cultibox/cultibox/README.md

**Cultibox**
============

La Cultibox est un boitier de contrôle du climat permettant de piloter des prises 
avec des programmes définits ou de réagir en fonction des informations remontées
par les capteurs connectés.
Toutes les informations nécéssaires disponibles sur le site officiel:

 [http://www.cultibox.fr](http://www.cultibox.fr)

Pour plus d'informations sur le logiciel open source permettant de piloter le boitier, 
rendez-vous:

 * sur la [documentation utilisateur](https://github.com/cultibox/cultibox/wiki) 
 * sur la [liste des tickets (Amélioration, bug ...)](https://github.com/cultibox/cultibox/issues)
 * sur le [dépôt du code source](https://github.com/cultibox/cultibox/)

Quoi de neuf?
 * Liste des [évolutions pour le logiciel](https://github.com/cultibox/cultibox/blob/master/01_software/CHANGELOG)
 * Lise des [évolutions pour le firmware](https://github.com/cultibox/cultibox/blob/master/01_software/01_install/01_src/03_sd/version.txt)

Et concrètement?
 * Pour récupérer le dépôt principal avec git:

`git clone --recursive https://github.com/cultibox/cultibox.git`
 * Pour récupérer le wiki avec git: 

`git clone --recursive https://github.com/cultibox/cultibox.wiki.git`
