cultibox/cultibox/02_documentation/05_verif/CBX_1_13_0012_PTS_electronic_regulation_temperature_humidity_A.pdf

Cultibox | CRE | CBX 1_13_0012 | A | 1 / 19
Type | Réf. document | Indice | Page

DOCUMENT GREEN BOX : Copyright © 20012-2013 GREEN BOX. Tous droits réservés. Ce document et l’information qu’il contient sont la propriété exclusive de GREEN BOX. Ils ne peuvent être reproduits ou divulgués sous quelque forme que ce soit sans l’accord préalable écrit de GREEN BOX.
GREEN BOX PROPRIETARY INFORMATION: Copyright © 2012-2013 by GREEN BOX. All rights reserved. This document and the information contained therein are GREEN BOX’s exclusive property. Any copy and/or disclosure thereof in any form whatsoever are subject to GREEN BOX’s prior written consent.

# PTS_ELECTRONIC_REGULATION_TEMPERATURE PTS_ELECTRONIC_REGULATION_HUMIDITY

### Conclusion:

### Cliquer ici

Mot clé | Conclusion | Remarques
PTS_electronic_regulation_temperature | PASS | NA
PTS_electronic_regulation_humidity | PASS | NA
VERSION | DATE | AUTEUR | DESCRIPTION DES MODIFICATIONS
- | 18/04/13 | P Puvilland | Création
A | 02/09/13 | P Puvilland | Ajout essai complémentaire: Fonction moyenne/min/max sur plusieurs capteurs

Cultibox | CRE | CBX 1_13_0012 | A | 2 / 19
Type | Réf. document | Indice | Page

DOCUMENT GREEN BOX : Copyright © 20012-2013 GREEN BOX. Tous droits réservés. Ce document et l’information qu’il contient sont la propriété exclusive de GREEN BOX. Ils ne peuvent être reproduits ou divulgués sous quelque forme que ce

# 1 SOMMAIRE

1 | SOMMAIRE | 2
2 | INTRODUCTION | 3
2.1 | OBJECTIF | 3
2.2 | SPECIFICATION DU MOT CLE | 3
2.3 | ISSUES ASSOCIEES | 3
2.4 | VERSION DE LA PTS | 4
2.5 | CULTIBOX | 4
2.6 | VERSION DES LOGICIELS | 5
2.7 | INFORMATION CONCERNANT L’ESSAI | 6
3 | DESCRIPTION DE L’ESSAI | 7
3.1 | INTRODUCTION | 7
3.2 | DESCRIPTION GENERALE DE L’ESSAI | 7
4 | ESSAI | 8
4.1 | MESURE INITIALE | 8
4.2 | MISE EN PLACE | 8
4.3 | MECANISMES DE REGULATION TESTES | 9
5 | ESSAIS COMPLÉMENTAIRES | 16
5.1 | MECANISMES DE REGULATION TESTES | 16
5.2 | RÉSULTATS DES ESSAIS COMPLÉMENTAIRES: | 16
6 | CONCLUSION | 17
7 | ANNEXES | 19

Cultibox | CRE | CBX 1_13_0012 | A | 3 / 19
Type | Réf. document | Indice | Page

DOCUMENT GREEN BOX : Copyright © 20012-2013 GREEN BOX. Tous droits réservés. Ce document et l’information qu’il contient sont la propriété exclusive de GREEN BOX. Ils ne peuvent être reproduits ou divulgués sous quelque forme que ce

# 2 INTRODUCTION

# 2.1 Objectif

## L’objectif de ce rapport est de statuer sur les mots clés :

## - PTS_electronic_regulation_temperature Ce mot clé indique la capacité de régulation de la Cultibox, en fonction des relevés

d'un capteur de température.

## - PTS_electronic_regulation_humidity Ce mot clé indique la capacité de régulation de la Cultibox, en fonction des relevés

d'un capteur d'humidité.

# 2.2 Spécification du mot clé

La spécification de la fonction de régulation est plutôt qualitative que quantitative.

## Pour s'assurer que ces deux mots clés sont conformes, nous vérifierons qu'ils respectent le fonctionnement décrit dans le document suivant: http://code.google.com/p/cultibox/wiki/gui_soft_prog_regul

# 2.3 Issues associées

## L’issue associée à ces mots clés sont :

Nom de l’issue | numéro | Type
PTS_electronic_regulation_temperature | 380 | PTS
PTS_electronic_regulation_humidity | 381 | PTS
[CULTI] [PROGRAMME] Bug régulation | 392 | Bug
[REGUL] Regul secondaire --> Impact sur la régul primaire | 479 (https://code.google.com/p/cultibox/issues/detail?id=479) | Bug

Cultibox | CRE | CBX 1_13_0012 | A | 4 / 19
Type | Réf. document | Indice | Page

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

[regulation] regulation moyenne/max/min: capteur non branché | 677 (https://code.google.com/p/cultibox/issues/detail?id=479) | Bug
[REGULATON] vérif fonctionnement: régulation secondaire et la moyenne/min/max | 683 (https://code.google.com/p/cultibox/issues/detail?id=479) | amélio

## L’ensemble des issues peut être lu à l’adresse suivante : http://code.google.com/p/cultibox/issues

# 2.4 Version de la PTS

Pour la validation des mots clés PTS_electronic_regulation_temperature,

## PTS_electronic_regulation_humidity

PTS Révision | Date | Version document
Révision 809 | 18/04/2013 | -
Révision 1419 | 03/09/2013 | A

# 2.5 Cultibox

Le tableau ci-dessous donne le numéro de la Cultibox utilisé pour ce test.

Matériel | Numéro d’identification | Version document
Cultibox | ID : 00001 | -
Cultibox | ID : Beta00000 | A

Cultibox | CRE | CBX 1_13_0012 | A | 5 / 19
Type | Réf. document | Indice | Page

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

# 2.6 Version des logiciels

### Version -

Type | Version logiciel | Version document
firmware | 1.25 | -
Logiciel | 1.1.10 | -
firmware | 1.31 et 2.0 | A
Logiciel | 1.1.30 | A

Cultibox | CRE | CBX 1_13_0012 | A | 6 / 19
Type | Réf. document | Indice | Page

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

# 2.7 Information concernant l’essai

Le tableau ci-dessous récapitule différentes informations concernant l’essai.

Information | Valeur
Client | Société Green Box SAS 8 Rue Thiers 38000 GRENOBLE
Laboratoire d’essai | Société Green Box SAS 8 Rue Thiers 38000 GRENOBLE
Identification du rapport d’essai | CBX 1_13_0012
Dates des essais | 07/04/2013(version -) 01/09/2013(version A)
Type d’essai | Vérification de la capacité de pilotage par régulation des prises par la Cultibox
Objet de l’essai | Essai de validation de spécification
Norme d’essai, édition | N.A
Description du spécimen d’essai | Cultibox ID : 00001 (version -) Cultibox ID : Beta00000 (version A)
Gestionnaire de l’essai | Philippe Puvilland

Cultibox | CRE | CBX 1_13_0012 | A | 7 / 19
Type | Réf. document | Indice | Page

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

# 3 DESCRIPTION DE L’ESSAI

# 3.1 Introduction

## Ce test consiste à vérifier que le fonctionnement est conforme a celui décrit

dans la documentation de la cultibox.

# 3.2 Description générale de l’essai

## Nous allons programmer sur 7 prises différents type de régulation primaire et secondaire. Puis nous allons réaliser des modifications d'environnements du capteur

de la Cultibox afin de constater que la fonction de régulation est totalement effective.

## Ces essais vont donc couvrir un maximum de situation possible, afin de tester la conformité des mécanismes décrit dans la documentation. Nous vérifierons donc:

## - le fonctionnement de la régulation primaire - le fonctionnement de la régulation secondaire - le fonctionnement de la régulation en fonction des informations d'un capteur d'humidité - le fonctionnement de la régulation en fonction des informations d'un capteur de température

Cultibox | CRE | CBX 1_13_0012 | A | 8 / 19
Type | Réf. document | Indice | Page

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

# 4 ESSAI

# 4.1 Mesure initiale

## La Cultibox est totalement fonctionnelle. Le pilotage des 7 prises et la sonde

de température et d'humidité fonctionnent correctement.

# 4.2 Mise en place

## La Cultibox est branchée, les 7 prises a piloter sont branchées et paramétrés comme l'indique le tableau si dessous:

Prise n° | type | status | Primaire | Tolérance | secondaire
4 | ventilateur | Activé | sup 30°C | 1 | sup 50%
5 | ventilateur | Activé | Marche | 0 | inf 50%
6 | chauffage | Activé | inf 28°C | 5 | sup 60%
7 | humidificateur | Désactivé | inf 23°C | 0 | sup 35%
8 | humidificateur | Activé | inf 60% | 2 | sup 26°C
9 | humidificateur | Activé | Marche | 1 | inf 26°C
10 | dés- humidificateur | Activé | sup 40% | 0 | sup 35°C

Cultibox | CRE | CBX 1_13_0012 | A | 9 / 19
Type | Réf. document | Indice | Page

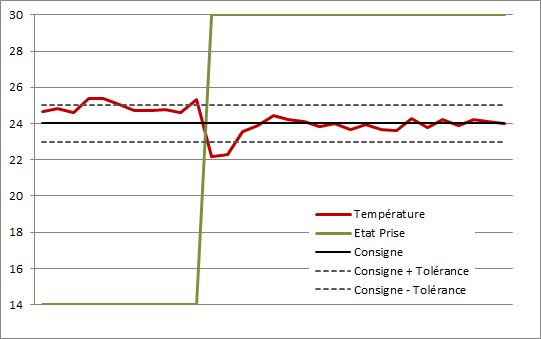
[picture p11: figure]
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

# 4.3 Mécanismes de régulation testés

## 4.3.1 Régulation primaire sur chauffage ou humidificateur

Dans le cas ou la prise agit de façon positive sur la valeur du capteur (Chauffage,

## Humidificateur). Les règles de changement d'état des prises sont les suivantes:

## - Si la valeur du capteur est inférieur à la consigne moins la tolérance : Prise activée

## - Si la valeur du capteur est supérieur à la consigne plus la tolérance : Prise désactivée

- Pour les autres cas, la prise reste dans le même état.

## Le graphique ci-dessous montre le fonctionnement pour une consigne de 24°C et une tolérance de 1°C:

## On peut voir que la prise ne se met en route que lorsque la température descend en dessous de 23°C (Consigne - tolérance = 24 - 1). La prise ne s'éteint pas lorsque la température est supérieur à la consigne. Il faut que la température dépasse la

Cultibox | CRE | CBX 1_13_0012 | A | 10 / 19
Type | Réf. document | Indice | Page

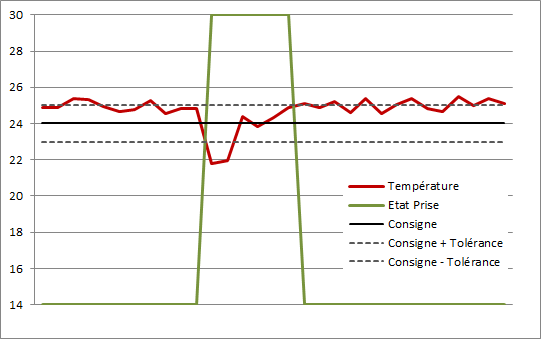
[picture p12: figure]
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

## consigne + la tolérance pour que la prise s'éteigne:

## 4.3.2 Régulation primaire sur ventilateur ou déshumidificateur

Dans le cas ou la prise agit de façon négative sur la valeur du capteur (Ventilateur,

## Déshumidificateur). Les règles de changement d'état des prises sont les suivantes:

## - Si la valeur du capteur est supérieur à la consigne plus la tolérance : Prise activée

## - Si la valeur du capteur est inférieur à la consigne moins la tolérance : Prise désactivée

Cultibox | CRE | CBX 1_13_0012 | A | 11 / 19
Type | Réf. document | Indice | Page

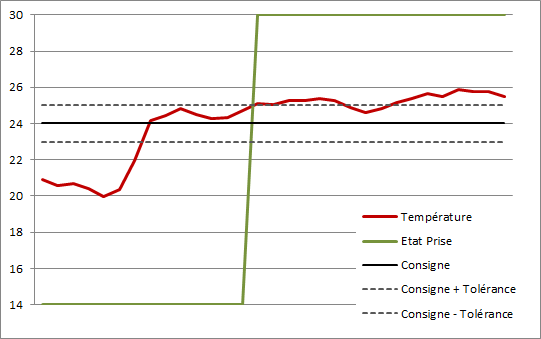
[picture p13: figure]
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

Pour les autres cas, la prise reste dans le même état.

## Le graphique ci-dessous montre le fonctionnement pour une consigne de 24°C et une tolérance de 1°C:

Cultibox | CRE | CBX 1_13_0012 | A | 12 / 19
Type | Réf. document | Indice | Page

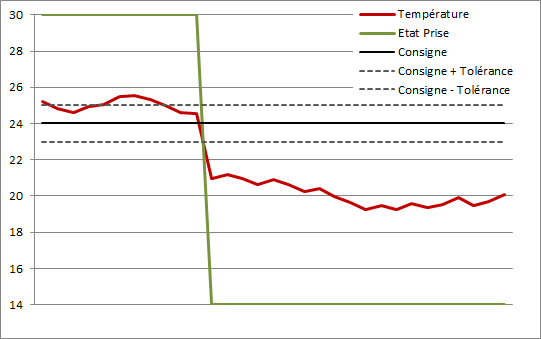
[picture p14: figure]
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

On peut voir que la prise ne se met en route que lorsque la température est supérieur à 25°C (Consigne + tolérance = 24 + 1). La prise ne s'éteint pas lorsque la température est inférieur à la consigne. Il faut que la température soit inférieur à la consigne - la tolérance pour que la prise s'éteigne:

## 4.3.3 Désactivation de l'hystérésis

## Pour désactiver le fonctionnement en hystérésis, il vous suffit d'indiquer une valeur

de tolérance de 0 pour la prise.

Cultibox | CRE | CBX 1_13_0012 | A | 13 / 19
Type | Réf. document | Indice | Page

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

4.3.4 Régulation secondaire sur ventilateur, déshumidificateur,

## chauffage ou humidificateur

## Attention, la régulation secondaire est compliquée. Assurez vous d'en avoir

vraiment besoin avant de l'activer.

la régulation secondaire permet de forcer l'état d'une prise en fonction de certaines données climatique. Elle agit comme une sorte d'alarme. Par exemple, vous utilisez un ventilateur pour réguler la température à 22°C. Il ne se met en marche que lorsque la température dépasse la consigne. Jusque là, c'est la régulation "classique" qui fonctionne. Vous désirez qu'en plus de ce fonctionnement normal, il soit actif si le taux d'humidité est supérieur à 80%. C'est la régulation secondaire qui va tenir ce

rôle.

Il n'est pas possible d'activer la régulation secondaire sur une prise déclarée comme "lampe" ou comme "autre" . Une prise "autre", est une prise qui ne modifie ni la température ni l'humidité de l'espace de culture. Il n'est donc pas possible d'effectuer de la régulation (principale ou secondaire) sur cette prise. De la même façon, il est

impossible d'activer la régulation secondaire sur une prise déclarée comme "lampe".

## La régulation secondaire est prioritaire dans la Cultibox. Dans le cas ou ses conditions d'activations sont remplies, elle prend le pas sur la régulation classique

Cultibox | CRE | CBX 1_13_0012 | A | 14 / 19
Type | Réf. document | Indice | Page

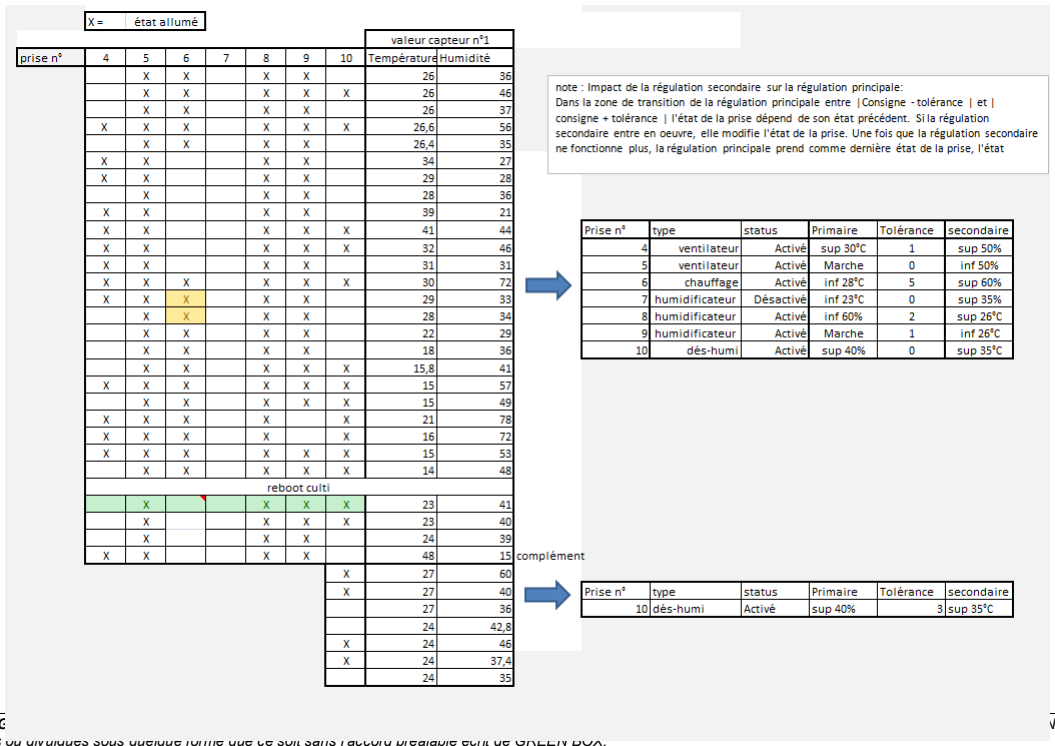
[picture p15: figure]

DOCUMENT GREEN BOX : Copyright © 20012-2013 GREEN BOX. Tous droits réservés. Ce document et l’information qu’il contient sont la propriété exclusive de GREEN BOX. Ils ne peuvent être reproduits ou divulgués sous quelque forme que ce soit sans l’accord préalable écrit de GREEN BOX.
GREEN BOX PROPRIETARY INFORMATION: Copyright © 2012-2013 by GREEN BOX. All rights reserved. This document and the information contained therein are GREEN BOX’s exclusive property. Any copy and/or disclosure thereof in any form whatsoever are subject to GREEN BOX’s prior written consent.

## 4.3.5 Résultat

Cultibox | CRE | CBX 1_13_0012 | A | 15 / 19
Type | Réf. document | Indice | Page

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

## 4.3.6 Analyse des résultats

## Lors des essais nous avons constaté une situation particulière sur la prise n°6 car la mise en route du chauffage devrait augmenter la température. Cependant nous avons constaté un impact mineur de la régulation secondaire sur la régulation principale:

Dans la zone de transition de la régulation principale entre |Consigne - tolérance | et | consigne + tolérance | l'état de la prise dépend de son état précédent. Si la régulation secondaire entre en œuvre, elle modifie l'état de la prise. Une fois que la régulation secondaire ne fonctionne plus, la régulation principale prend comme dernière état de

la prise, l'état appliqué par la régulation secondaire. issue 479 (https://code.google.com/p/cultibox/issues/detail?id=479)

Apres un "reboot" de la Cultibox le comportement des prises est conforme a celui qui était programmé. La prise n°6 est dans l'état "OFF" car le mécanisme de régulation calcul la régulation a appliquer en partant des données actuelles qui sont de 23°C avec une régulation de chauffage qui se déclenche pour une température inférieur à 28°C - 5°C (tolérance) =23°C Si la température avait atteint 22.9°C alors la prise passe en état "ON"

Cultibox | CRE | CBX 1_13_0012 | A | 16 / 19
Type | Réf. document | Indice | Page

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

# 5 ESSAIS COMPLÉMENTAIRES

Suite à l'ajout de fonctionnalité, un test supplémentaire a été effectué.

## Cette nouvelle fonctionnalité permet de gérer l'état d'une prise en fonction de la

valeur moyenne, maximum ou minimum remonté par plusieurs capteurs.

# 5.1 Mécanismes de régulation testés

L'essai n'est effectué que sur le pilotage d'une seul prise.

Les paramètres testés sont: 1. régulation d'une "type" ventilateur sur la moyenne de 2,3 et 4 capteurs 2. régulation d'une "type" ventilateur sur la moyenne de 4 capteurs avec le capteur 4 non branché 3. régulation d'une "type" humidificateur sur la moyenne de 2 capteurs 4. régulation d'une "type" ventilateur sur la maximum de 2 capteurs 5. régulation d'une "type" humidificateur sur la moyenne de 2 capteurs avec régulation secondaire enclenché 6. régulation d'une "type" chauffage sur le minimum de 2 capteurs avec régulation secondaire enclenchée

## Certain essai particulier on été réalisé : 7. régulation d'une "type" chauffage sur la moyenne de 4 capteurs:

Les capteurs n°1 et 2 seulement étaient branchés.

## Le capteur n°4 a été branché en cours de fonctionnement. et l'emplacement

n°3 est resté vide. Puis le capteur n°4 a été retiré en cours de fonctionnement.

# 5.2 Résultats des essais complémentaires:

## Firmware utilisé 1.31 1. PASS: Fonctionnement conforme 2. PASS : Voir issue 677:

"Si on active les 4 capteurs dans la sélection pour la régulation mais que le capteur n°4 n'est pas branché:
le capteur 4 est tout de même pris en compte dans les calculs de min et de moyenne comme étant une valeur a 0°C ou 0%"

Cultibox | CRE | CBX 1_13_0012 | A | 17 / 19
Type | Réf. document | Indice | Page

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

Status: Fixed!

## Suite à cet essai le firmware utilisé été le 2.0

## 3. PASS: Fonctionnement conforme

## 4. PASS: Fonctionnement conforme

## 5. Résultats intermédiaire: La cultibox utilise le type de régulation moyenne/min/max pour la régulation

secondaire.

## Le cas de figure n'ayant pas été évoqué, une Issue a été ouverte afin de traiter le fonctionnement de la régulation secondaire lors d'une régulation primaire de type

moyenne/min/max.

## Voir issue 683 Comportement attendu suite à l'issue: La régulation secondaire d'une prise sera basé obligatoirement sur la moyenne des capteurs utilisés par la régulation primaire, et cela quelque soit le type

(moyenne, maximum ou minimum) paramétré pour la régulation primaire.

## Ce fonctionnement sera a testé ultérieurement lors de son intégration dans une

futur config.

## 6. Résultats intermédiaire:

identique au point 5.

## 7. PASS: La cultibox, après quelques secondes, intègre la valeur du capteur n°4 ( lors du branchement/débranchement du capteur) à la moyenne/min/max qui sert à réguler la prise!

# 6 CONCLUSION

## Ces analyses montrent que la Cultibox respecte les mécanismes de régulation décrit dans la documentation :

https://code.google.com/p/cultibox/wiki/gui_soft_prog_regul#Sommaire.

## Ces analyses montrent que la Cultibox est capable de gérer: - la régulation primaire - la régulation secondaire

Cultibox | CRE | CBX 1_13_0012 | A | 18 / 19
Type | Réf. document | Indice | Page

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

## - la régulation en fonction des informations d'un capteur d'humidité - la régulation en fonction des informations d'un capteur de température

## Mais aussi - la régulation primaire et secondaire en fonction de la moyenne, du maximum

ou du minimum remonté par plusieurs capteurs de température et d'humidité.

Mot clé | Conclusion | Remarques
PTS_electronic_regulation_temperature | PASS | NA
PTS_electronic_regulation_humidity | PASS | NA

Cultibox | CRE | CBX 1_13_0012 | A | 19 / 19
Type | Réf. document | Indice | Page

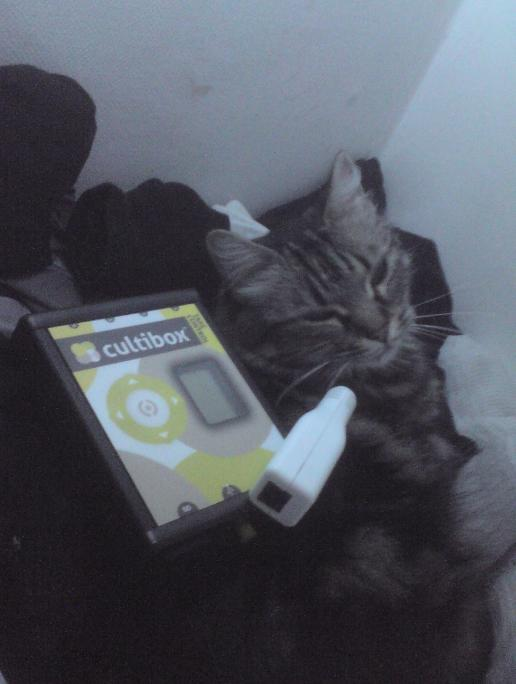
[picture p16: figure]
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

# 7 ANNEXES

## Et pendant ce temps la, y'en a certaine qui font semblant de m'aider à bosser sur la

Culti...

## Mais dans un placard à chaussette, cela ne fait pas crédible!!
