cultibox/cultibox/02_documentation/05_verif/CBX_1_13_00013_PTS_Electronic_nb_state_change_nb_plug1000W_3500W_plug_one_reponse_time_A.pdf

Cultibox | CRE | CBX 1_13_0013 | - | 1 / 39
Type | Réf. document | Indice | Page

DOCUMENT GREEN BOX : Copyright © 20012-2013 GREEN BOX. Tous droits réservés. Ce document et l’information qu’il contient sont la propriété exclusive de GREEN BOX. Ils ne peuvent être reproduits ou divulgués sous quelque forme que ce soit sans l’accord préalable écrit de GREEN BOX.
GREEN BOX PROPRIETARY INFORMATION: Copyright © 2012-2013 by GREEN BOX. All rights reserved. This document and the information contained therein are GREEN BOX’s exclusive property. Any copy and/or disclosure thereof in any form whatsoever are subject to GREEN BOX’s prior written consent.

# PTS_ELECTRONIC_NB_STATE_PLUG_CHANGE_DAY

# PTS_ELECTRONIC_NB_PLUG_1000W_PLUG

# PTS_ELECTRONIC_PLUG_ONE_REPONSE_TIME_S

Conclusion:

Cliquer ici

Mot clé | Conclusion | Remarques
PTS_electronic_nb_state_plug_change_day | PASS | NA
PTS_electronic_nb_plug_1000W_plug | PASS | NA
PTS_electronic_nb_plug_3500W_plug | PASS | NA
PTS_electronic_plug_one_reponse_time_s | PASS | NA
VERSION | DATE | AUTEUR | DESCRIPTION DES MODIFICATIONS
- | 31/03/13 | P Puvilland | Création

Cultibox | CRE | CBX 1_13_0013 | - | 2 / 39
Type | Réf. document | Indice | Page

DOCUMENT GREEN BOX : Copyright © 20012-2013 GREEN BOX. Tous droits réservés. Ce document et l’information qu’il contient sont la propriété exclusive de GREEN BOX. Ils ne peuvent être reproduits ou divulgués sous quelque forme que ce

## 1 SOMMAIRE

1 | SOMMAIRE | 2
2 | INTRODUCTION | 3
2.1 | OBJECTIF | 3
2.2 | SPECIFICATION DU MOT CLE | 3
2.3 | ISSUES ASSOCIEES | 4
2.4 | VERSION DE LA PTS | 4
2.5 | CULTIBOX | 5
2.6 | VERSION DES LOGICIELS | 5
2.7 | INFORMATION CONCERNANT L’ESSAI | 6
3 | DESCRIPTION DE L’ESSAI | 7
3.1 | INTRODUCTION | 7
3.2 | MATERIELS | 7
3.3 | DESCRIPTION GENERALE DE L’ESSAI | 8
4 | ESSAI | 9
4.1 | MESURE INITIALE | 9
4.2 | MISE EN PLACE | 9
4.3 | PROGRAMMES TESTES | 9
5 | ESSAI COMPLÉMENTAIRE 3500W | 14
5.1 | OBJECTIF | 14
5.2 | SPECIFICATION DU MOT CLE | 14
5.3 | ISSUES ASSOCIEES | 14
5.4 | VERSION DE LA PTS | 15
5.5 | CULTIBOX | 15
5.6 | VERSION DES LOGICIELS | 15
5.7 | INFORMATION CONCERNANT L’ESSAI | 16
5.8 | DESCRIPTION DE L’ESSAI COMPLEMENTAIRE 3500W | 17
5.9 | CONCLUSION DE L'ESSAI COMPLEMENTAIRE 3500W | 19
6 | CONCLUSION | 20
7 | ANNEXES | 21

Cultibox | CRE | CBX 1_13_0013 | - | 3 / 39
Type | Réf. document | Indice | Page

DOCUMENT GREEN BOX : Copyright © 20012-2013 GREEN BOX. Tous droits réservés. Ce document et l’information qu’il contient sont la propriété exclusive de GREEN BOX. Ils ne peuvent être reproduits ou divulgués sous quelque forme que ce

## 2 INTRODUCTION

## 2.1 Objectif

## L’objectif de ce rapport est de statuer sur le mot clé : - PTS_electronic_nb_state_plug_change_day: Ce mot clé indique la capacité de changement d'état pour l'ensemble des prises

chaque jour.

## - PTS_electronic_nb_plug_1000W_plug: Ce mot clé indique la capacité de nombre de prises 1000W différentes pilotable par

la Cultibox.

## - PTS_electronic_plug_one_reponse_time_s: Ce mot clé indique la capacité au niveau du temps de réponse du pilotage d'une

prise par la Cultibox.

## 2.2 Spécification du mot clé

## Les spécifications du mot clé sont :

Mot clé | Minimum | Typique | Maximum | Unité
PTS_electronic_nb_state_plug_change_day | | | 250 | Change/10 prises/ jour
PTS_electronic_nb_plug_1000W_plug | 1 | 2 | 9 | prises
PTS_electronic_plug_one_reponse_time_s | | | 5 | Secondes

Cultibox | CRE | CBX 1_13_0013 | - | 4 / 39
Type | Réf. document | Indice | Page

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

## 2.3 Issues associées

## L’issue associée à ce mot clé est :

Nom de l’issue | numéro | Type
PTS_electronic_nb_state_plug_change_day | 340 | PTS
PTS_electronic_nb_plug_1000W_plug | 341 | PTS
PTS_electronic_plug_one_reponse_time_s | 339 | PTS
Prise qui ne change pas d'état | 232 | Bug
[CULTI] changement manuel d'état de la prise 7 | 403 | Bug

## L’ensemble des issues peut être lu à l’adresse suivante : http://code.google.com/p/cultibox/issues

## 2.4 Version de la PTS

Pour la validation des mots clés PTS_electronic_nb_state_plug_change_day,

## PTS_electronic_nb_plug_1000W_plug et PTS_electronic_plug_one_reponse_time_s ,on considère la révision suivante :

PTS Révision | Date
Révision 782 | 14/04/2013

Cultibox | CRE | CBX 1_13_0013 | - | 5 / 39
Type | Réf. document | Indice | Page

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

## 2.5 Cultibox

Le tableau ci-dessous donne le numéro de la Cultibox utilisé pour ce test.

Matériel | Numéro d’identification
Cultibox | ID : 00001

## 2.6 Version des logiciels

Dans cet essais, seul la version du firmware de la Cultibox est importante.

Type | Version
firmware | 1.1
Logiciel | NA

## Essai complémentaire du 28 mars:

Type | Version
firmware | 1.23
Logiciel | NA

Cultibox | CRE | CBX 1_13_0013 | - | 6 / 39
Type | Réf. document | Indice | Page

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

## 2.7 Information concernant l’essai

Le tableau ci-dessous récapitule différentes informations concernant l’essai.

Information | Valeur
Client | Société Green Box SAS 8 Rue Thiers 38000 GRENOBLE
Laboratoire d’essai | Société Green Box SAS 8 Rue Thiers 38000 GRENOBLE
Identification du rapport d’essai | CBX 1_13_0013
Dates des essais | 31/03/2013
Type d’essai | Vérification de la capacité de pilotage des prises par la Cultibox
Objet de l’essai | Essai de validation de spécification
Norme d’essai, édition | N.A
Description du spécimen d’essai | Cultibox ID : 00001
Gestionnaire de l’essai | Philippe Puvilland

Cultibox | CRE | CBX 1_13_0013 | - | 7 / 39
Type | Réf. document | Indice | Page

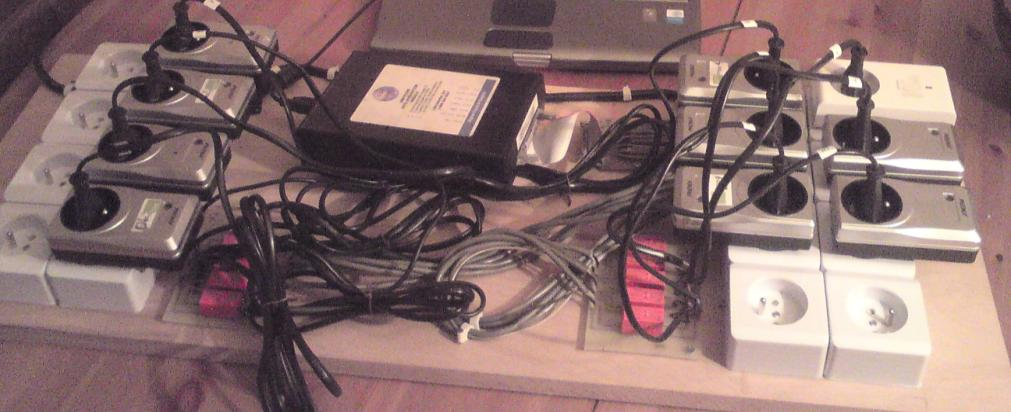
[picture p26: figure]
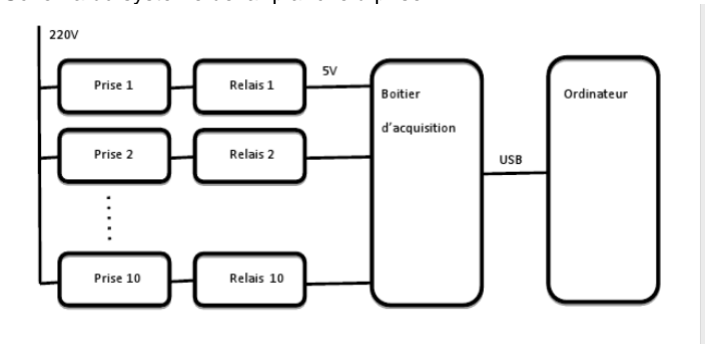
[picture p27: figure]
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

## 3 DESCRIPTION DE L’ESSAI

## 3.1 Introduction

## Ce test consiste à solliciter le maximum de changements d'état des prises

pilotable à distance.

## 3.2 Matériels

## 3.2.1 La "planche à prise": La "planche à prise" est un ensemble de 10 prises, dont le statut est en permanence

contrôlé par un boitier d’acquisition USB.

## Schéma du système de la "planche à prise":

Cultibox | CRE | CBX 1_13_0013 | - | 8 / 39
Type | Réf. document | Indice | Page

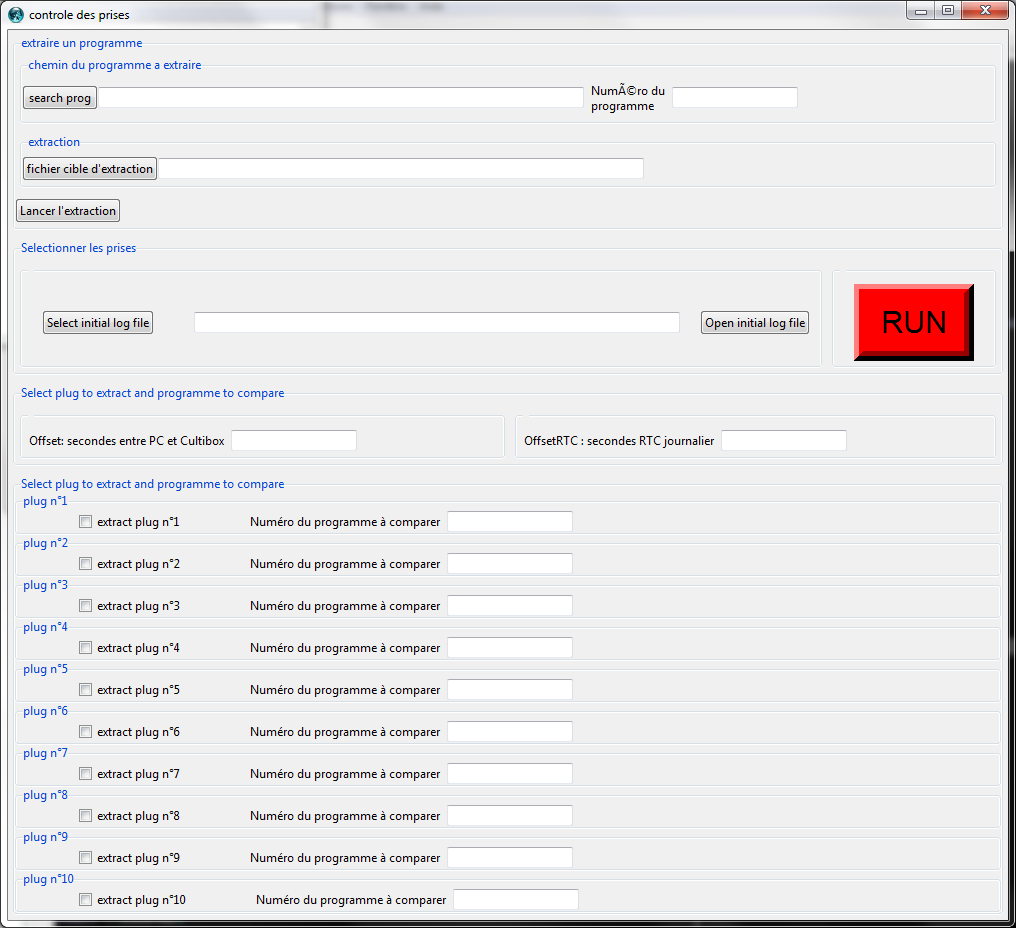
[picture p28: figure]
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

## 3.2.2 Ordinateur et programmes Un ordinateur a été utilisé afin de récupérer les informations du boitier d'acquisition USB via un programme en C. Il nous a aussi permis de traiter les logs via un simple programme en Tcl/Tk qui nous permet de d'interpréter les résultats:

## 3.3 Description générale de l’essai

## Nous allons comparer l'heure et l'état "allumé" ou "éteint" des chacune des 10 prises, aux programmes que nous avons enregistré sur la carte SD par le biais du logiciel de la Cultibox. La Cultibox commandera un total de 250 changements d'état

pour les 10 prises pendant un période de 24 heures.

## Les différents programmes sont fournis dans le chapitre suivant. ces programmes ont été prévu afin d'effectuer des changements d'état sur des cycles et

des périodes variées: changement effectué sur 6 sec, passage de 00h00, changement d'état de plusieurs prises en simultanée,...

Cultibox | CRE | CBX 1_13_0013 | - | 9 / 39
Type | Réf. document | Indice | Page

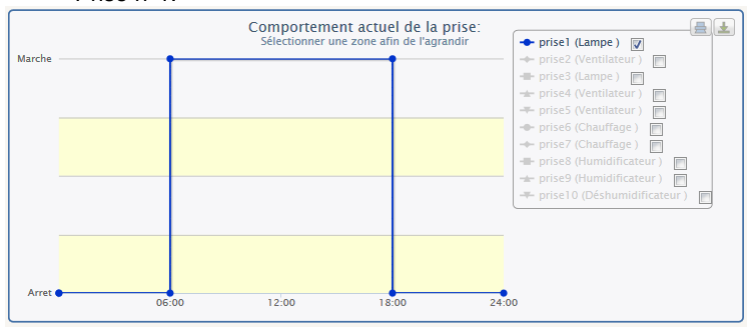
[picture p29: figure]
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

# 4 ESSAI

## 4.1 Mesure initiale

## La Cultibox est totalement fonctionnelle. Le temps de décalage entre l'horloge

de la Cultibox et le PC est relevé.

## 4.2 Mise en place

## La Cultibox est branchée, les 10 prises a piloter sont reliées sur la "planche à prises" et le programme d'enregistrement des relais est exécuté. L'essai à démarré le

02 février à 00h00 et terminera le 07 février à 23h59.

## Les prises piloltés sont composées de : - 1 prise 3500W - 9 prises 1000W

## 4.3 Programmes testés

## Les programmes testés sont les suivants:

## - Prise n°1:

Cultibox | CRE | CBX 1_13_0013 | - | 10 / 39

## - Prise n°2:

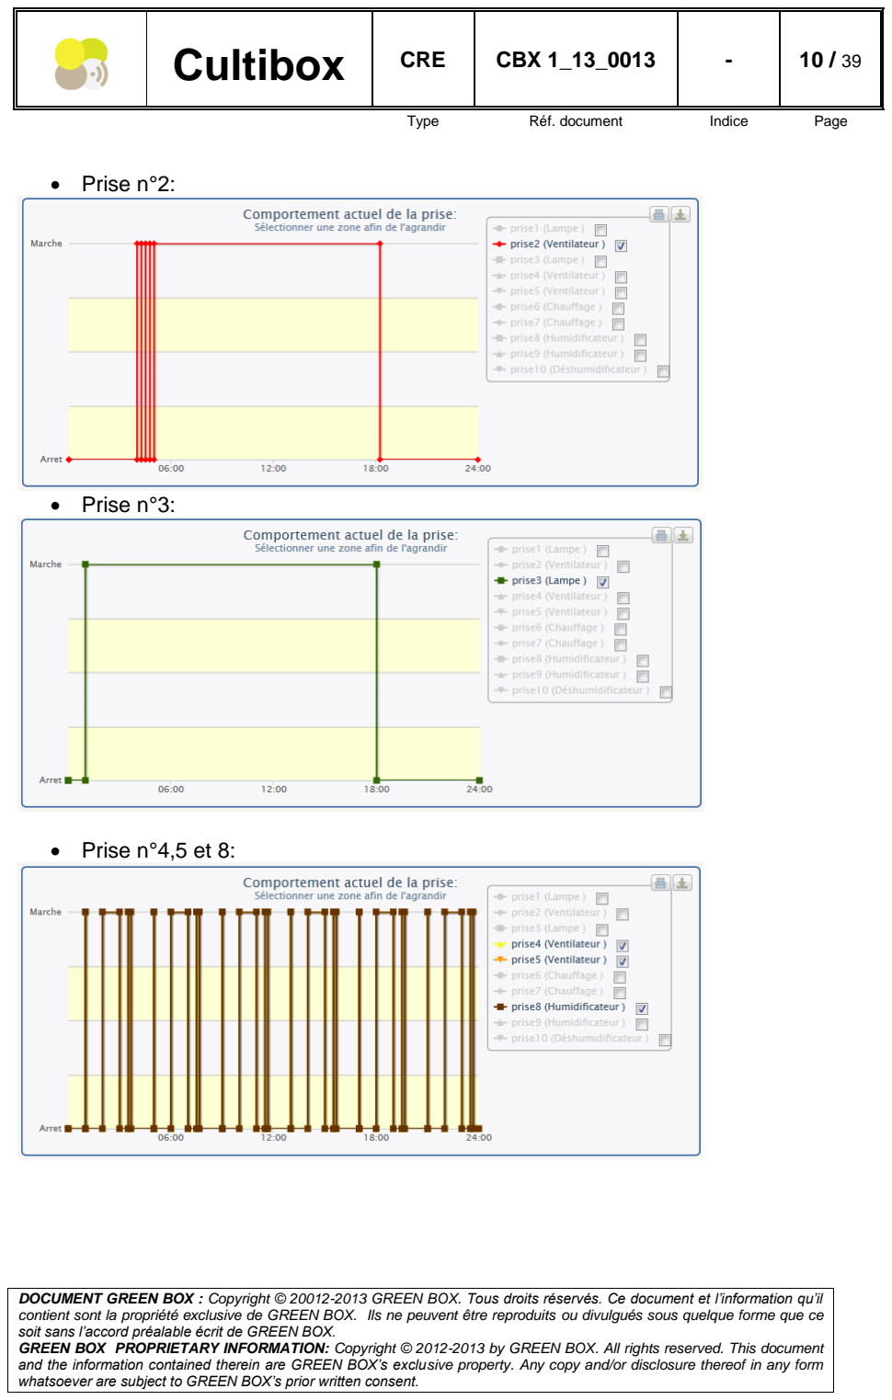
[picture p30: page 10]

Type | Réf. document | Indice | Page

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

## - Prise n°3:

## - Prise n°4,5 et 8:

Cultibox | CRE | CBX 1_13_0013 | - | 11 / 39
Type | Réf. document | Indice | Page

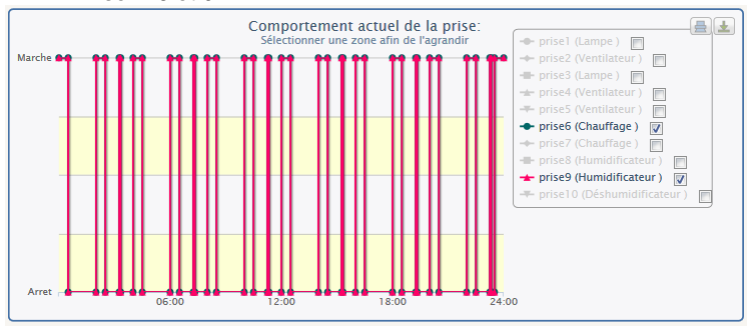
[picture p31: figure]
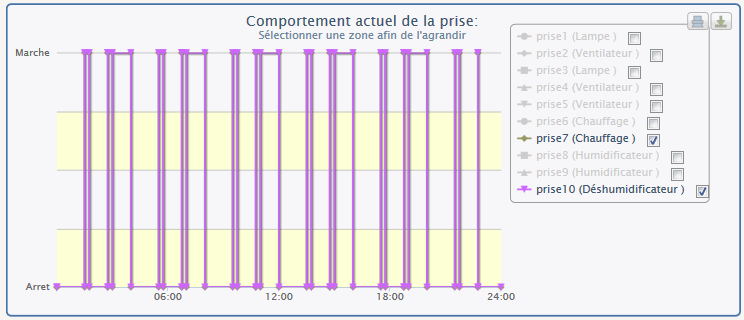
[picture p32: figure]
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

## - Prise n°6 et 9:

## - Prise n°7 et 10:

## La totalité des changements d'état des prises effectués représentent donc:

Numéro des prises | Nombre de changement d'état dans le programme de 24 heures | Total par type de programmes
n°1 | 2 | 2
n°2 | 6 | 6
n°3 | 2 | 2
n°4,5 et 8 | 36 | 108
n°6 et 9 | 36 | 72
n°7 et 10 | 34 | 68
| Total des changements= | 258

Cultibox | CRE | CBX 1_13_0013 | - | 12 / 39
Type | Réf. document | Indice | Page

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

## 4.3.1 Mise en forme et traitement des résultats Le traitement final est fourni sous forme d'une liste indiquant : - la date - l'heure enregistré par l'UsbDio pour un changement d'état - L'heure prévu par la Cultibox pour un changement d'état - L'écart en temps constaté

## Ainsi que le résultat de ce changement d'état : - Conformité de l'état de la prise: On/Off - Conformité du temps de réponse : +/- 5 sec

## Les paramètres appliqués pour le traitement final des logs sont: - Offset appliqué = 61 sec (décalage initial entre le PC et la Cultibox) - Offset RTC = 2 sec (décalage de la Cultibox par jour)

## Ce traitement final est fourni pour les 258 changements d'états des 10 prises pilotées

durant l'essai.

Cet essai c'est donc déroulé du 02 février à 00h00 au 07 février à 23h59.

## Le traitement final est fourni en annexe de ce document: lien

## 4.3.2 Analyse des résultats

## Nous pouvons constaté que sur 6 jours complet d'essai, toutes les prises on parfaitement été contrôlées par la Cultibox, en fonction des programmes qui avaient été établis .La Cultibox est donc capable de gérer 250 changements d'états sur

10 prises pilotables.

## Les temps de réponse enregistrés sont conformes aux spécifications de : +/- 5 secondes, à l'exception de la prise n°7 qui semble réagir différemment des autres prises: lien

Les temps de réponse sont régulièrement au delà des 5 secondes spécifié.

Suite a cette non conformité un ticket a été ouvert: issue 403.

## Des essais complémentaires ont donc été effectués:

un test de 24h sur cette prise n°7 suivant le même programme que l'essai précédent.

## Les resultats des cette essais complémentaire sont fourni en annexe de ce document: Lien

Cultibox | CRE | CBX 1_13_0013 | - | 13 / 39
Type | Réf. document | Indice | Page

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

## On peut constater que suite à la modification effectuée, le firmware 1.23 utilisé pour cet essai complémentaire a totalement corrigé le temps de réponse trop lent constaté lors du premier essai de février. La Cultibox est donc capable de piloter

les prises qu'elle contrôle en dessous 5 secondes de temps de réponse.

## 4.3.3 Conclusion des analyses Ces analyses montrent que, la capacité de la Cultibox à effectuer plus de 250 changements d'état, des prises pilotable à distance par jour, est pleinement

respectée.

## Ces analyses montrent que la capacité de la Cultibox à piloter les prises qu'elles

contrôle, avec un temps de réponse de moins de 5 sec, est pleinement respectée.

## Ces analyses montrent que la capacité de la Cultibox, à piloter au maximum 9 prises 1000W et une prise 3500W, est pleinement respectée

Cultibox | CRE | CBX 1_13_0013 | - | 14 / 39
Type | Réf. document | Indice | Page

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

## 5 ESSAI COMPLÉMENTAIRE 3500W

## 5.1 Objectif

## L’objectif de cette essai complémentaire est de statuer sur le mot clé :

## - PTS_electronic_nb_plug_3500W_plug: Ce mot clé indique la capacité de nombre de prises 3500W différentes pilotable par

la Cultibox.

## 5.2 Spécification du mot clé

## Les spécifications du mot clé sont :

Mot clé | Minimum | Typique | Maximum | Unité
PTS_electronic_nb_plug_3500W_plug | 1 | 1 | 8 | prises

## 5.3 Issues associées

## L’issue associée à ce mot clé est :

Nom de l’issue | numéro | Type
PTS_electronic_nb_plug_3500W_plug | 341 | PTS

## L’ensemble des issues peut être lu à l’adresse suivante : http://code.google.com/p/cultibox/issues

Cultibox | CRE | CBX 1_13_0013 | - | 15 / 39
Type | Réf. document | Indice | Page

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

## 5.4 Version de la PTS

Pour la validation des mots clés PTS_electronic_nb_state_plug_change_day,

## PTS_electronic_nb_plug_1000W_plug et PTS_electronic_plug_one_reponse_time_s ,on considère la révision suivante :

PTS Révision | Date
Révision 954 | 08/06/2013

## 5.5 Cultibox

Le tableau ci-dessous donne le numéro de la Cultibox utilisé pour ce test.

Matériel | Numéro d’identification
Cultibox | ID : 00002

## 5.6 Version des logiciels

Dans cet essai, seul la version du firmware de la Cultibox est importante.

Type | Version
firmware | 1.25
Logiciel | NA

Cultibox | CRE | CBX 1_13_0013 | - | 16 / 39
Type | Réf. document | Indice | Page

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

## 5.7 Information concernant l’essai

Le tableau ci-dessous récapitule différentes informations concernant l’essai.

Information | Valeur
Client | Société Green Box SAS 8 Rue Thiers 38000 GRENOBLE
Laboratoire d’essai | Société Green Box SAS 8 Rue Thiers 38000 GRENOBLE
Identification du rapport d’essai | CBX 1_13_0013
Dates des essais | 08/06/2013
Type d’essai | Vérification de la capacité de pilotage des prises 3500W par la Cultibox
Objet de l’essai | Essai de validation de spécification
Norme d’essai, édition | N.A
Description du spécimen d’essai | Cultibox ID : 00002
Gestionnaire de l’essai | Philippe Puvilland

Cultibox | CRE | CBX 1_13_0013 | - | 17 / 39
Type | Réf. document | Indice | Page

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

## 5.8 Description de l’essai complémentaire 3500W

## Nous n’avons malheureusement pas pu utiliser l’outil « planche a prise » pour cet

essai.

## Un essai supplémentaire pourra être effectué lorsque l’outil sera de nouveau

opérationnel.

## Nous avons donc décidé d’effectuer une vérification manuelle afin de s’assurer du

bon fonctionnement du pilotage de 8 prises 3500W.

## Lors de cet essai, les prises n°1,2 et 3 étaient configuré comme suit :

Numéro de prise | Type de prise | Etat de la prise
Prise n°1 | 3500W(fixe) | Allumée(On)
Prise n°2 | 1000W(fixe) | Allumée(On)
Prise n°3 | 1000W(fixe) | Allumée (On)

## Afin de couvrir un maximum de combinaison nous avons effectuer le changement d ‘état manuel des prises n°4 à 10 comme suit : Légende :

0/1/0 | Changement d’état éteinte /allumée/éteinte
X | Etat « allumée » permanent pendant le test (mobile par combinaison)
X Etat « allumée » | permanent pendant le test (fixe par combinaison)

## n.b : Lors d’un test, l’état X (état de la prise allumée de manière permanente pour ce test) va « glisser » sur chaque prise afin d’effectuer toutes les combinaisons possibles (voir tableau suivant)

Cultibox | CRE | CBX 1_13_0013 | - | 18 / 39
Type | Réf. document | Indice | Page

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

Prise n° | 4 | 5 | 6 | 7 | 8 | 9 | 10 | Nombre de combinaisons
Test 1 | 0/1/0 | 0/1/0 | 0/1/0 | 0/1/0 | 0/1/0 | 0/1/0 | 0/1/0 | 7x1=7
Test 2 | X | 0/1/0 | 0/1/0 | 0/1/0 | 0/1/0 | 0/1/0 | 0/1/0 | 7x6=42
Test 3 | X | X | 0/1/0 | 0/1/0 | 0/1/0 | 0/1/0 | 0/1/0 | 6x5=30
Test 4 | 0/1/0 | X | X | 0/1/0 | 0/1/0 | 0/1/0 | 0/1/0 | 5x5=25
Test 5 | 0/1/0 | 0/1/0 | X | X | 0/1/0 | 0/1/0 | 0/1/0 | 5x5=25
Test 6 | 0/1/0 | 0/1/0 | 0/1/0 | X | X | 0/1/0 | 0/1/0 | 5x5=25
Test 7 | 0/1/0 | 0/1/0 | 0/1/0 | 0/1/0 | X | X | 0/1/0 | 5x5=25
Test 8 | 0/1/0 | 0/1/0 | 0/1/0 | 0/1/0 | 0/1/0 | X | X | 5x5=25
Test 9 | X | X | X | 0/1/0 | 0/1/0 | 0/1/0 | 0/1/0 | 5x4=20
Test 10 | 0/1/0 | X | X | X | 0/1/0 | 0/1/0 | 0/1/0 | 4x4=16
Test 11 | 0/1/0 | 0/1/0 | X | X | X | 0/1/0 | 0/1/0 | 4x4=16
Test 12 | 0/1/0 | 0/1/0 | 0/1/0 | X | X | X | 0/1/0 | 4x4=16
Test 13 | 0/1/0 | 0/1/0 | 0/1/0 | 0/1/0 | X | X | X | 4x4=16
Test 14 | X | 0/1/0 | 0/1/0 | 0/1/0 | 0/1/0 | X | X | 4x4=16
Test 15 | X | X | X | X | 0/1/0 | 0/1/0 | 0/1/0 | 4x3=12
Test 16 | 0/1/0 | X | X | X | X | 0/1/0 | 0/1/0 | 3x3=9
Test 17 | 0/1/0 | 0/1/0 | X | X | X | X | 0/1/0 | 3x3=9
Test 18 | 0/1/0 | 0/1/0 | 0/1/0 | X | X | X | X | 3x3=9
Test 19 | X | 0/1/0 | 0/1/0 | 0/1/0 | X | X | X | 3x3=9
Test 20 | X | X | 0/1/0 | 0/1/0 | 0/1/0 | X | X | 3x3=9
Test 21 | X | X | X | X | X | 0/1/0 | 0/1/0 | 3x2=6
Test 22 | 0/1/0 | X | X | X | X | X | 0/1/0 | 2x2=4
Test 23 | 0/1/0 | 0/1/0 | X | X | X | X | X | 2x2=4
Test 24 | X | 0/1/0 | 0/1/0 | X | X | X | X | 2x2=4
Test 25 | X | X | 0/1/0 | 0/1/0 | X | X | X | 2x2=4
Test 26 | X | X | X | 0/1/0 | 0/1/0 | X | X | 2x2=4
Test 27 | X | X | X | X | X | X | 0/1/0 | 7x1=7

## Sur un total de 394 changements d'états des prises n°4 à 10, aucun

disfonctionnement n'a été observé.

## Remarques: Lors du déroulement du test, certains changements d'états prenaient un temps légèrement plus long avant d'être effectuées. Les temps de réponse étaient de l'ordre de 0.5 à 3sec. La spécification du mots clé PTS_electronic_plug_one_reponse_time_s étant de 5 Secondes, la Cultibox est bien

conforme à cette spécification.

Cultibox | CRE | CBX 1_13_0013 | - | 19 / 39
Type | Réf. document | Indice | Page

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

## 5.9 Conclusion de l'essai complémentaire 3500W

Les analyses, de cet essai complémentaire, montrent que la capacité de la Cultibox,

## à piloter au maximum 2 prises 1000W et 8 prise 3500W, est pleinement respectée

Cultibox | CRE | CBX 1_13_0013 | - | 20 / 39
Type | Réf. document | Indice | Page

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

## 6 CONCLUSION

## La Cultibox est donc capable de gérer 250 changements d'états sur 10 prises pilotables par jours La Cultibox est donc capable de gérer le pilotage d'une prise 3500W et neuf prises 1000W La Cultibox est donc capable de gérer le pilotage de 2 prises 1000W e 8 prises

3500W

## La Cultibox est donc capable de gérer le pilotage de ces 10 prises avec un

temps de réponse de moins de 5 secondes.

La Cultibox est conforme au spécification du cahier des charges.

Mot clé | Conclusion | Remarques
PTS_electronic_nb_state_plug_change_day | PASS | NA
PTS_electronic_nb_plug_1000W_plug | PASS | NA
PTS_electronic_nb_plug_3500W_plug | PASS | NA
PTS_electronic_plug_one_reponse_time_s | PASS | NA

Cultibox | CRE | CBX 1_13_0013 | - | 21 / 39
Type | Réf. document | Indice | Page

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

## 7 ANNEXES

Résultats des essais du 02 avril à 00h00 au 07 avril 23h59 :

Offset appliqué = 61 sec (décalage initial entre le PC et la Cultibox) Offset RTC = 2 sec (décalage de la Cultibox par jour)

Thu Mar 07 19:35:32 CET 2013 ::log14 ::listProg1
Date | Heure Cultibox Heure PC | Résultats
2013 02 04 05 58 59 | 060000 | écart: 0 Sec--> Etat ON/OFF Pass / -5sec Pass / +5sec Pass /
2013 02 04 17 59 00 | 180000 | écart: 1 Sec--> Etat ON/OFF Pass / -5sec Pass / +5sec Pass /
2013 02 05 05 59 01 | 060000 | écart: 0 Sec--> Etat ON/OFF Pass / -5sec Pass / +5sec Pass /
2013 02 05 17 59 02 | 180000 | écart: 1 Sec--> Etat ON/OFF Pass / -5sec Pass / +5sec Pass /
2013 02 06 05 59 03 | 060000 | écart: 0 Sec--> Etat ON/OFF Pass / -5sec Pass / +5sec Pass /
2013 02 06 17 59 05 | 180000 | écart: 2 Sec--> Etat ON/OFF Pass / -5sec Pass / +5sec Pass /
2013 02 07 05 59 05 | 060000 | écart: 0 Sec--> Etat ON/OFF Pass / -5sec Pass / +5sec Pass /
2013 02 07 17 59 06 | 180000 | écart: 1 Sec--> Etat ON/OFF Pass / -5sec Pass / +5sec Pass /

Thu Mar 07 19:35:32 CET 2013 ::log15 ::listProg2
Date | Heure Cultibox Heure PC | Résultats
2013 02 04 03 58 58 | 040000 | écart: -1 Sec--> Etat ON/OFF Pass / -5sec Pass / +5sec Pass /
2013 02 04 04 13 59 | 041500 | écart: 0 Sec--> Etat ON/OFF Pass / -5sec Pass / +5sec Pass /
2013 02 04 04 28 58 | 043000 | écart: -1 Sec--> Etat ON/OFF Pass / -5sec Pass / +5sec Pass /
2013 02 04 04 43 59 | 044500 | écart: 0 Sec--> Etat ON/OFF Pass / -5sec Pass / +5sec Pass /
2013 02 04 04 58 59 | 050000 | écart: 0 Sec--> Etat ON/OFF Pass / -5sec Pass / +5sec Pass /
2013 02 04 18 14 00 | 181500 | écart: 1 Sec--> Etat ON/OFF Pass / -5sec Pass / +5sec Pass /
2013 02 05 03 59 01 | 040000 | écart: 0 Sec--> Etat ON/OFF Pass / -5sec Pass / +5sec Pass /
2013 02 05 04 14 01 | 041500 | écart: 0 Sec--> Etat ON/OFF Pass / -5sec Pass / +5sec Pass /
2013 02 05 04 29 01 | 043000 | écart: 0 Sec--> Etat ON/OFF Pass / -5sec Pass / +5sec Pass /
2013 02 05 04 44 01 | 044500 | écart: 0 Sec--> Etat ON/OFF Pass / -5sec Pass / +5sec Pass /
2013 02 05 04 59 01 | 050000 | écart: 0 Sec--> Etat ON/OFF Pass / -5sec Pass / +5sec Pass /
2013 02 05 18 14 02 | 181500 | écart: 1 Sec--> Etat ON/OFF Pass / -5sec Pass / +5sec Pass /
2013 02 06 03 59 03 | 040000 | écart: 0 Sec--> Etat ON/OFF Pass / -5sec Pass / +5sec Pass /
2013 02 06 04 14 03 | 041500 | écart: 0 Sec--> Etat ON/OFF Pass / -5sec Pass / +5sec Pass /
2013 02 06 04 29 03 | 043000 | écart: 0 Sec--> Etat ON/OFF Pass / -5sec Pass / +5sec Pass /
2013 02 06 04 44 03 | 044500 | écart: 0 Sec--> Etat ON/OFF Pass / -5sec Pass / +5sec Pass /
2013 02 06 04 59 04 | 050000 | écart: 1 Sec--> Etat ON/OFF Pass / -5sec Pass / +5sec Pass /
2013 02 06 18 14 04 | 181500 | écart: 1 Sec--> Etat ON/OFF Pass / -5sec Pass / +5sec Pass /
2013 02 07 03 59 05 | 040000 | écart: 0 Sec--> Etat ON/OFF Pass / -5sec Pass / +5sec Pass /
2013 02 07 04 14 05 | 041500 | écart: 0 Sec--> Etat ON/OFF Pass / -5sec Pass / +5sec Pass /
2013 02 07 04 29 05 | 043000 | écart: 0 Sec--> Etat ON/OFF Pass / -5sec Pass / +5sec Pass /
2013 02 07 04 44 05 | 044500 | écart: 0 Sec--> Etat ON/OFF Pass / -5sec Pass / +5sec Pass /
2013 02 07 04 59 05 | 050000 | écart: 0 Sec--> Etat ON/OFF Pass / -5sec Pass / +5sec Pass /
2013 02 07 18 14 06 | 181500 | écart: 1 Sec--> Etat ON/OFF Pass / -5sec Pass / +5sec Pass /

Thu Mar 07 19:35:32 CET 2013 ::log16 ::listProg3
Date | Heure Cultibox Heure PC | Résultats
2013 02 04 00 58 58 | 010000 | écart: -1 Sec--> Etat ON/OFF Pass / -5sec Pass / +5sec Pass /
2013 02 04 17 59 00 | 180000 | écart: 1 Sec--> Etat ON/OFF Pass / -5sec Pass / +5sec Pass /
2013 02 05 00 59 01 | 010000 | écart: 0 Sec--> Etat ON/OFF Pass / -5sec Pass / +5sec Pass /
2013 02 05 17 59 03 | 180000 | écart: 2 Sec--> Etat ON/OFF Pass / -5sec Pass / +5sec Pass /
2013 02 06 00 59 03 | 010000 | écart: 0 Sec--> Etat ON/OFF Pass / -5sec Pass / +5sec Pass /
2013 02 06 17 59 05 | 180000 | écart: 2 Sec--> Etat ON/OFF Pass / -5sec Pass / +5sec Pass /
2013 02 07 00 59 05 | 010000 | écart: 0 Sec--> Etat ON/OFF Pass / -5sec Pass / +5sec Pass /
2013 02 07 17 59 07 | 180000 | écart: 2 Sec--> Etat ON/OFF Pass / -5sec Pass / +5sec Pass /

Cultibox | CRE | CBX 1_13_0013 | - | 22 / 39
Type | Réf. document | Indice | Page

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

Thu Mar 07 19:35:32 CET 2013 ::log20 ::listProg4
Date | Heure Cultibox Heure PC | Résultats
2013 02 04 00 58 58 | 010000 | écart: -1 Sec--> Etat ON/OFF Pass / -5sec Pass / +5sec Pass /
2013 02 04 00 59 58 | 010100 | écart: -1 Sec--> Etat ON/OFF Pass / -5sec Pass / +5sec Pass /
2013 02 04 01 58 58 | 020000 | écart: -1 Sec--> Etat ON/OFF Pass / -5sec Pass / +5sec Pass /
2013 02 04 02 58 58 | 030000 | écart: -1 Sec--> Etat ON/OFF Pass / -5sec Pass / +5sec Pass /
2013 02 04 03 28 58 | 033000 | écart: -1 Sec--> Etat ON/OFF Pass / -5sec Pass / +5sec Pass /
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
2013 02 05 14 59 03 | 150000 | écart: 2 Sec--> Etat ON/OFF Pass / -5sec Pass / +5sec Pass /
2013 02 05 15 29 02 | 153000 | écart: 1 Sec--> Etat ON/OFF Pass / -5sec Pass / +5sec Pass /
2013 02 05 15 39 03 | 154000 | écart: 2 Sec--> Etat ON/OFF Pass / -5sec Pass / +5sec Pass /
2013 02 05 16 59 03 | 170000 | écart: 2 Sec--> Etat ON/OFF Pass / -5sec Pass / +5sec Pass /
2013 02 05 17 00 03 | 170100 | écart: 2 Sec--> Etat ON/OFF Pass / -5sec Pass / +5sec Pass /
2013 02 05 17 59 03 | 180000 | écart: 2 Sec--> Etat ON/OFF Pass / -5sec Pass / +5sec Pass /
2013 02 05 18 59 03 | 190000 | écart: 2 Sec--> Etat ON/OFF Pass / -5sec Pass / +5sec Pass /
2013 02 05 19 29 03 | 193000 | écart: 2 Sec--> Etat ON/OFF Pass / -5sec Pass / +5sec Pass /
2013 02 05 19 39 03 | 194000 | écart: 2 Sec--> Etat ON/OFF Pass / -5sec Pass / +5sec Pass /
2013 02 05 20 59 03 | 210000 | écart: 2 Sec--> Etat ON/OFF Pass / -5sec Pass / +5sec Pass /
2013 02 05 21 00 03 | 210100 | écart: 2 Sec--> Etat ON/OFF Pass / -5sec Pass / +5sec Pass /
2013 02 05 21 59 03 | 220000 | écart: 2 Sec--> Etat ON/OFF Pass / -5sec Pass / +5sec Pass /
2013 02 05 22 59 03 | 230000 | écart: 2 Sec--> Etat ON/OFF Pass / -5sec Pass / +5sec Pass /
2013 02 05 23 29 03 | 233000 | écart: 2 Sec--> Etat ON/OFF Pass / -5sec Pass / +5sec Pass /
2013 02 05 23 39 03 | 234000 | écart: 2 Sec--> Etat ON/OFF Pass / -5sec Pass / +5sec Pass /
2013 02 06 00 59 04 | 010000 | écart: 1 Sec--> Etat ON/OFF Pass / -5sec Pass / +5sec Pass /
2013 02 06 01 00 03 | 010100 | écart: 0 Sec--> Etat ON/OFF Pass / -5sec Pass / +5sec Pass /
2013 02 06 01 59 03 | 020000 | écart: 0 Sec--> Etat ON/OFF Pass / -5sec Pass / +5sec Pass /
2013 02 06 02 59 04 | 030000 | écart: 1 Sec--> Etat ON/OFF Pass / -5sec Pass / +5sec Pass /
2013 02 06 03 29 04 | 033000 | écart: 1 Sec--> Etat ON/OFF Pass / -5sec Pass / +5sec Pass /
2013 02 06 03 39 04 | 034000 | écart: 1 Sec--> Etat ON/OFF Pass / -5sec Pass / +5sec Pass /
2013 02 06 04 59 04 | 050000 | écart: 1 Sec--> Etat ON/OFF Pass / -5sec Pass / +5sec Pass /
2013 02 06 05 00 04 | 050100 | écart: 1 Sec--> Etat ON/OFF Pass / -5sec Pass / +5sec Pass /
2013 02 06 05 59 04 | 060000 | écart: 1 Sec--> Etat ON/OFF Pass / -5sec Pass / +5sec Pass /
2013 02 06 06 59 04 | 070000 | écart: 1 Sec--> Etat ON/OFF Pass / -5sec Pass / +5sec Pass /
2013 02 06 07 29 04 | 073000 | écart: 1 Sec--> Etat ON/OFF Pass / -5sec Pass / +5sec Pass /
2013 02 06 07 39 04 | 074000 | écart: 1 Sec--> Etat ON/OFF Pass / -5sec Pass / +5sec Pass /
2013 02 06 08 59 04 | 090000 | écart: 1 Sec--> Etat ON/OFF Pass / -5sec Pass / +5sec Pass /
2013 02 06 09 00 04 | 090100 | écart: 1 Sec--> Etat ON/OFF Pass / -5sec Pass / +5sec Pass /
2013 02 06 09 59 04 | 100000 | écart: 1 Sec--> Etat ON/OFF Pass / -5sec Pass / +5sec Pass /

Cultibox | CRE | CBX 1_13_0013 | - | 26 / 39
Type | Réf. document | Indice | Page

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

2013 02 06 10 59 04 | 110000 | écart: 1 Sec--> Etat ON/OFF Pass / -5sec Pass / +5sec Pass /
2013 02 06 11 29 04 | 113000 | écart: 1 Sec--> Etat ON/OFF Pass / -5sec Pass / +5sec Pass /
2013 02 06 11 39 04 | 114000 | écart: 1 Sec--> Etat ON/OFF Pass / -5sec Pass / +5sec Pass /
2013 02 06 12 59 04 | 130000 | écart: 1 Sec--> Etat ON/OFF Pass / -5sec Pass / +5sec Pass /
2013 02 06 13 00 04 | 130100 | écart: 1 Sec--> Etat ON/OFF Pass / -5sec Pass / +5sec Pass /
2013 02 06 13 59 04 | 140000 | écart: 1 Sec--> Etat ON/OFF Pass / -5sec Pass / +5sec Pass /
2013 02 06 14 59 05 | 150000 | écart: 2 Sec--> Etat ON/OFF Pass / -5sec Pass / +5sec Pass /
2013 02 06 15 29 04 | 153000 | écart: 1 Sec--> Etat ON/OFF Pass / -5sec Pass / +5sec Pass /
2013 02 06 15 39 05 | 154000 | écart: 2 Sec--> Etat ON/OFF Pass / -5sec Pass / +5sec Pass /
2013 02 06 16 59 04 | 170000 | écart: 1 Sec--> Etat ON/OFF Pass / -5sec Pass / +5sec Pass /
2013 02 06 17 00 05 | 170100 | écart: 2 Sec--> Etat ON/OFF Pass / -5sec Pass / +5sec Pass /
2013 02 06 17 59 06 | 180000 | écart: 3 Sec--> Etat ON/OFF Pass / -5sec Pass / +5sec Pass /
2013 02 06 18 59 05 | 190000 | écart: 2 Sec--> Etat ON/OFF Pass / -5sec Pass / +5sec Pass /
2013 02 06 19 29 05 | 193000 | écart: 2 Sec--> Etat ON/OFF Pass / -5sec Pass / +5sec Pass /
2013 02 06 19 39 05 | 194000 | écart: 2 Sec--> Etat ON/OFF Pass / -5sec Pass / +5sec Pass /
2013 02 06 20 59 05 | 210000 | écart: 2 Sec--> Etat ON/OFF Pass / -5sec Pass / +5sec Pass /
2013 02 06 21 00 05 | 210100 | écart: 2 Sec--> Etat ON/OFF Pass / -5sec Pass / +5sec Pass /
2013 02 06 21 59 05 | 220000 | écart: 2 Sec--> Etat ON/OFF Pass / -5sec Pass / +5sec Pass /
2013 02 06 22 59 05 | 230000 | écart: 2 Sec--> Etat ON/OFF Pass / -5sec Pass / +5sec Pass /
2013 02 06 23 29 05 | 233000 | écart: 2 Sec--> Etat ON/OFF Pass / -5sec Pass / +5sec Pass /
2013 02 06 23 39 05 | 234000 | écart: 2 Sec--> Etat ON/OFF Pass / -5sec Pass / +5sec Pass /
2013 02 07 00 59 06 | 010000 | écart: 1 Sec--> Etat ON/OFF Pass / -5sec Pass / +5sec Pass /
2013 02 07 01 00 05 | 010100 | écart: 0 Sec--> Etat ON/OFF Pass / -5sec Pass / +5sec Pass /
2013 02 07 01 59 06 | 020000 | écart: 1 Sec--> Etat ON/OFF Pass / -5sec Pass / +5sec Pass /
2013 02 07 02 59 05 | 030000 | écart: 0 Sec--> Etat ON/OFF Pass / -5sec Pass / +5sec Pass /
2013 02 07 03 29 06 | 033000 | écart: 1 Sec--> Etat ON/OFF Pass / -5sec Pass / +5sec Pass /
2013 02 07 03 39 06 | 034000 | écart: 1 Sec--> Etat ON/OFF Pass / -5sec Pass / +5sec Pass /
2013 02 07 04 59 06 | 050000 | écart: 1 Sec--> Etat ON/OFF Pass / -5sec Pass / +5sec Pass /
2013 02 07 05 00 06 | 050100 | écart: 1 Sec--> Etat ON/OFF Pass / -5sec Pass / +5sec Pass /
2013 02 07 05 59 06 | 060000 | écart: 1 Sec--> Etat ON/OFF Pass / -5sec Pass / +5sec Pass /
2013 02 07 06 59 06 | 070000 | écart: 1 Sec--> Etat ON/OFF Pass / -5sec Pass / +5sec Pass /
2013 02 07 07 29 06 | 073000 | écart: 1 Sec--> Etat ON/OFF Pass / -5sec Pass / +5sec Pass /
2013 02 07 07 39 06 | 074000 | écart: 1 Sec--> Etat ON/OFF Pass / -5sec Pass / +5sec Pass /
2013 02 07 08 59 07 | 090000 | écart: 2 Sec--> Etat ON/OFF Pass / -5sec Pass / +5sec Pass /
2013 02 07 09 00 06 | 090100 | écart: 1 Sec--> Etat ON/OFF Pass / -5sec Pass / +5sec Pass /
2013 02 07 09 59 06 | 100000 | écart: 1 Sec--> Etat ON/OFF Pass / -5sec Pass / +5sec Pass /
2013 02 07 10 59 06 | 110000 | écart: 1 Sec--> Etat ON/OFF Pass / -5sec Pass / +5sec Pass /
2013 02 07 11 29 06 | 113000 | écart: 1 Sec--> Etat ON/OFF Pass / -5sec Pass / +5sec Pass /
2013 02 07 11 39 07 | 114000 | écart: 2 Sec--> Etat ON/OFF Pass / -5sec Pass / +5sec Pass /
2013 02 07 12 59 07 | 130000 | écart: 2 Sec--> Etat ON/OFF Pass / -5sec Pass / +5sec Pass /
2013 02 07 13 00 07 | 130100 | écart: 2 Sec--> Etat ON/OFF Pass / -5sec Pass / +5sec Pass /
2013 02 07 13 59 07 | 140000 | écart: 2 Sec--> Etat ON/OFF Pass / -5sec Pass / +5sec Pass /
2013 02 07 14 59 07 | 150000 | écart: 2 Sec--> Etat ON/OFF Pass / -5sec Pass / +5sec Pass /
2013 02 07 15 29 07 | 153000 | écart: 2 Sec--> Etat ON/OFF Pass / -5sec Pass / +5sec Pass /
2013 02 07 15 39 07 | 154000 | écart: 2 Sec--> Etat ON/OFF Pass / -5sec Pass / +5sec Pass /
2013 02 07 16 59 07 | 170000 | écart: 2 Sec--> Etat ON/OFF Pass / -5sec Pass / +5sec Pass /
2013 02 07 17 00 07 | 170100 | écart: 2 Sec--> Etat ON/OFF Pass / -5sec Pass / +5sec Pass /
2013 02 07 17 59 08 | 180000 | écart: 3 Sec--> Etat ON/OFF Pass / -5sec Pass / +5sec Pass /
2013 02 07 18 59 07 | 190000 | écart: 2 Sec--> Etat ON/OFF Pass / -5sec Pass / +5sec Pass /
2013 02 07 19 29 07 | 193000 | écart: 2 Sec--> Etat ON/OFF Pass / -5sec Pass / +5sec Pass /
2013 02 07 19 39 07 | 194000 | écart: 2 Sec--> Etat ON/OFF Pass / -5sec Pass / +5sec Pass /
2013 02 07 20 59 07 | 210000 | écart: 2 Sec--> Etat ON/OFF Pass / -5sec Pass / +5sec Pass /
2013 02 07 21 00 07 | 210100 | écart: 2 Sec--> Etat ON/OFF Pass / -5sec Pass / +5sec Pass /
2013 02 07 21 59 07 | 220000 | écart: 2 Sec--> Etat ON/OFF Pass / -5sec Pass / +5sec Pass /
2013 02 07 22 59 08 | 230000 | écart: 3 Sec--> Etat ON/OFF Pass / -5sec Pass / +5sec Pass /
2013 02 07 23 29 07 | 233000 | écart: 2 Sec--> Etat ON/OFF Pass / -5sec Pass / +5sec Pass /
2013 02 07 23 39 07 | 234000 | écart: 2 Sec--> Etat ON/OFF Pass / -5sec Pass / +5sec Pass /

Thu Mar 07 19:35:32 CET 2013 ::log22 ::listProg6

Cultibox | CRE | CBX 1_13_0013 | - | 27 / 39
Type | Réf. document | Indice | Page

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

Date | Heure Cultibox Heure PC | Résultats
2013 02 04 00 28 58 | 003000 | écart: -1 Sec--> Etat ON/OFF Pass / -5sec Pass / +5sec Pass /
2013 02 04 03 13 59 | 020000 | écart: 0 Sec--> Etat ON/OFF Pass / -5sec Pass / +5sec Pass /
2013 02 04 03 18 58 | 023000 | écart: -1 Sec--> Etat ON/OFF Pass / -5sec Pass / +5sec Pass /
2013 02 04 03 13 59 | 031500 | écart: 0 Sec--> Etat ON/OFF Pass / -5sec Pass / +5sec Pass /
2013 02 04 03 18 58 | 032000 | écart: -1 Sec--> Etat ON/OFF Pass / -5sec Pass / +5sec Pass /
2013 02 04 03 58 59 | 040000 | écart: 0 Sec--> Etat ON/OFF Pass / -5sec Pass / +5sec Pass /
2013 02 04 04 28 59 | 043000 | écart: 0 Sec--> Etat ON/OFF Pass / -5sec Pass / +5sec Pass /
2013 02 04 05 59 00 | 060000 | écart: 0 Sec--> Etat ON/OFF Pass / -5sec Pass / +5sec Pass /
2013 02 04 06 28 59 | 063000 | écart: 0 Sec--> Etat ON/OFF Pass / -5sec Pass / +5sec Pass /
2013 02 04 07 13 59 | 071500 | écart: 0 Sec--> Etat ON/OFF Pass / -5sec Pass / +5sec Pass /
2013 02 04 07 18 59 | 072000 | écart: 0 Sec--> Etat ON/OFF Pass / -5sec Pass / +5sec Pass /
2013 02 04 07 58 59 | 080000 | écart: 0 Sec--> Etat ON/OFF Pass / -5sec Pass / +5sec Pass /
2013 02 04 08 28 59 | 083000 | écart: 0 Sec--> Etat ON/OFF Pass / -5sec Pass / +5sec Pass /
2013 02 04 09 59 00 | 100000 | écart: 1 Sec--> Etat ON/OFF Pass / -5sec Pass / +5sec Pass /
2013 02 04 10 28 59 | 103000 | écart: 0 Sec--> Etat ON/OFF Pass / -5sec Pass / +5sec Pass /
2013 02 04 11 13 59 | 111500 | écart: 0 Sec--> Etat ON/OFF Pass / -5sec Pass / +5sec Pass /
2013 02 04 11 18 59 | 112000 | écart: 0 Sec--> Etat ON/OFF Pass / -5sec Pass / +5sec Pass /
2013 02 04 11 59 00 | 120000 | écart: 1 Sec--> Etat ON/OFF Pass / -5sec Pass / +5sec Pass /
2013 02 04 12 28 59 | 123000 | écart: 0 Sec--> Etat ON/OFF Pass / -5sec Pass / +5sec Pass /
2013 02 04 13 59 01 | 140000 | écart: 2 Sec--> Etat ON/OFF Pass / -5sec Pass / +5sec Pass /
2013 02 04 14 28 59 | 143000 | écart: 0 Sec--> Etat ON/OFF Pass / -5sec Pass / +5sec Pass /
2013 02 04 15 14 00 | 151500 | écart: 1 Sec--> Etat ON/OFF Pass / -5sec Pass / +5sec Pass /
2013 02 04 15 18 59 | 152000 | écart: 0 Sec--> Etat ON/OFF Pass / -5sec Pass / +5sec Pass /
2013 02 04 15 59 00 | 160000 | écart: 1 Sec--> Etat ON/OFF Pass / -5sec Pass / +5sec Pass /
2013 02 04 16 28 59 | 163000 | écart: 0 Sec--> Etat ON/OFF Pass / -5sec Pass / +5sec Pass /
2013 02 04 17 59 02 | 180000 | écart: 3 Sec--> Etat ON/OFF Pass / -5sec Pass / +5sec Pass /
2013 02 04 18 29 00 | 183000 | écart: 1 Sec--> Etat ON/OFF Pass / -5sec Pass / +5sec Pass /
2013 02 04 19 14 00 | 191500 | écart: 1 Sec--> Etat ON/OFF Pass / -5sec Pass / +5sec Pass /
2013 02 04 19 19 00 | 192000 | écart: 1 Sec--> Etat ON/OFF Pass / -5sec Pass / +5sec Pass /
2013 02 04 19 59 00 | 200000 | écart: 1 Sec--> Etat ON/OFF Pass / -5sec Pass / +5sec Pass /
2013 02 04 20 29 01 | 203000 | écart: 2 Sec--> Etat ON/OFF Pass / -5sec Pass / +5sec Pass /
2013 02 04 21 59 01 | 220000 | écart: 2 Sec--> Etat ON/OFF Pass / -5sec Pass / +5sec Pass /
2013 02 04 22 29 00 | 223000 | écart: 1 Sec--> Etat ON/OFF Pass / -5sec Pass / +5sec Pass /
2013 02 04 23 14 00 | 231500 | écart: 1 Sec--> Etat ON/OFF Pass / -5sec Pass / +5sec Pass /
2013 02 05 23 19 01 | 232000 | écart: 2 Sec--> Etat ON/OFF Pass / -5sec Pass / +5sec Pass /
2013 02 05 23 29 01 | 233000 | écart: 2 Sec--> Etat ON/OFF Pass / -5sec Pass / +5sec Pass /
2013 02 05 00 29 01 | 003000 | écart: 0 Sec--> Etat ON/OFF Pass / -5sec Pass / +5sec Pass /
2013 02 05 01 59 01 | 020000 | écart: 0 Sec--> Etat ON/OFF Pass / -5sec Pass / +5sec Pass /
2013 02 05 02 29 01 | 023000 | écart: 0 Sec--> Etat ON/OFF Pass / -5sec Pass / +5sec Pass /
2013 02 05 03 14 02 | 031500 | écart: 1 Sec--> Etat ON/OFF Pass / -5sec Pass / +5sec Pass /
2013 02 05 03 19 01 | 032000 | écart: 0 Sec--> Etat ON/OFF Pass / -5sec Pass / +5sec Pass /
2013 02 05 03 59 02 | 040000 | écart: 1 Sec--> Etat ON/OFF Pass / -5sec Pass / +5sec Pass /
2013 02 05 04 29 02 | 043000 | écart: 1 Sec--> Etat ON/OFF Pass / -5sec Pass / +5sec Pass /
2013 02 05 05 59 02 | 060000 | écart: 1 Sec--> Etat ON/OFF Pass / -5sec Pass / +5sec Pass /
2013 02 05 06 29 02 | 063000 | écart: 1 Sec--> Etat ON/OFF Pass / -5sec Pass / +5sec Pass /
2013 02 05 07 14 02 | 071500 | écart: 1 Sec--> Etat ON/OFF Pass / -5sec Pass / +5sec Pass /
2013 02 05 07 19 01 | 072000 | écart: 0 Sec--> Etat ON/OFF Pass / -5sec Pass / +5sec Pass /
2013 02 05 07 59 02 | 080000 | écart: 1 Sec--> Etat ON/OFF Pass / -5sec Pass / +5sec Pass /
2013 02 05 08 29 02 | 083000 | écart: 1 Sec--> Etat ON/OFF Pass / -5sec Pass / +5sec Pass /
2013 02 05 09 59 03 | 100000 | écart: 2 Sec--> Etat ON/OFF Pass / -5sec Pass / +5sec Pass /
2013 02 05 10 29 02 | 103000 | écart: 1 Sec--> Etat ON/OFF Pass / -5sec Pass / +5sec Pass /
2013 02 05 11 14 02 | 111500 | écart: 1 Sec--> Etat ON/OFF Pass / -5sec Pass / +5sec Pass /
2013 02 05 11 19 01 | 112000 | écart: 0 Sec--> Etat ON/OFF Pass / -5sec Pass / +5sec Pass /
2013 02 05 11 59 02 | 120000 | écart: 1 Sec--> Etat ON/OFF Pass / -5sec Pass / +5sec Pass /
2013 02 05 12 29 02 | 123000 | écart: 1 Sec--> Etat ON/OFF Pass / -5sec Pass / +5sec Pass /
2013 02 05 13 59 03 | 140000 | écart: 2 Sec--> Etat ON/OFF Pass / -5sec Pass / +5sec Pass /
2013 02 05 14 29 02 | 143000 | écart: 1 Sec--> Etat ON/OFF Pass / -5sec Pass / +5sec Pass /
2013 02 05 15 14 02 | 151500 | écart: 1 Sec--> Etat ON/OFF Pass / -5sec Pass / +5sec Pass /

Cultibox | CRE | CBX 1_13_0013 | - | 28 / 39
Type | Réf. document | Indice | Page

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

2013 02 05 15 19 02 | 152000 | écart: 1 Sec--> Etat ON/OFF Pass / -5sec Pass / +5sec Pass /
2013 02 05 15 59 02 | 160000 | écart: 1 Sec--> Etat ON/OFF Pass / -5sec Pass / +5sec Pass /
2013 02 05 16 29 03 | 163000 | écart: 2 Sec--> Etat ON/OFF Pass / -5sec Pass / +5sec Pass /
2013 02 05 17 59 04 | 180000 | écart: 3 Sec--> Etat ON/OFF Pass / -5sec Pass / +5sec Pass /
2013 02 05 18 29 03 | 183000 | écart: 2 Sec--> Etat ON/OFF Pass / -5sec Pass / +5sec Pass /
2013 02 05 19 14 02 | 191500 | écart: 1 Sec--> Etat ON/OFF Pass / -5sec Pass / +5sec Pass /
2013 02 05 19 19 02 | 192000 | écart: 1 Sec--> Etat ON/OFF Pass / -5sec Pass / +5sec Pass /
2013 02 05 19 59 03 | 200000 | écart: 2 Sec--> Etat ON/OFF Pass / -5sec Pass / +5sec Pass /
2013 02 05 20 29 03 | 203000 | écart: 2 Sec--> Etat ON/OFF Pass / -5sec Pass / +5sec Pass /
2013 02 05 21 59 04 | 220000 | écart: 3 Sec--> Etat ON/OFF Pass / -5sec Pass / +5sec Pass /
2013 02 06 22 29 03 | 223000 | écart: 2 Sec--> Etat ON/OFF Pass / -5sec Pass / +5sec Pass /
2013 02 06 23 14 03 | 231500 | écart: 2 Sec--> Etat ON/OFF Pass / -5sec Pass / +5sec Pass /
2013 02 06 23 19 03 | 232000 | écart: 2 Sec--> Etat ON/OFF Pass / -5sec Pass / +5sec Pass /
2013 02 06 23 29 04 | 233000 | écart: 3 Sec--> Etat ON/OFF Pass / -5sec Pass / +5sec Pass /
2013 02 06 00 29 03 | 003000 | écart: 0 Sec--> Etat ON/OFF Pass / -5sec Pass / +5sec Pass /
2013 02 06 01 59 04 | 020000 | écart: 1 Sec--> Etat ON/OFF Pass / -5sec Pass / +5sec Pass /
2013 02 06 02 29 03 | 023000 | écart: 0 Sec--> Etat ON/OFF Pass / -5sec Pass / +5sec Pass /
2013 02 06 03 14 03 | 031500 | écart: 0 Sec--> Etat ON/OFF Pass / -5sec Pass / +5sec Pass /
2013 02 06 03 19 04 | 032000 | écart: 1 Sec--> Etat ON/OFF Pass / -5sec Pass / +5sec Pass /
2013 02 06 03 59 03 | 040000 | écart: 0 Sec--> Etat ON/OFF Pass / -5sec Pass / +5sec Pass /
2013 02 06 04 29 04 | 043000 | écart: 1 Sec--> Etat ON/OFF Pass / -5sec Pass / +5sec Pass /
2013 02 06 05 59 04 | 060000 | écart: 1 Sec--> Etat ON/OFF Pass / -5sec Pass / +5sec Pass /
2013 02 06 06 29 03 | 063000 | écart: 0 Sec--> Etat ON/OFF Pass / -5sec Pass / +5sec Pass /
2013 02 06 07 14 04 | 071500 | écart: 1 Sec--> Etat ON/OFF Pass / -5sec Pass / +5sec Pass /
2013 02 06 07 19 04 | 072000 | écart: 1 Sec--> Etat ON/OFF Pass / -5sec Pass / +5sec Pass /
2013 02 06 07 59 04 | 080000 | écart: 1 Sec--> Etat ON/OFF Pass / -5sec Pass / +5sec Pass /
2013 02 06 08 29 04 | 083000 | écart: 1 Sec--> Etat ON/OFF Pass / -5sec Pass / +5sec Pass /
2013 02 06 09 59 05 | 100000 | écart: 2 Sec--> Etat ON/OFF Pass / -5sec Pass / +5sec Pass /
2013 02 06 10 29 04 | 103000 | écart: 1 Sec--> Etat ON/OFF Pass / -5sec Pass / +5sec Pass /
2013 02 06 11 14 04 | 111500 | écart: 1 Sec--> Etat ON/OFF Pass / -5sec Pass / +5sec Pass /
2013 02 06 11 19 04 | 112000 | écart: 1 Sec--> Etat ON/OFF Pass / -5sec Pass / +5sec Pass /
2013 02 06 11 59 05 | 120000 | écart: 2 Sec--> Etat ON/OFF Pass / -5sec Pass / +5sec Pass /
2013 02 06 12 29 04 | 123000 | écart: 1 Sec--> Etat ON/OFF Pass / -5sec Pass / +5sec Pass /
2013 02 06 13 59 05 | 140000 | écart: 2 Sec--> Etat ON/OFF Pass / -5sec Pass / +5sec Pass /
2013 02 06 14 29 04 | 143000 | écart: 1 Sec--> Etat ON/OFF Pass / -5sec Pass / +5sec Pass /
2013 02 06 15 14 04 | 151500 | écart: 1 Sec--> Etat ON/OFF Pass / -5sec Pass / +5sec Pass /
2013 02 06 15 19 04 | 152000 | écart: 1 Sec--> Etat ON/OFF Pass / -5sec Pass / +5sec Pass /
2013 02 06 15 59 05 | 160000 | écart: 2 Sec--> Etat ON/OFF Pass / -5sec Pass / +5sec Pass /
2013 02 06 16 29 04 | 163000 | écart: 1 Sec--> Etat ON/OFF Pass / -5sec Pass / +5sec Pass /
2013 02 06 17 59 06 | 180000 | écart: 3 Sec--> Etat ON/OFF Pass / -5sec Pass / +5sec Pass /
2013 02 06 18 29 04 | 183000 | écart: 1 Sec--> Etat ON/OFF Pass / -5sec Pass / +5sec Pass /
2013 02 06 19 14 04 | 191500 | écart: 1 Sec--> Etat ON/OFF Pass / -5sec Pass / +5sec Pass /
2013 02 06 19 19 04 | 192000 | écart: 1 Sec--> Etat ON/OFF Pass / -5sec Pass / +5sec Pass /
2013 02 06 19 59 05 | 200000 | écart: 2 Sec--> Etat ON/OFF Pass / -5sec Pass / +5sec Pass /
2013 02 06 20 29 05 | 203000 | écart: 2 Sec--> Etat ON/OFF Pass / -5sec Pass / +5sec Pass /
2013 02 06 21 59 05 | 220000 | écart: 2 Sec--> Etat ON/OFF Pass / -5sec Pass / +5sec Pass /
2013 02 06 22 29 05 | 223000 | écart: 2 Sec--> Etat ON/OFF Pass / -5sec Pass / +5sec Pass /
2013 02 06 23 14 05 | 231500 | écart: 2 Sec--> Etat ON/OFF Pass / -5sec Pass / +5sec Pass /
2013 02 06 23 19 05 | 232000 | écart: 2 Sec--> Etat ON/OFF Pass / -5sec Pass / +5sec Pass /
2013 02 06 23 29 05 | 233000 | écart: 2 Sec--> Etat ON/OFF Pass / -5sec Pass / +5sec Pass /
2013 02 06 22 29 03 | 223000 | écart: 2 Sec--> Etat ON/OFF Pass / -5sec Pass / +5sec Pass /
2013 02 06 23 14 03 | 231500 | écart: 2 Sec--> Etat ON/OFF Pass / -5sec Pass / +5sec Pass /
2013 02 06 23 19 03 | 232000 | écart: 2 Sec--> Etat ON/OFF Pass / -5sec Pass / +5sec Pass /
2013 02 06 23 29 04 | 233000 | écart: 3 Sec--> Etat ON/OFF Pass / -5sec Pass / +5sec Pass /
2013 02 07 00 29 05 | 003000 | écart: 0 Sec--> Etat ON/OFF Pass / -5sec Pass / +5sec Pass /
2013 02 07 01 59 06 | 020000 | écart: 1 Sec--> Etat ON/OFF Pass / -5sec Pass / +5sec Pass /
2013 02 07 02 29 05 | 023000 | écart: 0 Sec--> Etat ON/OFF Pass / -5sec Pass / +5sec Pass /
2013 02 07 03 14 05 | 031500 | écart: 0 Sec--> Etat ON/OFF Pass / -5sec Pass / +5sec Pass /
2013 02 07 03 19 06 | 032000 | écart: 1 Sec--> Etat ON/OFF Pass / -5sec Pass / +5sec Pass /

Cultibox | CRE | CBX 1_13_0013 | - | 29 / 39
Type | Réf. document | Indice | Page

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

2013 02 07 03 59 05 | 040000 | écart: 0 Sec--> Etat ON/OFF Pass / -5sec Pass / +5sec Pass /
2013 02 07 04 29 06 | 043000 | écart: 1 Sec--> Etat ON/OFF Pass / -5sec Pass / +5sec Pass /
2013 02 07 05 59 06 | 060000 | écart: 1 Sec--> Etat ON/OFF Pass / -5sec Pass / +5sec Pass /
2013 02 07 06 29 05 | 063000 | écart: 0 Sec--> Etat ON/OFF Pass / -5sec Pass / +5sec Pass /
2013 02 07 07 14 06 | 071500 | écart: 1 Sec--> Etat ON/OFF Pass / -5sec Pass / +5sec Pass /
2013 02 07 07 19 06 | 072000 | écart: 1 Sec--> Etat ON/OFF Pass / -5sec Pass / +5sec Pass /
2013 02 07 07 59 06 | 080000 | écart: 1 Sec--> Etat ON/OFF Pass / -5sec Pass / +5sec Pass /
2013 02 07 08 29 06 | 083000 | écart: 1 Sec--> Etat ON/OFF Pass / -5sec Pass / +5sec Pass /
2013 02 07 09 59 07 | 100000 | écart: 2 Sec--> Etat ON/OFF Pass / -5sec Pass / +5sec Pass /
2013 02 07 10 29 06 | 103000 | écart: 1 Sec--> Etat ON/OFF Pass / -5sec Pass / +5sec Pass /
2013 02 07 11 14 06 | 111500 | écart: 1 Sec--> Etat ON/OFF Pass / -5sec Pass / +5sec Pass /
2013 02 07 11 19 06 | 112000 | écart: 1 Sec--> Etat ON/OFF Pass / -5sec Pass / +5sec Pass /
2013 02 07 11 59 07 | 120000 | écart: 2 Sec--> Etat ON/OFF Pass / -5sec Pass / +5sec Pass /
2013 02 07 12 29 06 | 123000 | écart: 1 Sec--> Etat ON/OFF Pass / -5sec Pass / +5sec Pass /
2013 02 07 13 59 07 | 140000 | écart: 2 Sec--> Etat ON/OFF Pass / -5sec Pass / +5sec Pass /
2013 02 07 14 29 06 | 143000 | écart: 1 Sec--> Etat ON/OFF Pass / -5sec Pass / +5sec Pass /
2013 02 07 15 14 06 | 151500 | écart: 1 Sec--> Etat ON/OFF Pass / -5sec Pass / +5sec Pass /
2013 02 07 15 19 06 | 152000 | écart: 1 Sec--> Etat ON/OFF Pass / -5sec Pass / +5sec Pass /
2013 02 07 15 59 07 | 160000 | écart: 2 Sec--> Etat ON/OFF Pass / -5sec Pass / +5sec Pass /
2013 02 07 16 29 06 | 163000 | écart: 1 Sec--> Etat ON/OFF Pass / -5sec Pass / +5sec Pass /
2013 02 07 17 59 08 | 180000 | écart: 3 Sec--> Etat ON/OFF Pass / -5sec Pass / +5sec Pass /
2013 02 07 18 29 06 | 183000 | écart: 1 Sec--> Etat ON/OFF Pass / -5sec Pass / +5sec Pass /
2013 02 07 19 14 06 | 191500 | écart: 1 Sec--> Etat ON/OFF Pass / -5sec Pass / +5sec Pass /
2013 02 07 19 19 06 | 192000 | écart: 1 Sec--> Etat ON/OFF Pass / -5sec Pass / +5sec Pass /
2013 02 07 19 59 07 | 200000 | écart: 2 Sec--> Etat ON/OFF Pass / -5sec Pass / +5sec Pass /
2013 02 07 20 29 07 | 203000 | écart: 2 Sec--> Etat ON/OFF Pass / -5sec Pass / +5sec Pass /
2013 02 07 21 59 07 | 220000 | écart: 2 Sec--> Etat ON/OFF Pass / -5sec Pass / +5sec Pass /
2013 02 07 22 29 07 | 223000 | écart: 2 Sec--> Etat ON/OFF Pass / -5sec Pass / +5sec Pass /
2013 02 07 23 14 07 | 231500 | écart: 2 Sec--> Etat ON/OFF Pass / -5sec Pass / +5sec Pass /
2013 02 07 23 19 08 | 232000 | écart: 3 Sec--> Etat ON/OFF Pass / -5sec Pass / +5sec Pass /
2013 02 07 23 29 07 | 233000 | écart: 2 Sec--> Etat ON/OFF Pass / -5sec Pass / +5sec Pass /

Thu Mar 07 19:35:32 CET 2013 ::log26 ::listProg7
Date | Heure Cultibox Heure PC | Résultats
2013 02 04 01 29 02 | 013000 | écart: 3 Sec--> Etat ON/OFF Pass / -5sec Pass / +5sec Pass /
2013 02 04 01 44 02 | 014500 | écart: 3 Sec--> Etat ON/OFF Pass / -5sec Pass / +5sec Pass /
2013 02 04 02 44 02 | 024500 | écart: 3 Sec--> Etat ON/OFF Pass / -5sec Pass / +5sec Pass /
2013 02 04 02 44 08 | 024506 | écart: 3 Sec--> Etat ON/OFF Pass / -5sec Pass / +5sec Pass /
2013 02 04 02 59 03 | 030000 | écart: 4 Sec--> Etat ON/OFF Pass / -5sec Pass / +5sec Pass /
2013 02 04 03 59 04 | 040000 | écart: 5 Sec--> Etat ON/OFF Pass / -5sec Pass / +5sec Fail /
2013 02 04 05 29 02 | 053000 | écart: 3 Sec--> Etat ON/OFF Pass / -5sec Pass / +5sec Pass /
2013 02 04 05 44 02 | 054500 | écart: 3 Sec--> Etat ON/OFF Pass / -5sec Pass / +5sec Pass /
2013 02 04 06 44 02 | 064500 | écart: 3 Sec--> Etat ON/OFF Pass / -5sec Pass / +5sec Pass /
2013 02 04 06 44 08 | 064506 | écart: 3 Sec--> Etat ON/OFF Pass / -5sec Pass / +5sec Pass /
2013 02 04 06 59 04 | 070000 | écart: 5 Sec--> Etat ON/OFF Pass / -5sec Pass / +5sec Fail /
2013 02 04 07 59 04 | 080000 | écart: 5 Sec--> Etat ON/OFF Pass / -5sec Pass / +5sec Fail /
2013 02 04 09 29 03 | 093000 | écart: 4 Sec--> Etat ON/OFF Pass / -5sec Pass / +5sec Pass /
2013 02 04 09 44 03 | 094500 | écart: 4 Sec--> Etat ON/OFF Pass / -5sec Pass / +5sec Pass /
2013 02 04 10 44 03 | 104500 | écart: 4 Sec--> Etat ON/OFF Pass / -5sec Pass / +5sec Pass /
2013 02 04 10 44 09 | 104506 | écart: 4 Sec--> Etat ON/OFF Pass / -5sec Pass / +5sec Pass /
2013 02 04 10 59 04 | 110000 | écart: 5 Sec--> Etat ON/OFF Pass / -5sec Pass / +5sec Fail /
2013 02 04 11 59 04 | 120000 | écart: 5 Sec--> Etat ON/OFF Pass / -5sec Pass / +5sec Fail /
2013 02 04 13 29 03 | 133000 | écart: 4 Sec--> Etat ON/OFF Pass / -5sec Pass / +5sec Pass /
2013 02 04 13 44 03 | 134500 | écart: 4 Sec--> Etat ON/OFF Pass / -5sec Pass / +5sec Pass /
2013 02 04 14 44 04 | 144500 | écart: 5 Sec--> Etat ON/OFF Pass / -5sec Pass / +5sec Fail /
2013 02 04 14 44 09 | 144506 | écart: 4 Sec--> Etat ON/OFF Pass / -5sec Pass / +5sec Pass /
2013 02 04 14 59 04 | 150000 | écart: 5 Sec--> Etat ON/OFF Pass / -5sec Pass / +5sec Fail /
2013 02 04 15 59 05 | 160000 | écart: 6 Sec--> Etat ON/OFF Pass / -5sec Pass / +5sec Fail /
2013 02 04 17 29 04 | 173000 | écart: 5 Sec--> Etat ON/OFF Pass / -5sec Pass / +5sec Fail /

Cultibox | CRE | CBX 1_13_0013 | - | 30 / 39
Type | Réf. document | Indice | Page

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

2013 02 04 17 44 03 | 174500 | écart: 4 Sec--> Etat ON/OFF Pass / -5sec Pass / +5sec Pass /
2013 02 04 18 44 03 | 184500 | écart: 4 Sec--> Etat ON/OFF Pass / -5sec Pass / +5sec Pass /
2013 02 04 18 44 09 | 184506 | écart: 4 Sec--> Etat ON/OFF Pass / -5sec Pass / +5sec Pass /
2013 02 04 18 59 05 | 190000 | écart: 6 Sec--> Etat ON/OFF Pass / -5sec Pass / +5sec Fail /
2013 02 04 19 59 05 | 200000 | écart: 6 Sec--> Etat ON/OFF Pass / -5sec Pass / +5sec Fail /
2013 02 04 21 29 04 | 213000 | écart: 5 Sec--> Etat ON/OFF Pass / -5sec Pass / +5sec Fail /
2013 02 04 21 44 04 | 214500 | écart: 5 Sec--> Etat ON/OFF Pass / -5sec Pass / +5sec Fail /
2013 02 04 22 44 04 | 224500 | écart: 5 Sec--> Etat ON/OFF Pass / -5sec Pass / +5sec Fail /
2013 02 04 22 44 10 | 224506 | écart: 5 Sec--> Etat ON/OFF Pass / -5sec Pass / +5sec Fail /
2013 02 05 01 29 05 | 013000 | écart: 4 Sec--> Etat ON/OFF Pass / -5sec Pass / +5sec Pass /
2013 02 05 01 44 05 | 014500 | écart: 4 Sec--> Etat ON/OFF Pass / -5sec Pass / +5sec Pass /
2013 02 05 02 44 05 | 024500 | écart: 4 Sec--> Etat ON/OFF Pass / -5sec Pass / +5sec Pass /
2013 02 05 02 44 10 | 024506 | écart: 3 Sec--> Etat ON/OFF Pass / -5sec Pass / +5sec Pass /
2013 02 05 02 59 06 | 030000 | écart: 5 Sec--> Etat ON/OFF Pass / -5sec Pass / +5sec Fail /
2013 02 05 03 59 06 | 040000 | écart: 5 Sec--> Etat ON/OFF Pass / -5sec Pass / +5sec Fail /
2013 02 05 05 29 05 | 053000 | écart: 4 Sec--> Etat ON/OFF Pass / -5sec Pass / +5sec Pass /
2013 02 05 05 44 05 | 054500 | écart: 4 Sec--> Etat ON/OFF Pass / -5sec Pass / +5sec Pass /
2013 02 05 06 44 05 | 064500 | écart: 4 Sec--> Etat ON/OFF Pass / -5sec Pass / +5sec Pass /
2013 02 05 06 44 11 | 064506 | écart: 4 Sec--> Etat ON/OFF Pass / -5sec Pass / +5sec Pass /
2013 02 05 06 59 06 | 070000 | écart: 5 Sec--> Etat ON/OFF Pass / -5sec Pass / +5sec Fail /
2013 02 05 07 59 06 | 080000 | écart: 5 Sec--> Etat ON/OFF Pass / -5sec Pass / +5sec Fail /
2013 02 05 09 29 05 | 093000 | écart: 4 Sec--> Etat ON/OFF Pass / -5sec Pass / +5sec Pass /
2013 02 05 09 44 05 | 094500 | écart: 4 Sec--> Etat ON/OFF Pass / -5sec Pass / +5sec Pass /
2013 02 05 10 44 05 | 104500 | écart: 4 Sec--> Etat ON/OFF Pass / -5sec Pass / +5sec Pass /
2013 02 05 10 44 11 | 104506 | écart: 4 Sec--> Etat ON/OFF Pass / -5sec Pass / +5sec Pass /
2013 02 05 10 59 07 | 110000 | écart: 6 Sec--> Etat ON/OFF Pass / -5sec Pass / +5sec Fail /
2013 02 05 11 59 06 | 120000 | écart: 5 Sec--> Etat ON/OFF Pass / -5sec Pass / +5sec Fail /
2013 02 05 13 29 06 | 133000 | écart: 5 Sec--> Etat ON/OFF Pass / -5sec Pass / +5sec Fail /
2013 02 05 13 44 06 | 134500 | écart: 5 Sec--> Etat ON/OFF Pass / -5sec Pass / +5sec Fail /
2013 02 05 14 44 06 | 144500 | écart: 5 Sec--> Etat ON/OFF Pass / -5sec Pass / +5sec Fail /
2013 02 05 14 44 11 | 144506 | écart: 4 Sec--> Etat ON/OFF Pass / -5sec Pass / +5sec Pass /
2013 02 05 14 59 07 | 150000 | écart: 6 Sec--> Etat ON/OFF Pass / -5sec Pass / +5sec Fail /
2013 02 05 15 59 07 | 160000 | écart: 6 Sec--> Etat ON/OFF Pass / -5sec Pass / +5sec Fail /
2013 02 05 17 29 06 | 173000 | écart: 5 Sec--> Etat ON/OFF Pass / -5sec Pass / +5sec Fail /
2013 02 05 17 44 06 | 174500 | écart: 5 Sec--> Etat ON/OFF Pass / -5sec Pass / +5sec Fail /
2013 02 05 18 44 06 | 184500 | écart: 5 Sec--> Etat ON/OFF Pass / -5sec Pass / +5sec Fail /
2013 02 05 18 44 12 | 184506 | écart: 5 Sec--> Etat ON/OFF Pass / -5sec Pass / +5sec Fail /
2013 02 05 18 59 08 | 190000 | écart: 7 Sec--> Etat ON/OFF Pass / -5sec Pass / +5sec Fail /
2013 02 05 19 59 07 | 200000 | écart: 6 Sec--> Etat ON/OFF Pass / -5sec Pass / +5sec Fail /
2013 02 05 21 29 07 | 213000 | écart: 6 Sec--> Etat ON/OFF Pass / -5sec Pass / +5sec Fail /
2013 02 05 21 44 07 | 214500 | écart: 6 Sec--> Etat ON/OFF Pass / -5sec Pass / +5sec Fail /
2013 02 05 22 44 07 | 224500 | écart: 6 Sec--> Etat ON/OFF Pass / -5sec Pass / +5sec Fail /
2013 02 05 22 44 12 | 224506 | écart: 5 Sec--> Etat ON/OFF Pass / -5sec Pass / +5sec Fail /
2013 02 06 01 29 07 | 013000 | écart: 4 Sec--> Etat ON/OFF Pass / -5sec Pass / +5sec Pass /
2013 02 06 01 44 07 | 014500 | écart: 4 Sec--> Etat ON/OFF Pass / -5sec Pass / +5sec Pass /
2013 02 06 02 44 07 | 024500 | écart: 4 Sec--> Etat ON/OFF Pass / -5sec Pass / +5sec Pass /
2013 02 06 02 44 12 | 024506 | écart: 3 Sec--> Etat ON/OFF Pass / -5sec Pass / +5sec Pass /
2013 02 06 02 59 08 | 030000 | écart: 5 Sec--> Etat ON/OFF Pass / -5sec Pass / +5sec Fail /
2013 02 06 03 59 08 | 040000 | écart: 5 Sec--> Etat ON/OFF Pass / -5sec Pass / +5sec Fail /
2013 02 06 05 29 07 | 053000 | écart: 4 Sec--> Etat ON/OFF Pass / -5sec Pass / +5sec Pass /
2013 02 06 05 44 07 | 054500 | écart: 4 Sec--> Etat ON/OFF Pass / -5sec Pass / +5sec Pass /
2013 02 06 06 44 08 | 064500 | écart: 5 Sec--> Etat ON/OFF Pass / -5sec Pass / +5sec Fail /
2013 02 06 06 44 13 | 064506 | écart: 4 Sec--> Etat ON/OFF Pass / -5sec Pass / +5sec Pass /
2013 02 06 06 59 09 | 070000 | écart: 6 Sec--> Etat ON/OFF Pass / -5sec Pass / +5sec Fail /
2013 02 06 07 59 08 | 080000 | écart: 5 Sec--> Etat ON/OFF Pass / -5sec Pass / +5sec Fail /
2013 02 06 09 29 07 | 093000 | écart: 4 Sec--> Etat ON/OFF Pass / -5sec Pass / +5sec Pass /
2013 02 06 09 44 08 | 094500 | écart: 5 Sec--> Etat ON/OFF Pass / -5sec Pass / +5sec Fail /
2013 02 06 10 44 08 | 104500 | écart: 5 Sec--> Etat ON/OFF Pass / -5sec Pass / +5sec Fail /
2013 02 06 10 44 13 | 104506 | écart: 4 Sec--> Etat ON/OFF Pass / -5sec Pass / +5sec Pass /

Cultibox | CRE | CBX 1_13_0013 | - | 31 / 39
Type | Réf. document | Indice | Page

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

2013 02 06 10 59 09 | 110000 | écart: 6 Sec--> Etat ON/OFF Pass / -5sec Pass / +5sec Fail /
2013 02 06 11 59 09 | 120000 | écart: 6 Sec--> Etat ON/OFF Pass / -5sec Pass / +5sec Fail /
2013 02 06 13 29 08 | 133000 | écart: 5 Sec--> Etat ON/OFF Pass / -5sec Pass / +5sec Fail /
2013 02 06 13 44 08 | 134500 | écart: 5 Sec--> Etat ON/OFF Pass / -5sec Pass / +5sec Fail /
2013 02 06 14 44 08 | 144500 | écart: 5 Sec--> Etat ON/OFF Pass / -5sec Pass / +5sec Fail /
2013 02 06 14 44 14 | 144506 | écart: 5 Sec--> Etat ON/OFF Pass / -5sec Pass / +5sec Fail /
2013 02 06 14 59 09 | 150000 | écart: 6 Sec--> Etat ON/OFF Pass / -5sec Pass / +5sec Fail /
2013 02 06 15 59 09 | 160000 | écart: 6 Sec--> Etat ON/OFF Pass / -5sec Pass / +5sec Fail /
2013 02 06 17 29 08 | 173000 | écart: 5 Sec--> Etat ON/OFF Pass / -5sec Pass / +5sec Fail /
2013 02 06 17 44 08 | 174500 | écart: 5 Sec--> Etat ON/OFF Pass / -5sec Pass / +5sec Fail /
2013 02 06 18 44 08 | 184500 | écart: 5 Sec--> Etat ON/OFF Pass / -5sec Pass / +5sec Fail /
2013 02 06 18 44 14 | 184506 | écart: 5 Sec--> Etat ON/OFF Pass / -5sec Pass / +5sec Fail /
2013 02 06 18 59 10 | 190000 | écart: 7 Sec--> Etat ON/OFF Pass / -5sec Pass / +5sec Fail /
2013 02 06 19 59 09 | 200000 | écart: 6 Sec--> Etat ON/OFF Pass / -5sec Pass / +5sec Fail /
2013 02 06 21 29 09 | 213000 | écart: 6 Sec--> Etat ON/OFF Pass / -5sec Pass / +5sec Fail /
2013 02 06 21 44 09 | 214500 | écart: 6 Sec--> Etat ON/OFF Pass / -5sec Pass / +5sec Fail /
2013 02 06 22 44 09 | 224500 | écart: 6 Sec--> Etat ON/OFF Pass / -5sec Pass / +5sec Fail /
2013 02 06 22 44 14 | 224506 | écart: 5 Sec--> Etat ON/OFF Pass / -5sec Pass / +5sec Fail /
2013 02 07 01 29 09 | 013000 | écart: 4 Sec--> Etat ON/OFF Pass / -5sec Pass / +5sec Pass /
2013 02 07 01 44 09 | 014500 | écart: 4 Sec--> Etat ON/OFF Pass / -5sec Pass / +5sec Pass /
2013 02 07 02 44 09 | 024500 | écart: 4 Sec--> Etat ON/OFF Pass / -5sec Pass / +5sec Pass /
2013 02 07 02 44 15 | 024506 | écart: 4 Sec--> Etat ON/OFF Pass / -5sec Pass / +5sec Pass /
2013 02 07 02 59 10 | 030000 | écart: 5 Sec--> Etat ON/OFF Pass / -5sec Pass / +5sec Fail /
2013 02 07 03 59 10 | 040000 | écart: 5 Sec--> Etat ON/OFF Pass / -5sec Pass / +5sec Fail /
2013 02 07 05 29 09 | 053000 | écart: 4 Sec--> Etat ON/OFF Pass / -5sec Pass / +5sec Pass /
2013 02 07 05 44 09 | 054500 | écart: 4 Sec--> Etat ON/OFF Pass / -5sec Pass / +5sec Pass /
2013 02 07 06 44 09 | 064500 | écart: 4 Sec--> Etat ON/OFF Pass / -5sec Pass / +5sec Pass /
2013 02 07 06 44 15 | 064506 | écart: 4 Sec--> Etat ON/OFF Pass / -5sec Pass / +5sec Pass /
2013 02 07 06 59 11 | 070000 | écart: 6 Sec--> Etat ON/OFF Pass / -5sec Pass / +5sec Fail /
2013 02 07 07 59 10 | 080000 | écart: 5 Sec--> Etat ON/OFF Pass / -5sec Pass / +5sec Fail /
2013 02 07 09 29 10 | 093000 | écart: 5 Sec--> Etat ON/OFF Pass / -5sec Pass / +5sec Fail /
2013 02 07 09 44 10 | 094500 | écart: 5 Sec--> Etat ON/OFF Pass / -5sec Pass / +5sec Fail /
2013 02 07 10 44 10 | 104500 | écart: 5 Sec--> Etat ON/OFF Pass / -5sec Pass / +5sec Fail /
2013 02 07 10 44 16 | 104506 | écart: 5 Sec--> Etat ON/OFF Pass / -5sec Pass / +5sec Fail /
2013 02 07 10 59 11 | 110000 | écart: 6 Sec--> Etat ON/OFF Pass / -5sec Pass / +5sec Fail /
2013 02 07 11 59 11 | 120000 | écart: 6 Sec--> Etat ON/OFF Pass / -5sec Pass / +5sec Fail /
2013 02 07 13 29 10 | 133000 | écart: 5 Sec--> Etat ON/OFF Pass / -5sec Pass / +5sec Fail /
2013 02 07 13 44 10 | 134500 | écart: 5 Sec--> Etat ON/OFF Pass / -5sec Pass / +5sec Fail /
2013 02 07 14 44 10 | 144500 | écart: 5 Sec--> Etat ON/OFF Pass / -5sec Pass / +5sec Fail /
2013 02 07 14 44 16 | 144506 | écart: 5 Sec--> Etat ON/OFF Pass / -5sec Pass / +5sec Fail /
2013 02 07 14 59 11 | 150000 | écart: 6 Sec--> Etat ON/OFF Pass / -5sec Pass / +5sec Fail /
2013 02 07 15 59 11 | 160000 | écart: 6 Sec--> Etat ON/OFF Pass / -5sec Pass / +5sec Fail /
2013 02 07 17 29 11 | 173000 | écart: 6 Sec--> Etat ON/OFF Pass / -5sec Pass / +5sec Fail /
2013 02 07 17 44 10 | 174500 | écart: 5 Sec--> Etat ON/OFF Pass / -5sec Pass / +5sec Fail /
2013 02 07 18 44 11 | 184500 | écart: 6 Sec--> Etat ON/OFF Pass / -5sec Pass / +5sec Fail /
2013 02 07 18 44 16 | 184506 | écart: 5 Sec--> Etat ON/OFF Pass / -5sec Pass / +5sec Fail /
2013 02 07 18 59 12 | 190000 | écart: 7 Sec--> Etat ON/OFF Pass / -5sec Pass / +5sec Fail /
2013 02 07 19 59 12 | 200000 | écart: 7 Sec--> Etat ON/OFF Pass / -5sec Pass / +5sec Fail /
2013 02 07 21 29 11 | 213000 | écart: 6 Sec--> Etat ON/OFF Pass / -5sec Pass / +5sec Fail /
2013 02 07 21 44 10 | 214500 | écart: 5 Sec--> Etat ON/OFF Pass / -5sec Pass / +5sec Fail /
2013 02 07 22 44 11 | 224500 | écart: 6 Sec--> Etat ON/OFF Pass / -5sec Pass / +5sec Fail /
2013 02 07 22 44 16 | 224506 | écart: 5 Sec--> Etat ON/OFF Pass / -5sec Pass / +5sec Fail /

Thu Mar 07 19:35:32 CET 2013 ::log27 ::listProg8
Date | Heure Cultibox Heure PC | Résultats
2013 02 04 00 58 59 | 010000 | écart: 0 Sec--> Etat ON/OFF Pass / -5sec Pass / +5sec Pass /
2013 02 04 00 59 59 | 010100 | écart: 0 Sec--> Etat ON/OFF Pass / -5sec Pass / +5sec Pass /
2013 02 04 01 58 59 | 020000 | écart: 0 Sec--> Etat ON/OFF Pass / -5sec Pass / +5sec Pass /
2013 02 04 02 58 59 | 030000 | écart: 0 Sec--> Etat ON/OFF Pass / -5sec Pass / +5sec Pass /

Cultibox | CRE | CBX 1_13_0013 | - | 32 / 39
Type | Réf. document | Indice | Page

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

2013 02 04 03 28 59 | 033000 | écart: 0 Sec--> Etat ON/OFF Pass / -5sec Pass / +5sec Pass /
2013 02 04 03 38 59 | 034000 | écart: 0 Sec--> Etat ON/OFF Pass / -5sec Pass / +5sec Pass /
2013 02 04 04 59 00 | 050000 | écart: 1 Sec--> Etat ON/OFF Pass / -5sec Pass / +5sec Pass /
2013 02 04 04 59 59 | 050100 | écart: 0 Sec--> Etat ON/OFF Pass / -5sec Pass / +5sec Pass /
2013 02 04 05 59 00 | 060000 | écart: 1 Sec--> Etat ON/OFF Pass / -5sec Pass / +5sec Pass /
2013 02 04 06 59 00 | 070000 | écart: 1 Sec--> Etat ON/OFF Pass / -5sec Pass / +5sec Pass /
2013 02 04 07 29 00 | 073000 | écart: 1 Sec--> Etat ON/OFF Pass / -5sec Pass / +5sec Pass /
2013 02 04 07 39 00 | 074000 | écart: 1 Sec--> Etat ON/OFF Pass / -5sec Pass / +5sec Pass /
2013 02 04 08 59 00 | 090000 | écart: 1 Sec--> Etat ON/OFF Pass / -5sec Pass / +5sec Pass /
2013 02 04 08 59 59 | 090100 | écart: 0 Sec--> Etat ON/OFF Pass / -5sec Pass / +5sec Pass /
2013 02 04 09 59 00 | 100000 | écart: 1 Sec--> Etat ON/OFF Pass / -5sec Pass / +5sec Pass /
2013 02 04 10 59 00 | 110000 | écart: 1 Sec--> Etat ON/OFF Pass / -5sec Pass / +5sec Pass /
2013 02 04 11 29 00 | 113000 | écart: 1 Sec--> Etat ON/OFF Pass / -5sec Pass / +5sec Pass /
2013 02 04 11 39 00 | 114000 | écart: 1 Sec--> Etat ON/OFF Pass / -5sec Pass / +5sec Pass /
2013 02 04 12 59 01 | 130000 | écart: 2 Sec--> Etat ON/OFF Pass / -5sec Pass / +5sec Pass /
2013 02 04 13 00 00 | 130100 | écart: 1 Sec--> Etat ON/OFF Pass / -5sec Pass / +5sec Pass /
2013 02 04 13 59 01 | 140000 | écart: 2 Sec--> Etat ON/OFF Pass / -5sec Pass / +5sec Pass /
2013 02 04 14 59 00 | 150000 | écart: 1 Sec--> Etat ON/OFF Pass / -5sec Pass / +5sec Pass /
2013 02 04 15 29 00 | 153000 | écart: 1 Sec--> Etat ON/OFF Pass / -5sec Pass / +5sec Pass /
2013 02 04 15 39 00 | 154000 | écart: 1 Sec--> Etat ON/OFF Pass / -5sec Pass / +5sec Pass /
2013 02 04 16 59 01 | 170000 | écart: 2 Sec--> Etat ON/OFF Pass / -5sec Pass / +5sec Pass /
2013 02 04 17 00 00 | 170100 | écart: 1 Sec--> Etat ON/OFF Pass / -5sec Pass / +5sec Pass /
2013 02 04 17 59 02 | 180000 | écart: 3 Sec--> Etat ON/OFF Pass / -5sec Pass / +5sec Pass /
2013 02 04 18 59 01 | 190000 | écart: 2 Sec--> Etat ON/OFF Pass / -5sec Pass / +5sec Pass /
2013 02 04 19 29 01 | 193000 | écart: 2 Sec--> Etat ON/OFF Pass / -5sec Pass / +5sec Pass /
2013 02 04 19 39 01 | 194000 | écart: 2 Sec--> Etat ON/OFF Pass / -5sec Pass / +5sec Pass /
2013 02 04 20 59 01 | 210000 | écart: 2 Sec--> Etat ON/OFF Pass / -5sec Pass / +5sec Pass /
2013 02 04 21 00 01 | 210100 | écart: 2 Sec--> Etat ON/OFF Pass / -5sec Pass / +5sec Pass /
2013 02 04 21 59 01 | 220000 | écart: 2 Sec--> Etat ON/OFF Pass / -5sec Pass / +5sec Pass /
2013 02 04 22 59 01 | 230000 | écart: 2 Sec--> Etat ON/OFF Pass / -5sec Pass / +5sec Pass /
2013 02 04 23 29 02 | 233000 | écart: 3 Sec--> Etat ON/OFF Pass / -5sec Pass / +5sec Pass /
2013 02 04 23 39 01 | 234000 | écart: 2 Sec--> Etat ON/OFF Pass / -5sec Pass / +5sec Pass /
2013 02 05 00 59 02 | 010000 | écart: 1 Sec--> Etat ON/OFF Pass / -5sec Pass / +5sec Pass /
2013 02 05 01 00 02 | 010100 | écart: 1 Sec--> Etat ON/OFF Pass / -5sec Pass / +5sec Pass /
2013 02 05 01 59 02 | 020000 | écart: 1 Sec--> Etat ON/OFF Pass / -5sec Pass / +5sec Pass /
2013 02 05 02 59 02 | 030000 | écart: 1 Sec--> Etat ON/OFF Pass / -5sec Pass / +5sec Pass /
2013 02 05 03 29 02 | 033000 | écart: 1 Sec--> Etat ON/OFF Pass / -5sec Pass / +5sec Pass /
2013 02 05 03 39 02 | 034000 | écart: 1 Sec--> Etat ON/OFF Pass / -5sec Pass / +5sec Pass /
2013 02 05 04 59 03 | 050000 | écart: 2 Sec--> Etat ON/OFF Pass / -5sec Pass / +5sec Pass /
2013 02 05 05 00 02 | 050100 | écart: 1 Sec--> Etat ON/OFF Pass / -5sec Pass / +5sec Pass /
2013 02 05 05 59 03 | 060000 | écart: 2 Sec--> Etat ON/OFF Pass / -5sec Pass / +5sec Pass /
2013 02 05 06 59 02 | 070000 | écart: 1 Sec--> Etat ON/OFF Pass / -5sec Pass / +5sec Pass /
2013 02 05 07 29 02 | 073000 | écart: 1 Sec--> Etat ON/OFF Pass / -5sec Pass / +5sec Pass /
2013 02 05 07 39 02 | 074000 | écart: 1 Sec--> Etat ON/OFF Pass / -5sec Pass / +5sec Pass /
2013 02 05 08 59 02 | 090000 | écart: 1 Sec--> Etat ON/OFF Pass / -5sec Pass / +5sec Pass /
2013 02 05 09 00 02 | 090100 | écart: 1 Sec--> Etat ON/OFF Pass / -5sec Pass / +5sec Pass /
2013 02 05 09 59 03 | 100000 | écart: 2 Sec--> Etat ON/OFF Pass / -5sec Pass / +5sec Pass /
2013 02 05 10 59 03 | 110000 | écart: 2 Sec--> Etat ON/OFF Pass / -5sec Pass / +5sec Pass /
2013 02 05 11 29 03 | 113000 | écart: 2 Sec--> Etat ON/OFF Pass / -5sec Pass / +5sec Pass /
2013 02 05 11 39 03 | 114000 | écart: 2 Sec--> Etat ON/OFF Pass / -5sec Pass / +5sec Pass /
2013 02 05 12 59 02 | 130000 | écart: 1 Sec--> Etat ON/OFF Pass / -5sec Pass / +5sec Pass /
2013 02 05 13 00 03 | 130100 | écart: 2 Sec--> Etat ON/OFF Pass / -5sec Pass / +5sec Pass /
2013 02 05 13 59 03 | 140000 | écart: 2 Sec--> Etat ON/OFF Pass / -5sec Pass / +5sec Pass /
2013 02 05 14 59 03 | 150000 | écart: 2 Sec--> Etat ON/OFF Pass / -5sec Pass / +5sec Pass /
2013 02 05 15 29 03 | 153000 | écart: 2 Sec--> Etat ON/OFF Pass / -5sec Pass / +5sec Pass /
2013 02 05 15 39 03 | 154000 | écart: 2 Sec--> Etat ON/OFF Pass / -5sec Pass / +5sec Pass /
2013 02 05 16 59 03 | 170000 | écart: 2 Sec--> Etat ON/OFF Pass / -5sec Pass / +5sec Pass /
2013 02 05 17 00 03 | 170100 | écart: 2 Sec--> Etat ON/OFF Pass / -5sec Pass / +5sec Pass /
2013 02 05 17 59 04 | 180000 | écart: 3 Sec--> Etat ON/OFF Pass / -5sec Pass / +5sec Pass /

Cultibox | CRE | CBX 1_13_0013 | - | 33 / 39
Type | Réf. document | Indice | Page

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

2013 02 05 18 59 03 | 190000 | écart: 2 Sec--> Etat ON/OFF Pass / -5sec Pass / +5sec Pass /
2013 02 05 19 29 04 | 193000 | écart: 3 Sec--> Etat ON/OFF Pass / -5sec Pass / +5sec Pass /
2013 02 05 19 39 03 | 194000 | écart: 2 Sec--> Etat ON/OFF Pass / -5sec Pass / +5sec Pass /
2013 02 05 20 59 03 | 210000 | écart: 2 Sec--> Etat ON/OFF Pass / -5sec Pass / +5sec Pass /
2013 02 05 21 00 03 | 210100 | écart: 2 Sec--> Etat ON/OFF Pass / -5sec Pass / +5sec Pass /
2013 02 05 21 59 04 | 220000 | écart: 3 Sec--> Etat ON/OFF Pass / -5sec Pass / +5sec Pass /
2013 02 05 22 59 03 | 230000 | écart: 2 Sec--> Etat ON/OFF Pass / -5sec Pass / +5sec Pass /
2013 02 05 23 29 04 | 233000 | écart: 3 Sec--> Etat ON/OFF Pass / -5sec Pass / +5sec Pass /
2013 02 05 23 39 03 | 234000 | écart: 2 Sec--> Etat ON/OFF Pass / -5sec Pass / +5sec Pass /
2013 02 06 00 59 04 | 010000 | écart: 1 Sec--> Etat ON/OFF Pass / -5sec Pass / +5sec Pass /
2013 02 06 01 00 04 | 010100 | écart: 1 Sec--> Etat ON/OFF Pass / -5sec Pass / +5sec Pass /
2013 02 06 01 59 04 | 020000 | écart: 1 Sec--> Etat ON/OFF Pass / -5sec Pass / +5sec Pass /
2013 02 06 02 59 04 | 030000 | écart: 1 Sec--> Etat ON/OFF Pass / -5sec Pass / +5sec Pass /
2013 02 06 03 29 04 | 033000 | écart: 1 Sec--> Etat ON/OFF Pass / -5sec Pass / +5sec Pass /
2013 02 06 03 39 04 | 034000 | écart: 1 Sec--> Etat ON/OFF Pass / -5sec Pass / +5sec Pass /
2013 02 06 04 59 05 | 050000 | écart: 2 Sec--> Etat ON/OFF Pass / -5sec Pass / +5sec Pass /
2013 02 06 05 00 04 | 050100 | écart: 1 Sec--> Etat ON/OFF Pass / -5sec Pass / +5sec Pass /
2013 02 06 05 59 05 | 060000 | écart: 2 Sec--> Etat ON/OFF Pass / -5sec Pass / +5sec Pass /
2013 02 06 06 59 04 | 070000 | écart: 1 Sec--> Etat ON/OFF Pass / -5sec Pass / +5sec Pass /
2013 02 06 07 29 05 | 073000 | écart: 2 Sec--> Etat ON/OFF Pass / -5sec Pass / +5sec Pass /
2013 02 06 07 39 04 | 074000 | écart: 1 Sec--> Etat ON/OFF Pass / -5sec Pass / +5sec Pass /
2013 02 06 08 59 04 | 090000 | écart: 1 Sec--> Etat ON/OFF Pass / -5sec Pass / +5sec Pass /
2013 02 06 09 00 04 | 090100 | écart: 1 Sec--> Etat ON/OFF Pass / -5sec Pass / +5sec Pass /
2013 02 06 09 59 05 | 100000 | écart: 2 Sec--> Etat ON/OFF Pass / -5sec Pass / +5sec Pass /
2013 02 06 10 59 04 | 110000 | écart: 1 Sec--> Etat ON/OFF Pass / -5sec Pass / +5sec Pass /
2013 02 06 11 29 05 | 113000 | écart: 2 Sec--> Etat ON/OFF Pass / -5sec Pass / +5sec Pass /
2013 02 06 11 39 05 | 114000 | écart: 2 Sec--> Etat ON/OFF Pass / -5sec Pass / +5sec Pass /
2013 02 06 12 59 04 | 130000 | écart: 1 Sec--> Etat ON/OFF Pass / -5sec Pass / +5sec Pass /
2013 02 06 13 00 04 | 130100 | écart: 1 Sec--> Etat ON/OFF Pass / -5sec Pass / +5sec Pass /
2013 02 06 13 59 05 | 140000 | écart: 2 Sec--> Etat ON/OFF Pass / -5sec Pass / +5sec Pass /
2013 02 06 14 59 05 | 150000 | écart: 2 Sec--> Etat ON/OFF Pass / -5sec Pass / +5sec Pass /
2013 02 06 15 29 05 | 153000 | écart: 2 Sec--> Etat ON/OFF Pass / -5sec Pass / +5sec Pass /
2013 02 06 15 39 05 | 154000 | écart: 2 Sec--> Etat ON/OFF Pass / -5sec Pass / +5sec Pass /
2013 02 06 16 59 05 | 170000 | écart: 2 Sec--> Etat ON/OFF Pass / -5sec Pass / +5sec Pass /
2013 02 06 17 00 05 | 170100 | écart: 2 Sec--> Etat ON/OFF Pass / -5sec Pass / +5sec Pass /
2013 02 06 17 59 07 | 180000 | écart: 4 Sec--> Etat ON/OFF Pass / -5sec Pass / +5sec Pass /
2013 02 06 18 59 05 | 190000 | écart: 2 Sec--> Etat ON/OFF Pass / -5sec Pass / +5sec Pass /
2013 02 06 19 29 05 | 193000 | écart: 2 Sec--> Etat ON/OFF Pass / -5sec Pass / +5sec Pass /
2013 02 06 19 39 05 | 194000 | écart: 2 Sec--> Etat ON/OFF Pass / -5sec Pass / +5sec Pass /
2013 02 06 20 59 05 | 210000 | écart: 2 Sec--> Etat ON/OFF Pass / -5sec Pass / +5sec Pass /
2013 02 06 21 00 05 | 210100 | écart: 2 Sec--> Etat ON/OFF Pass / -5sec Pass / +5sec Pass /
2013 02 06 21 59 06 | 220000 | écart: 3 Sec--> Etat ON/OFF Pass / -5sec Pass / +5sec Pass /
2013 02 06 22 59 06 | 230000 | écart: 3 Sec--> Etat ON/OFF Pass / -5sec Pass / +5sec Pass /
2013 02 06 23 29 06 | 233000 | écart: 3 Sec--> Etat ON/OFF Pass / -5sec Pass / +5sec Pass /
2013 02 06 23 39 05 | 234000 | écart: 2 Sec--> Etat ON/OFF Pass / -5sec Pass / +5sec Pass /
2013 02 07 00 59 06 | 010000 | écart: 1 Sec--> Etat ON/OFF Pass / -5sec Pass / +5sec Pass /
2013 02 07 01 00 06 | 010100 | écart: 1 Sec--> Etat ON/OFF Pass / -5sec Pass / +5sec Pass /
2013 02 07 01 59 06 | 020000 | écart: 1 Sec--> Etat ON/OFF Pass / -5sec Pass / +5sec Pass /
2013 02 07 02 59 06 | 030000 | écart: 1 Sec--> Etat ON/OFF Pass / -5sec Pass / +5sec Pass /
2013 02 07 03 29 06 | 033000 | écart: 1 Sec--> Etat ON/OFF Pass / -5sec Pass / +5sec Pass /
2013 02 07 03 39 06 | 034000 | écart: 1 Sec--> Etat ON/OFF Pass / -5sec Pass / +5sec Pass /
2013 02 07 04 59 07 | 050000 | écart: 2 Sec--> Etat ON/OFF Pass / -5sec Pass / +5sec Pass /
2013 02 07 05 00 07 | 050100 | écart: 2 Sec--> Etat ON/OFF Pass / -5sec Pass / +5sec Pass /
2013 02 07 05 59 07 | 060000 | écart: 2 Sec--> Etat ON/OFF Pass / -5sec Pass / +5sec Pass /
2013 02 07 06 59 07 | 070000 | écart: 2 Sec--> Etat ON/OFF Pass / -5sec Pass / +5sec Pass /
2013 02 07 07 29 06 | 073000 | écart: 1 Sec--> Etat ON/OFF Pass / -5sec Pass / +5sec Pass /
2013 02 07 07 39 06 | 074000 | écart: 1 Sec--> Etat ON/OFF Pass / -5sec Pass / +5sec Pass /
2013 02 07 08 59 07 | 090000 | écart: 2 Sec--> Etat ON/OFF Pass / -5sec Pass / +5sec Pass /
2013 02 07 09 00 07 | 090100 | écart: 2 Sec--> Etat ON/OFF Pass / -5sec Pass / +5sec Pass /

Cultibox | CRE | CBX 1_13_0013 | - | 34 / 39
Type | Réf. document | Indice | Page

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

2013 02 07 09 59 07 | 100000 | écart: 2 Sec--> Etat ON/OFF Pass / -5sec Pass / +5sec Pass /
2013 02 07 10 59 07 | 110000 | écart: 2 Sec--> Etat ON/OFF Pass / -5sec Pass / +5sec Pass /
2013 02 07 11 29 07 | 113000 | écart: 2 Sec--> Etat ON/OFF Pass / -5sec Pass / +5sec Pass /
2013 02 07 11 39 07 | 114000 | écart: 2 Sec--> Etat ON/OFF Pass / -5sec Pass / +5sec Pass /
2013 02 07 12 59 07 | 130000 | écart: 2 Sec--> Etat ON/OFF Pass / -5sec Pass / +5sec Pass /
2013 02 07 13 00 07 | 130100 | écart: 2 Sec--> Etat ON/OFF Pass / -5sec Pass / +5sec Pass /
2013 02 07 13 59 07 | 140000 | écart: 2 Sec--> Etat ON/OFF Pass / -5sec Pass / +5sec Pass /
2013 02 07 14 59 07 | 150000 | écart: 2 Sec--> Etat ON/OFF Pass / -5sec Pass / +5sec Pass /
2013 02 07 15 29 07 | 153000 | écart: 2 Sec--> Etat ON/OFF Pass / -5sec Pass / +5sec Pass /
2013 02 07 15 39 08 | 154000 | écart: 3 Sec--> Etat ON/OFF Pass / -5sec Pass / +5sec Pass /
2013 02 07 16 59 08 | 170000 | écart: 3 Sec--> Etat ON/OFF Pass / -5sec Pass / +5sec Pass /
2013 02 07 17 00 08 | 170100 | écart: 3 Sec--> Etat ON/OFF Pass / -5sec Pass / +5sec Pass /
2013 02 07 17 59 08 | 180000 | écart: 3 Sec--> Etat ON/OFF Pass / -5sec Pass / +5sec Pass /
2013 02 07 18 59 08 | 190000 | écart: 3 Sec--> Etat ON/OFF Pass / -5sec Pass / +5sec Pass /
2013 02 07 19 29 08 | 193000 | écart: 3 Sec--> Etat ON/OFF Pass / -5sec Pass / +5sec Pass /
2013 02 07 19 39 08 | 194000 | écart: 3 Sec--> Etat ON/OFF Pass / -5sec Pass / +5sec Pass /
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
2013 02 07 10 29 06 | 103000 | écart: 1 Sec--> Etat ON/OFF Pass / -5sec Pass / +5sec Pass /
2013 02 07 11 14 06 | 111500 | écart: 1 Sec--> Etat ON/OFF Pass / -5sec Pass / +5sec Pass /
2013 02 07 11 19 06 | 112000 | écart: 1 Sec--> Etat ON/OFF Pass / -5sec Pass / +5sec Pass /
2013 02 07 11 59 07 | 120000 | écart: 2 Sec--> Etat ON/OFF Pass / -5sec Pass / +5sec Pass /
2013 02 07 12 29 06 | 123000 | écart: 1 Sec--> Etat ON/OFF Pass / -5sec Pass / +5sec Pass /
2013 02 07 13 59 07 | 140000 | écart: 2 Sec--> Etat ON/OFF Pass / -5sec Pass / +5sec Pass /
2013 02 07 14 29 06 | 143000 | écart: 1 Sec--> Etat ON/OFF Pass / -5sec Pass / +5sec Pass /
2013 02 07 15 14 06 | 151500 | écart: 1 Sec--> Etat ON/OFF Pass / -5sec Pass / +5sec Pass /
2013 02 07 15 19 06 | 152000 | écart: 1 Sec--> Etat ON/OFF Pass / -5sec Pass / +5sec Pass /
2013 02 07 15 59 07 | 160000 | écart: 2 Sec--> Etat ON/OFF Pass / -5sec Pass / +5sec Pass /
2013 02 07 16 29 06 | 163000 | écart: 1 Sec--> Etat ON/OFF Pass / -5sec Pass / +5sec Pass /
2013 02 07 17 59 08 | 180000 | écart: 3 Sec--> Etat ON/OFF Pass / -5sec Pass / +5sec Pass /
2013 02 07 18 29 06 | 183000 | écart: 1 Sec--> Etat ON/OFF Pass / -5sec Pass / +5sec Pass /
2013 02 07 19 14 06 | 191500 | écart: 1 Sec--> Etat ON/OFF Pass / -5sec Pass / +5sec Pass /
2013 02 07 19 19 06 | 192000 | écart: 1 Sec--> Etat ON/OFF Pass / -5sec Pass / +5sec Pass /
2013 02 07 19 59 07 | 200000 | écart: 2 Sec--> Etat ON/OFF Pass / -5sec Pass / +5sec Pass /
2013 02 07 20 29 07 | 203000 | écart: 2 Sec--> Etat ON/OFF Pass / -5sec Pass / +5sec Pass /
2013 02 07 21 59 07 | 220000 | écart: 2 Sec--> Etat ON/OFF Pass / -5sec Pass / +5sec Pass /
2013 02 07 22 29 07 | 223000 | écart: 2 Sec--> Etat ON/OFF Pass / -5sec Pass / +5sec Pass /
2013 02 07 23 14 07 | 231500 | écart: 2 Sec--> Etat ON/OFF Pass / -5sec Pass / +5sec Pass /
2013 02 07 23 19 08 | 232000 | écart: 3 Sec--> Etat ON/OFF Pass / -5sec Pass / +5sec Pass /
2013 02 07 23 29 07 | 233000 | écart: 2 Sec--> Etat ON/OFF Pass / -5sec Pass / +5sec Pass /

Thu Mar 07 19:35:32 CET 2013 ::log29 ::listProg10
Date | Heure Cultibox Heure PC | Résultats
2013 02 04 01 28 59 | 013000 | écart: 0 Sec--> Etat ON/OFF Pass / -5sec Pass / +5sec Pass /
2013 02 04 01 43 59 | 014500 | écart: 0 Sec--> Etat ON/OFF Pass / -5sec Pass / +5sec Pass /
2013 02 04 02 43 59 | 024500 | écart: 0 Sec--> Etat ON/OFF Pass / -5sec Pass / +5sec Pass /
2013 02 04 02 44 04 | 024506 | écart: -1 Sec--> Etat ON/OFF Pass / -5sec Pass / +5sec Pass /
2013 02 04 02 58 59 | 030000 | écart: 0 Sec--> Etat ON/OFF Pass / -5sec Pass / +5sec Pass /

Cultibox | CRE | CBX 1_13_0013 | - | 37 / 39
Type | Réf. document | Indice | Page

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

2013 02 04 03 59 00 | 040000 | écart: 1 Sec--> Etat ON/OFF Pass / -5sec Pass / +5sec Pass /
2013 02 04 05 28 59 | 053000 | écart: 0 Sec--> Etat ON/OFF Pass / -5sec Pass / +5sec Pass /
2013 02 04 05 43 59 | 054500 | écart: 0 Sec--> Etat ON/OFF Pass / -5sec Pass / +5sec Pass /
2013 02 04 06 43 59 | 064500 | écart: 0 Sec--> Etat ON/OFF Pass / -5sec Pass / +5sec Pass /
2013 02 04 06 44 05 | 064506 | écart: 0 Sec--> Etat ON/OFF Pass / -5sec Pass / +5sec Pass /
2013 02 04 06 59 00 | 070000 | écart: 1 Sec--> Etat ON/OFF Pass / -5sec Pass / +5sec Pass /
2013 02 04 07 59 00 | 080000 | écart: 1 Sec--> Etat ON/OFF Pass / -5sec Pass / +5sec Pass /
2013 02 04 09 28 59 | 093000 | écart: 0 Sec--> Etat ON/OFF Pass / -5sec Pass / +5sec Pass /
2013 02 04 09 43 59 | 094500 | écart: 0 Sec--> Etat ON/OFF Pass / -5sec Pass / +5sec Pass /
2013 02 04 10 43 59 | 104500 | écart: 0 Sec--> Etat ON/OFF Pass / -5sec Pass / +5sec Pass /
2013 02 04 10 44 06 | 104506 | écart: 1 Sec--> Etat ON/OFF Pass / -5sec Pass / +5sec Pass /
2013 02 04 10 59 01 | 110000 | écart: 2 Sec--> Etat ON/OFF Pass / -5sec Pass / +5sec Pass /
2013 02 04 11 59 00 | 120000 | écart: 1 Sec--> Etat ON/OFF Pass / -5sec Pass / +5sec Pass /
2013 02 04 13 29 00 | 133000 | écart: 1 Sec--> Etat ON/OFF Pass / -5sec Pass / +5sec Pass /
2013 02 04 13 44 00 | 134500 | écart: 1 Sec--> Etat ON/OFF Pass / -5sec Pass / +5sec Pass /
2013 02 04 14 44 00 | 144500 | écart: 1 Sec--> Etat ON/OFF Pass / -5sec Pass / +5sec Pass /
2013 02 04 14 44 06 | 144506 | écart: 1 Sec--> Etat ON/OFF Pass / -5sec Pass / +5sec Pass /
2013 02 04 14 59 01 | 150000 | écart: 2 Sec--> Etat ON/OFF Pass / -5sec Pass / +5sec Pass /
2013 02 04 15 59 01 | 160000 | écart: 2 Sec--> Etat ON/OFF Pass / -5sec Pass / +5sec Pass /
2013 02 04 17 29 00 | 173000 | écart: 1 Sec--> Etat ON/OFF Pass / -5sec Pass / +5sec Pass /
2013 02 04 17 44 00 | 174500 | écart: 1 Sec--> Etat ON/OFF Pass / -5sec Pass / +5sec Pass /
2013 02 04 18 44 00 | 184500 | écart: 1 Sec--> Etat ON/OFF Pass / -5sec Pass / +5sec Pass /
2013 02 04 18 44 06 | 184506 | écart: 1 Sec--> Etat ON/OFF Pass / -5sec Pass / +5sec Pass /
2013 02 04 18 59 01 | 190000 | écart: 2 Sec--> Etat ON/OFF Pass / -5sec Pass / +5sec Pass /
2013 02 04 19 59 01 | 200000 | écart: 2 Sec--> Etat ON/OFF Pass / -5sec Pass / +5sec Pass /
2013 02 04 21 29 01 | 213000 | écart: 2 Sec--> Etat ON/OFF Pass / -5sec Pass / +5sec Pass /
2013 02 04 21 44 01 | 214500 | écart: 2 Sec--> Etat ON/OFF Pass / -5sec Pass / +5sec Pass /
2013 02 04 22 44 00 | 224500 | écart: 1 Sec--> Etat ON/OFF Pass / -5sec Pass / +5sec Pass /
2013 02 04 22 44 07 | 224506 | écart: 2 Sec--> Etat ON/OFF Pass / -5sec Pass / +5sec Pass /
2013 02 05 01 29 01 | 013000 | écart: 0 Sec--> Etat ON/OFF Pass / -5sec Pass / +5sec Pass /
2013 02 05 01 44 01 | 014500 | écart: 0 Sec--> Etat ON/OFF Pass / -5sec Pass / +5sec Pass /
2013 02 05 02 44 01 | 024500 | écart: 0 Sec--> Etat ON/OFF Pass / -5sec Pass / +5sec Pass /
2013 02 05 02 44 07 | 024506 | écart: 0 Sec--> Etat ON/OFF Pass / -5sec Pass / +5sec Pass /
2013 02 05 02 59 02 | 030000 | écart: 1 Sec--> Etat ON/OFF Pass / -5sec Pass / +5sec Pass /
2013 02 05 03 59 03 | 040000 | écart: 2 Sec--> Etat ON/OFF Pass / -5sec Pass / +5sec Pass /
2013 02 05 05 29 02 | 053000 | écart: 1 Sec--> Etat ON/OFF Pass / -5sec Pass / +5sec Pass /
2013 02 05 05 44 02 | 054500 | écart: 1 Sec--> Etat ON/OFF Pass / -5sec Pass / +5sec Pass /
2013 02 05 06 44 02 | 064500 | écart: 1 Sec--> Etat ON/OFF Pass / -5sec Pass / +5sec Pass /
2013 02 05 06 44 07 | 064506 | écart: 0 Sec--> Etat ON/OFF Pass / -5sec Pass / +5sec Pass /
2013 02 05 06 59 03 | 070000 | écart: 2 Sec--> Etat ON/OFF Pass / -5sec Pass / +5sec Pass /
2013 02 05 07 59 02 | 080000 | écart: 1 Sec--> Etat ON/OFF Pass / -5sec Pass / +5sec Pass /
2013 02 05 09 29 01 | 093000 | écart: 0 Sec--> Etat ON/OFF Pass / -5sec Pass / +5sec Pass /
2013 02 05 09 44 02 | 094500 | écart: 1 Sec--> Etat ON/OFF Pass / -5sec Pass / +5sec Pass /
2013 02 05 10 44 02 | 104500 | écart: 1 Sec--> Etat ON/OFF Pass / -5sec Pass / +5sec Pass /
2013 02 05 10 44 08 | 104506 | écart: 1 Sec--> Etat ON/OFF Pass / -5sec Pass / +5sec Pass /
2013 02 05 10 59 03 | 110000 | écart: 2 Sec--> Etat ON/OFF Pass / -5sec Pass / +5sec Pass /
2013 02 05 11 59 03 | 120000 | écart: 2 Sec--> Etat ON/OFF Pass / -5sec Pass / +5sec Pass /
2013 02 05 13 29 03 | 133000 | écart: 2 Sec--> Etat ON/OFF Pass / -5sec Pass / +5sec Pass /
2013 02 05 13 44 03 | 134500 | écart: 2 Sec--> Etat ON/OFF Pass / -5sec Pass / +5sec Pass /
2013 02 05 14 44 02 | 144500 | écart: 1 Sec--> Etat ON/OFF Pass / -5sec Pass / +5sec Pass /
2013 02 05 14 44 08 | 144506 | écart: 1 Sec--> Etat ON/OFF Pass / -5sec Pass / +5sec Pass /
2013 02 05 14 59 04 | 150000 | écart: 3 Sec--> Etat ON/OFF Pass / -5sec Pass / +5sec Pass /
2013 02 05 15 59 03 | 160000 | écart: 2 Sec--> Etat ON/OFF Pass / -5sec Pass / +5sec Pass /
2013 02 05 17 29 03 | 173000 | écart: 2 Sec--> Etat ON/OFF Pass / -5sec Pass / +5sec Pass /
2013 02 05 17 44 03 | 174500 | écart: 2 Sec--> Etat ON/OFF Pass / -5sec Pass / +5sec Pass /
2013 02 05 18 44 03 | 184500 | écart: 2 Sec--> Etat ON/OFF Pass / -5sec Pass / +5sec Pass /
2013 02 05 18 44 08 | 184506 | écart: 1 Sec--> Etat ON/OFF Pass / -5sec Pass / +5sec Pass /
2013 02 05 18 59 04 | 190000 | écart: 3 Sec--> Etat ON/OFF Pass / -5sec Pass / +5sec Pass /
2013 02 05 19 59 04 | 200000 | écart: 3 Sec--> Etat ON/OFF Pass / -5sec Pass / +5sec Pass /

Cultibox | CRE | CBX 1_13_0013 | - | 38 / 39
Type | Réf. document | Indice | Page

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

2013 02 05 21 29 03 | 213000 | écart: 2 Sec--> Etat ON/OFF Pass / -5sec Pass / +5sec Pass /
2013 02 05 21 44 03 | 214500 | écart: 2 Sec--> Etat ON/OFF Pass / -5sec Pass / +5sec Pass /
2013 02 05 22 44 03 | 224500 | écart: 2 Sec--> Etat ON/OFF Pass / -5sec Pass / +5sec Pass /
2013 02 05 22 44 09 | 224506 | écart: 2 Sec--> Etat ON/OFF Pass / -5sec Pass / +5sec Pass /
2013 02 06 01 29 04 | 013000 | écart: 1 Sec--> Etat ON/OFF Pass / -5sec Pass / +5sec Pass /
2013 02 06 01 44 04 | 014500 | écart: 1 Sec--> Etat ON/OFF Pass / -5sec Pass / +5sec Pass /
2013 02 06 02 44 03 | 024500 | écart: 0 Sec--> Etat ON/OFF Pass / -5sec Pass / +5sec Pass /
2013 02 06 02 44 09 | 024506 | écart: 0 Sec--> Etat ON/OFF Pass / -5sec Pass / +5sec Pass /
2013 02 06 02 59 05 | 030000 | écart: 2 Sec--> Etat ON/OFF Pass / -5sec Pass / +5sec Pass /
2013 02 06 03 59 05 | 040000 | écart: 2 Sec--> Etat ON/OFF Pass / -5sec Pass / +5sec Pass /
2013 02 06 05 29 04 | 053000 | écart: 1 Sec--> Etat ON/OFF Pass / -5sec Pass / +5sec Pass /
2013 02 06 05 44 04 | 054500 | écart: 1 Sec--> Etat ON/OFF Pass / -5sec Pass / +5sec Pass /
2013 02 06 06 44 04 | 064500 | écart: 1 Sec--> Etat ON/OFF Pass / -5sec Pass / +5sec Pass /
2013 02 06 06 44 10 | 064506 | écart: 1 Sec--> Etat ON/OFF Pass / -5sec Pass / +5sec Pass /
2013 02 06 06 59 05 | 070000 | écart: 2 Sec--> Etat ON/OFF Pass / -5sec Pass / +5sec Pass /
2013 02 06 07 59 05 | 080000 | écart: 2 Sec--> Etat ON/OFF Pass / -5sec Pass / +5sec Pass /
2013 02 06 09 29 04 | 093000 | écart: 1 Sec--> Etat ON/OFF Pass / -5sec Pass / +5sec Pass /
2013 02 06 09 44 04 | 094500 | écart: 1 Sec--> Etat ON/OFF Pass / -5sec Pass / +5sec Pass /
2013 02 06 10 44 04 | 104500 | écart: 1 Sec--> Etat ON/OFF Pass / -5sec Pass / +5sec Pass /
2013 02 06 10 44 10 | 104506 | écart: 1 Sec--> Etat ON/OFF Pass / -5sec Pass / +5sec Pass /
2013 02 06 10 59 05 | 110000 | écart: 2 Sec--> Etat ON/OFF Pass / -5sec Pass / +5sec Pass /
2013 02 06 11 59 05 | 120000 | écart: 2 Sec--> Etat ON/OFF Pass / -5sec Pass / +5sec Pass /
2013 02 06 13 29 04 | 133000 | écart: 1 Sec--> Etat ON/OFF Pass / -5sec Pass / +5sec Pass /
2013 02 06 13 44 04 | 134500 | écart: 1 Sec--> Etat ON/OFF Pass / -5sec Pass / +5sec Pass /
2013 02 06 14 44 04 | 144500 | écart: 1 Sec--> Etat ON/OFF Pass / -5sec Pass / +5sec Pass /
2013 02 06 14 44 10 | 144506 | écart: 1 Sec--> Etat ON/OFF Pass / -5sec Pass / +5sec Pass /
2013 02 06 14 59 06 | 150000 | écart: 3 Sec--> Etat ON/OFF Pass / -5sec Pass / +5sec Pass /
2013 02 06 15 59 05 | 160000 | écart: 2 Sec--> Etat ON/OFF Pass / -5sec Pass / +5sec Pass /
2013 02 06 17 29 05 | 173000 | écart: 2 Sec--> Etat ON/OFF Pass / -5sec Pass / +5sec Pass /
2013 02 06 17 44 05 | 174500 | écart: 2 Sec--> Etat ON/OFF Pass / -5sec Pass / +5sec Pass /
2013 02 06 18 44 05 | 184500 | écart: 2 Sec--> Etat ON/OFF Pass / -5sec Pass / +5sec Pass /
2013 02 06 18 44 10 | 184506 | écart: 1 Sec--> Etat ON/OFF Pass / -5sec Pass / +5sec Pass /
2013 02 06 18 59 05 | 190000 | écart: 2 Sec--> Etat ON/OFF Pass / -5sec Pass / +5sec Pass /
2013 02 06 19 59 06 | 200000 | écart: 3 Sec--> Etat ON/OFF Pass / -5sec Pass / +5sec Pass /
2013 02 06 21 29 05 | 213000 | écart: 2 Sec--> Etat ON/OFF Pass / -5sec Pass / +5sec Pass /
2013 02 06 21 44 05 | 214500 | écart: 2 Sec--> Etat ON/OFF Pass / -5sec Pass / +5sec Pass /
2013 02 06 22 44 05 | 224500 | écart: 2 Sec--> Etat ON/OFF Pass / -5sec Pass / +5sec Pass /
2013 02 06 22 44 11 | 224506 | écart: 2 Sec--> Etat ON/OFF Pass / -5sec Pass / +5sec Pass /
2013 02 07 01 29 06 | 013000 | écart: 1 Sec--> Etat ON/OFF Pass / -5sec Pass / +5sec Pass /
2013 02 07 01 44 05 | 014500 | écart: 0 Sec--> Etat ON/OFF Pass / -5sec Pass / +5sec Pass /
2013 02 07 02 44 05 | 024500 | écart: 0 Sec--> Etat ON/OFF Pass / -5sec Pass / +5sec Pass /
2013 02 07 02 44 11 | 024506 | écart: 0 Sec--> Etat ON/OFF Pass / -5sec Pass / +5sec Pass /
2013 02 07 02 59 06 | 030000 | écart: 1 Sec--> Etat ON/OFF Pass / -5sec Pass / +5sec Pass /
2013 02 07 03 59 07 | 040000 | écart: 2 Sec--> Etat ON/OFF Pass / -5sec Pass / +5sec Pass /
2013 02 07 05 29 05 | 053000 | écart: 0 Sec--> Etat ON/OFF Pass / -5sec Pass / +5sec Pass /
2013 02 07 05 44 06 | 054500 | écart: 1 Sec--> Etat ON/OFF Pass / -5sec Pass / +5sec Pass /
2013 02 07 06 44 06 | 064500 | écart: 1 Sec--> Etat ON/OFF Pass / -5sec Pass / +5sec Pass /
2013 02 07 06 44 11 | 064506 | écart: 0 Sec--> Etat ON/OFF Pass / -5sec Pass / +5sec Pass /
2013 02 07 06 59 07 | 070000 | écart: 2 Sec--> Etat ON/OFF Pass / -5sec Pass / +5sec Pass /
2013 02 07 07 59 07 | 080000 | écart: 2 Sec--> Etat ON/OFF Pass / -5sec Pass / +5sec Pass /
2013 02 07 09 29 06 | 093000 | écart: 1 Sec--> Etat ON/OFF Pass / -5sec Pass / +5sec Pass /
2013 02 07 09 44 06 | 094500 | écart: 1 Sec--> Etat ON/OFF Pass / -5sec Pass / +5sec Pass /
2013 02 07 10 44 06 | 104500 | écart: 1 Sec--> Etat ON/OFF Pass / -5sec Pass / +5sec Pass /
2013 02 07 10 44 12 | 104506 | écart: 1 Sec--> Etat ON/OFF Pass / -5sec Pass / +5sec Pass /
2013 02 07 10 59 07 | 110000 | écart: 2 Sec--> Etat ON/OFF Pass / -5sec Pass / +5sec Pass /
2013 02 07 11 59 07 | 120000 | écart: 2 Sec--> Etat ON/OFF Pass / -5sec Pass / +5sec Pass /
2013 02 07 13 29 07 | 133000 | écart: 2 Sec--> Etat ON/OFF Pass / -5sec Pass / +5sec Pass /
2013 02 07 13 44 06 | 134500 | écart: 1 Sec--> Etat ON/OFF Pass / -5sec Pass / +5sec Pass /
2013 02 07 14 44 07 | 144500 | écart: 2 Sec--> Etat ON/OFF Pass / -5sec Pass / +5sec Pass /

Cultibox | CRE | CBX 1_13_0013 | - | 39 / 39
Type | Réf. document | Indice | Page

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

2013 02 07 14 44 12 | 144506 | écart: 1 Sec--> Etat ON/OFF Pass / -5sec Pass / +5sec Pass /
2013 02 07 14 59 08 | 150000 | écart: 3 Sec--> Etat ON/OFF Pass / -5sec Pass / +5sec Pass /
2013 02 07 15 59 08 | 160000 | écart: 3 Sec--> Etat ON/OFF Pass / -5sec Pass / +5sec Pass /
2013 02 07 17 29 07 | 173000 | écart: 2 Sec--> Etat ON/OFF Pass / -5sec Pass / +5sec Pass /
2013 02 07 17 44 07 | 174500 | écart: 2 Sec--> Etat ON/OFF Pass / -5sec Pass / +5sec Pass /
2013 02 07 18 44 08 | 184500 | écart: 3 Sec--> Etat ON/OFF Pass / -5sec Pass / +5sec Pass /
2013 02 07 18 44 13 | 184506 | écart: 2 Sec--> Etat ON/OFF Pass / -5sec Pass / +5sec Pass /
2013 02 07 18 59 08 | 190000 | écart: 3 Sec--> Etat ON/OFF Pass / -5sec Pass / +5sec Pass /
2013 02 07 19 59 08 | 200000 | écart: 3 Sec--> Etat ON/OFF Pass / -5sec Pass / +5sec Pass /
2013 02 07 21 29 08 | 213000 | écart: 3 Sec--> Etat ON/OFF Pass / -5sec Pass / +5sec Pass /
2013 02 07 21 44 07 | 214500 | écart: 2 Sec--> Etat ON/OFF Pass / -5sec Pass / +5sec Pass /
2013 02 07 22 44 07 | 224500 | écart: 2 Sec--> Etat ON/OFF Pass / -5sec Pass / +5sec Pass /
2013 02 07 22 44 13 | 224506 | écart: 2 Sec--> Etat ON/OFF Pass / -5sec Pass / +5sec Pass /

Essai complémentaire suite aux résultats constatés sur la prise n°7 :
Sat Mar 30 17:51:10 CET 2013 ::log26 ::listProg7
Date | Heure Cultibox Heure PC
2013 03 28 01 29 08 | 013000 | écart: 0 Sec--> Etat ON/OFF Pass / -5sec Pass / +5sec Pass /
2013 03 28 01 44 08 | 014500 | écart: 0 Sec--> Etat ON/OFF Pass / -5sec Pass / +5sec Pass /
2013 03 28 02 44 08 | 024500 | écart: 0 Sec--> Etat ON/OFF Pass / -5sec Pass / +5sec Pass /
2013 03 28 02 44 14 | 024506 | écart: 0 Sec--> Etat ON/OFF Pass / -5sec Pass / +5sec Pass /
2013 03 28 02 59 08 | 030000 | écart: 0 Sec--> Etat ON/OFF Pass / -5sec Pass / +5sec Pass /
2013 03 28 03 59 08 | 040000 | écart: 0 Sec--> Etat ON/OFF Pass / -5sec Pass / +5sec Pass /
2013 03 28 05 29 09 | 053000 | écart: 1 Sec--> Etat ON/OFF Pass / -5sec Pass / +5sec Pass /
2013 03 28 05 44 09 | 054500 | écart: 1 Sec--> Etat ON/OFF Pass / -5sec Pass / +5sec Pass /
2013 03 28 06 44 09 | 064500 | écart: 1 Sec--> Etat ON/OFF Pass / -5sec Pass / +5sec Pass /
2013 03 28 06 44 15 | 064506 | écart: 1 Sec--> Etat ON/OFF Pass / -5sec Pass / +5sec Pass /
2013 03 28 06 59 08 | 070000 | écart: 0 Sec--> Etat ON/OFF Pass / -5sec Pass / +5sec Pass /
2013 03 28 07 59 09 | 080000 | écart: 1 Sec--> Etat ON/OFF Pass / -5sec Pass / +5sec Pass /
2013 03 28 09 29 09 | 093000 | écart: 1 Sec--> Etat ON/OFF Pass / -5sec Pass / +5sec Pass /
2013 03 28 09 44 09 | 094500 | écart: 1 Sec--> Etat ON/OFF Pass / -5sec Pass / +5sec Pass /
2013 03 28 10 44 09 | 104500 | écart: 1 Sec--> Etat ON/OFF Pass / -5sec Pass / +5sec Pass /
2013 03 28 10 44 09 | 104506 | écart: 1 Sec--> Etat ON/OFF Pass / -5sec Pass / +5sec Pass /
2013 03 28 10 59 09 | 110000 | écart: 1 Sec--> Etat ON/OFF Pass / -5sec Pass / +5sec Pass /
2013 03 28 11 59 10 | 120000 | écart: 2 Sec--> Etat ON/OFF Pass / -5sec Pass / +5sec Pass /
2013 03 28 13 29 09 | 133000 | écart: 1 Sec--> Etat ON/OFF Pass / -5sec Pass / +5sec Pass /
2013 03 28 13 44 09 | 134500 | écart: 1 Sec--> Etat ON/OFF Pass / -5sec Pass / +5sec Pass /
2013 03 28 14 44 10 | 144500 | écart: 2 Sec--> Etat ON/OFF Pass / -5sec Pass / +5sec Pass /
2013 03 28 14 44 09 | 144506 | écart: 1 Sec--> Etat ON/OFF Pass / -5sec Pass / +5sec Pass /
2013 03 28 14 59 09 | 150000 | écart: 1 Sec--> Etat ON/OFF Pass / -5sec Pass / +5sec Pass /
2013 03 28 15 59 09 | 160000 | écart: 2 Sec--> Etat ON/OFF Pass / -5sec Pass / +5sec Pass /
2013 03 28 17 29 10 | 173000 | écart: 2 Sec--> Etat ON/OFF Pass / -5sec Pass / +5sec Pass /
2013 03 28 17 44 09 | 174500 | écart: 1 Sec--> Etat ON/OFF Pass / -5sec Pass / +5sec Pass /
2013 03 28 18 44 10 | 184500 | écart: 2 Sec--> Etat ON/OFF Pass / -5sec Pass / +5sec Pass /
2013 03 28 18 44 16 | 184506 | écart: 2 Sec--> Etat ON/OFF Pass / -5sec Pass / +5sec Pass /
2013 03 28 18 59 10 | 190000 | écart: 2 Sec--> Etat ON/OFF Pass / -5sec Pass / +5sec Pass /
2013 03 28 19 59 09 | 200000 | écart: 1 Sec--> Etat ON/OFF Pass / -5sec Pass / +5sec Pass /
2013 03 28 21 29 10 | 213000 | écart: 2 Sec--> Etat ON/OFF Pass / -5sec Pass / +5sec Pass /
2013 03 28 21 44 10 | 214500 | écart: 2 Sec--> Etat ON/OFF Pass / -5sec Pass / +5sec Pass /
2013 03 28 22 44 10 | 224500 | écart: 2 Sec--> Etat ON/OFF Pass / -5sec Pass / +5sec Pass /
2013 03 28 22 44 10 | 224506 | écart: 2 Sec--> Etat ON/OFF Pass / -5sec Pass / +5sec Pass /
