cultibox/cultibox/02_documentation/05_verif/CBX_1_13_0008_PTS_electronic_alarm_-.pdf

Cultibox | CRE | CBX 1_13_0008 | - | 1 / 10
Type | Réf. document | Indice | Page

DOCUMENT GREEN BOX : Copyright © 20012-2013 GREEN BOX. Tous droits réservés. Ce document et l’information qu’il contient sont la propriété exclusive de GREEN BOX. Ils ne peuvent être reproduits ou divulgués sous quelque forme que ce soit sans l’accord préalable écrit de GREEN BOX.
GREEN BOX PROPRIETARY INFORMATION: Copyright © 2012-2013 by GREEN BOX. All rights reserved. This document and the information contained therein are GREEN BOX’s exclusive property. Any copy and/or disclosure thereof in any form whatsoever are subject to GREEN BOX’s prior written consent.

# PTS_ELECTRONIC_ALARM

### Conclusion:

### Click here

Mot clé | Conclusion | Remarques
PTS_electronic_alarm | PASS | NA
VERSION | DATE | AUTEUR | DESCRIPTION DES MODIFICATIONS
- | 22/03/13 | P Puvilland | Création

Cultibox | CRE | CBX 1_13_0008 | - | 2 / 10
Type | Réf. document | Indice | Page

DOCUMENT GREEN BOX : Copyright © 20012-2013 GREEN BOX. Tous droits réservés. Ce document et l’information qu’il contient sont la propriété exclusive de GREEN BOX. Ils ne peuvent être reproduits ou divulgués sous quelque forme que ce

# 1 SOMMAIRE

1 | SOMMAIRE | 2
2 | INTRODUCTION | 3
2.1 | OBJECTIF | 3
2.2 | SPECIFICATION DU MOT CLE | 3
2.3 | ISSUES ASSOCIEES | 3
2.4 | VERSION DE LA PTS | 3
2.5 | CULTIBOX | 4
2.6 | INFORMATION CONCERNANT L’ESSAI | 4
3 | DESCRIPTION DE L’ESSAI | 5
3.1 | INTRODUCTION | 5
3.2 | DESCRIPTION GENERALE DE L’ESSAI | 6
4 | ESSAI | 7
4.1 | MESURE INITIALE | 7
4.2 | MISE EN PLACE | 7
4.3 | SEUILS TESTES | 7
5 | CONCLUSION | 10

Cultibox | CRE | CBX 1_13_0008 | - | 3 / 10
Type | Réf. document | Indice | Page

DOCUMENT GREEN BOX : Copyright © 20012-2013 GREEN BOX. Tous droits réservés. Ce document et l’information qu’il contient sont la propriété exclusive de GREEN BOX. Ils ne peuvent être reproduits ou divulgués sous quelque forme que ce

# 2 INTRODUCTION

# 2.1 Objectif

L’objectif de ce rapport est de statuer sur le mot clé PTS_electronic_alarm. Ce mot clé indique un processus d'arrêt des prises sous certaines conditions.

# 2.2 Spécification du mot clé

## Les spécifications du mot clé sont :

Mot clé | Minimum | Typique | Maximum | Unité

## PTS_electronic_alarm

## Ce mots clé couvre une analyse des risques: cf cbx_2_13_0001

# 2.3 Issues associées

## L’issue associée à ce mot clé est :

Nom de l’issue | numéro | Type
PTS_electronic_alarm | 413 | PTS
Gestion de mauvaises données des capteurs | 427 | Amélioration

## L’ensemble des issues peut être lu à l’adresse suivante : http://code.google.com/p/cultibox/issues

# 2.4 Version de la PTS

## Pour la validation du mot clé PTS_electronic_alarm, on considère la révision suivante :

PTS Révision | Date
Révision 648 | 22/03/2013

Cultibox | CRE | CBX 1_13_0008 | - | 4 / 10
Type | Réf. document | Indice | Page

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

# 2.5 Cultibox

Le tableau ci-dessous donne le numéro de la Cultibox utilisé pour ce test.

Matériel | Numéro d’identification
Cultibox | ID : 00001

# 2.6 Information concernant l’essai

Le tableau ci-dessous récapitule différentes informations concernant l’essai.

Information | Valeur
Client | Société Green Box SAS 8 Rue Thiers 38000 GRENOBLE
Laboratoire d’essai | Société Green Box SAS 8 Rue Thiers 38000 GRENOBLE
Identification du rapport d’essai | CBX 1_13_0008
Dates des essais | 22/03/2013
Type d’essai | Vérification du processus d'arrêt des prises sous certaines conditions
Objet de l’essai | Essai de validation de spécification
Norme d’essai, édition | N.A
Description du spécimen d’essai | Cultibox ID : 00001
Gestionnaire de l’essai | Philippe Puvilland

Cultibox | CRE | CBX 1_13_0008 | - | 5 / 10
Type | Réf. document | Indice | Page

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

# 3 DESCRIPTION DE L’ESSAI

# 3.1 Introduction

## Ce test consiste en une procédure d’essai pour vérifier le fonctionnement des processus d'arrêt des prises sous certaines conditions Cette fonctionnalité d'Alarme est par défaut désactivé. L'utilisateur peut, par l'intermédiaire du logiciel, paramétrer cette fonction des manières suivantes:

## - Paramètre de mesure sur lequel le seuil de déclenchement sera fixé:

## - Consigne du seuil :

ou

## - le "sens" de détection de l'alarme

## "Il est a noté que l'alarme coupe toutes les prises en cas de déclenchement du seuil configuré"

Cultibox | CRE | CBX 1_13_0008 | - | 6 / 10
Type | Réf. document | Indice | Page

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

# 3.2 Description générale de l’essai

## Nous avons pris en compte tous les cas de figure possible au niveau du paramétrage de l'Alarme afin de vérifier de manière complète son bon

fonctionnement.

Situation ou évolution de la consigne | Type de passage du seuil
Passage de la consigne au-dessus du seuil | Au-dessus du seuil

## Au-dessous du seuil Consigne déjà au dessus du seuil au branchement

## Au-dessus du seuil Au-dessous du seuil

Ceci donne donc un total 4 essais a réaliser par seuil testé.

Cultibox | CRE | CBX 1_13_0008 | - | 7 / 10
Type | Réf. document | Indice | Page

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

# 4 ESSAI

# 4.1 Mesure initiale

## La Cultibox est totalement fonctionnelle (Vérification de la lecture des capteurs

et du pilotage des prises) sur les plages de mesures de capteur.

# 4.2 Mise en place

## La Cultibox est branchée avec un capteur de température/humidité. Des moyens "artificiels" sont utilisés afin d'obtenir les conditions climatiques souhaitées pour tester le fonctionnement de l'alarme

# 4.3 seuils testés

## Il est décidé de couvrir une plage de seuil de température et d'humidité afin de s'assurer du bon fonctionnement de l'alarme

## Les seuils testés sont :

## Température

1°C
25°C
50°C

## Humidité

10%
50%
90%

## La totalité des essais effectués représentent donc: 6 seuils x 4 essais = 24 déclenchement de l'alarme

## Suite au déclenchement de l'alarme, la Cultibox est réinitialisée afin de

vérifier son fonctionnement.

Cultibox | CRE | CBX 1_13_0008 | - | 8 / 10
Type | Réf. document | Indice | Page

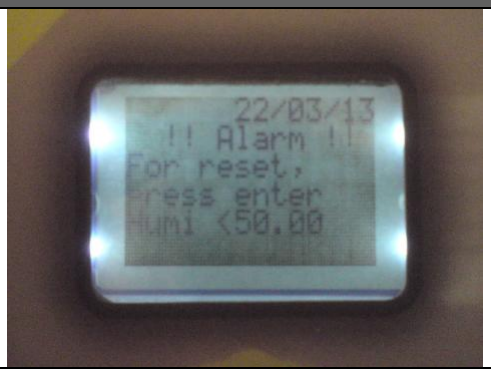
[picture p53: figure]
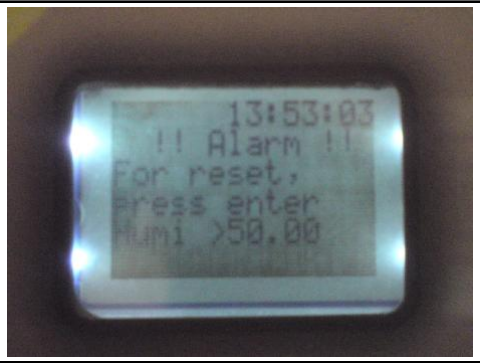
[picture p54: figure]
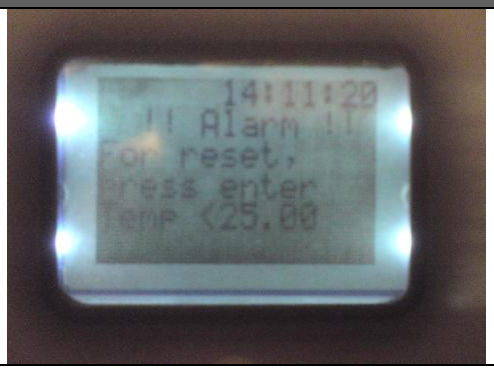
[picture p55: figure]
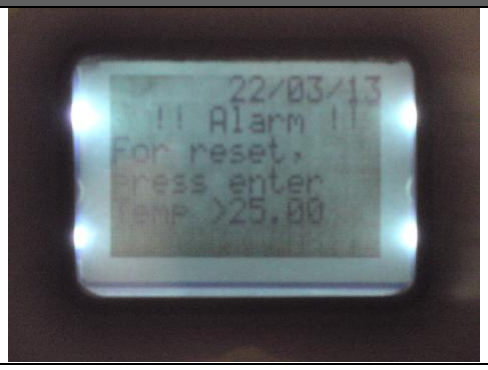
[picture p56: figure]
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

## 4.3.1 Photos

## Ci-dessous, exemples de photos "types" de déclenchement d'alarme :

Passage au-dessus du seuil de 50% Hr | Passage au-dessous du seuil de 50% Hr
Passage au-dessus du seuil de 25°C | Passage au-dessous du seuil de 25°C

Cultibox | CRE | CBX 1_13_0008 | - | 9 / 10
Type | Réf. document | Indice | Page

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

## 4.3.2 Analyse fonctionnelle

## . Les Vérifications fonctionnelles effectuées après chaque essai sont: - Reboot de la Cultibox - Contrôle de heure/date - Contrôle des informations du capteur - Pilotage des 10 prises

## 4.3.3 Conclusion des analyses

## Ces tests montrent que les processus de fonctionnement décrit pour la fonction

d'alarme sont pleinement respectés.

Cultibox | CRE | CBX 1_13_0008 | - | 10 / 10
Type | Réf. document | Indice | Page

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

# 5 CONCLUSION

## Pour améliorer les précautions de sécurité, une fonction d'Alarme est

proposée à l'utilisateur.

## Les tests effectués, montrent que les processus de fonctionnement décrit pour

la fonction d'alarme sont pleinement respectés.

## Cependant, la fonction de l'alarme ne couvre pas le risque d'un retour de valeur de capteur erronée ou hors plage. Ce risque est pris en compte dans l’analyse

de risque (cbx_2_13_0001) est fera l'objet d'un essai ultérieur de vérification.

Mot clé | Conclusion | Remarques
PTS_electronic_alarm | PASS | NA
