cultibox/cultibox/02_documentation/05_verif/CBX_1_13_0005_PTS_electronic_SDcard_-.pdf

Cultibox | CRE | CBX 1_13_0005 | - | 1 / 7
Type | Réf. document | Indice | Page

DOCUMENT GREEN BOX : Copyright © 20012-2013 GREEN BOX. Tous droits réservés. Ce document et l’information qu’il contient sont la propriété exclusive de GREEN BOX. Ils ne peuvent être reproduits ou divulgués sous quelque forme que ce soit sans l’accord préalable écrit de GREEN BOX.
GREEN BOX PROPRIETARY INFORMATION: Copyright © 2012-2013 by GREEN BOX. All rights reserved. This document and the information contained therein are GREEN BOX’s exclusive property. Any copy and/or disclosure thereof in any form whatsoever are subject to GREEN BOX’s prior written consent.

# PTS_ELECTRONIC_SDCARD

### Conclusion:

### Click here

Mot clé | Conclusion | Remarques
PTS_electronic_SDcard | PASS | Validé par design
VERSION | DATE | AUTEUR | DESCRIPTION DES MODIFICATIONS
- | 18/03/13 | A Rico | Création

Cultibox | CRE | CBX 1_13_0005 | - | 2 / 7
Type | Réf. document | Indice | Page

DOCUMENT GREEN BOX : Copyright © 20012-2013 GREEN BOX. Tous droits réservés. Ce document et l’information qu’il contient sont la propriété exclusive de GREEN BOX. Ils ne peuvent être reproduits ou divulgués sous quelque forme que ce

# 1 SOMMAIRE

1 | SOMMAIRE | 2
2 | INTRODUCTION | 3
2.1 | OBJECTIF | 3
2.2 | SPECIFICATION DU MOT CLE | 3
2.3 | ISSUES ASSOCIEES | 3
2.4 | VERSION DE LA PTS | 4
3 | RESULTATS | 5
3.1 | PTS_ELECTRONIC_SDCARD | 5
4 | CONCLUSION | 6
5 | ANNEXE | 7
5.1 | DATASHEET | 7

Cultibox | CRE | CBX 1_13_0005 | - | 3 / 7
Type | Réf. document | Indice | Page

DOCUMENT GREEN BOX : Copyright © 20012-2013 GREEN BOX. Tous droits réservés. Ce document et l’information qu’il contient sont la propriété exclusive de GREEN BOX. Ils ne peuvent être reproduits ou divulgués sous quelque forme que ce

# 2 INTRODUCTION

# 2.1 Objectif

L’objectif de ce rapport est de statuer sur le mot clé PTS_electronic_Sdcard.

Ce mot clé décrit les caractéristiques de la carte SD.

# 2.2 Spécification du mot clé

## Les spécifications du mot clé sont :

Mot clé | Minimum | Typique | Maximum | Unité
PTS_electronic_SDcard | 1 | 2 | 2 | Go

# 2.3 Issues associées

## L’issue associée à ce mot clé est :

Nom de l’issue | numéro | Type
PTS_mechanic_RJ12_lengtht | 412 | PTS

## L’ensemble des issues peut être lu à l’adresse suivante : http://code.google.com/p/cultibox/issues

Cultibox | CRE | CBX 1_13_0005 | - | 4 / 7
Type | Réf. document | Indice | Page

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

# 2.4 Version de la PTS

## Pour la validation du mot clé PTS_electronic_SDcard, on considère la révision suivante :

PTS Révision | Date
Révision 585 | 18/03/2013

Cultibox | CRE | CBX 1_13_0005 | - | 5 / 7
Type | Réf. document | Indice | Page

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

# 3 RESULTATS

# 3.1 PTS_electronic_SDcard

## La taille de la carte SD est validée par design. Le produit choisit est le suivant :

Fabricant | Transcend
Référence fabricant | TS2GSDC
Espace mémoire | 2 Go
Caractéristiques | Carte SD

La datasheet de la carte est disponible en annexe.

Cultibox | CRE | CBX 1_13_0005 | - | 6 / 7
Type | Réf. document | Indice | Page

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

# 4 CONCLUSION

## La taille de la carte est conforme :

Mot clé | Conclusion | Remarques
PTS_mechanic_RJ12_lengtht | PASS | Validé par design

Cultibox | CRE | CBX 1_13_0005 | - | 7 / 7
Type | Réf. document | Indice | Page

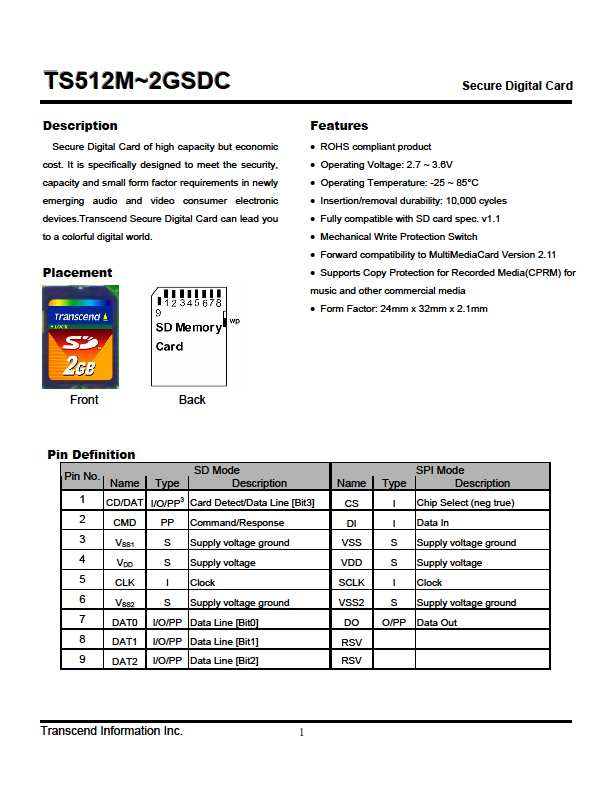
[picture p57: figure]
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

# 5 ANNEXE

# 5.1 Datasheet
