cultibox/cultibox/02_documentation/05_verif/CBX_1_13_0004_PTS_mechanic_cable_length_-.pdf

Cultibox | CRE | CBX 1_13_0004 | - | 1 / 8
Type | Réf. document | Indice | Page

DOCUMENT GREEN BOX : Copyright © 20012-2013 GREEN BOX. Tous droits réservés. Ce document et l’information qu’il contient sont la propriété exclusive de GREEN BOX. Ils ne peuvent être reproduits ou divulgués sous quelque forme que ce soit sans l’accord préalable écrit de GREEN BOX.
GREEN BOX PROPRIETARY INFORMATION: Copyright © 2012-2013 by GREEN BOX. All rights reserved. This document and the information contained therein are GREEN BOX’s exclusive property. Any copy and/or disclosure thereof in any form whatsoever are subject to GREEN BOX’s prior written consent.

# PTS_MECHANIC_RJ12_LENGTH PTS_MECHANIC_USB_LENGTH

### Conclusion:

### Click here

Mot clé | Conclusion | Remarques
PTS_mechanic_RJ12_lengtht | PASS | Validé par design
PTS_mechanic_USB_lengtht | PASS | Validé par design
VERSION | DATE | AUTEUR | DESCRIPTION DES MODIFICATIONS
- | 18/03/13 | A Rico | Création

Cultibox | CRE | CBX 1_13_0004 | - | 2 / 8
Type | Réf. document | Indice | Page

DOCUMENT GREEN BOX : Copyright © 20012-2013 GREEN BOX. Tous droits réservés. Ce document et l’information qu’il contient sont la propriété exclusive de GREEN BOX. Ils ne peuvent être reproduits ou divulgués sous quelque forme que ce

# 1 SOMMAIRE

1 | SOMMAIRE | 2
2 | INTRODUCTION | 3
2.1 | OBJECTIF | 3
2.2 | SPECIFICATION DU MOT CLE | 3
2.3 | ISSUES ASSOCIEES | 3
2.4 | VERSION DE LA PTS | 4
3 | RESULTATS | 5
3.1 | PTS_MECHANIC_RJ12_LENGTH | 5
3.2 | PTS_MECHANIC_USB_LENGTH | 5
4 | CONCLUSION | 6
5 | ANNEXE | 7
5.1 | DATASHEET CÂBLE RJ12 | 7
5.2 | DATASHEET CÂBLE USB | 8

Cultibox | CRE | CBX 1_13_0004 | - | 3 / 8
Type | Réf. document | Indice | Page

DOCUMENT GREEN BOX : Copyright © 20012-2013 GREEN BOX. Tous droits réservés. Ce document et l’information qu’il contient sont la propriété exclusive de GREEN BOX. Ils ne peuvent être reproduits ou divulgués sous quelque forme que ce

# 2 INTRODUCTION

# 2.1 Objectif

## L’objectif de ce rapport est de statuer sur les mots clés PTS_mechanic_RJ12_length

et PTS_mechanic_USB_length.

Ces mots clés décrivent la taille des câbles.

# 2.2 Spécification du mot clé

## Les spécifications du mot clé sont :

Mot clé | Minimum | Typique | Maximum | Unité
PTS_mechanic_RJ12_lengtht | 3 | 3 | | m
PTS_mechanic_USB_lengtht | 1 | 1.5 | | m

# 2.3 Issues associées

## Les issues associées à ce mot clé sont :

Nom de l’issue | numéro | Type
PTS_mechanic_RJ12_lengtht | 410 | PTS
PTS_mechanic_USB_lengtht | 411 | PTS

## L’ensemble des issues peut être lu à l’adresse suivante : http://code.google.com/p/cultibox/issues

Cultibox | CRE | CBX 1_13_0004 | - | 4 / 8
Type | Réf. document | Indice | Page

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

# 2.4 Version de la PTS

## Pour la validation des mots clés PTS_mechanic_RJ12_length et PTS_mechanic_USB_length, on considère la révision suivante :

PTS Révision | Date
Révision 580 | 18/03/2013

Cultibox | CRE | CBX 1_13_0004 | - | 5 / 8
Type | Réf. document | Indice | Page

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

# 3 RESULTATS

# 3.1 PTS_mechanic_RJ12_length

## La longueur du câble est validée par design. Le produit choisit est le suivant :

Fabricant | Pro-signal
Référence fabricant | 133-5147
Longueur du câble | 3 m
Caractéristiques | RJ11 6P6C

La datasheet du câble est disponible en annexe.

# 3.2 PTS_mechanic_USB_length

## La longueur du câble est validée par design. Le produit choisit est le suivant :

Fabricant | Pro-signal
Référence fabricant | 532490
Longueur du câble | 1.5 m
Caractéristiques | USB Type A Male Type mini B Male

La datasheet du câble est disponible en annexe.

Cultibox | CRE | CBX 1_13_0004 | - | 6 / 8
Type | Réf. document | Indice | Page

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

# 4 CONCLUSION

## La longueur des câbles est conforme :

Mot clé | Conclusion | Remarques
PTS_mechanic_RJ12_lengtht | PASS | Validé par design
PTS_mechanic_USB_lengtht | PASS | Validé par design

Cultibox | CRE | CBX 1_13_0004 | - | 7 / 8
Type | Réf. document | Indice | Page

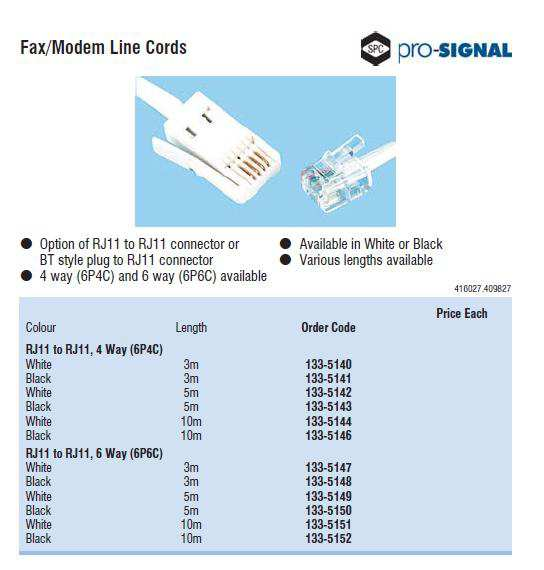
[picture p58: figure]
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

# 5 ANNEXE

# 5.1 Datasheet câble RJ12

Cultibox | CRE | CBX 1_13_0004 | - | 8 / 8
Type | Réf. document | Indice | Page

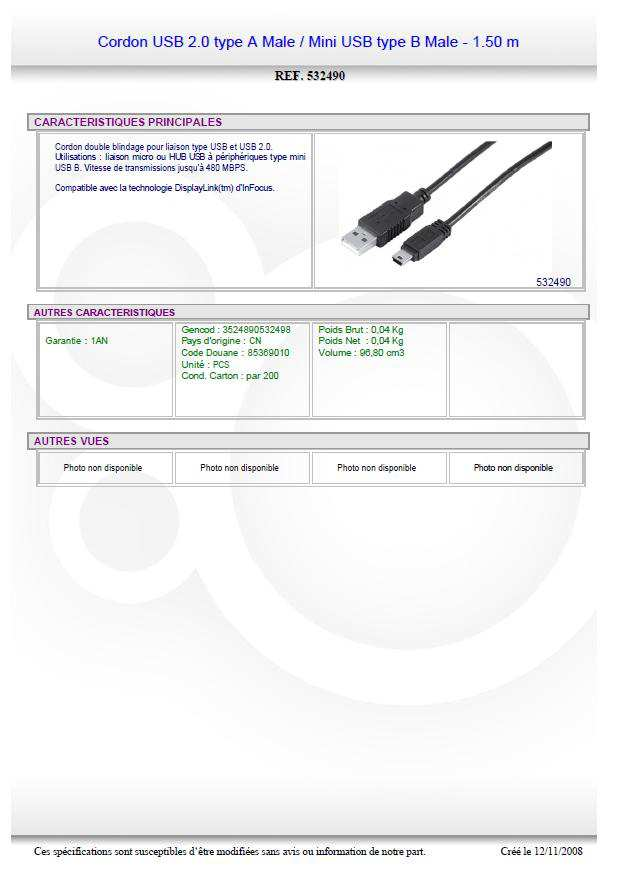
[picture p59: figure]
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

# 5.2 Datasheet câble USB
