cultibox/cultibox/02_documentation/03_admindoc/diagrammes/software/diag_soft_cultibox.jpeg

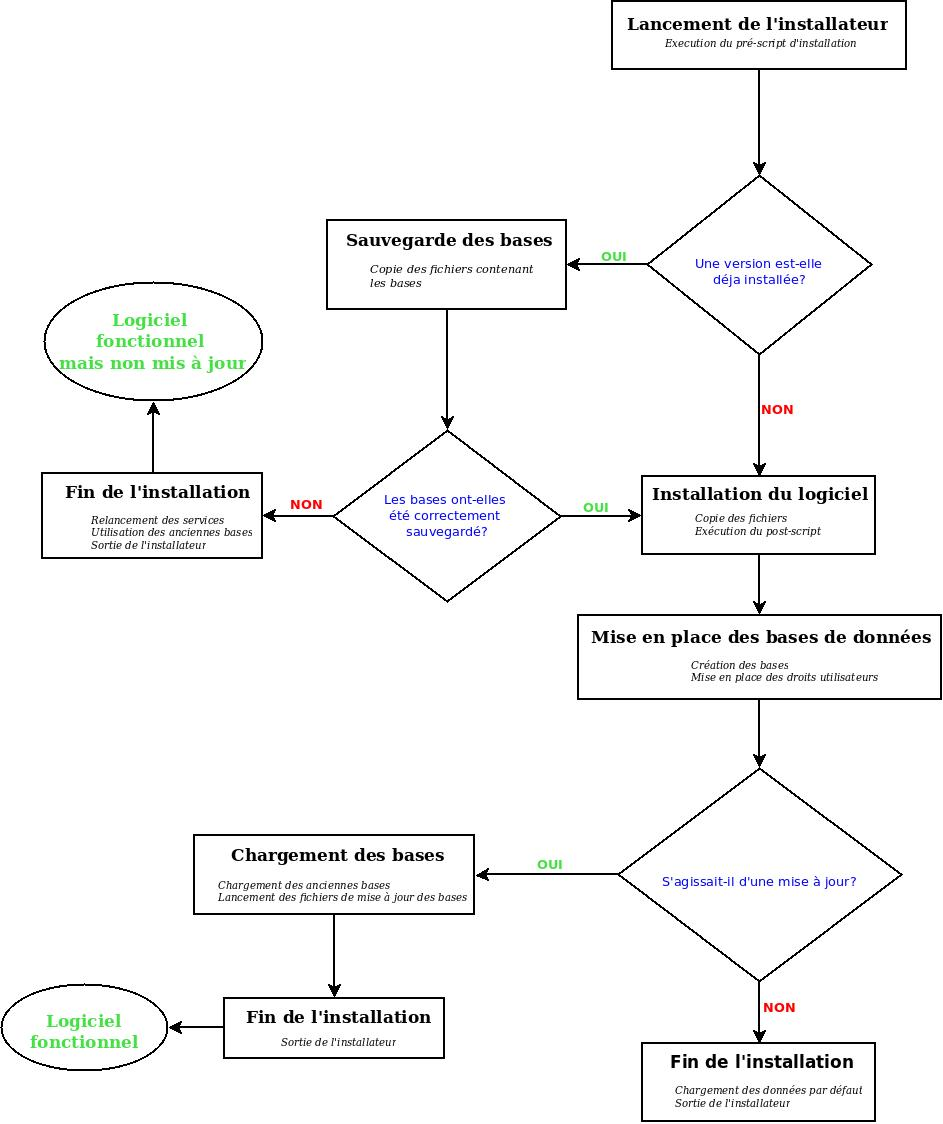
02_documentation/03_admindoc/diagrammes/software/diag_soft_cultibox.jpeg
