cultibox/cultibox/03_mecanique/main_assemblage.stp

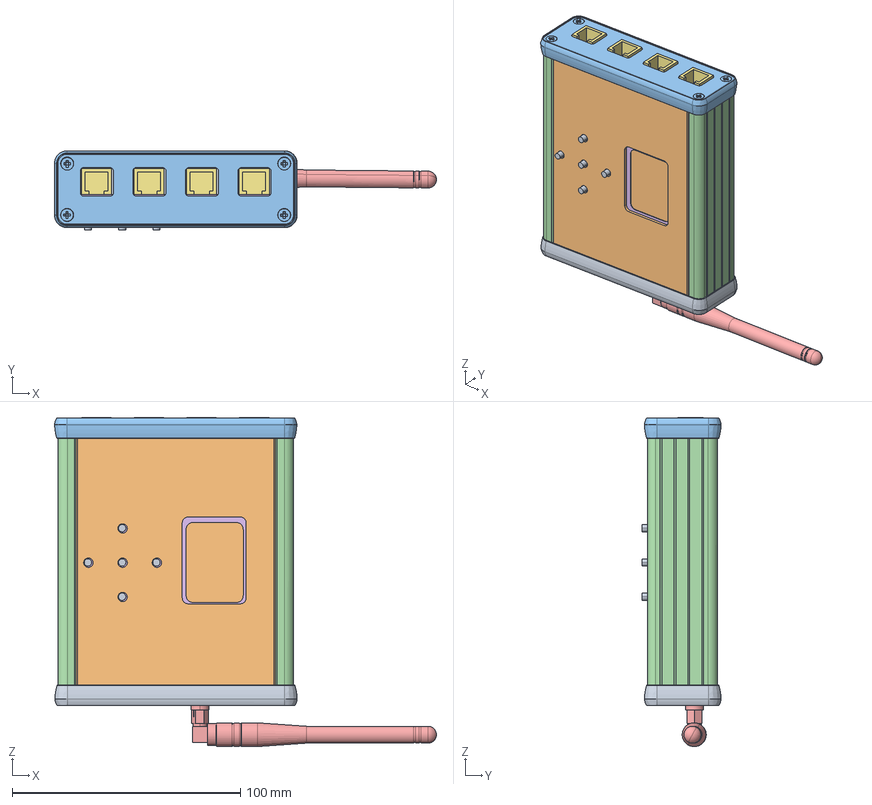
[picture p64: CAD file, 2012-03-29, last stored version]
03_mecanique/main_assemblage.stp
167.2 x 34.7 x 144.1 mm
