cultibox/cultibox/01_software/01_install/02_windows/Output/README

Directory containing Output from package generation scripts
