cultibox/cultibox/01_software/01_install/03_linux/repository_amd64/binary/README

Directory needed to generate repository files for cultibox-amd64
