cultibox/cultibox/01_software/01_install/05_cultipi/repository/binary/README

Directory needed to generate repository files for cultipi
