cultibox/cultibox/02_documentation/01_installation/01_windows/installation_manuelle_cultibox.txt

1) Installer XAMPP

2) Modification du mot de passe root pour mysql:

c:\xampp\mysql\bin\mysqladmin.exe -u root -h localhost password cultibox

3) copier les fichiers de conf:

config.inc.php dans C:\xampp\phpMyAdmin
php.ini dans C:\xampp\php
httpd.conf dans C:\xampp\apache\conf\

4) Créer les bases a partir des 3 scripts MySQL:

c:\xampp\mysql\bin\mysql.exe -u root -h localhost -pcultibox < user_cultibox.sql
c:\xampp\mysql\bin\mysql.exe -u root -h localhost -pcultibox < joomla.sql
c:\xampp\mysql\bin\mysql.exe -u root -h localhost -pcultibox < cultibox.sql

5) Copier le repertoire joomla dans c:\xampp\htdocs

6) Redemarrer / demarrer les services
