cultibox/cultibox/02_documentation/01_installation/02_linux/installation_manuelle_xampp.txt

I) Installation de XAMPP sous linux
-----------------------------------

* Récupération du logiciel:
	http://sourceforge.net/projects/xampp/files

* Installation dans le répertoire /opt:
	sudo tar xvfz xampp-linux-1.7.7.tar.gz -C /opt 

* Pour faire tourner XAMPP sur une version 64-bits, installer le package de compatibilité 32bits (exemple pour Ubuntu):
	sudo apt-get install ia32-libs

* Lancement de XAMPP:
	sudo /opt/lampp/lampp start

* Il ne reste plus qu'à modififier l'utilisateur qui executera XAMPP, par défaut il s'agi de l'utilisateur nobody:nogroup. Pour changer cet utilisateur, editez le fichier httpd.conf (/opt/lampp/etc/httpd.conf) et modifiez la partie:
	User <votre_user>
	Group <votre_group>

* De la même façon il peut être nécéssaire de changer les droits dans mysql en éditant le fichier  /opt/lampp/etc/my.cnf et en changeant la directivr "User" par le nom de l'utilisateur qui doit executer XAMPP

* On fixe les droits du repertoire htdocs en conséquence:
	sudo chown -R <votre_user>:<votre_group> /opt/lampp/htdocs

II) Configuration de XAMPP pour fonctionner sur un autre port que le 80:
------------------------------------------------------------------------

* Editer le fichier httpd.conf (/opt/lampp/etc/httpd.conf) et modifier le la partie Listen 80 en Listen XXX ou XXX est le nouveau  port à utiliser

* Vous  pouvez aussi exécuter la commande suivante à la place d'éditer manuellement le fichier en  remplaçant XXX par votre port:
	sudo sed -i "s/Listen 80/Listen XXX/" /opt/lampp/etc/httpd.conf

* Relancer le serveur:
	sudo /opt/lampp/lampp restart

III) Problèmes de sécurité sous XAMPP
-------------------------------------

* Tiré de la documentation XAMPP (http://www.apachefriends.org/en/xampp-windows.html#1221)
	As mentioned at another place, XAMPP is not meant for production use but only for developers in a development environment. 
	XAMPP is configured is to be as open as possible and to allow the web developer anything he/she wants. For development 
	environments this is great but in a production environment it could be fatal.

	Here a list of missing security in XAMPP:

    		The MySQL administrator (root) has no password.
    		The MySQL daemon is accessible via network.
    		phpMyAdmin is accessible via network.
    		The XAMPP demopage is accessible via network.
    		The default users of Mercury and FileZilla are known.

* Pour corriger cela, il est possible de changer les mots de passe de XAMPP en éxécutant la commande suivante:
	sudo /opt/lampp/lampp security

Note: Si vous mettez un mot de passe pour accéder aux pages des sites de XAMPP, l'utilisateur à utiliser est "lampp"

IV) Suppréssion des erreurs "Strict" pour Joomla
------------------------------------------------

* Afin de ne pas afficher les erreurs liées au mode Strict de php, il faut modifier le fichier /opt/lampp/etc/php.ini et remplacer la ligne:
	error_reporting = E_ALL | E_STRICT
par:
	error_reporting = E_ALL & ~E_NOTICE | ~E_STRICT

* Puis relancer XAMPP:
	sudo /opt/lampp/lampp restart
