cultibox/cultibox/02_documentation/01_installation/02_linux/installation_manuelle_joomla.txt

I) Installation de Joomla sous XAMPP
------------------------------------

* Récupération de Joomla (remplacez nobody/nogroup par l'utilisateur/le group qui execute XAMMP si vous avez personnalisé ces variables):
	sudo -u nobody mkdir /opt/lampp/htdocs/joomla && sudo -u nobody wget --directory-prefix="/opt/lampp/htdocs/joomla" /opt/lampp/htdocs/joomla http://joomlacode.org/gf/download/frsrelease/16804/73116/Joomla_2.5.3-Stable-Full_Package.zip

* Installation de Joomla:
	cd /opt/lampp/htdocs/joomla && sudo -u nobody unzip Joomla_2.5.3-Stable-Full_Package.zip && sudo -u nobody rm Joomla_2.5.3-Stable-Full_Package.zip && sudo -u nobody touch /opt/lampp/htdocs/joomla/configuration.php 

* Accèder à l'interface d'installation: puis répondre aux questions:
	http://localhost/joomla/

II) Installation de Jumi sous Joomla
------------------------------------

* Jumi est une extension permettant d'intégrer facilement des contenus dans un article (et même des pages PHP). Récupérer Jumi:
	http://edo.webmaster.am/jumi

* Installer Jumi sous Joomla en vous rendant sur l'interface administrative dans la partie Extension Manager:
	http://localhost/joomla/administrator/index.php?option=com_installer

* Selectionner le package précédement télécharger et l'installer
