cultibox/cultibox/02_documentation/05_verif/CBX_1_13_0006_PTS_operating_pressure_range_mbar_-.pdf

Cultibox | CRE | CBX 1_13_0006 | - | 1 / 12
Type | Réf. document | Indice | Page

DOCUMENT GREEN BOX : Copyright © 20012-2013 GREEN BOX. Tous droits réservés. Ce document et l’information qu’il contient sont la propriété exclusive de GREEN BOX. Ils ne peuvent être reproduits ou divulgués sous quelque forme que ce soit sans l’accord préalable écrit de GREEN BOX.
GREEN BOX PROPRIETARY INFORMATION: Copyright © 2012-2013 by GREEN BOX. All rights reserved. This document and the information contained therein are GREEN BOX’s exclusive property. Any copy and/or disclosure thereof in any form whatsoever are subject to GREEN BOX’s prior written consent.

# PTS_OPERATING_PRESSURE_RANGE_MBAR

### Conclusion:

### Click here

Mot clé | Conclusion | Remarques
PTS_operating_pressure_range_mbar | PASS | NA
VERSION | DATE | AUTEUR | DESCRIPTION DES MODIFICATIONS
- | 18/03/13 | A Rico | Création

Cultibox | CRE | CBX 1_13_0006 | - | 2 / 12
Type | Réf. document | Indice | Page

DOCUMENT GREEN BOX : Copyright © 20012-2013 GREEN BOX. Tous droits réservés. Ce document et l’information qu’il contient sont la propriété exclusive de GREEN BOX. Ils ne peuvent être reproduits ou divulgués sous quelque forme que ce

# 1 SOMMAIRE

1 | SOMMAIRE | 2
2 | INTRODUCTION | 3
2.1 | OBJECTIF | 3
2.2 | SPECIFICATION DU MOT CLE | 3
2.3 | ISSUES ASSOCIEES | 3
2.4 | VERSION DE LA PTS | 4
3 | RESULTATS | 5
3.1 | PTS_ELECTRONIC_SDCARD | ERREUR ! SIGNET NON DEFINI.
4 | CONCLUSION | 7
5 | ANNEXE | 8
5.1 | DATASHEET | ERREUR ! SIGNET NON DEFINI.

Cultibox | CRE | CBX 1_13_0006 | - | 3 / 12
Type | Réf. document | Indice | Page

DOCUMENT GREEN BOX : Copyright © 20012-2013 GREEN BOX. Tous droits réservés. Ce document et l’information qu’il contient sont la propriété exclusive de GREEN BOX. Ils ne peuvent être reproduits ou divulgués sous quelque forme que ce

# 2 INTRODUCTION

# 2.1 Objectif

## L’objectif de ce rapport est de statuer sur le mot clé

PTS_operating_pressure_range_mbar.

Ce mot clé indique les conditions de pression admissible par la Cultibox.

# 2.2 Spécification du mot clé

## Les spécifications du mot clé sont :

Mot clé | Minimum | Typique | Maximum | Unité
PTS_operating_pressure_range_mbar | | 1014 | | mBar

# 2.3 Issues associées

## L’issue associée à ce mot clé est :

Nom de l’issue | numéro | Type
PTS_operating_pressure_range_mbar | 393 | PTS

## L’ensemble des issues peut être lu à l’adresse suivante : http://code.google.com/p/cultibox/issues

Cultibox | CRE | CBX 1_13_0006 | - | 4 / 12
Type | Réf. document | Indice | Page

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

# 2.4 Version de la PTS

## Pour la validation du mot clé PTS_electronic_SDcard, on considère la révision suivante :

PTS Révision | Date
Révision 587 | 18/03/2013

# 2.5 Version des logiciels

## Durant les cinq mois d’essais, la version du firmware et du software à beaucoup changé. Nous considérons que la version du firmware et software n’a pas d’influence sur le résultat. Seul des changements mécaniques peuvent avoir une influence sur le

résultat.

# 2.6 Cultibox

Le tableau ci-dessous donne les numéros des cultibox utilisés pour ce test.

Matériel | Numéro d’identification
Cultibox | ID : 00001

Cultibox | CRE | CBX 1_13_0006 | - | 5 / 12
Type | Réf. document | Indice | Page

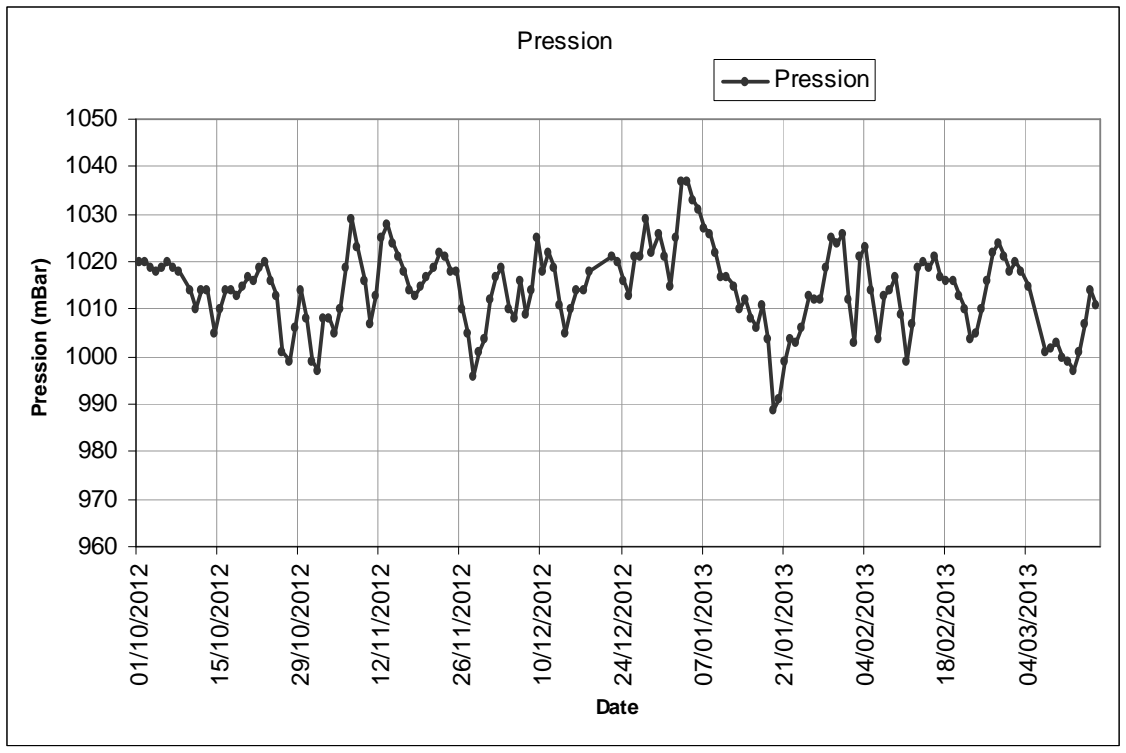
[picture p112: figure]
Pression; Date; Pression (mBar)

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

# 3 RESULTATS

# 3.1 Méthodologie

Nous ne possédons pas d’étuve permettant de faire varier la pression. La méthode choisie pour déterminer si la Cultibox peut fonctionner sous des conditions typiques de pression est la suivante : - Utilisation normale (branchée et avec des programmes) de la Cultibox pendant plus de 5 mois - Récupération des conditions climatiques présentes durant cet intervalle

# 3.2 Valeur de pression

## Durant les 5 mois de l’essai, les pressions suivantes ont été observées :

## De ces valeurs, on peut tirer différentes informations :

Pression moyenne (mbar) | 1014

Cultibox | CRE | CBX 1_13_0006 | - | 6 / 12
Type | Réf. document | Indice | Page

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

Pression minimale (mbar) | 1037
Pression maximale (mbar) | 989

Voir en annexe pour l’ensemble des données.

# 3.3 Impact sur la Cultibox

## Il n’y aucune conséquence visible sur la Cultibox, ni sur son fonctionnement. Le tableau ci-dessous liste les points qui ont été observés :

Point observé | Conclusion
Ecran LCD | OK
PCB capteur | OK
PCB carte principale | OK
Aspect extérieur | OK
Fonctionnement bouton | OK
Pilotage prise | OK
Relevé T/RH | OK

Cultibox | CRE | CBX 1_13_0006 | - | 7 / 12
Type | Réf. document | Indice | Page

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

# 4 CONCLUSION

## L’essai effectué ne permet pas de statuer sur des valeurs minimum et maximum. Il permet de valider la non-dégradation et le bon fonctionnement de la Cultibox sous

des pressions atmosphériques satndard.

Mot clé | Conclusion | Remarques
PTS_operating_pressure_range_mbar | PASS | NA

Cultibox | CRE | CBX 1_13_0006 | - | 8 / 12
Type | Réf. document | Indice | Page

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

# 5 ANNEXE

# 5.1 Valeur de pression

Date | Pression | Température moyenne | Température maximale | Température minimale | Humidité
01/10/2012 | 1020 | 14 | 18 | 10 | 82
02/10/2012 | 1020 | 14 | 20 | 9 | 76
03/10/2012 | 1019 | 15 | 23 | 9 | 74
04/10/2012 | 1018 | 15 | 20 | 10 | 81
05/10/2012 | 1019 | 16 | 24 | 9 | 74
06/10/2012 | 1020 | 18 | 22 | 11 | 77
07/10/2012 | 1019 | 17 | 20 | 14 | 88
08/10/2012 | 1018 | 16 | 19 | 13 | 86
10/10/2012 | 1014 | 15 | 21 | 11 | 88
11/10/2012 | 1010 | 15 | 21 | 10 | 85
12/10/2012 | 1014 | 13 | 15 | 7 | 77
13/10/2012 | 1014 | 9 | 16 | 3 | 81
14/10/2012 | 1005 | 10 | 15 | 5 | 80
15/10/2012 | 1010 | 7 | 11 | 1 | 75
16/10/2012 | 1014 | 8 | 14 | -1 | 76
17/10/2012 | 1014 | 15 | 20 | 7 | 66
18/10/2012 | 1013 | 16 | 18 | 13 | 65
19/10/2012 | 1015 | 17 | 22 | 13 | 65
20/10/2012 | 1017 | 16 | 24 | 12 | 72
21/10/2012 | 1016 | 16 | 23 | 13 | 78
22/10/2012 | 1019 | 15 | 19 | 11 | 89
23/10/2012 | 1020 | 14 | 19 | 9 | 91
24/10/2012 | 1016 | 13 | 18 | 9 | 89
25/10/2012 | 1013 | 13 | 19 | 9 | 85
26/10/2012 | 1001 | 13 | 15 | 11 | 88
27/10/2012 | 999 | 5 | 12 | 1 | 90
28/10/2012 | 1006 | 1 | 3 | -1 | 85
29/10/2012 | 1014 | 2 | 6 | -2 | 77
30/10/2012 | 1008 | 2 | 10 | -3 | 81
31/10/2012 | 999 | 4 | 7 | 1 | 86
01/11/2012 | 997 | 7 | 13 | 0 | 82
02/11/2012 | 1008 | 12 | 15 | 8 | 65

Cultibox | CRE | CBX 1_13_0006 | - | 9 / 12
Type | Réf. document | Indice | Page

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

03/11/2012 | 1008 | 13 | 17 | 6 | 70
04/11/2012 | 1005 | 11 | 14 | 8 | 90
05/11/2012 | 1010 | 8 | 13 | 4 | 83
06/11/2012 | 1019 | 7 | 11 | 5 | 88
07/11/2012 | 1029 | 5 | 10 | 0 | 83
08/11/2012 | 1023 | 7 | 13 | 0 | 80
09/11/2012 | 1016 | 10 | 15 | 3 | 82
10/11/2012 | 1007 | 12 | 14 | 10 | 94
11/11/2012 | 1013 | 9 | 10 | 8 | 87
12/11/2012 | 1025 | 7 | 8 | 5 | 86
13/11/2012 | 1028 | 5 | 7 | 3 | 90
14/11/2012 | 1024 | 7 | 14 | 2 | 84
15/11/2012 | 1021 | 7 | 15 | 2 | 87
16/11/2012 | 1018 | 7 | 14 | 2 | 88
17/11/2012 | 1014 | 7 | 13 | 3 | 83
18/11/2012 | 1013 | 7 | 13 | 2 | 77
19/11/2012 | 1015 | 5 | 12 | 1 | 80
20/11/2012 | 1017 | 4 | 12 | 0 | 81
21/11/2012 | 1019 | 7 | 11 | 2 | 84
22/11/2012 | 1022 | 8 | 10 | 4 | 88
23/11/2012 | 1021 | 8 | 13 | 3 | 90
24/11/2012 | 1018 | 11 | 16 | 4 | 75
25/11/2012 | 1018 | 11 | 13 | 10 | 87
26/11/2012 | 1010 | 11 | 17 | 7 | 81
27/11/2012 | 1005 | 5 | 7 | 3 | 93
28/11/2012 | 996 | 4 | 5 | 3 | 90
29/11/2012 | 1001 | 3 | 4 | 1 | 87
30/11/2012 | 1004 | 1 | 3 | 0 | 82
01/12/2012 | 1012 | -1 | 1 | -3 | 83
02/12/2012 | 1017 | -2 | 1 | -6 | 93
03/12/2012 | 1019 | -1 | 3 | -7 | 92
04/12/2012 | 1010 | 5 | 8 | 2 | 83
05/12/2012 | 1008 | 2 | 5 | 1 | 91
06/12/2012 | 1016 | 0 | 2 | -4 | 83
07/12/2012 | 1009 | -1 | 1 | -4 | 91
08/12/2012 | 1014 | 1 | 1 | 0 | 89
09/12/2012 | 1025 | -2 | 1 | -7 | 77
10/12/2012 | 1018 | 0 | 2 | -3 | 87
11/12/2012 | 1022 | -2 | -2 | -2 | 74

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
09/03/2013 | 1003 | 8 | 14 | 1 | 80
10/03/2013 | 1000 | 8 | 16 | 2 | 75
11/03/2013 | 999 | 9 | 14 | 4 | 75
12/03/2013 | 997 | 8 | 13 | 2 | 68
13/03/2013 | 1001 | 1 | 2 | -2 | 75
14/03/2013 | 1007 | -1 | 3 | -4 | 64
15/03/2013 | 1014 | 0 | 4 | -5 | 62
16/03/2013 | 1011 | 3 | 11 | -7 | 52
