cultibox/cultibox/01_software/01_install/03_linux/conf-package/cultibox.png

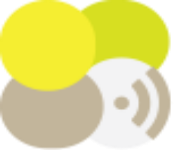
01_software/01_install/03_linux/conf-package/cultibox.png
