cultibox/cultibox/01_software/01_install/04_mac/conf-package/takecontrol.png

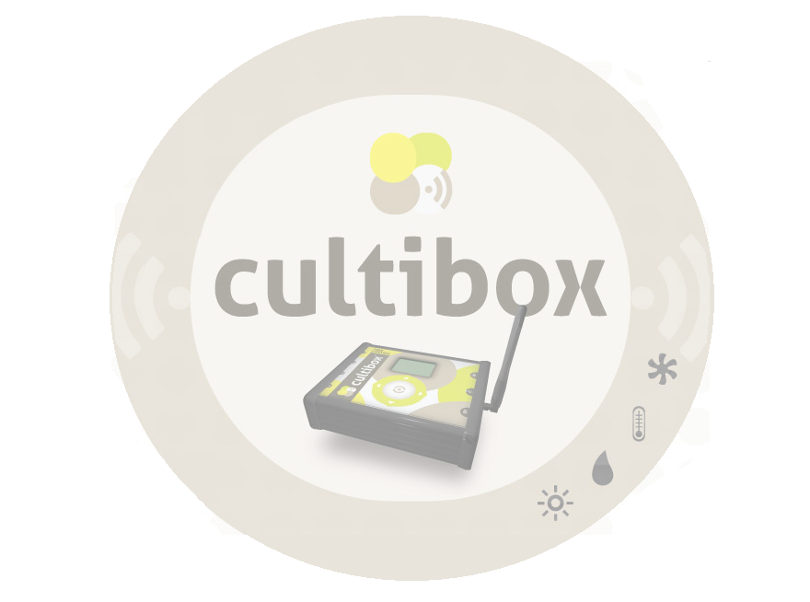
01_software/01_install/04_mac/conf-package/takecontrol.png
