cultibox/cultibox/02_documentation/02_userdoc/quick_guide/logs_month.png

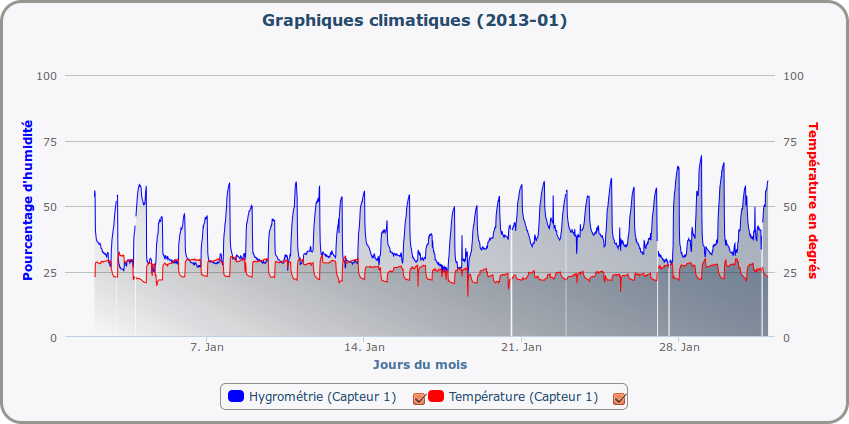
02_documentation/02_userdoc/quick_guide/logs_month.png
