cultibox/cultibox/02_documentation/02_userdoc/quick_guide/program.png

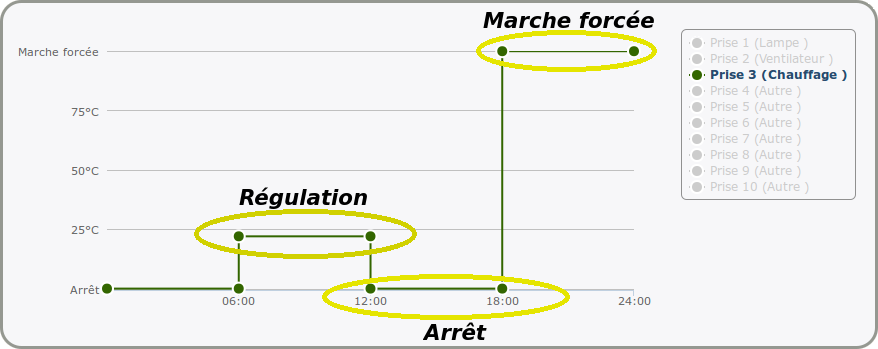
02_documentation/02_userdoc/quick_guide/program.png
