cultibox/cultibox/02_documentation/02_userdoc/quick_guide/wizard.png

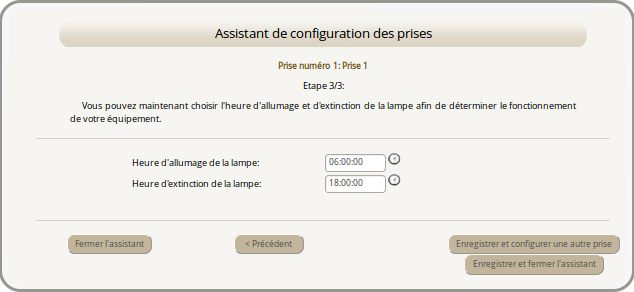
02_documentation/02_userdoc/quick_guide/wizard.png
