cultibox/cultibox/03_verif/01_tests/04_configuration_admin/administration.html

suite_tests
open | /cultibox/
setSpeed | 3000
click | link=Configuration
click | id=div_admin_label
click | css=#view_logs > img
click | id=logs_httpd
click | id=btnCloseLogs
click | id=logs_mysql
click | id=btnCloseLogs
click | id=logs_service
click | id=btnCloseLogs
click | id=logs_cultipi
click | id=btnCloseLogs
click | id=logs_system
click | id=btnCloseLogs
click | xpath=(//button[@type='button'])[3]
click | id=dl_logs
click | id=dl_logs_httpd
click | id=dl_logs_mysql
click | id=dl_logs_service
click | id=dl_logs_cultipi
click | id=dl_logs_system
click | xpath=(//button[@type='button'])[5]
click | css=#dl_firm > img
click | id=dl_wifi_firm
click | xpath=(//button[@type='button'])[7]
click | id=dl_cultibox_firm
click | id=btnCloseFirm
click | css=#update_rpi > img
waitForElementPresent | id=btnCloseUp
click | id=btnCloseUp
click | id=div_user_label
select | id=advanced_regul_options | label=Oui
click | id=submit_conf
waitForElementPresent | id=close-update-conf
click | id=close-update-conf
waitForElementPresent | id=close-diff-conf
click | id=close-diff-conf
click | id=div_admin_label
click | css=#update_rpi > img
click | id=beta_upgrade
click | id=beta_upgrade
click | xpath=(//button[@type='button'])[3]
click | css=#restart_rpi > img
click | xpath=(//button[@type='button'])[5]
setSpeed | 0
pause | 60000
open | /cultibox/
