cultibox/cultibox/03_verif/01_tests/07_logs_programmes_puissance/logs_prog_puissance.html

logs_prog_puissance
open | /cultibox/
setSpeed | 3000
setTimeout | 50
click | css=a.level1.href-logs > span
click | id=curve_select_button
waitForElementPresent | id=plug_display1
click | id=plug_display1
waitForElementPresent | id=plug_display2
click | id=plug_display2
waitForElementPresent | id=plug_display3
click | id=plug_display3
waitForElementPresent | id=power_display1
click | id=power_display1
waitForElementPresent | id=power_display2
click | id=power_display2
waitForElementPresent | id=power_display3
click | id=power_display3
click | id=btnClose_curve
click | xpath=(//input[@type='checkbox'])[7]
click | xpath=(//input[@type='checkbox'])[8]
click | xpath=(//input[@type='checkbox'])[9]
click | xpath=(//input[@type='checkbox'])[10]
click | xpath=(//input[@type='checkbox'])[11]
click | xpath=(//input[@type='checkbox'])[12]
click | xpath=(//input[@type='checkbox'])[7]
click | xpath=(//input[@type='checkbox'])[8]
click | xpath=(//input[@type='checkbox'])[9]
click | xpath=(//input[@type='checkbox'])[10]
click | xpath=(//input[@type='checkbox'])[11]
click | xpath=(//input[@type='checkbox'])[12]
click | id=curve_select_button
waitForElementPresent | id=plug_display1
click | id=plug_display1
waitForElementPresent | id=plug_display2
click | id=plug_display2
waitForElementPresent | id=plug_display3
click | id=plug_display3
waitForElementPresent | id=power_display1
click | id=power_display1
waitForElementPresent | id=power_display2
click | id=power_display2
waitForElementPresent | id=power_display3
click | id=power_display3
click | id=btnClose_curve
