cultibox/cultibox/03_verif/02_results/01_base/README

Directory contains database dump to be compared
