cultibox/cultibox/03_verif/02_results/02_conf/README

Directory containing configuration to be compared
