cultibox/cultibox/03_verif/01_tests/06_wizard/wizard.html

wizard
open | /cultibox/
setSpeed | 3000
click | link=Configuration
select | id=nb_plugs | label=16
click | id=submit_conf
waitForElementPresent | id=close-update-conf
click | id=close-update-conf
waitForElementPresent | id=close-diff-conf
click | id=close-diff-conf
click | css=a.level1.href-wizard > span
click | id=start_time
click | id=start_time
type | id=start_time
click | //div[@id='step2']/table/tbody/tr[2]/td[2]
click | id=end_time
click | id=end_time
type | id=end_time
click | //div[@id='step2']/table/tbody/tr[2]/td[2]
click | id=next_plug
waitForVisible | id=error_start_time
waitForVisible | id=error_end_time
click | id=end_time
click | id=end_time
click | xpath=(//button[@type='button'])[3]
click | id=start_time
click | //div[@id='ui_tpicker_second_start_time']/a
click | xpath=(//button[@type='button'])[4]
click | id=next_plug
waitForElementPresent | id=plug_type
select | id=plug_type | label=Lampe
click | id=next
click | id=start_time
click | id=start_time
type | id=start_time
click | css=#step2 > table.table_width > tbody > tr > td.wizard-title
click | id=end_time
click | id=end_time
type | id=end_time
click | id=submit_wizard
click | id=next_plug
click | id=start_time
click | //div[@id='step2']/table/tbody/tr[2]/td[2]
click | id=next_plug
select | id=plug_type | label=Ventilateur
click | id=next
click | id=previous
click | id=next
click | id=start_time
type | id=start_time
click | //div[@id='step2']/table/tbody/tr[2]/td[2]
click | id=end_time
click | id=end_time
type | id=end_time
click | //div[@id='step2']/table/tbody/tr[2]/td[2]
click | id=next_plug
waitForElementPresent | id=plug_type
type | id=value_program
click | id=next_plug
type | id=value_program | 99
click | id=next_plug
click | id=next_plug
click | id=plug_type
select | id=plug_type | label=Extracteur
click | document.submit_wizard.plug_power_max[1]
click | id=next
type | id=value_program
click | id=next_plug
type | id=value_program | 99
click | id=next_plug
click | id=next_plug
click | document.submit_wizard.plug_power_max[1]
select | id=plug_type | label=Intracteur
click | id=next
type | id=value_program
click | id=next_plug
type | id=value_program | 90
click | id=next_plug
click | id=next_plug
click | document.submit_wizard.plug_power_max[1]
click | id=next
click | id=previous
click | id=next
click | id=next_plug
click | document.submit_wizard.plug_power_max[1]
select | id=plug_type | label=Chauffage
click | id=next
type | id=value_program
click | id=next_plug
type | id=value_program | 99
click | id=next_plug
click | id=next_plug
select | id=plug_type | label=Pompe à eau
click | document.submit_wizard.plug_power_max[1]
click | id=next
type | id=value_program
click | id=next_plug
click | id=value_program
type | id=value_program | 99
click | id=next_plug
type | id=value_program | 27
click | id=next_plug
select | id=plug_type | label=Pompe de remplissage
click | document.submit_wizard.plug_power_max[1]
click | id=next
click | id=next_plug
select | id=plug_type | label=Pompe de vidage
click | document.submit_wizard.plug_power_max[1]
click | id=next
type | id=value_program
click | id=next_plug
type | id=value_program | 99
click | id=next_plug
click | id=next_plug
click | id=plug_type
select | id=plug_type | label=Humidificateur
click | document.submit_wizard.plug_power_max[1]
click | id=next
type | id=value_program
click | id=next_plug
type | id=value_program | 99
click | id=next_plug
type | id=value_program | 5
click | id=next_plug
select | id=plug_type | label=Déshumidificateur
click | document.submit_wizard.plug_power_max[1]
click | id=next
click | document.submit_wizard.plug_power_max[1]
click | id=next
type | id=value_program
click | id=next_plug
type | id=value_program | 99
click | id=next_plug
type | id=value_program | 5
click | id=next_plug
click | document.submit_wizard.plug_power_max[1]
click | id=next
click | id=finish
waitForElementPresent | id=close-diff-conf
click | id=close-diff-conf
select | id=selected_plug_conf | label=10 - Prise10
click | css=option[value="10"]
click | id=jumpto_wizard
click | document.submit_wizard.plug_power_max[1]
click | id=next
click | id=finish
waitForElementPresent | id=close-diff-conf
click | id=close-diff-conf
select | id=selected_plug_conf | label=14 - Prise14
click | css=option[value="14"]
click | id=jumpto_wizard
click | document.submit_wizard.plug_power_max[1]
select | id=plug_type | label=Humidificateur
click | id=next
click | id=finish
waitForElementPresent | id=close-diff-conf
click | id=close-diff-conf
select | id=selected_plug_conf | label=16 - Prise16
click | css=option[value="16"]
click | id=jumpto_wizard
click | document.submit_wizard.plug_power_max[1]
click | id=next
click | id=close
