cultibox/cultibox/03_verif/01_tests/03_configuration_manage_conf/configuration.html

suite_tests
open | /cultibox/
setSpeed | 3000
click | link=Configuration
click | css=#export_conf > img
click | css=#import_conf > img
click | css=a.level1.href-programs > span
