cultibox/cultibox/03_verif/01_tests/02_configuration_interface/configuration.html

configuration
open | /cultibox/
setSpeed | 3000
click | link=Configuration
waitForElementPresent | id=nb_plugs
select | id=nb_plugs | label=16
select | id=advanced_regul_options | label=Oui
click | id=submit_conf
selectWindow | null
waitForElementPresent | id=close-update-conf
click | id=close-update-conf
waitForElementPresent | id=close-diff-conf
click | id=close-diff-conf
click | link=Prises
select | id=selected_plug_conf | label=16 - Prise16
click | css=option[value="16"]
