cultibox/cultibox/03_verif/01_tests/01_welcome/welcome.html

welcome
open | /cultibox/
setSpeed | 3000
clickAndWait | css=img[alt="Translate the software in English (UK)"]
clickAndWait | css=img[alt="Traduire le logiciel en Français (FR)"]
clickAndWait | id=it_IT
clickAndWait | css=img[alt="Traducir el software en Español (ES)"]
clickAndWait | id=de_DE
clickAndWait | css=img[alt="Traduire le logiciel en Français (FR)"]
waitForElementPresent | id=go_wizard
click | id=go_wizard
click | id=finish
waitForElementPresent | id=close-diff-conf
click | id=close-diff-conf
clickAndWait | css=#welcome-logo > img
click | css=img[alt="Page de visualisation des logs"]
clickAndWait | css=#welcome-logo > img
click | id=welcome-log-txt
clickAndWait | css=#welcome-logo > img
click | css=img[alt="Page de configuration des prises et de leurs fonctionnements"]
clickAndWait | css=#welcome-logo > img
click | id=welcome-prog-txt
clickAndWait | css=#welcome-logo > img
clickAndWait | css=#welcome-logo > img
click | css=img[alt="Page de programmation du calendrier de culture"]
clickAndWait | css=#welcome-logo > img
click | id=welcome-cal-txt
clickAndWait | css=#welcome-logo > img
click | css=img[alt="Page du résumé de l'état de votre espace de culture"]
clickAndWait | css=#welcome-logo > img
click | id=welcome-synop-txt
clickAndWait | css=#welcome-logo > img
