cultibox/cultibox/03_verif/01_tests/05_logs_jours_mois/logs.html

logs
open | /cultibox/
setSpeed | 3000
setTimeout | 60000
click | link=Logs
waitForElementPresent | css=#highcharts-0 > input[type="checkbox"]
click | css=#highcharts-0 > input[type="checkbox"]
click | xpath=(//input[@type='checkbox'])[6]
click | css=#highcharts-0 > input[type="checkbox"]
click | xpath=(//input[@type='checkbox'])[6]
click | id=select_month
click | id=display-log-submit
waitForElementPresent | css=#highcharts-5 > input[type="checkbox"]
click | css=#highcharts-5 > input[type="checkbox"]
click | xpath=(//input[@type='checkbox'])[6]
click | css=#highcharts-5 > input[type="checkbox"]
click | xpath=(//input[@type='checkbox'])[6]
