cultibox/cultibox/(threads)

Thread 1005 (2015-04-07):

[CULTISOFTRAZ] Remise à zéro complete non fonctionnelle

GoogleCodeExporter, 2015-04-07:
```
Vérifier pendant 30 secondes l'appui sur le bouton

```

Original issue reported on code.google.com by `alliaume...@gmail.com` on 20 Jan 2015 at 2:09

ygene, 2015-07-15:
j'ai besoin du bout de code tcl pour faire le RAZ total, je crois qu'on l'a désactivé.
Je ne sais pas trop comment différencier le RAZ conf du RAZ total...

guillaume-rico, 2015-07-16:
Pour réactiver cette partie, tu décommente la ligne 140 (# firstLoop)

ygene, 2015-07-22:
J'ai la boucle de RAZ (conf pas usine) qui bloque, une fois dedans je ne peux pas sortir le vwait ne semble pas fonctionner, tu peux jeter un oeil?

guillaume-rico, 2015-07-22:
Correctif en cours de livraison

ygene, 2015-07-23:
Bon alors, le RAZ de la conf fonctionne bien comme je veux, c'est propre, ca roule, ca on check!

Par contre le RAZ usine me pose plus de problèmes, tu as raison la boucle ne dure pas 10s (je comprend pas pourquoi avant c'était le cas):

Jul 23 19:39:46 : cultiRAZ : Vérification de la remise en état usine du Cultipi
Jul 23 19:39:46 : cultiRAZ : Vérification de l'effacement de la configuration du Cultipi

Il devrait y avoir un écart de 10s entre les deux, c'est pas le cas... il s'agit de la boucle firstLoop... tu peux regarder? désolé//merci!

ygene, 2015-07-29:
Je clos, ca fonctionne, on passe par un reboot maintenant, plus long mais au moins on est certain que tout se remet en place comme il se doit!

guillaume-rico, 2015-07-29:
A ajouter dans la doc!

Guillaume RICO

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

Closed 2015-07-29.

Thread 1068 (2015-04-07):

[LOGS] Gestion des accents dans highchart

GoogleCodeExporter, 2015-04-07:
```
Lorsqu'on fait un export des courbes, les légendes avec des accents
apparaissent au format HTML.

```

Original issue reported on code.google.com by `alliaume...@gmail.com` on 10 Feb 2015 at 9:01

ygene, 2015-07-18:
A tester, les graphes possibles sont les logs, le cout et les programmes, normalement il ne doit pas y avoir de problèmes d'accents dans le graphe ET dans le fichier image exporté.

Jte le donne celui la philou ;). Un vieu à toi!

ygene, 2015-07-18:
vieux*

guillaume-rico, 2015-07-20:
Nickel

Closed 2015-07-20.

Thread 1071 (2015-04-07):

[SYNO] interface: pilotage les effecteurs/syno

GoogleCodeExporter, 2015-04-07:
```
-rendre l'interface plus accessible(un icone en plus de la clé actuel). Un
autre interface que celle de "graphique"
-donner la possibilité de griser l'interface pour certaines prises (ca peut
être simplement un check bouton par fenêtre de prise). L’intérêt est de
pouvoir "se" limiter l’accès à un pilotage sur la mauvaise prise.
-remonter le "vrai"nom de la prise pour plus de clarté(on a prise n°1,2,..)
-remonter le nom de la prise sur l'interface (elle peut se déplacer on sait
plus a qu'elle prise c'est)
-remonté une info sur la fenêtre du changement d'état(ok elle est aussi sous
la prise)
-ajouter une couleur à l'état ON/OFF
-possibilité d'avoir un état ON / OFF / régul ON / régul OFF comme
indication de l'état des prises?(on peut ajouter ON/OFF forcé aussi )
-avoir une vrai horloge (en chiffre quand mm) plutot que l'heure de maj comme
indication horaire (elle est utile mais en dessous du syno )
(la dessus le pire de serait de vous d'avoir une horloge fixe tout le temps dur
le bandeau et qui sera visible sur tout les onglets(avec les sec). Franchement
ça serait le top (possibilité de la masquer pour les "fou" qui la veulent
pas!)
-...

```

Original issue reported on code.google.com by `elchaf...@gmail.com` on 11 Feb 2015 at 6:25

guillaume-rico, 2015-06-08:
Fonctionnalités implémentés

Closed 2015-06-08.

Thread 1111 (2015-04-07):

[SYNOPTIC] - Amélioration des textes

GoogleCodeExporter, 2015-04-07:
```
Il faudra améliorer les textes: on - off des prises (un truc genre status de
la prise: Marche /Arrêt) et géré les traductions

De même pour les capteurs quand on passe la souris dessus on peut gérer des
couleurs ou autres, je sais pas trop mais peu mieux faire ;).

```

Original issue reported on code.google.com by `yann.gen...@gmail.com` on 15 Feb 2015 at 7:29

guillaume-rico, 2015-06-08:
Pas de nouvelles idées, je clos

Closed 2015-06-08.

Thread 1121 (2015-04-07):

[logs] affichage sur plusieurs mois

GoogleCodeExporter, 2015-04-07:
```
plusieurs mois

```

Original issue reported on code.google.com by `alliaume...@gmail.com` on 26 Feb 2015 at 1:37

ygene, 2015-06-28:
En même temps que l'upgrade de highchart se fait on pourra ajouter les zones pour les programmes (dimmer and co):

http://jsfiddle.net/gh/get/jquery/1.7.2/highslide-software/highcharts.com/tree/master/samples/highcharts/series/color-zones-zoneaxis-x/

http://stackoverflow.com/questions/15300330/highcharts-line-graph-with-half-solid-line-and-half-dotted-line

http://www.highcharts.com/docs/chart-concepts/series

ygene, 2015-07-17:
Placé dans les évolutions pour cultibox v3

Closed 2015-07-17.

Thread 1130 (2015-04-07):

[LOGS]  Serait il possible de faire apparaitre la moyenne T° et Rh de la plage ciblée lors de l’affichage d’un graphe

GoogleCodeExporter, 2015-04-07:
```
 Serait il possible de faire apparaitre la moyenne T° et Rh de la plage ciblée lors de l’affichage d’un graphe

```

Original issue reported on code.google.com by `alliaume...@gmail.com` on 11 Mar 2015 at 6:03

chafoin, 2015-04-12:
je n'etais pas clair !

Affichier une courbe de temperature qui est la moyenne de deux ou + capteurs.

Exemple:
J'ai deux capteurs dans mon espace.
J'effectue une régulation en fonction de la moyenne de la température de ces 2 capteurs
Je souhaiterai voir le déclenchement de mes effecteurs sur le graph en focntion de cette moyenne!
ca me permet de ne plus afficher le capteur n°1 et n°2 mais une seule courbe de température qui serait la moyenne des deux capteurs.

ygene, 2015-07-17:
Amélioration cultibox v3

Closed 2015-07-17.

Thread 1134 (2015-04-07):

[CAL] Le calendrier lunaire est présent sur la carte SD même si il n'est pas sélectionné dans le logiciel

GoogleCodeExporter, 2015-04-07:
```
Le calendrier lunaire est présent sur la carte SD même si il n'est pas
sélectionné dans le logiciel

```

Original issue reported on code.google.com by `alliaume...@gmail.com` on 14 Mar 2015 at 7:40

guillaume-rico, 2015-06-08:
Non, il sont bien effacé a l'ouverture de la page. Je clos

Closed 2015-06-08.

Thread 1136 (2015-04-07):

[cultipi] probleme de lancement

GoogleCodeExporter, 2015-04-07:
```
je n'arrive pas à joindre mon cultipi sous:
http://cultipi.local/cultibox/
ca m'indique :erreur de chargement de la page

par  contre, pas de souci avec :
http://192.168.0.11/cultibox/
ca se charge correctment

une fois lancé depuis l'adresse qui marche je peux recliquer sur mon lien
http://cultipi.local/cultibox/ et la ca marche...

```

Original issue reported on code.google.com by `elchaf...@gmail.com` on 17 Mar 2015 at 4:57

Closed 2015-05-06.

Thread 1138 (2015-04-07):

[CONFIG_CULITPI] Sauvegarder le fichier à la mise à jour logiciel

GoogleCodeExporter, 2015-04-07:
```
Faire en sorte que la mise à jour logiciel de cultibox n'écrase pas le
fichier config_cultipi.php

```

Original issue reported on code.google.com by `alliaume...@gmail.com` on 19 Mar 2015 at 5:46

guillaume-rico, 2015-04-19:
C'est plus d'actualité

Closed 2015-04-19.

Thread 1142 (2015-04-07):

[SYNO] Supprimer les capteurs non présents

GoogleCodeExporter, 2015-04-07:
```
Supprimer les capteurs non présents

```

Original issue reported on code.google.com by `alliaume...@gmail.com` on 23 Mar 2015 at 7:31

ygene, 2015-04-16:
Heu c'est à dire? les capteurs dans le synoptique? tu veux dire les icons? ou...? plus d'infos svp!

guillaume-rico, 2015-04-17:
Par défaut, ne mettre qu'un seul capteur dans la base de donnée à l'installation.

ygene, 2015-04-20:
A tester.

ygene, 2015-04-28:
Vérifié avec une installation fraiche, capteur 1 configuré sur temp et hygro, les autres sont à 0. Je clos.

Closed 2015-04-28.

Thread 1143 (2015-04-07):

[TRACE] ajouter la possibilitée de sélectionner le niveau de trace dans l'interface

GoogleCodeExporter, 2015-04-07:
```
 ajouter la possibilitée de sélectionner le niveau de trace dans l'interface

```

Original issue reported on code.google.com by `alliaume...@gmail.com` on 23 Mar 2015 at 8:26

guillaume-rico, 2015-04-12:
Livré dans le code auijourd'hui. Un bout de co avec !  https://github.com/cultibox/cultibox/wiki/cultipi_developeur#commandesinformations-utiles

chafoin, 2015-04-19:
parfait !
En plus la doc des commandes est bien clair et me sera utile,merci !
Je clos sans plus tester, je suppose que tu l'utilises deja et que j'aurai l'occasion de tester(et hop en raccourci)

Closed 2015-04-19.

Thread 1145 (2015-04-07):

[CULTIBOX] Affichage des capteurs en Wifi

GoogleCodeExporter, 2015-04-07:
```
 Affichage des capteurs en Wifi

```

Original issue reported on code.google.com by `alliaume...@gmail.com` on 23 Mar 2015 at 8:32

guillaume-rico, 2015-04-17:
Done ! Manque que le bouton pour mettre à jour le firmware

chafoin, 2015-04-19:
désolé j'ai beau me retourner le truc dans tous les sens, je vois pas de quoi on parle la, rhumf
Tu peux me rappeler l'origine de l'issue stp ?

ygene, 2015-04-19:
Je crois que c'est l'affichage des capteurs sur l'ecran de la cultibox.
Faut mettre le nouveau firmware à Al pour ça.

Le 19 avril 2015 10:45, chafoin <notifications@github.com> a écrit :

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

guillaume-rico, 2015-04-19:
C'est exactement ce que dis Yann. Comme je disais , il manque que le bouton !

chafoin, 2015-05-02:
testé avec le firm_wifi.hex fourni dans la version : v2.0.48-r1505011427

*Je n'ai pas de données de capteur qui s'affiche sur l'écran de la cultibox.
*Ok pour l'heure et la date.
J'ai de temps en temps un "P" qui s'affiche en haut à gauche de l'ecran pres de l'icone dossier

chafoin, 2015-05-02:
bha discretement, si tu restes un moment devant l'écran sans faire de bruit, tu peux voir la magie s'opérer ! une valeur d'humidité apparait pendant 5sec et disparait 5sec !

en gros:
C'est toujours la valeur RH du meme capteur apparemment.
Des que je trippote les boutons, je n'ai plus rien.
Je ne crois pas pouvoir selectionner de capteur.

guillaume-rico, 2015-05-28:
Plus de problème depuis la synchro

Closed 2015-05-28.

Thread 1146 (2015-04-07):

[CULTIBOX WIFI] Cacher l'heure ou la mettre à jour

GoogleCodeExporter, 2015-04-07:
```
Cacher l'heure ou la mettre à jour

```

Original issue reported on code.google.com by `alliaume...@gmail.com` on 23 Mar 2015 at 8:32

guillaume-rico, 2015-04-17:
C'est bon !
Il manque que le bouton pour changer le firmware de la cultibox

chafoin, 2015-04-19:
Si j'ai bien compris c'est l'heure qu'il y a vait dans le syno
Actuellement, dans "en direct" il n'y a plus l'heure affiché, elle est visible sur le petit "play" vert qui indique l'etat du module wifi.
Ca me semble correct ! pour le bouton de redémarrage, il y en a un dans "conf>admin" mais j'avoue qu'un petit bouton accessible dans "en direct" serait bien.
je clos celui ci et en ouvre un pour le bouton (si j'ai bien compris!)

guillaume-rico, 2015-04-19:
Non, c'est sur l'écran de la cultibox !

chafoin, 2015-05-02:
testé avec le firm_wifi.hex fourni dans la version : v2.0.48-r1505011427
*Ok pour l'heure et la date :
tu as inversé la date par rapport à la cultibox :
cultibox 02/05/15
cultibox_wifi 15/05/02

L'heure est bien celle du reseau

Ca me semble correct, je clos !

Closed 2015-05-02.

Thread 1147 (2015-04-07):

[WEBCAM] Flux live

GoogleCodeExporter, 2015-04-07:
```
Afficher un lien pour le flux live de la webcam

```

Original issue reported on code.google.com by `alliaume...@gmail.com` on 23 Mar 2015 at 8:34

ygene, 2015-06-12:
A tester mais c'est ok pour moi dans la nouvelle version.

guillaume-rico, 2015-06-12:
On vérifiera aux galeries Mardi

ygene, 2015-06-19:
Ca marche aux galeries

Closed 2015-06-19.

Thread 1149 (2015-04-07):

[WEBCAM] Connexion de plusieurs webcam

GoogleCodeExporter, 2015-04-07:
```
 Connexion de plusieurs webcam

```

Original issue reported on code.google.com by `alliaume...@gmail.com` on 23 Mar 2015 at 8:36

chafoin, 2015-04-19:
je n'ai plus qu'un seul cam (mes deux vieilles toutes pourrites sont autre part huhu)
ouais, je me met en status needmaterial !
yann, si tu as une cam qui traine à me refiler sitoplait ?

ygene, 2015-04-19:
J'ai ca.

Le 19 avril 2015 10:48, chafoin <notifications@github.com> a écrit :

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

ygene, 2015-04-19:
Je clos, testé, ok pour moi je t'en passerais une en plus pour que tu t'amuses

guillaume-rico, 2015-04-19:
J'ai aucune webcam de visible au GLs...

ygene, 2015-04-20:
Al et ses issues! On gagnerait du temps si tu me donnais directement plus d'infos hein:

* Il t'affiche quoi?
* Il te dis aucune webcam detectée pour les 4 ou il te dis autre chose?
* Il te dis rien mais tu a la petite roue dentée qui s'affiche?
* Si tu regarde le Ajax get_webcam.php qui est appelé il répond quoi?

Merci!

guillaume-rico, 2015-04-22:
Sur le premier onglet : L'engrenage
Sur le deuxième onglet : "Webcam 1 non détectée" . Idem pour onglet 3 et 4
Je regarde pour l'ajax

guillaume-rico, 2015-04-22:
Culticam n'est pas démarré !

ygene, 2015-04-22:
Oui le script n'avait pas les droits d'execution, corrigé dans la nouvelle
version.

2015-04-22 16:04 GMT+02:00 guillaume-rico <notifications@github.com>:

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

guillaume-rico, 2015-05-01:
Lors d'une mise à jour du service cam sur d'antin, j'ai bien récupéré le server. Par contre pas de mise à jour auto. En attente du 02/05 sur LocalTechnique

guillaume-rico, 2015-05-06:
Mise à jour réalisée. pas de trace de la deuxième webcam. Je clos dans l'expectative

Closed 2015-05-06.

Thread 1154 (2015-04-07):

[CULTIPI] Créer un module de gestion de la caméra

GoogleCodeExporter, 2015-04-07:
```
Créer un module de gestion de la caméra

```

Original issue reported on code.google.com by `alliaume...@gmail.com` on 23 Mar 2015 at 8:42

guillaume-rico, 2015-04-09:
Changement dans le code : j'ai remplacé setIntervall par setTimeout

guillaume-rico, 2015-05-02:
Il est mignon, il s'est enlevé de l'assignement !

Closed 2015-05-02.

Thread 1155 (2015-04-07):

[SYNO] Ajouter un bouton pour uploader ses propres images dans les différents dossiers

GoogleCodeExporter, 2015-04-07:
```
Ajouter un bouton pour uploader ses propres images dans les différents dossiers

```

Original issue reported on code.google.com by `alliaume...@gmail.com` on 23 Mar 2015 at 9:49

ygene, 2015-04-17:
Dans l'onglet cultipi on peut uploader ses images (taille max de 300ko et uniquement un type image comme fichier).

L'image est uploadée, par contre si ce n'est pas un png on ne la voit pas. Jte laisse regarder ton code ;).

guillaume-rico, 2015-04-19:
Ok. Deux modifications à réaliser :
 * N'accepter que les formats png, gif, jpeg
 * si l'extension est en majuscule, la mettre en minuscule
 * Dans le cas ou l'utilisateur charge une image pour une prise :
  * l'utilisateur doit charger deux images : une lorsque l'effecteur est en route, une lorsqu'il est éteint
  * Les deux images doivent avoir le même nom modulo _XX avant l'extension.
  * Par exemple ventil_ON.png et ventil_OFF.png

ygene, 2015-04-20:
OK pour le type
Le nom de l'image est passé en minuscule lors de la copie, plus de problèmes d'extension.

Pour le prise, je vais voir...

ygene, 2015-05-05:
A tester

ygene, 2015-05-05:
corrigé

guillaume-rico, 2015-05-06:
Nickel

Closed 2015-05-06.

Thread 1156 (2015-04-07):

[SYNO] Changer la couleur du bouton de mise en route en fonction de l'état de la prise

GoogleCodeExporter, 2015-04-07:
```
CHanger la couleur du bouton de mise en route en fonction de l'état de la prise

```

Original issue reported on code.google.com by `alliaume...@gmail.com` on 23 Mar 2015 at 9:50

guillaume-rico, 2015-06-08:
Implémenté, a tester

ygene, 2015-06-08:
ok

guillaume-rico, 2015-06-08:
J'ai pas commité, comment tu as pu clore ? :-)

ygene, 2015-06-08:
Hum, j'ai regardé que l'image change avec le bouton, mea culpa

2015-06-08 19:22 GMT+02:00 guillaume-rico <notifications@github.com>:

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

Closed 2015-06-08.

Thread 1157 (2015-04-07):

[MAIL] Créer un module d'envoi de mail

GoogleCodeExporter, 2015-04-07:
```
Créer un module d'envoi de mail
```

Original issue reported on code.google.com by `alliaume...@gmail.com` on 23 Mar 2015 at 10:12

guillaume-rico, 2015-04-17:
Le module de mail est créé.
A faire : créé un module de supervision

guillaume-rico, 2015-05-01:
Le module de supervision est en place

Closed 2015-05-01.

Thread 1158 (2015-04-07):

[PLUG] Lors de la sauvegarde de l'onglet prise, il me dit que j'ai une erreur

GoogleCodeExporter, 2015-04-07:
```
Lors de la sauvegarde de l'onglet prise, il me dit que j'ai une erreur

```

Original issue reported on code.google.com by `alliaume...@gmail.com` on 23 Mar 2015 at 2:05

chafoin, 2015-04-12:
ok pour activer/desactiver la regul secondaire.

Par contre il ya un souci sur :+1:
"Capteur(s) utilisé(s) pour la régulation"
Impossible de désactiver le 2eme capteurs, ca ne modifie pas la conf temporaire et je ne peux pas appliquer de modification du coup.(en gros comme la regul secondaire avant correction!)

si tu preferes on peut ouvrir une autre issue et clore celle ci

ygene, 2015-04-15:
Tu peux retster stp? merci!

chafoin, 2015-04-19:
j'ai retesté, je suis embeté !
j'ai actuellement sur ma prise n°2 (capteur n°1 et 2 sur "oui")
Je passe le capteur n°2 sur "non"
Ca charge, me dit modif appliqué sans problème.
Apres ca la fenetre "message du logiciel" m'indique bien que "La configuration utilisée par votre module ne correspond plus à celle du logiciel. Cliquez ici pour synchroniser les configurations du logiciel et du module"

Jusqu'ici ca semble ok.

Je lance winscp et je regarde à ces deux endroits :
* /etc/cultipi/01_defaultConf_RPi/serverPlugUpdate/plg
* /etc/cultipi/conf_tmp/serverPlugUpdate/plg

Dans les deux cas pour le plug2 j'ai
SEN:M110000

Si je ne me trompe pas , cela veut dire que ma modif n'a pas été prise en compte.
Dans le dossier "conf_tmp" j'ai les dossiers "serverCultibox" et "serverMail" (ils ne sont pas présent dans le dossier "01_defaultConf_RPi" )

ygene, 2015-04-20:
Corrigé dans la nouvelle version.

chafoin, 2015-05-02:
c'est tout bon pour moi!
j'ai refait les même type de test avec le ventilateur n°2.

Le bouton pour voir les diffs, m'a bien permis de suivre ce que je faisais !
Plus de souci pour moi , je clos

Closed 2015-05-02.

Thread 1160 (2015-04-07):

[logs] affichage de moyenne de courbe

GoogleCodeExporter, 2015-04-07:
```
On sait jamais, si tu t'ennuies...

Avoir la possibilité d'afficher une moyenne de deux courbes (ou le max/min)

Cela permet d'avoir le climat global de l'espace, et aussi de voir le
"déclencheur" des régulations qu'on applique.

```

Original issue reported on code.google.com by `elchaf...@gmail.com` on 23 Mar 2015 at 5:27

ygene, 2015-07-17:
Evolution cultibox v3

Closed 2015-07-17.

Thread 1162 (2015-04-07):

[syno] pop up de validation de pilotage manuel

GoogleCodeExporter, 2015-04-07:
```
y'a une pop up de validation de manip de pilotage manuel.
C'est pas mal mais elle est pas très jojo pour le moment!

si il était possible d'indiquer le temps qui va s'appliquer, quelle
prise(quitte à),...

Si il était possible de désactiver cette option depuis le menu(qui n'existe
pas encore !).

```

Original issue reported on code.google.com by `elchaf...@gmail.com` on 23 Mar 2015 at 5:47

Closed 2015-07-20.

Thread 1164 (2015-04-07):

[cultipi] possibilité d'avoir la liste de modif pour une "configuration pas à jour"

GoogleCodeExporter, 2015-04-07:
```
lorsque le logiciel indique que la configuration n'est pas à jour, serait il
possible d'avoir une liste des écarts?
pourquoi pas un bouton qui nous genere un petit .txt ou dans la fenêtre
d'info(si ca prend pas trop de place).

sur le logiciel, cote cultipi surtout cela est assez "anxiogène" lorsqu'on est
persuadé de n'avoir rien touché mais qu'une phrase nous indique cela.

En tout cas on en a un peu discuter mais faudra voir aussi un bouton pour
annuler les modifications (et que du coup l'interface se remette à jour avec
les info de la conf cultipi)
```

Original issue reported on code.google.com by `elchaf...@gmail.com` on 25 Mar 2015 at 5:12

ygene, 2015-04-28:
j'ai fais un premiet jet qui sera amélioré.

Jte laisse regarder ;).

guillaume-rico, 2015-04-28:
Quand on clique sur le bouton, il met à jour la conf !

ygene, 2015-04-30:
OK dans la nouvelle version

chafoin, 2015-05-02:
c'est nickel,merci pour le bouton!
 je clos.

Closed 2015-05-02.

Thread 1165 (2015-04-07):

[cultipi] défaut de communication avec un élément

GoogleCodeExporter, 2015-04-07:
```
sur mon syno j'avais tous les éléments prises grisés (défaut de
communication entre le logiciel et l'élément)

J'ai verifié si il n'y avait pas de mise à jour logiciel (sur les conseil de
yann) et cela a presque tout arranger.

J'ai toujours la prise n°2 grisé(défaut de communication entre le logiciel
et l'élément)

Je met le fichier log.
(Il me fait flipper!!faudra m'expliquer ^^)

```

Original issue reported on code.google.com by `elchaf...@gmail.com` on 25 Mar 2015 at 5:22

Attachments:
* [cultipi_](https://storage.googleapis.com/google-code-attachments/cultibox/issue-1165/comment-0/cultipi_)

cultibox, 2015-04-09:
Corrigé depuis le salon

chafoin, 2015-04-12:
il n'y a pas d'explications !
Je n'ai en effet pas revu le souci depuis le salon.
Je clos

Closed 2015-04-12.

Thread 1166 (2015-04-07):

[logs] probleme d'affichage fenetre d'info du pointeur

GoogleCodeExporter, 2015-04-07:
```
assez rapidement lorsque j'affiche plusieurs courbes , je n'arrive plus à
avoir les valeur de plusieurs logs/état de prise/prog de la prise dans la
fenétre d'info du pointeur
```

Original issue reported on code.google.com by `elchaf...@gmail.com` on 25 Mar 2015 at 5:50

chafoin, 2015-04-12:
c'est vraiment agréable pour l'analyse des courbes!
Serait il possible, de me mettre un bouton pour ouvrir ou fermer un fenetre dans laquelle sont affichées ces données.
En gros quelques chose qui ressemble à la boite d'information du logiciel.
Tu peux la deplacer, la redimensionner,...

bha c'est pas indispensable, moi je trouve ca deja nickel!
Je te laisse lire et clore héhé

chafoin, 2015-04-19:
c'est parfait  cette fenetre detachée !
on gagne bcp en clarté, bien joué
Je clos

Closed 2015-04-19.

Thread 1167 (2015-04-07):

[POWER]

GoogleCodeExporter, 2015-04-07:
```
COnfigurer directement les powers lorsque selectionné dans les logs plutôt
que rediriger.
```

Original issue reported on code.google.com by `yann.gen...@gmail.com` on 26 Mar 2015 at 9:35

ygene, 2015-04-28:
A tester, ce qu'il faut faire:

charger une page de log pour une journée ou l'on a des informations de puissance avec une prise qui n'a pas de puissance configurée. Sur ce jour, on selectionne la puissance de la prise (sans puissance) à afficher.

On nous demande alors de renseigner directement la puissance, la courbe doit être réaffichée avec la bonne puissance. Par la suite on ne redemande pas de rentrer la puissance, elle est enregistrée dans la base.

chafoin, 2015-05-02:
c'est beau et ca marche !

Je clos

Closed 2015-05-02.

Thread 1169 (2015-04-07):

[WiFi] Changer le Ad'Hoc en réseau normal

GoogleCodeExporter, 2015-04-07:
```
Changer le Ad'Hoc en réseau normal
```

Original issue reported on code.google.com by `alliaume...@gmail.com` on 28 Mar 2015 at 6:44

ygene, 2015-05-29:
Je clos, je viens de tester avec la nouvelle image. Ca marche au poil.

Closed 2015-05-29.

Thread 1170 (2015-04-07):

[Ad Hoc] Mise à l'heure du RTC

GoogleCodeExporter, 2015-04-07:
```

Mise à l'heure du RTC lors de la première connexion
```

Original issue reported on code.google.com by `alliaume...@gmail.com` on 28 Mar 2015 at 6:52

guillaume-rico, 2015-04-09:
Pour tester que la mise à l'heure est fonctionnelle :
Brancher un module wifi après 20h en mode "je cré mon propre réseau (ex Ad'Hoc)", ouvrir l'interface du logiciel puis vérifier en ssh que l'heure du RTC est correcte. Pour vérifier que l'heure du RTC est bonne :  tclsh /opt/cultitime/getDate.tcl

ygene, 2015-04-20:
J'ai suivis la procédure, l'heure locale est correcte, par contre ta commande renvoie une erreur:

tclsh /opt/cultitime/getDate.tcl
Error: Read failed
    while executing
"exec /usr/local/sbin/i2cget -y 1 0x6f 0x00 b"
    (procedure "::MCP7940N::readSeconds" line 4)
    invoked from within
"::MCP7940N::readSeconds"
    invoked from within
"set rtcHour [::MCP7940N::readSeconds]"
    (file "/opt/cultitime/getDate.tcl" line 9)

On avait pas eu déja une erreur sur l'import d'une libraire? Jte laisse regarder ;)

guillaume-rico, 2015-04-22:
C'est pas un problème de chargement de librairie. Le raspberry n'arrive pas à discuter avec le RTC qui est situé sur notre carte. Question : est-ce que tu as bien utilisé un raspberry avec notre carte dessus ou est-ce que tu as utilisé un RPi nu ?

ygene, 2015-04-22:
J'ai utilisé mon raspberry avec la carte elec branchée dessus.Ca te fait la même chose?

guillaume-rico, 2015-05-01:
Paliatif mis en place

Closed 2015-05-01.

Thread 1171 (2015-04-07):

XMAX - Lors de la sélection de XMAX, bloquer l'image sur XMAX

GoogleCodeExporter, 2015-04-07:
```
XMACS - bloquer le type d'immage [ onglet prise ]
```

Original issue reported on code.google.com by `yann.gen...@gmail.com` on 28 Mar 2015 at 9:18

ygene, 2015-04-16:
Même remarque, quand on selectionne un xmacs tu veux quoi?

guillaume-rico, 2015-06-08:
Lorsqu'on sélection XMAX, le champs type doit être bloqué sur lampe, et l'image dans le synoptique doit être changée pour celle de la XMAX.

A tester

ygene, 2015-06-08:
Ok pour le bloquage en type lampe mais l'image n'est pas celle du XMAS dans le syno

guillaume-rico, 2015-06-08:
J'ai pas encore livré !

2015-06-08 19:03 GMT+02:00 ygene <notifications@github.com>:

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

guillaume-rico, 2015-06-10:
J'ai livré, je te le rends

ygene, 2015-06-11:
Good pas rétroactif mais bon.

Closed 2015-06-11.

Thread 1172 (2015-04-07):

[Changer image synoptique]

GoogleCodeExporter, 2015-04-07:
```
Changer dynamiquement l'image de la prise utilisée en fonction du type.

Si on change le type de la prise, il faudrait que l'image associée soit
appliquée dans le syno.

```

Original issue reported on code.google.com by `yann.gen...@gmail.com` on 28 Mar 2015 at 10:15

guillaume-rico, 2015-06-08:
A tester

ygene, 2015-06-08:
Hummmm nan

ygene, 2015-06-11:
good

Closed 2015-06-11.

Thread 1173 (2015-04-07):

[regul] mauvais fonctionnement pour la regulation sur humidificateur

GoogleCodeExporter, 2015-04-07:
```
j'ai une mauvaise reponse de regul lorsque mon option de regulation est sur
"min" et pas "moyenne" de deux capteurs
```

Original issue reported on code.google.com by `elchaf...@gmail.com` on 31 Mar 2015 at 5:44

chafoin, 2015-04-12:
c'est ok pour moi .
La regul s'effectue bien dans les deux sens et avec la tolerance

Il ya un bug d'affichage par contre
Jeclos celui ci, j'en ouvre un autre!

Closed 2015-04-12.

Thread 1174 (2015-04-07):

[syno] trouver une manière de figer les éléments en fonction de la taille écran

GoogleCodeExporter, 2015-04-07:
```
deja parlé mais pas ouvert:
Il faudrait trouver une astuces pour l'emplacement des éléments dans le syno.

Si on passe d'un ecran PC, à un tabette/smartphone , ca donne des affichages
décalés des éléments
```

Original issue reported on code.google.com by `elchaf...@gmail.com` on 5 Apr 2015 at 9:15

guillaume-rico, 2015-07-20:
Le correctif comporte exactement 18 caractères !

Je te laisse tester

ygene, 2015-07-23:
Jte fais confiance pas de tablette sous la main, on vérifiera à l'occasion

guillaume-rico, 2015-07-23:
Pas besoin de tablette, il suffit de reduire la fenêtre

Guillaume RICO

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

Closed 2015-07-23.

Thread 1175 (2015-04-07):

[logs] chargement de la carte SD sous cultipi

GoogleCodeExporter, 2015-04-07:
```
au passage dans l'onglet logs, on a une page de chargement de la carte SD!
```

Original issue reported on code.google.com by `elchaf...@gmail.com` on 5 Apr 2015 at 9:35

chafoin, 2015-04-12:
c'est tout bon
Je clos

Closed 2015-04-12.

Thread 1176 (2015-04-07):

[CONF] Fréquence de mise à jour

GoogleCodeExporter, 2015-04-07:
```
  La fréquence d'enregistrement du climat est encore utile pour la Cultibox seule. Par contre l'option de fréquence d'enregistrement de la puissance n'a plus aucun intérêt car on enregistre au changement d'état.

  Je suis d'accord pour simplifier et mettre la fréquence d'enregistrement des logs à 1 points par minute.
```

Original issue reported on code.google.com by `alliaume...@gmail.com` on 5 Apr 2015 at 8:10

ygene, 2015-04-16:
a tester dans la 2.0.48

guillaume-rico, 2015-04-17:
Au top

Closed 2015-04-17.

Thread 1178 (2015-04-07):

[admin] verification de mise à jour infini

GoogleCodeExporter, 2015-04-07:
```
je ne sais pas si ma culti est en carafe(wifi allumé led qui clignote et
pilotage est effectif).
lorsque j'ai cliqué que verifier les mise à jour j'ai eu:
"chargement des données , veuillez patienter.."
et puis ca reste comme cela indéfiniment
```

Original issue reported on code.google.com by `elchaf...@gmail.com` on 6 Apr 2015 at 9:30

ygene, 2015-04-15:
Rien trouvé, j'ai testé avec et sans accés ca semble correct. Si ca se reproduit réouvre le moi.

Closed 2015-04-16.

Thread 1180 (2015-04-07):

[Planification d'engrais] Ajouter la gamme Canna Terre

GoogleCodeExporter, 2015-04-07:
```
Ajouter la gamme Canna Terre
```

Original issue reported on code.google.com by `alliaume...@gmail.com` on 6 Apr 2015 at 1:35

guillaume-rico, 2015-04-09:
AJouté dans la nouvelle version.

Philou, je te laisse vérifier et clore

chafoin, 2015-04-12:
ok pour moi.
Ca commence à etre compliqué leur calendrier en fonction des engrais!
quand il te mette +/- 1 à 2 semaines et entre 3à5 ml/L, ils sont sympa !!
En tout cas tu as bien adpaté
Je clos

Closed 2015-04-12.

Thread 1181 (2015-04-07):

[Programme d'engrais] Cultipi : permettre d'importer un programme d'engrais

GoogleCodeExporter, 2015-04-07:
```
Cultipi : permettre d'importer un programme d'engrais

```

Original issue reported on code.google.com by `alliaume...@gmail.com` on 6 Apr 2015 at 1:49

ygene, 2015-04-18:
Ok pour moi jvous laisse tester

guillaume-rico, 2015-04-19:
Après quelques correctif ça me semble OK. Comme j'ai modifié le code, je te laisse retester.
Les deux changements réalisés :
 - Utilisation de copy  à la place de exec mv
 - Surpression de l'écriture sur carte SD dans le cas d'un module wifi

ygene, 2015-04-20:
Ca fonctionne, je clos.

Closed 2015-04-20.

Thread 394 (2015-04-07):

PTS_EMC

GoogleCodeExporter, 2015-04-07:
```
Compatibilité électro-magnétique

spec:
Voir normes IEC

Méthode: verif_EMC
Tester les normes en vigueur en terme de CEM

Matériel :
1 Cultibox Complete
1 Alim
1 Capteur
1 pack de prises de base

```

Original issue reported on code.google.com by `elchaf...@gmail.com` on 4 Mar 2013 at 10:35

guillaume-rico, 2015-06-08:
Abandon

Closed 2015-06-08.

Thread 730 (2015-04-07):

[logs] possibilité de conserver des données après changement de programme, config,...

GoogleCodeExporter, 2015-04-07:
```
Il faut discuter sur:
en faite je dis cela en faisant le malin parce que je sais pas ce que cela
représente mais la possibilité de conserver par exemple: le nombre de prises
déclarées, leur nom, wattage, programme,..
la je vois qd je vais pour charger la sd, je coupe le logiciel et je copie
le(s) dossier(s) mois ou j'ai des logs(comme la culti) mais en plus je prend,
conf, bin,...mais finalllement le logiciel il doit pouvoir le faire non ?
moi je les conserve c'est pour nous, et la possibilité de revenir sur les bugs
et des choses comme cela.

Mais en tant qu'utilisateur ce qui m’intéresse c'est pouvoir comparer les
différentes périodes en terme de logs certes mais aussi en terme de config.
Par exemple:
si je reviens au mois de nov je n'ai plus les mêmes nom de prises et prog
qu'à l'époque du coup des ventilos que j'avais en regul à 26°C sont
dorénavant en régulation à 28 avec des périodes de off,etc .. je n'ai plus
l'info.

De même, pour le calcul du coup théorique les wattage pris pour comparer au
réel sont ceux paramétrées sur le moment, du coup si on regarde sur une
periode ou il y a eu des modifs, les courbes vont très vite se fausser.

Bref à discuter !

```

Original issue reported on code.google.com by `elchaf...@gmail.com` on 26 Dec 2013 at 7:23

guillaume-rico, 2015-06-08:
C'est implémenté. Possibilité de faire une sauvegarde.

Closed 2015-06-08.

Thread 840 (2015-04-07):

[cout] log à la seconde

GoogleCodeExporter, 2015-04-07:
```
suggestion d'un utilisateur:
"J'ajoute un argument sur le log a la seconde (ou du moins plus précis qu'a la
minute): les relevés peuvent être, en fonction du mode de fonctionnement de
la prise, correct ou assez aléatoire. Cas d'une prise qui ne se met en marche
55sec mais a chaque fois entre la minute pile ( ON a 02sec, OFF a 57sec) rien
n'est comptabilisé (j'imagine, j'ai pas vérifier les données)."

Suite à discutions:log à la précision optimum pour le changement des prises!
log de tous changements d'état.En faite tu es en train de faire un usbdio la!

Miam ça va être funky!
```

Original issue reported on code.google.com by `elchaf...@gmail.com` on 22 May 2014 at 6:35

chafoin, 2015-04-19:
je regarderai plus dans le détail!
pour le moment ca semble deja plus coherent.

Par contre, je n'ai aucune valeur affiché pour la prise n°4 entre le 16/04 et le 18/04, ni en réel ni en théorique
ca, ce n'est pas correct !

guillaume-rico, 2015-05-28:
Il y a bien les valeurs entre le 16/04 et le 18/04 ! Tu clos ?

guillaume-rico, 2015-06-08:
Donc je clos

Closed 2015-06-08.

Thread 851 (2015-04-07):

[PLUG] Suppression de la page prise

GoogleCodeExporter, 2015-04-07:
```
Discuter du changement suivant : Pour voir changer la configuration des prises
directement en ajax dans la page programme avec une fenêtre d'option qui
s'affiche.

```

Original issue reported on code.google.com by `alliaume...@gmail.com` on 3 Jun 2014 at 8:51

ygene, 2015-04-15:
A tester dans la nouvelle version

guillaume-rico, 2015-04-15:
C'est très mignon.

La fenêtre qui s'affiche est beaucoup trop large.
J'ai maintenant deux onglets prises ! Alors qu'un des deux doit être programme.
Quand on change le type branché dessus (j'atais en autre et je suis passé en CO2), j'ai bien le message qui s'affiche mais je ne reviens pas sur le bon élément de la liste.
Quand je clique sur "enregistrer", le UIblock n'est pas au bon endroit (la fenêtre n'est pas bloquée)

Sinon, c'est au top

ygene, 2015-04-16:
J'ai reduis un peu la taille de la fenêtre je peux pas faire mieux, il faut laisser de la place pour les messsages d'erreur

J'ai nommé l'onglet prise plutôt que programme, je me dis que les gens quand ils veulent configurer une prise, ben ils cliquent sur prise nan?
Normalement tu dois n'avoir qu'un seul onglet, met à jour et vérifie stp.

J'ai corrigé le problème du changement de type, verifie stp

Idem pour le uiblock

A vérifier/discuter dès que j'aurais commité!

guillaume-rico, 2015-04-19:
Pour le changement de type d’élément c'est mieux mais c'est pas encore ça ! Je te laisse tester : enregistre une prise comme lampe. Ré ouvre la pop up et change le type à ventilateur. annule lorsque la pop up s'ouvre : tu te retrouve à pouvoir modifier les options de régulation sur une lampe !

nom et nombre d'onglet : OK

UIblock : OK

ygene, 2015-04-20:
Revérifie dans la nouvelle version mais j'ai pas le problème.

Ce que j'ai fait exactement: prise 9 enregistrée comme lampe, j'enregistree, la popup se ferme.
Je la réouvre, je passe sur la prise 9, je passe le type à ventilateur mais j'annule.
Je réouvre la popup, la prise est sur type lampe et j'ai pas accès à la régulation.

C'était ca le test?

guillaume-rico, 2015-04-22:
C'est presque ça !
Les deux premières lignes OK. Une fois que tu annules, tu as les infos pour la régul secondaire.

ygene, 2015-04-23:
Ok a vérifier dans la nouvelle version

guillaume-rico, 2015-05-01:
Nickel

Closed 2015-05-01.

Thread 889 (2015-04-07):

[culti] ecran principal : affichagesymbol lune

GoogleCodeExporter, 2015-04-07:
```
Quelle est la procédure pour reproduire le problème?
1.
2.
3.
...

Quel est le résultat attendu? Qu'avez vous à la place?

Quelle version du logiciel / Cultibox utilisez-vous?

Sur quel système d'exploitation?

Indiquez les informations supplémentaires ci-dessous:

```

Original issue reported on code.google.com by `alliaume...@gmail.com` on 2 Jul 2014 at 10:52

guillaume-rico, 2015-06-08:
On abandonne.

Closed 2015-06-08.

Thread 963 (2015-04-07):

[ALARME] Tracer dans les logs la mise en route de l'alarme

GoogleCodeExporter, 2015-04-07:
```
Tracer dans les logs la mise en route de l'alarme
```

Original issue reported on code.google.com by `alliaume...@gmail.com` on 27 Oct 2014 at 1:18

guillaume-rico, 2015-06-08:
Ok, je t'épargne le re-test

Closed 2015-06-08.

Thread 1182 (2015-04-12):

[wifi] perte de la connection suite à une mise à jour de la freebox

chafoin, 2015-04-12:
Vers 00h00 j'ai eu une maj de ma freebox et à partir de se moment je n'ai plus reussi à me connecter à l'adresse :
*http://192.168.0.11/cultibox/
*http://cultipi.local/cultibox

J'ai mis adresse fixe lors de l'installation avec 192.168.0.11

Pas de reponse au ping non plus (192.168.0.11 et + , ainsi que cultipi.local qui n'a plus l'air d'eter d'actualité).

J'ai attendu de voir si elle fonctionnait tout de meme (visiblement oui )
Je l'ai donc debranché/rebranché avec son cable d'alimentation.
Toujours pas d'accés au logiciel.
Par contre réponse au ping sur 192.168.0.11.
Le pilotage s'effectue toujours mais pas d'accés.

Le lendemain, accés à l'interface sans souci sur 192.168.0.11/cultibox/ .
Sur les logs je vois qu'elle a fait un restart toute seule à 4h30!

J'installe winscp et je te met les logs avec!

chafoin, 2015-04-12:
hum, je ne peux pas attacher de fichier autre que png gif ou jpg rumpf...
je te le met par mail pour le moment

ygene, 2015-04-16:
J'ai eu des problèmes de connexion suite aux MAJ de ma box aussi, perte de connexions quelques minutes mais la culti s'est retrouvée toute seule au bout de quelques minutes. Le temps du cron.
J'ai regardé tes logs sur le cultipi, il n'arrive pas à se connecter tout simplement.
Je ne peux pas faire grand chose la dedans, l'important c'est que le pilotage continue le temps que le cultipi retrouve le réseau.

Je met en won't fix si ca se reproduit, ben on véra... parceque je sais pas trop quoi faire.

Closed 2015-04-16.

Thread 1183 (2015-04-12):

[logs] affichage d'une courbe de puissance réel en régulation

chafoin, 2015-04-12:
Vu sur l'humidité qui est en regulation à 58% mais jamais atteinte.
La prise est donc en fonctionnement permanent de la plage 6h - 18h
Lorsque j'affiche le grpah et demande les logs puissance , j'ai juste un segment qui monte à 6h et plus rien.
Si je regarde le jour precedent j'ai bien le creneau(car le point de 18h a été "marqué".)

ygene, 2015-04-16:
Désolé, toujours la même demande, tu peux m'exporter (avec la nouvelle version), les logs power de ces deux journées que je puisse tester? merci.

chafoin, 2015-05-01:
les logs ont été envoyés par mail il y a quleques jours, je te rend l'issue.

ygene, 2015-05-04:
Corrigé, à tester sur la nouvelle version.

guillaume-rico, 2015-05-28:
Y a plus le pb

Closed 2015-05-28.

Thread 1184 (2015-04-17):

[DOC] Remettre le bandeau supérieur qui permet d'avoir accès aux menus

guillaume-rico, 2015-04-17:
Remettre le bandeau supérieur qui permet d'avoir accès aux menus

ygene, 2015-04-17:
Un onglet est ouvert pour le menu maintenant, ce qui permet d'avoir l'interface et la partie sur laquelle on veut la documentation et la documentation ouverte, pour moi pas besoin du menu.

Dis moi si ca te convient ainsi.

guillaume-rico, 2015-04-17:
Ok, je clos

Closed 2015-04-17.

Thread 1185 (2015-04-17):

WIZARD : Chargement infini

guillaume-rico, 2015-04-17:
Dans la dernière version, le wizard ne s'affiche jamais

ygene, 2015-04-17:
Même remarque que pour le syno, testé chez moi et chez philou, ca fonctionne.

Plus d'infos?

guillaume-rico, 2015-04-19:
J'ai corrigé tout seul comme un grand !
Le problème était présent sur une installation fraiche

Closed 2015-04-19.

Thread 1186 (2015-04-17):

SYNO : Impossible de changer d'image !

guillaume-rico, 2015-04-17:
Lorsque je souhaite changer d'image ça ne marche plus. T'as tout cassé !

ygene, 2015-04-17:
Je viens de tester chez moi et dans le syno de philou, pour les prises, capteurs et les 'others' ca fonctionne, j'ai pas touché ce code la.

Tu peux m'en dire plus?

guillaume-rico, 2015-04-19:
Le problème n'est présent que dans chrome. Je vois pas d'erreur et je comprend pas pourquoi...

ygene, 2015-04-20:
Marrant on dirait le problème du salon... je vais jeter un oeil.

ygene, 2015-04-22:
Corrigé, le blockUI posait problème. J'ai remplacé le blocUI par un modal sur e dialog quand il s'ouvre.
Ca fonctionne. Utilise le modal plutot quand tu dois ouvrir une boite de dialogue. Jte laisse vérifier

guillaume-rico, 2015-05-01:
Nickel

Closed 2015-05-01.

Thread 1187 (2015-04-19):

[wifi] ajout d'un bouton pour maj firmware cultibox

chafoin, 2015-04-19:
Je sais pas si tu ne peux pas plutot gerer la maj du firm cultibox comme le reste en automatique?
Apres cette maj est probablement plus "risqué" et j'avoue que le bouton manuel me parait plus sécuritaire !

guillaume-rico, 2015-04-19:
Impossible de gérer la mise à jour du firmware en auto : la carte SD est dans l'ordinateur client, le firmware dans le module wifi !

Yann, je te laisse confirmer

guillaume-rico, 2015-04-19:
par contre, il faut ajouter un bouton pour que l'utilisateur puisse télécharger un des deux firmwares pour les coller sur sa carte SD.

ygene, 2015-04-20:
En effet on ne peut que faire télécharger le firmware. La copie sur la carte SD doit être réalisée manuellment.

Dans la partie administration de l'onglet configuration il y a deux icônes, une pour le firmware wifi et une pour le firmware de la cultibox (si on veut revenir en arrière).

Je vous laisse tester.

ygene, 2015-04-28:
Je clos.

guillaume-rico, 2015-04-28:
On laisse ouvert, a priori ça marche pas chez philou... Il récupoère un firmware mais pas le bon

chafoin, 2015-05-02:
ok pour moi:
Les boutons marchent, et fournissent bien un firm fonctionnel.

Cependant, ce n'est pas tres clair !
(je ne sais pas si il va y avoir beaucoup d'utilisateur et si il faut y passer du temps)

*Les pop up d'aide peuvent etre mal interpretées.
*Le fichier recuperer pour : "telecharger le firmware du module wifi" s'apelle firm_wifi.hex.
Il va falloir que l'utilisateur supprime manuellement le "_wifi" si il veut charger quelque chose.

Serait il possible d'avoir une pop up qui avec validation de la presence de la SD et ca exrase tout seul le fichier firm.hex
dans la pop up tu ecris du cultibox --> cultibox+wifi ou cultibox+wifi --> cultibox

Si c'est trop compliqué à mettre en place, je crains qu' il faille éviter que l'utilisateur tente quelque chose tout seul!

guillaume-rico, 2015-05-02:
J'ai corrigé un des points : le nom du fichier est maintenant toujours firm.hex

Impossible d'avoir la pop-up avec la carte SD, le logiciel n'est toujours pas installé sur l'ordi du client !

Je propose les modifications suivantes :
  * Un seul bouton pour télécharger le firmware
  * Lorsque l'utilisateur clique sur le bouton, une fenêtre s'ouvre lui indiquant la marche à suivre.
     * Texte : Une fois le firmware téléchargé, veuillez le copier à la racine de la carte SD de la Cultibox.
     * Un bouton est présent pour télécharger le firmware
      * Plus bas un deuxième texte : Les utilisateur expérimenté peuvent revenir à l'ancien mode de fonctionnement de la Cultibox en téléchargeant le firmware ci-dessous.

ygene, 2015-05-03:
Hummm ca fait doublon un peu avec le bouton permettant passer d'un mode à l'autre qui doit être fait nan? J'y réfléchis mais on va fusionner les deux je pense.

ygene, 2015-05-06:
A tester

chafoin, 2015-05-09:
ok pour moi.
Cependant, les textes dans la pop up ne sont pas clair je pense:
titre:"telecharger le firmware de la cultibox"
"Une fois le firmware téléchargé, veuillez le copier à la racine de la carte SD de la Cultibox: "
"Les utilisateurs expérimentés peuvent revenir à l'ancien mode de fonctionnement de la Cultibox en téléchargeant le firmware ci-dessous :"

"mise à niveau de la cultibox en Wifi"
" (en gras) *si vous avez le module cultipi wifi*, pour l'activer : veuillez copier le fichier téléchargé (firm.hex) à la racine de la carte SD de la Cultibox"
" (en gras) *Les utilisateurs expérimentés* peuvent revenir à l'ancien mode de fonctionnement de la Cultibox en téléchargeant le firmware ci-dessous :"

Désolé, ca mégote un peu, mais je suis sur que certains vont tester sans le module, en pensant que la cultibox seul peut passer en wifi !
(oups c'etait pas à moi !)

ygene, 2015-05-21:
Corrigé

Closed 2015-05-21.

Thread 1189 (2015-04-20):

[cultipi] perte de controle : plug x programme is empty

chafoin, 2015-04-20:
A 1h la lampe n°3 ne s'est pas allumé.
Sur le logiciel, le syno indique en effet que rien ne tourne.
La culti semblait fonctionner normalement.
L'heure indiqué par le petit logo "lecture" vert en haut à droite du syno m'indiquait l'heure correct.

Je m'en suis rendu compte après 1 h du matin, J'ai simpolement fini pa cliquer sur le bouton pour redémarrer ma culti depuis config> admin et c'est reparti!

Voila ce que j'ai trouvé dans les logs(j'nvoie le reste par mail)

00:00:00.20	serverPlugUpdate	info	plugv -0420-
20/04/2015 00:00:00.172	serverHisto	error	::sql::addPlugState : unknow state
20/04/2015 00:00:00.186	serverHisto	error	::sql::addPlugState : unknow state
20/04/2015 00:00:00.242	serverHisto	error	::sql::addPlugState : unknow state
20/04/2015 00:00:00.280	serverHisto	error	::sql::addPlugState : unknow state
20/04/2015 00:00:00.350	serverHisto	error	::sql::addPlugState : unknow state
20/04/2015 00:00:00.386	serverHisto	error	::sql::addPlugState : unknow state
20/04/2015 00:00:00.452	serverHisto	error	::sql::addPlugState : unknow state
20/04/2015 00:00:00.655	serverPlugUpdate	info	plugv filename : plu00
20/04/2015 00:00:03.643	serverPlugUpdate	error	Plug 1 programme is empty
20/04/2015 00:00:03.653	serverPlugUpdate	error	Plug 2 programme is empty
20/04/2015 00:00:03.659	serverPlugUpdate	error	Plug 3 programme is empty
20/04/2015 00:00:03.663	serverPlugUpdate	error	Plug 4 programme ...

guillaume-rico, 2015-04-22:
Ok, j'ai compris : Je vous refait l'historique :
Il est 23:59:59.998 , j'entre dans la fonction emeteur_update_loop . Je sauvegarde l'heure en seconde (86399)
Il est 00:00:00.002 , je teste si on a changé de jour : Oui c'est bien le cas !
Je recharge mon fichier de programme puis j'applique pour tout le monde le prgramme . Je cherche donc quelle action est strictement supérieur à 86399 pour trouver l'action précédente : Je trouve rien (c'est normal !) Et donc je pine tout !!!

J'ai corrigé le fonctionement et ajouté des tests de vérifications.

Phliou, ça me semble être très dur à vérifier. Je suis très confiant dans mon hyopthese de travail. Je te propose de le clore si ça te va.

chafoin, 2015-05-01:
cela me va et ne s'est pas reproduit.
On clos de toute facon on reste à l'affut!

Closed 2015-05-01.

Thread 1190 (2015-04-23):

[CONF] Ajout de la configuration mail

guillaume-rico, 2015-04-23:
Dans la section configuration, l'objectif est d'ajouter la configuration mail pour envoyer des mails.
Les champs sont au nombres de 4 :
 - Selection du fournisseur de mail (une liste de 22 possibilités, disponible à l'adresse suivante : www.serversmtp.com/fr/liste-serveur-smtp + une dernière possibilité "autre")
 - Un champ avec le nom du serveur smtp. Ce champs est grisé et non éditable par défaut sauf si l'utilisateur choisit l'option "Autre" du champs d'avant
 - Numéro du port : par défaut 587 . L'autre option est 25
 - Adresse mail : champ éditable de 40 caracteres
 - mot de passe : champ éditable de 40 caracteres

Lorsque l'utilisateur enregistre, cela cré le fichier conf.xml dans le dossier serverMail de la conf

guillaume-rico, 2015-04-23:
Un exemple de fichier xml est disponible dans cultipiCore/serverMail/confExample

guillaume-rico, 2015-04-29:
A tester !

guillaume-rico, 2015-05-01:
Il fait le job !

Closed 2015-05-01.

Thread 1191 (2015-04-25):

[CULTIPI] Donner les droits à la commande reboot pour l'utilisateur cultipi

guillaume-rico, 2015-04-25:
Dans le cadre de la supervision, l'utilisateur peut déclencher un reboot du système si certaines conditions ne sont plus présentes. Par exemple si le boitier ne ping plus google. J'ai donc besoin de la commande reboot pour redémarrer le bouzioux

ygene, 2015-04-27:
OK avec les nouveaux paquets, la commande est shutdown, elle permet plus de choses, pour rebooter:

sudo /sbin/shutdown -r now

guillaume-rico, 2015-05-01:
Ok intégér dans le code

Closed 2015-05-01.

Thread 1193 (2015-04-25):

[DOC] Raccourci pour la console

guillaume-rico, 2015-04-25:
Peux tu ajouter dans la doc le raccourci pour ouvrir la console ?

ygene, 2015-04-28:
Je rajoute: refaire la doc avec le nouveau logiciel.

guillaume-rico, 2015-06-14:
Alt C !

ygene, 2015-07-29:
Rajouter doc cultiraz

Thread 1195 (2015-05-01):

[logs] perte de logs de puissance

chafoin, 2015-05-01:
Je n'ai plus de logs de puissance affiché bien qu'activé dans l'interface.
Cela aussi sur les jours précédent jusqu'au 28 avril
Si mes souvenirs sont bon j'ai fait une maj le 28 avril justement.
Je t'envoie un export du 26 au 30 avril

ygene, 2015-05-04:
Je viens d'importer tes logs, j'ai bien des enregistrements pour le 26 et 27, rien pour le 28 mais les logs du 28 au 30 sont vides.

Si tu as un problèmes avec l'affichage des logs du 28-30 tu peux transférer à Al, dans ta base (enfin ce que tu m'as envoyé) les données sont vides, ce n'est pas un problème d'affichage mais d'enregistrement ==> pour al

Les enregistrements du 26,27 fonctionnent, il faut parfois attendre quelques secondes que la courbe s'affiche mais pour moi ca fonctionne. Je te le transmet.

guillaume-rico, 2015-05-28:
A priori corrigé. Philou, tu confirmes ?

guillaume-rico, 2015-05-28:
On clos

Closed 2015-05-28.

Thread 1196 (2015-05-01):

[cultipi] gestion des état d'erreur

chafoin, 2015-05-01:
C'est difficile à expliquer:
J'ai eu un redémarrage de la culti vers 22h le 30 avril
j'ai moins meme redémarré ma culti(direct au cable secteur) à 1h46 le 01 mai au matin

J'ai fait ce reboot manuel car j'avais l'impression que la culti ne repondait pas (desolé je venais de ma reveiller, je ne me rappelle pas de tout mais il me semble que depuis le pc du salon les allumage manuel de ventilo ne marchait pas)

Dans les logs je retrouve beaucoup de :
serverAcqSensor	error	default when reading valueHP of sensor SHT index 1 (adress module : 0x01 - register 0x20) message:-Error: Write failed-

J'enoie les logs par mail.

guillaume-rico, 2015-05-01:
J'ai pas de log entre 1h35 et 1h46. Pas de trace de tentative de pilotage manuel.
J'avais plus de demande d'information de la part du synoptique depuis 00:02.

Pour le deuxième point, je retrouve bien les différentes erreurs de lecture, mais le soft a bien géré dans tous les cas. Pour moi c'est normal a part que je vois une accélération du nombre de cas le 01/05.

chafoin, 2015-05-02:
ok pour l'explication.
de toute manière je retrouverai le probleme si il existe encore.
Je clos ceci

Closed 2015-05-02.

Thread 1197 (2015-05-02):

[cultipi] information du bouton :"afficher les differences"

chafoin, 2015-05-02:
v2.0.48-r1505011427  GPL-V3

j'ai beau faire ma synchro, des que je change d'onglet, le logiciel m'indique que je ne suis plus synchronisé.
En écart il me donne :
Only in /etc/cultipi/01_defaultConf_RPi/serverCultibox: conf.xml
Only in /etc/cultipi/01_defaultConf_RPi: serverIrrigation

Je dois faire une copie à la main à la fin?

Sur winscp:
* je vois bien que j'ai le dossier "serverIrrigation" dans ma conf appliqué (01_defaultConf_RPi) mais le dossier n'existe pas dans ma conf temporaire (conf_tmp)
*idem pour le fichier "conf.xml" dans le dossier "serverCultibox"
*j'ai un nouveau dossier dans /etc/cultipi/ qui s'apelle 01_defaultConf_RPi.new

guillaume-rico, 2015-05-02:
C'est que la conf n'a pas été enregistrée :
 * Lors de l'upgrade, les dossiers serverCultibox et serverIrrigation on été copié dans 01_defaultConf_RPi mais pas dans conf_tmp
 * Lorsque tu synchronise, tu copies ce qui est dans conf_tmp dans 01_defaultConf_RPi
 * Mais ca ne copie pas dans l'autre sens !

Dans ton cas : clique sur enregistrer dans l'onglet configuration

Pour yann : Pour chaque dossier présent dans conf_tmp :
 * Vérifier qu'il est présent dans 01_defaultConf_RPi
    * Si oui : vérifier que chaque fichier présent dans conf_tmp est bien présent dans  01_defaultConf_RPi et que c'est le même

chafoin, 2015-05-02:
"Dans ton cas : clique sur enregistrer dans l'onglet configuration"
Deja effectué auparavent pour justement avoir 10 prises.
Je viens de tester de nouveau ca change pas!
Je vais attendre la prochaine maj simplement

guillaume-rico, 2015-05-02:
Ok, j'ai compris. A tester dans la prochaine version.

chafoin, 2015-05-09:
c'est pas mal, cependant je ne comprend pas tout!
la, actuellement j'ai ca :
    La configuration n'existe pas.
    La configuration de l'irrigation n'est pas à jour.
    La configuration des mails n'est pas à jour.
    La configuration de la supervision n'est pas à jour.

ok pour les 3 "conf pas à jour" je crois que c'est le smodif que vous faites.
Par contre " La configuration n'existe pas" ca met pas en confiance !!

guillaume-rico, 2015-05-09:
Qaund tu clique sur mettre à jour la conf, ça corrige bien les trois derniers points ?

guillaume-rico, 2015-05-09:
J'ai livré un correctif pour "La configuration n'existe pas."

guillaume-rico, 2015-05-28:
Nickel, je clos

Closed 2015-05-28.

Thread 1198 (2015-05-04):

Rotation images synoptique

ygene, 2015-05-04:
La rotation des images du synoptique ne marchent plus.

guillaume-rico, 2015-05-20:
Corrigé

ygene, 2015-05-21:
nop toujours pas. Rien ne rotationne chez moi!

guillaume-rico, 2015-05-21:
Vide ton cach, up ton code, Vérifie si le css "page_cultipi.css" est bien chargé dans ton navigateur. Je te garantie que ça marche (je paye ma pizza sinon !)

ygene, 2015-05-21:
On a raté une pizza... domage.

Closed 2015-05-21.

Thread 1199 (2015-05-08):

CreatePackage : différencier les paquets

guillaume-rico, 2015-05-08:
Lorsqu'on génère les paquets pour l'un des trois dépôts, Jenkins régénère l'ensemble des paquets en changeant le numéro de version. Ce qui veut dire que si on génère une nouvelle version sans changer forcement tous les paquets, il régénère tout et les RPi téléchargent tous les nouveaux paquets...

J'aurais bien fait la modif moi même mais j'ai peur de me rater...

Deux solutions pour changer ce fonctionnement :
 * Ajouter un paramètre pour sélectionner les paquets qu'on veut construire
 * Créer un deuxième build qui permet de construire un paquet de façon individuel

ygene, 2015-05-15:
A tester, il  y a un paramètre lors du build ou l'on choisis tous les paquets ou plusieurs paquets.

guillaume-rico, 2015-05-20:
Au top

Closed 2015-05-20.

Thread 1201 (2015-05-09):

[logs] mesure d'humidité à 20 millions de HR%

chafoin, 2015-05-09:
Suite au premier retour sur les problèmes de mesures HR%, j'ai encore quelques points à 20 000 000 %HR
occurence : au moins une fois par jour pour un des 3 capteurs

C'est un peu contraigant pour voir la courbe avec cette échelle de mesure derriere !

guillaume-rico, 2015-05-20:
Correctif mis en  place

guillaume-rico, 2015-05-21:
Pas de problème depuis le 18/05. Je te laisse clore ?

guillaume-rico, 2015-05-28:
Je clos

Closed 2015-05-28.

Thread 1202 (2015-05-13):

[logs] Pas de logs de puissance

chafoin, 2015-05-13:
Je n'ai plus de log de puissance depuis une 15ene de jours (il me semble)
La base des puissances ne se remplit pas. Aucun enregistrement depuis cette modif.

chafoin, 2015-05-13:
j'ai un jours de logs de puissance le 05 mai et sinon rien pour le mois.
Tout est bon pour le mois d'avril j'ai 100% de logs puissance.

chafoin, 2015-05-13:
pardon :
pour le mois d'avril ok jusqu'au 27 avril
NOK pour le 28-30 avril

guillaume-rico, 2015-05-20:
A priori c'est bon,

  Je te laisse vérifier

guillaume-rico, 2015-05-21:
Il manque le premier point de la journée

guillaume-rico, 2015-05-28:
C'est bon, je clos

Closed 2015-05-28.

Thread 1203 (2015-05-17):

[DEPOT TEST] Permettre au utilisateur d'y avoir accès

guillaume-rico, 2015-05-17:
Pour simplifier les mises en services d'une nouvelle version, ce serait bien qu'un panel de nos utilisateurs puissent avoir accès au version du dépôt de dev.

On peut ajouter une case a cocher pour y avoir accès ?

ygene, 2015-06-29:
A tester

ygene, 2015-06-29:
Fonctionnement:

* Option disponible si on est en mode "options avançées"
* Quand on clic sur les mises à jours on a un dialogue box qui s'ouvre avec l'option

guillaume-rico, 2015-07-16:
C'est louche, sur ma culti, la check box ne s'affiche pas...

ygene, 2015-07-17:
Il faut activer le mode expert.

guillaume-rico, 2015-07-20:
Nickel, je clos

Closed 2015-07-20.

Thread 1205 (2015-05-20):

[HTTPS] Donner la possibilité au client de communiquer en HTTPS

guillaume-rico, 2015-05-20:
Donner la possibilité au client de communiquer en HTTPS

Par exemple, un bouton permettant d'utiliser l'interface en HTTPS

ygene, 2015-05-20:
Toujours pareil, je peux, mais le certificat utilisé demandera à l'utilisateur de l'accepter avec la belle présentation qui annonce que ce site peut être malveillant.

guillaume-rico, 2015-05-20:
Je sais, mais c'est important que l'utilisateur puisse utiliser une connexion sécurisée

ygene, 2015-05-22:
A tester, ca fonctionne pour moi sur chrome et firefox.
Dans la partie administration de la configuration il y a une icone pour passer de l'un à l'autre. A bouger dans "réseau" peut être.

guillaume-rico, 2015-05-28:
Je vois pas le bouton !

ygene, 2015-05-29:
Dans configuration -> réseau!!

guillaume-rico, 2015-05-29:
Ou ?

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

ygene, 2015-05-29:
A tester.

ygene, 2015-06-05:
ok!

Closed 2015-06-05.

Thread 1207 (2015-05-20):

[MIGRATION] Realiser deux fois le check a une d'intervalle

guillaume-rico, 2015-05-20:
Réaliser deux fois le check a une d'intervalle
(Pour mettre a jour ce qui a été mis à jour avec culti_conf)

ygene, 2015-05-21:
a tester.

guillaume-rico, 2015-05-21:
Pas facile a tester !
Si tu l'a fait, je te crois. Tu payera les croissants si lors de la migration nationale de nos clients, certains n'ont pas les deux mise à jour de faites !
Je te laisse clore

ygene, 2015-05-21:
ok

Closed 2015-05-21.

Thread 1208 (2015-05-21):

[cultipi] probleme de pilotage de la prise n°6

chafoin, 2015-05-21:
ce matin j'avais la prise n°6 qui indiquait etre ON mais qui ne l'était pas !
J'ai essayé de la piloter manuellement, pas de résultat. pas de souci apparent sur le syno
Apparemment pas de probleme pour le autres prises, programme et pilotage mano ok.

Je l'ai branché en direct pour la journée. Il faut aussi que je vérifie si la prise n'a pas simplement claqué

chafoin, 2015-05-21:
j'ai fait bouger un switch derriere la prise ....
c'est tout bon !

Closed 2015-05-21.

Thread 1209 (2015-05-21):

Webcam - rafraichissement

ygene, 2015-05-21:
Une image s’affiche mais ne se met pas à jour ou très lentement, les curseurs luminosité/contraste non pas d’influence sur l’image j’ai l’impression.
Lorsque l’image se met à jour quand ca arrive, c’est toute la fenêtre “popup” qui se recharge, pas seulement l’image.

ygene, 2015-05-22:
Dans culticam.tcl il faudrait modifier le fonctionnement:

Dans la procédure takePhoto je vois deux fois la commande fswebcam, normal?
Sinon peut on vérifier que le fichier /dev/videoX est présent et s'il ne l'est pas on ne lance pas le fswebcam?

Le X correspondant au numéro de la webcam (0, 1, 2 ou 3).
Merci.

guillaume-rico, 2015-05-22:
C'est normal qu'il y ait deux fswebcam:
 - Le premier permet de prendre la photo journalière
 - Le deuxième permet de prendre l'image visualisée dans l'interface web

J'ai modifié le comportement pour ne rien prendre du tout si /dev/videoX n'existe pas

Je te laisse tester

ygene, 2015-06-11:
Avant de sortir une prochaine version il faudrait modifier le comportement de culticam de la sorte:

* Une boucle cyclique tourne
* On scrute le répertoire /var/lock
* SI le fichier culticam_snapshot et présent, on récupère la valeur présente dans le fichier puis on lance la commande:

exec sudo fswebcam -c  /etc/culticam/webcam<valeur du fichier>.conf

on finit en supprimant le fichier /var/lock/culticam_snapshot
* Si le fichier culticam_stream existe on lance la commande:

/etc/init.d/motion start

on finit en supprimant le fichier  /var/lock/culticam_stream

* SI le fichier culticam_disable existe:

on lance la commande /etc/init.d/motion stop et on supprime le fichier  culticam_disable

Si tu peux me faire ca rapidement ca me permettrait de finir d'intégrer les modifs.
Merci!!

ygene, 2015-06-12:
Ok je clos

Closed 2015-06-12.

Thread 1212 (2015-05-21):

[cultipi] ON/OFF rapide et impromptu sur prise en regulation

chafoin, 2015-05-21:
J'ai des déclenchements inopinés et très bref d'une prise.
C'est une prise pour ventilation/extraction, en régulation primaire pendant ces période de déclenchements, et régulation secondaire activée.
Lorsque je regarde les logs je ne vois pourtant rein de particulier.

Pour ma part, je soupçonne le coup de l'humidité à 20 000 000%.
Certes je ne les vois pas s'afficher sur la courbe de logs, mais que reçoit la cultipi?
Le passage On/Off et parfois en dessous de la seconde je pense!

guillaume-rico, 2015-05-22:
C'est quelle prise ?

cultibox, 2015-05-22:
c'est la prise n°2
On voit l'effet entre 18h et 6h (la nuit quoi !)

2015-05-22 8:46 GMT+02:00 guillaume-rico <notifications@github.com>:

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

guillaume-rico, 2015-05-22:
Penses au logs la prochaine fois !

guillaume-rico, 2015-05-28:
A tester !

guillaume-rico, 2015-06-08:
On clos, le pb n'est plus présent

Closed 2015-06-08.

Thread 1213 (2015-05-26):

[syno] - Ajout d'image - seul les pngs sont pris en compte

ygene, 2015-05-26:
Quand on upload une image de type other seul les pngs sont pris en compte, il faut ouvrir aux png jpeg, jpg et gif.

(même chose pour les capteurs, j'imagine pareil pour tout en fait).

guillaume-rico, 2015-05-28:
Corrigé, a tester

ygene, 2015-05-29:
JPEG marche maintenant pour les capteurs mais pas pour le type "autre" (tente, plante, etc...).

guillaume-rico, 2015-05-29:
J'ai rendu le code insensible a la casse. Je te laisse tester

ygene, 2015-06-02:
BIen tenté. Pour les images dans autres: ni jpeg, ni jpg, ni gif ne sont pris en compte. Si je modifie manuellement l'extension du fichier dans images-syno-other/ en png, ca fonctionne.

ygene, 2015-06-02:
Bien tenté bis:

C'est ok pour les capteurs et les plugs mais pas pour le type 'others'.
ni jpeg, ni jpg, ni gif ne sont pris en compte. Si je modifie manuellement l'extension du fichier dans images-syno-other/ en png, ca fonctionne.

Quand je dis ca fonctionne cela veut dire que quand je clic sur l'icône ajouter un élément je vois ma nouvelle image. Si elle n'est pas en png je ne la vois pas.

guillaume-rico, 2015-06-02:
Exact, elle n'est pas présente dans ajouter un élément ! Je n'avais pas vu que tu parlais de cette fenêtre....

ygene, 2015-06-04:
Ca roule!

Closed 2015-06-04.

Thread 1214 (2015-06-14):

[MISE A JOUR FIRMWARE] Procédure

guillaume-rico, 2015-06-14:
Lors du téléchargement d'un nouveau firmware, Ouvrir un pop up qui indique la procédure :
- Copier le firmware à la racine de la carte SD de la Cultibox
 - Débrancher la Cultibox du module WiFi
 - Insérer la carte à l'intérieur de la Cultibox
 - Brancher une alimentation électrique à la Cultibox (soit avec le chargeur d'origine et le câble USB d'origine, soit en branchant directement le câble USB d’origine entre la Cultibox et un ordinateur)
 - Au démarrage la Cultibox va mettre le firmware a jour. Attention, il ne faut surtout pas débrancher durant cette mise à jour sous peine de voir sa Cultibox inutilisable
 - Une fois la mise a jour terminée, on peut rebrancher la Cultibox au module WiFi comme avant la mise à jour.

ygene, 2015-07-03:
A vérifier

guillaume-rico, 2015-07-16:
Je te laisse ajouter le texte demandé plus haut !

ygene, 2015-07-17:
C'est déja en place, je te l'ai mis en totest... ben pour tester.

guillaume-rico, 2015-07-17:
J'ai testé et le texte demandé n'est pas présent. C'est pour ça que je te l'ai ré-attribué !

ygene, 2015-07-17:
Testé, ca marche:

tu vas dans l'onglet configuration -> tu click sur la cultibox qui t'affiche les firmwares disponbiles -> tu click sur le premier télécharger le firmware (celui du wifi) et la le téléchargement apparaît et avec un boite de dialogue expliquant le texte ci dessus.

Testé sous linux/windows/firefow/chrome... tu dois pas être au bon endroit.

ygene, 2015-07-17:
onglet configuration puis administration!

Closed 2015-07-17.

Thread 1215 (2015-07-22):

[ URGENT !] Modification des fichiers du RPi

guillaume-rico, 2015-07-22:
Liste des modifs a appliquer dans l'image
Modification des fichier du raspberry :

The Raspberry Pi has a breakout header that has two pins for Tx/Rx but they are set by default to send out debug information about the device. We
need to disable that, so that we can use it to talk to a sensor.
To do this we need to edit two more configuration files:
    /boot/cmdline.txt
    /etc/inittab
Open up another Root Terminal (Start->Accessories->Root Terminal). Although theses files are easily replaced its
always a good idea to make a backup. So type in :
    cp /boot/cmdline.txt /boot/cmdline.bak
    cp /etc/inittab /etc/inittab.bak
Now that they are backed up we can edit them using the nano editor. First we'll edit cmdline.txt
    nano /boot/cmdline.txt
Delete “console=ttyAMA0,115200” and “kgdboc=ttyAMA0,115200” and use ctrl+x to save and exit.
Next edit inittab :
    nano /etc/inittab
For this file we just need to Comment out the last line of the file. It should read “T0:23:respawn....”. Just place a '#'
at the beginning so it reads “#T0:23:respawn....” , then use ctrl+x to save and exit.

Ajout des droits de cultipi sur le fichier sur le fichier /dev/ttyAMA0

ygene, 2015-07-22:
Tu peux me dire ce que renvoie la commande:

 ls -al /dev/ttyACM0

pourque j'ajoute le bon groupe à l'utilisateur.

guillaume-rico, 2015-07-22:
La commande pour ajouter l'utilisateur :

usermod -a -G dialout cultipi

ygene, 2015-07-22:
ok a tester dans la nouvelle version.

ygene, 2015-08-20:
Je considère que c'est OK

Closed 2015-08-20.

Thread 1217 (2015-07-30):

[WEBCAM] Ajouter la possibilité de configurer la prise de vue journalière

guillaume-rico, 2015-07-30:
Ajouter la possibilité de configurer la prise de vue journalière.

Créer le fichier de conf XML en fonction des infos utilisateur avec à l’intérieur les champs suivants :
dailySnapshotHour
dailySnapshotMin

Thread 1219 (2015-08-03):

Pouvoir garder réseau adHoc et réseau filaire

ygene, 2015-08-03:
Dans la partie conf, laisser la possibilité de garder le réseau adHoc et le réseau filaire quand on sauvegarde, sans désactiver le réseaux wifi

De plus ne pas laisser la possibilité de désactiver les réseaux.

ygene, 2015-08-03:
Toujours dans la partie réseau:

ajouter de base des dns dans ./etc/resolv.conf

mettre la possibilité de changer ces DNS dans la conf manuelle

ygene, 2015-08-03:
DNBS par defaut: free:

 cat /etc/resolv.conf
nameserver 212.27.40.240
nameserver 212.27.40.241

ygene, 2015-08-23:
En résumé:

* Si on ne met pas de ssid et de mot de passe on repasse en mode cultipi_network
* En adressage manuelle on utilise les dns de opendns sinon on laisse faire le dhcp

Testé, je clos.

Closed 2015-08-23.

Thread 1222 (2016-12-20):

Projet encore en vie ?

alex3137, 2016-12-20:
Bonjour.

Tout est dans le titre :)

Le projet est-il toujours d'actualite et peut-on se procurer des Cultibox ?

guillaume-rico, 2017-01-09:
Bonjour,

  On ne peut plus se procurer de Cultibox... Le projet est arrêté.

Cordialement,

Closed 2017-01-09.
