cultibox/cultibox/(commit log)

2012-03-25 Ajout d'un début de documentation sur XAMPP linux
2012-03-26 Documentation: installation de XAMPP, Joomla et Jumi sous Linux
2012-03-26 Correction des procédures d'installation XAMPP/Joomla/Jumi sous linuw + Fichier TODO list
2012-03-26 Ajout des scripts sql pour créer la base cultibox de l'interface + l'utilisateur cultibox + Ajout dans la doc du fichier de licence permettant de faire état de la licence des différents composants
2012-03-28 Nouvelle ebauche de la doc d'install sous linux + première version du code source avec gestion de la configuration et squelette en place
2012-03-29 -Ajout du boitier au format stp
    [main_assemblage.stp]
2012-03-30 Ajout des scripts jquery et javascript + ajout de la page de traitement des logs et correctif avec le Jdatabase (connector Joomla)
2012-04-02 Ajout de la gestion des langues + modification de highchart pour l'utilisation avec php
2012-04-03 Ajout des requettes sql permettant de générer le graphique journalier et mensuel par highcharts
2012-04-04 Correction pour l'affichage français des graphes + utilisation d'une moyenne pour afficher les valeurs sur un mois
2012-04-07 Ajout des commentaires dans les libs, ménages dans les fichiers et libs, correction des bugs, gestion des erreurs, ébauche de la gestion des programmes en cours
2012-04-07 Foction pour vérifier le format des dates rentrées + ajout des messages d'erreur en Anglais/Français + Ajout du choix des langues selon la langue
2012-04-13 Inversion des courbes des logs + ajout de fonctions de vérification des programmes
2012-04-14 Ecriture et lecture sur la carte SD pour mac windows et linux (testé uniquement sous linux) + Modules d'affichage des erreurs et informations sur les opérations réalisées
2012-04-17 Premiere ebauche de la gestion des programmes par l'utilisateur: ajout de timepicker pour récupérer le temps, enregistrement/chargement dans la base de donnee et ebauche du graphique genere depuis la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
2012-04-18 Nouvelle version pour la gestion des programmes
2012-04-19 Correction pour l'ajout et l'affichage des programmes pour les données en bordure de data (00:00:00 et 23:59:59)
2012-04-19 Debug de l'ajout de valeur sur une grande echelle + suppression des affichages de debug
2012-04-20 Algorithme permettant la génération du fichier plugv en fonction de la base de donnée
2012-04-20 Les graphes des programmes sont maintenant tous affichés sur la même page
2012-04-20 La gestion des modifications se fait maintenant à gauche du dessin du programme + une fois une modification envoyée et la la page rechargée, le focus revient sur la courbe que l'on vient de modifier 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
2012-04-23 Correction d'un bug sur la génération des programmes + Modification graphique du site (css and co)
2012-04-25 Tolerance des prises affichées en fonction de la prise selectionnée + vérification des valeurs de tolérance
2012-04-27 Multiple corrections et améliorations: ajout des valeurs et non seulement des on/off pour les prises, correction d'une partie de l'algo des programmes, correction du background des graphes, correctio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
2012-04-27 Sur la page des programmes le timepicker s'afficher en cliquant sur le bouton ET le champ des heures
2012-04-27 Les valeurs sélectionnées par l'utilisateur (on/off...) sont affichées une fois la page soumise
2012-04-27 Petite correction du placement des tableaux
2012-04-30 Ajout de la fonction permettant de vérifier les valeurs rentrées pour les programmes
2012-05-02 Nouvel algo pour la gestion des programmes
2012-05-02 L'un des dernier debug de l'algo des programmes: AMEN
2012-05-03 Ajout d'un mode debug + ajout des couleurs différentes pour les graphes
2012-05-03 Gestion et ecriture des valeurs de tolérance sur la carte SD
2012-05-07 Traduction de l'export de highchart + modification de la gestion de la tolérance + modification du fichier de conf des prises + ajout du fichier de langue de scw
2012-05-08 Ajout du template yoo_cloud de Calagan dans le gestionnaire de version
2012-05-08 Modification de l'affichage des div d'erreur et d'information + modification de l'affichage des boutons du timepicker + ajout de la partie calendrier (qui sera à completer) + un peu de ménage
2012-05-08 commit inutile...c'est pour faire des stats
2012-05-09 Affichage des erreurs SQL + ajout des fichiers du calendrier pour la cultibox + affichage des valeurs par défaut dans les programmes (00:00:00)
2012-05-14 Première version du wizard de démarrage pour les programmes + ajout d'une variable de configuration pour activer/désactiver le wizard+correction ecriture SD pour le calendrier
2012-05-16 Dernière version du wizard + correction d'affichage des modules info et erreur
2012-05-16 Ajout de la selection d'une courbe de programme dans les logs pour comparaison
2012-05-17 Resolution problème de conflict
2012-05-17 Mise à jour des droits utilisateurs et du format de la base
2012-05-20 Passage au mode strics de PHP: correction des erreurs pour windows
2012-05-21 Correction de warning en php
2012-05-21 -Ajout des fichier pour l'install -Ajout des fichiers de bases de la carte SD
2012-05-21 -Changement fin de ligne -Modification ISS (ajout firmware)
2012-05-22 -Ajout du bat de lancement pour windows
2012-05-22 Les fichiers sql sont maintenant stockées dans la partie software pour les installations
2012-05-22 Ajout de la partie joomla dans le dépot svn
    [web.config.txt]
2012-05-22 clean up du repertoire joomla avant réimportation
    [web.config.txt]
2012-05-22 Importation de la dernière version de joomla+cultibox
    [web.config.txt]
2012-05-22 Debug des derniers warnings PHP
2012-05-22 Test affichage des boutons sous windows
2012-05-22 -Correction de trois erreur restant sous windows -Correction du format des fichiers plugnn --Changement de la valeur de regulation secondaire par defaut à N -Remise en forme de l'indentation -Ecritur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
2012-05-22 -Ajout de la fonction write_pluga pour écrire le fichier pluga
2012-05-22 -Ajout du nombre de prise en haut du fichier plugv
2012-05-22 Ebauche de detection de l'oS par PHP
2012-05-22 Modification de l'organisation du dépot: dossiers d'installation
2012-05-22 Reorganisation: suite de la suite
2012-05-22 Utilisation de la valeur 999 pour les prises et correction de l'enregistrement des valeurs de plugv en conséquence
2012-05-22 Les valeurs des prises sont maintenant limitées à 90
2012-05-23 Correction de 3 erreurs windows + modification de la detection des cartes sous windows + traduction du bouton reset de highchart + correction wizard + correction comportement des prises et valeurs fo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
2012-05-23 Correctio de la création de la table des plugs: type par defaut est maintenant unknown et valeur par defaut 0.0
2012-05-23 Debug de la fonction des programmes
2012-05-23 Debug de la génération du fichier plugv
2012-05-23 Correction affichage 'arret' quand la valeur est a 0
2012-05-23 Changement de l'affichage des points des logs avec les 3 courbes en fonction du type de prise and co
2012-05-24 Correction du timezone pour la création des programmes
2012-05-25 Recuperation des logs: suppression des caractères hexa + verification de l'integrite des donnees
2012-05-25 Correction affichage des logs journaliers quand il y a des valeurs null
2012-06-04 La valeur par defaut proposée dans la section programme pour les lampes est ON et non plus OFF
2012-06-04 Abandon de la moyenne sur 20 points pour les mois, on ne prend qu'un point tous les 20 enregistrements
2012-06-04 Affichage des valeurs nulles sur un mois pour l'affichage des logs
2012-06-04 Les logs ne sont plus effacés de la carte SD si leur ajout dans la base n'a pas pu être fait correctement
2012-06-07 Première modification pour la gestion des import/export/reset des programmes
2012-06-07 Résolution de l'issue 7: ajout d'un icone dans le timepicker
2012-06-07 Correction de diverses traductions + reconfiguration du wizard de façon plus simple
2012-06-07 Séparation des axes des logs entre humidité et température: max de la température: 80°C
2012-06-07 Correction de traduction + Ajout de la partie reset des programmes en tant que lien
2012-06-16 Mise à jour du script de lancement Mise à jour du fichier ISS suite à la revue avec YGe
2012-06-17 -Changement de l'icone
2012-06-20 Modification des valeurs pluga en fonction du nouveau fichier + ajout des valeurs par defaut dans le fichier config.php + possibilité de personnaliser les valeurs dans l'interface + possibilité de ré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
2012-06-20 Ajout de la seixième prise dans le fichier pluga
2012-06-20 Mise a jour de la table plugs pour gérer les ID des prises
2012-06-20 Un peu de doc rapide
2012-06-20 Supression du choix du wiard dans la partie configuration + ajout du choix des axes pour les graphes + ajout par defaut des axes + verification de la valeur utilisée pour les logs et le timestamp
2012-06-20 Modification de la base pour la configuration des logs et la non configuration du wizzard
2012-06-20 Correction des bugs d'affichage des logs: trie par ordre croissant des valeurs dans la base + mauvaise comparaison pour la detection des trous
2012-06-20 Correction script de création de la base cultibox
2012-06-20 Ajout d'une option de configuration pour les popups
2012-06-22 -Mise à jour des fichiers vides
2012-06-22 -Modification en attendant que tu resolve certaines bugs. Sinon Cbx non fonctionnelle
2012-06-23 -Changement de deux textes -Remise en forme suite (suppression des tabs) - Affichage de la boite de sélection des courbes à droite de la boite de sélection du jour
2012-06-23 -Suppression des tabs, remise en forme
2012-06-24 Ajout d'un champ pour gérer les faux logs dans la table logs et ajout d'un script pour ajouter les logs au jour de l'installation
2012-06-25 Ajout de la gestion des faux logs
2012-06-25 Ajout de la fonctionnalité d'affichage par pop up
2012-06-25 Un utilisateur peut maintenant rentrer une heure de début supérieur à l'heure de fin pour un programme, on ajoute deux actions
2012-06-25 Correction d'un bug sur la création des programmes quand il y a des valeurs qui se chevauchent pour les prises
2012-06-25 Correction de l'insertion des faux logs dans la base
2012-06-25 Nouvelle version de la base cultibox
2012-06-25 Possibilité pour l'utilisateur de régler la fréquence d'enregistrement des mesures de puissance
2012-06-25 Nouvelle version de la base pour intégrer les mesures de puissance
2012-06-25 -Ajout script de precompilation
2012-06-25 -MAJ du firmware de l'emmeteur
2012-06-25 Changement des couleurs des gradients du graphe
2012-06-25 Ajout du nom d la prise dans la partie titre du programme
2012-06-25 Impossible de changer le code des ~ premières prises + inversement des boutons de validation - reset du numéro des prises
2012-06-25 Modification des faux logs ajouté, suppréssion de la data
2012-06-26 Correction d'un bug sur le wizard + changement des textes du wizard + Ajout des popup sur les programmes
2012-06-26 Agrandissement de la taille du timepicker
2012-06-26 ajout de pop up d'erreur et de popup d'informations pour les heures
2012-06-26 Ajout de la gestion de l'alarme
2012-06-26 Nouvelle structure pour la base et l'intégration de l'alarme
2012-06-27 Correction d'un bug d'enregistrement de l'alarme + ajout d'un peu de javascript pour rendre le tout plus dynamique
2012-06-27 Correction de bug sur la gestion des prises + amélioration du design + gestion des erreurs par prise indépendamenet + correction lors d'une erreur dans les valeurs rentrée + plein de choses
2012-06-27 Correction bug sur les id des prises + valeur par défaut des tolérances à 1 + correction bug sur les valeurs
2012-06-27 Avec desinstalltion de tout
2012-06-28 -Mise en commentaire de deux boutons
2012-06-29 Mise en place du wizard nouvelle modif: gestion des autres prises
2012-06-29 -Ajout de la désinstallation obligatoire du logiciel -Suppression du choix de l'installateur -Suppression du .bat pour les scripts sql
2012-06-30 -Changement de texte pour le wizard
2012-06-30 Ajout de l'image du wizard
2012-06-30 Changement des textes + correction bug sur les valeurs des programmes
2012-06-30 Ajout d'une fenetre de chargement des logs, affichage à revoir, code à tester
2012-06-30 Ajout de la gestion des infos bulles
2012-06-30 Ajout de la configuration de la valeur de puissance pour les prises
2012-06-30 Nouvelle base cultibox pour la gestion des plugs et de la puissance
2012-07-01 Ajout d'une variable dans la table de configuration permettant de savoir si c'est la première utilisation ou pas + mise en place des valeurs par défaut pour la première lampe
2012-07-01 Inversion de la puissance de la prise et du code de la prise. Spécial dédicasse Alliaume est la place tout baigne
2012-07-01 Suppression de la clef primaire sur les logs ce qui autorise les doublons. Cela ne semble pas poser de problèmes sur l'affichage des logs ensuite
2012-07-01 Les erreurs de requettes ne sont plus affichés qu'avec le mode debug
2012-07-01 Correction des trous dans les logs (affichage des mois)
2012-07-01 Modification de la gestion de la valeur marche forcée
2012-07-01 Valeur par defaut pour la marche forcée
2012-07-01 Ajout des valeurs par défaut
2012-07-02 Intégration des librairies php dans le calendar + enregistrement de la dernière action
2012-07-02 Modif du calendar: gestion de plusieurs jours + correction nombre de carac
2012-07-02 Heure de départ et d'arrivée pour les programmes doivent maintenant être différentes
2012-07-03 -Correction d'une erreur dans l'install de la base
2012-07-03 Ajout des debug trace pour l'affichage des programmes + correction d'un bug sur les programmes
2012-07-03 Ajout d'un nouveau datepicker + ajout des librairies et nettoyage des anciennes + ajout d'une image pour le datepicker
2012-07-09 -Ajout des pages d'aide -Mise à jour install
2012-07-13 -Mise à jour de l'installation
2012-07-16 Mise en place de l'index d'aide
2012-07-17 Ajout du nom et numéro de la prise dans le titre du wizard
2012-07-18 Ajout du champ de remarque dans le calendrier
2012-07-18 Ajout de la date dans la légende des mois (partie log)
2012-07-18 correction sur l'axe X des logs
2012-07-18 Ajout des champs sujets pour le calendrier
2012-07-19 Nouvelle gestion pour le découpage des mots du calendrier
2012-07-19 Plusieurs commentaires pour la même journée
2012-07-21 Nouvelle version de la base joomla pour la page d'accueil
2012-07-25 Nouvelle version de la base pour la regulation secondaire + code pour la regulation secondaire (deuxième commit a venir)
2012-07-25 Remise par defaut de 3 prises actives
2012-07-25 Le firmware est maintenant vérifié et copié depuis toutes les pages et on verifie que les programmes sont à jours avant de les copier sinon pop up message vers l'utilisateur
2012-07-27 Correction de la gestion de la seconde regulation
2012-07-30 Ajout des fonctions de traitement de la puissance (désactivées pour le moment) + correction affichage onglet plug + nouvelle base cultibox
2012-08-13 Ajout des fonctions permettant de récupérer les valeurs power et les enregistrer dans la table + ajout du footer de l'interface + ajout de la page permettant de calculer les prix (script php a faire)
2012-08-13 Correction et ajout image pour la page de welcome
2012-08-13 Un peu de ménage
2012-08-14 Correction graphique + correction des messages + test des deux premiers onglets: welcome et configuration sous IE et FF (Linux) => Ok pour ces deux onglets, ils sont terminé (relecture possible des t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
2012-08-15 Correction de l'onglet des logs: graphisme, images etc... + ajout du debut des fonctions pour afficher les courbes d'energies + correction de la gestion des années dans les logs par mois
2012-08-17 Ajout de l'affichage des graphes de puissances et des fonctions associés + redesignage de la partie log + correction de la partie log + ajout de nouvelles options dans la partie configuration
2012-08-18 Possibilité d'afficher la puissance pour une prise ou plusieurs + suppression des variables first use, le bouton pour lancer l'assistant dans le welcome est toujours présent
2012-08-18 Nouvelle bases pour les modifs
2012-08-20 Fonction round utilisée pour le calcul des puissances + correction des accents dans les locales avec ajout nouvelle fonction
2012-08-23 Correctif + ajout de la partie cout de consommation
2012-08-23 Nouvelles bases pour la nouvelle version
2012-08-23 Ajour des fonctions de calcul du cout de l'installation + correction
2012-08-24 Un peu de mise en forme pour le wizard et le welcome
2012-08-26 Module import/export pour les programmes + ajout de couleurs dans la conf + ajout de la possibilité configurer la couleur des graphes de cout + debug du wizard et correction graphique
2012-08-26 Deux corrections pour le prix: calcul sur X jours + mauvaises données dans la base gérées
2012-08-27 Correction du bug javascript dan la partie plug
2012-08-30 Ajout des fichiers pour la création des packages Ubuntu
2012-08-30 Fichier de projet pour package 64bits
2012-08-31 Ajout de la version et licence dans le footer + ajout du système de mises à jours par un site distant
2012-08-31 Ajout des bases pour les mises à jour distantes
2012-08-31 Ajout des fichiers pour packages Mac Os X
2012-09-02 Nouvelle version des package qui fixe le problème des permissions + correction image fake log + création d'une version lite de XAMPP: passage de 250Mo a 180Mo et passage de 21000 fichiers pour la cul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
2012-09-02 Mise en place de l'archi pour les packges ubuntu 32 bits
2012-09-03 Correction du fonctionnement du calendrier + correction de la verif des dates du cout de l'installation + correction de l'image des fakes logs + divers
2012-09-03 Correction du calendrier pour les dates affichées +traduction de messages + rajout des fonctions qui enlèvent les espaces dans le calendrier et cultibox
2012-09-04 Ajout de la page d'attente sur le chargement des logs
2012-09-05 Cleanage des fichiers libs, correction et epuration du code, ajout des bons commentaires, correction de deux trois bugs et passage de l'interface pour qu'elle réussisse le test du W3C
2012-09-12 Correction pour l'installateur windows
    [my.ini, php.ini]
2012-09-12 -Suppression de la modification du port.
2012-09-13 Ajout heure pleine/heure cresue dans la configuration
2012-09-13 Nouvelle base pour les heures pleines et heures creuses
2012-09-13 Correction pour le CSS de joomla
2012-09-13 Mise en place des updates sur le site et correction de l'URL dans le config.php
2012-09-17 Ajout d'un oint manquant dans le README de la création des packages Linux
2012-10-25 Recherche des logs uniquement sur les deux derniers mois
2012-10-25 Pour corriger le bug de décalage de l'horloge, j'ajoute une ligne dans le fichier de conf
2012-10-26 Nouvelle recette pour la création des packages Mac
2012-10-26 Nouvelle recette et nouveaux packages pour ubuntu + ajout d'un fichier de version
2012-10-26 simplification des options du script de creation de package pour ubuntu
2012-10-26 Changement des couleurs des courbes par défaut
2012-10-27 Sous la dernière Ubuntu les dossiers montés le sont maintenant dans le repertoire: /media/USER et non plus /media
2012-10-27 Ajout d'une variable permettant de configurer le nombre de mois pour la recherche des logs et modification de l'algo du rico en conséquence
2012-10-27 FAKE LOG affichés pour n'importe quel jour et pas le jour d'installation jusqu'a ce que l'utilisateur enregistre des logs + ajout du fichier CHANGELOG qui servira à générer les changelogs automatique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
2012-10-27 Correction de l'erreur de l'inclusion d'un css inexistant
2012-10-27 Generation automatique des changelogs pour ubuntu
2012-10-27 Correction pour les dernières MAJ
2012-10-28 -Mise à jour du firmware en version 1.E Mise à jour du fichier de conf
2012-10-28 Ajout des paquets admin et user + changement de port mysql pour linux
2012-10-29 Le fichier de démarrage cultibox.bat pour windows detecte maintenant si l'interface est déja lancé (via les ports utilisés) et la redémarre si c'est le cas + ajout du fichier ISS permettant de faire 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
2012-10-29 changelog pour la précédente modif
2012-10-29 Ajout de la taille minimale requise pour l'installation du soft dans windows
2012-10-29 Modification du script de pre-installation pour arreter le service sous linux s'il existe avant de réinstaller
2012-10-29 Plus de robustesse dans l'ecriture/lecture des logs, a voir s'il n'existe pas une autre methode... + Ajout d'un message prevenant l'utilisateur qu'il peut retirer sa carte SD
2012-10-30 La page d'accueil n'affiche le lien du wizard que si les programmes sont vides + correction diverses
2012-11-01 Activation de l'accelerateur php pour linux
2012-11-06 Gestion des paquets automatiques pour Windows et gestion des mises à jours, enfin...poil aux mains
2012-11-06 Ajout du fichier SQL pour mettre à jour la base pour les updates
2012-11-06 -Changement de la taille des commentaires du calendrier: 13 caractères
2012-11-06 -Formatage du nombre de commentaire à 3 chiffres
2012-11-12 CHangelog pour la modification du calendrier
2012-11-13 Ajout des nouvelles images pour le welcome + changement des textes
2012-11-13 CHANGELOG pour la base
2012-11-13 Ajout d'une fonction permettant de vérifier ou créer la présence du fichier log.txt sur la carte sd
2012-11-14 Ajout de deux champs permettant de configurer les heures pleines et heures creuses, reste à modifier la fonction de calcul de cout
2012-11-14 CHANGELOG + correction d'une erreur d'affichage dans la configuration
2012-11-14 Ajout des scripts sql pour la mise à jour
2012-11-14 Un peu de ménage dans les recettes et de réorganisation
2012-11-15 AJout du module xhr + utilisation de la revision par SVN + passage au w3c pour le html + correction affichage
2012-11-15 Correction de l'URL pour les mises à jours
2012-11-16 CultiBox (1.0.310) precise; urgency=low
    + Nouvelle version pour highchart 2.3.3
    02_src/joomla/main/libs/js/exporting.js
    02_src/joomla/main/libs/js/highcharts.js
    + Correction affichage pour le waiting
    02_src/joomla/main/scripts/waiting.php
    02_src/joomla/main/libs/css/cultibox.css
    02_src/joomla/main/templates/waiting.html
    + Correction de l'orthographe des locales FR et des locales manquantes pour EN
    02_src/joomla/main/locale/en_GB.utf8.po
    02_src/joomla/main/locale/fr_FR.utf8.po
2012-11-16 Le nom des prises est en francais ou anglais en fonction de la langue d'installation
2012-11-24 Ajout de la gestion des services dans windows
2012-11-28 Changement de l'affichage des formulaires des logs pour les rendre plus concis
2012-11-30 Ajout de la version du soft dans xhr + changelent de l'affichage de la configuration
2012-12-03 Ajout des champs OHXR + correction copie du firmware + correction package Linux (version 1.8.1 de XAMPP) + multiples correction depuis retour utilisateur
    [php.ini]
2012-12-03 Ajout d'un champ browser dans les requettes XHR + remise à zero du fichier log.txt
2012-12-03 Correction bug sur le chargement des logs
2012-12-03 Correction bug dans l'affichage des plugs
2012-12-06 Ajout du resume des actions dans les programmes + correction affichage wizard en anglais + Modification des recettes des packages
    [php.ini]
2012-12-07 Verification des logs dans log.txt avant effacement du fichier
2012-12-07 Changemet de l'affichage du menu pour être plus en accord avec la charte raphique, le reste sera vu par calagan
2012-12-07 Correction pour les informations pwr_XX + ajout de la possibilité de supprimer/ajouter une prise dans les programmes + correction affichage
2012-12-08 AJout de l'information de la régulation secondaire dans les programmes
2012-12-09 Correction de bugs sur la gestion des pwr_XX, optimisation du chargement des pwr_XX, possibilité de zoomer sur les deux axes dans les logs, personnalisation des boutons ajouteR/supprimer une prise da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
2012-12-10 Gestion du firmware de l'emetteur comme celui de la cultibox + possibilité d'afficher le cout par prise
2012-12-11 Utilisation de variables global pour le min/max des prises utilisables + calcul du cout des prises peut maintenant (pour la partie theorique) utiliser les fonctions de HP/HC
2012-12-11 Pas de waiting s'il n'y a pas de carte SD pour les logs
2012-12-13 Correction affichage des puissances suite au changement sur 4 digit des fichiers pwr_XX
2012-12-13 Utilisation du HP/HC dans le calcul reel de la consommation + correction du cout du prix theorique
2012-12-14 Nouvelles couleurs pour les graphes + bouton next/previous pour les logs
2012-12-16 Enregistrement des valeurs des 4 sondes d'hygrométrie et de température
2012-12-16 Changement des numéros des 16 prises
2012-12-16 -Changement des adresses des prises -Suppressions des parties inutiles dans conf
2012-12-18 Correction et fonctionnalité sur l'affichage des logs: affichage de différent capteur (un à la fois pour le moment), correction de l'affichage des programmes si l'echelle change, correction des fakes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
2012-12-18 Affichage de textbox permettant de cacher ou rendre visible les graphes
2012-12-18 Affichage des différents capteurs séparément ou en même temps
2012-12-19 Accélération de l'affichage de la page des logs: on ne recharge pas tous les fichiers de logs quand la carte sd est branchée + possibilité de faire un reset des bases ou d'importer les logs à la dema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
2012-12-20 Quelques correctifs pour la version 1.1.0
2012-12-20 Encore quelques correctifs pour la 1.1.0, on touche au but
2012-12-21 Encore des correctifs: correction orthographe , mise en page + execution des fonctions xhr une demi seconde plus tard pour permettre le chargement de la page avant, ca roule le bout du tunnel est la
2012-12-26 PLus grande robustesse dans les requettes d'ajout des logs + affichage des couleurs des courbes des logs en fonction des couleurs choisies + menu reste ouvert sur la soumission du formulaire
2012-12-27 Correction erreur de syntaxe dans le calcul du cout + correction du menu
2012-12-27 Passage par une bibliothèque externe javascript pour les fonctions des pages du site, plus propre, evite les redondances etc: /main/libs/js/cultibox-utils.js
2012-12-28 Correction sur le calcul des puissances consommées
2012-12-30 Correctifs de la version 1.1.0
2013-01-04 Correction du chargement des logs + possibilité d'une action cyclique (en cours) + reset des programmes quand on ajoute une action possible
2013-01-07 Possibilité de définir une action cyclique
2013-01-07 Nouveau fonctionnement du menu de configuration...plus classe comme ca ;)
2013-01-09 Grosse mise à jour (une deuxième viendra compléter celui la): nouvelle façon de gérer les messages, commentaires dans le code php, épuration du code php, ajout d'une option de configuration pour les 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
2013-01-11 2 ème commit de modification de gestion de l'interface, il en manquera 2 encore avant la version 1.1.2, je ne rentre pas dans les détails, le CHANGELOG de la version 1.1.2 parlera du lui même plus ta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
2013-01-16 3ème et avant dernier gros commit du changement de l'interface, reste plus qu'à corriger un petit problème et à intégrer les modifs avec les requettes sql et le changelog, le bout du tunnel, le bout 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
2013-01-16 Dernier gros commit des modifs de la 1.1.2, reste quelques vérifications
2013-01-16 Changement du système des mises à jour (simplifié)
2013-01-18 Ajout de la fonction de formattage de la carte SD + suppression de l'édition possible du code d'une prise + quelques correctifs
2013-01-21 Alignement des grilles des axes des logs + ajout de l'icone cultibox.ico dans joomla
2013-01-21 Correction de la taile des champs pour le prix du kilowatt heure
2013-01-21 Ajout des nouvelles bases et des scripts de modification des bases
2013-01-25 Nouveaux scripts pour les paquets windows
2013-01-26 Correction pour la 1.1.2
2013-01-26 Ajout du waiting pour le format de la carte SD...au cas ou
2013-01-26 Ajout de la detection du browser
2013-01-27 -Ajout du fichier emetteur avec la bonne orthographe
2013-01-28 Correction de deux typos
2013-01-28 Correction d'un bug critique sur l'ajout d'un programme avec une valeur de régulation...
2013-01-28 Ajout des tooltips pour les fonctions de gestion des logs
2013-01-28 Correction d'in bug sur la régulation secondaire
2013-01-28 Correction bug de l'offset
2013-01-30 Correctif de deux bugs pour le formatage de la cartes SD
2013-01-30 Ajout d'un message permettant de préciser qu'il est possible de recharger la page en cas d'erreur
2013-01-30 Ajout du texte et de la liste concernant les brosers compatibles
2013-01-30 Ajout de la possibilité de désactiver une prise
2013-01-31 Gestion des affichages en foncton des prises actives ou non
2013-01-31 Desactivation des prises: modification de la création des fichiers pluxXX
2013-01-31 Impossible de formater une carte SD de plus de 2Go
2013-01-31 Possibilité de ne pas afficher le programme courant
2013-01-31 Fin de la configuration des plugs désactivables: modification des algos de calcul des couts
2013-01-31 Correction d'un bug sur le import log qui ne marchait pas + correction d'un bug sur le chargement du waiting
2013-02-01 Changelog de la version 1.1.3
2013-02-01 Bug fixe sur la gestion des updates
2013-02-03 Correction de l'import des programmes
2013-02-03 Passage di formatage de la carte SD dans la configuration
2013-02-03 Utilisation d'une variable de session pour ne pas charger les logs à chaque fois
2013-02-03 Modification du temps de vie d'une session 120s au lieu de 1440
2013-02-04 Correction de l'affichage du aiting sur le import
2013-02-05 Nouveau scripts de génération de paquets pour Linux
2013-02-05 CHANGELOG de la version 1.1.4
2013-02-08 Gestion automatique de la langue (default anglais) en fonction de la langue du système
2013-02-26 -Ajout des codes prises 3500W
2013-02-27 Modification de la gestion des packages Linux
2013-02-27 Ajout de la possibilité de configurer une prise en 3500W ou 100W et changement des adresses et du fichier pluga en conséquence
2013-02-27 Correctif sur la puissance maximale des prises pour windows + vérification du numéro de version de la mise à jour proposé
2013-02-27 Correction sur la gestion de la puissance des prises
2013-03-02 Les programmes des prises inactives ne sont plus ajoutée dans le fichier plugv
2013-03-07 + Ajout de la possibilité de zoomer sur l'axe Y dans les logs + Correction de tooltip et de valeur par défaut dans la base configuration
2013-03-07 Ajout du travail de Calagan
2013-03-07 Correction sur les ajouts de calagan + désactivation des régulations secondaires
2013-03-07 Désactivation du bout de code qui affiche les régulation secondaires
2013-03-07 Suppression des arrows dans les titres
2013-03-08 Ajout de boutton dans le menu de configuration au lieu de liens
2013-03-08 Correction des listes avec ajout d'une classe dans calagan.css
2013-03-08 Correction du calcul du cout: le calcul théorique ne prend pas en compte les prises inactives, le calcul réel ne se base pas sur la configuration des prises mais uniquement les données enregistrées p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
2013-03-08 Le package Linux vérifie maintenant que le logiciel a été désintallé avec l'option --purge, sinon il annule la nouvelle installation et propose à l'utilisateur de lancer la commande
2013-03-08 Detection de la version en double
2013-03-11 Gestion de l'architecture pour les updates du soft
2013-03-11 Correction des tooltips pour la puissance des prises
2013-03-11 Correction taille des informations affichées par le css de calagan
2013-03-11 Nouvelle base joomla pour afficher les onglets actifs
2013-03-11 Passage du css du timepicker dans le css de calagan + affichage du bouton resetzoom pour le zoom en Y
2013-03-11 Ajout d'encres pour les pages d'informations
2013-03-11 Passage de Joomla 2.5.3 a 2.5.9
2013-03-11 Modifications de faux logs basés sur les données de philou le filou
2013-03-12 Livraison du premier rapport de vérification sur les mots clés : PTS_electronic_input_voltage PTS_electronic_input_current
2013-03-12 Correction des accents dans highchart + suppression des alternate colors dans les logs
2013-03-13 Possibilité d'exporter/importer des programmes vides + ajout d'encre dans la page des programmes
2013-03-13 Ménage du passage à la version 2.5.9 de joomla
2013-03-13 passage de .doc à .pdf Les .doc sont à effacer
2013-03-13 Correctifs pour passer la validation du W3C pour le HTML5
2013-03-16 Mise en place des scripts pour générer les paquets macs
2013-03-17 Valeur par défaut des programmes sur marche si aucune action n'a été rentrée
2013-03-17 -Ajout du teste dans plugXX permettant de gérer le numéro du capteur utilisé pour la régulation
2013-03-17 Formattage des fichiers calc_XX pour le calendrier, suppréssion d'une ligne entre le titre et la description
2013-03-17 Ajout d'un résumé et de tooltips pour la partie cost
2013-03-17 Remise en place des updates un peu plus bas dans le script, cohérence avec les autres scripts php
2013-03-18 Ajout du fichier model pour la vérif
2013-03-18 Ajout du rapport pour les cables
2013-03-18 + Réactivation de la régulation secondaire + Ajout d'un résumé des régulations dans les logs + Correction des titres des sections pour l'uniformité
2013-03-18 Ajout du rapport de la carte SD
2013-03-18 Livraison du rapport sur la pression
2013-03-18 Possibilité de choisir le capteur utilisé pour la régulation
2013-03-18 Nouvelle recette pour package mac (mountain lion)
2013-03-19 Ajout de safari comme navigateur officiellement supporté
2013-03-19 Ajout d'un service de démarrage pour mac os x
2013-03-20 Ajout des scripts load/backup pour Mac OS X
2013-03-21 + Correction des redirections vers le waiting pour le formatage de la carte SD + Renomage des scripts gérant les logs en display-logs pour être cohérent + Correction d'un bug sur l'affichage du menu 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
2013-03-23 re-ajout de CBX_1_13_0008_PTS_electronic_alarm_-.pdf sans espace dans le nom de fichier........ Supprimer le précédent
2013-03-24 + Correction d'erreur d'affichage dans les légendes des graphes des programmes et des logs + L'affichage des programmes dans les logs est maintenant synchronisé en fonction du type: les ventilateurs 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
2013-03-24 Correction de typos
2013-03-24 Changement des explications pour la régulation secondaire
2013-03-24 Inversion de deux champs dans la conf des prises
2013-03-24 Suppression des fichers inutiles
2013-03-24 + Mise en forme des panneaux d'informations et de warning/erreurs + Fusion des deux css cultibox.css et calagan.css en un seul: cultibox.css
2013-03-25 L'algorithme de calcul du coût ne prend plus en compte les prises désactivées
2013-03-25 Correction de l'image des warnngs
2013-03-25 Mise en place de l'upgrade Mac os X
2013-03-27 + Vérification de la possibilité d'écrire sur la carte SD avant de modifier les fichiers de conf + Le programme selectionné pour modification ne peut plus être déselectionné
2013-03-27 On vérifie que les valeurs de power importées sont de type numérique
2013-03-27 + Correction des requettes d'import des valeurs 'power': on vérufie que c'est bien un type numérique avant l'import + Possibilité de mettre la tolérance à 0
2013-03-27 Changement des textes pour le tooltip de suppréssion des logs
2013-03-27 Amélioration de l'affichage des paneaux warning/information
2013-03-27 + Passage de la gestion de la configuration du coût dans l'onglet coût + Relooking des erreurs pour les champs des formulaires
2013-03-27 + Choix du nombre de mois pour l'import des logs transposé dans l'onglet display-logs
2013-03-27 + Le choix min et max pour l'axe Y des puissances dans les logs se fait maintenant comme pour les autres axes directement dans l'onglet log
2013-03-28 + Ajout du parser php de wiki de Al + Prise en compte des sauts de ligne dans le calendar + Correctifs mise en forme/bug/typo
2013-03-28 Ajout du parsage de code
2013-03-28 + Ajout des fonctions d'export au format csv pour les logs et les puissances
2013-03-28 + Les logs sont par défaut chargés sur les 31 derniers jours > + Correction sur l'affichage des unités dans les graphes des programmes > + Divers bug fixes...inombrables et innomables... ... ... ...
2013-03-28 Agrandissement du fond de l'interface pour éviter les débordements + encore des bugs fixes...et y en a d'autres qui arrivent...
2013-03-29 Bug fixe pour ne pas charger le mois en cours à chaque fois + cleanage de la waiting page qui devenait n'import quoi...
2013-03-30 Passage en jquery des alert pop up
2013-03-30 Suppression de l'ancienne documentation utilisateur
2013-03-30 -Mise à jour du parser (J'y touche plus avant un bout de temps!)
2013-03-31 On ne considère plus les trous dans les logs power, on affiche comme un programme les mesures de puissances
2013-04-01 -Mise en place du repertoire pour la doc
2013-04-01 UNpeu de ménage
2013-04-02 Nouvelle base joomla avec le lien vers le fichier de doc en pdf
2013-04-02 Intégration de la génération automatique de la doc dans le soft
2013-04-02 Correction pour la génération de la doc
2013-04-03 + Le choix du capteur n'apparait plus pour les types 'autre' et 'lampe' + Correction d'un bug javascript: on ne recherche plus les éléments de la seconde régulation si celle-ci est désactivée
2013-04-03 + Correction pour le changement de numéro de version en upgrade sur les plateformes mac et linux
2013-04-03 Et il pleut des correctifs..hallelouia...
2013-04-03 Ouverture de l'aide dans un nouvel onglet
2013-04-03 Mise à jour de la gestion du sommaire
2013-04-03 + Correction des trous de l'affichage des logs paramètré à 10 fois la fréquence d'enregistrement
2013-04-03 + Correction sur la gestion des programmes: boucle infini si le repeat time est à 0 corrigé + correction sur le dernier élément d'un ajout cyclique qui se retrouvait vide
2013-04-03 + Lorsqu'on charge les fichiers de log on authorise une ligne vide, à la ligneuxième ligne vide on ferme le fichier et on passe au suivant + Les données éronnées dans les fichiers de logs n'empèchent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
2013-04-03 Correction du parser pour la taille des tableau Ajout de la possibilité de mettre du code latex dans le wiki
2013-04-04 Ajout du dossier de conf de la cultibox
2013-04-05 Ajout du selecteur de langue pour joomla et des langues: espagnol, italien et allemand
2013-04-05 Ajout des fichiers de création des bases pour it,es et de
2013-04-05 + Modification de l'affichage des puissances pour prendre en compte les extrapolations
2013-04-05 Debug pour passage de la norme HTML5 du W3c
2013-04-06 Un peu de relooking css
2013-04-07 Correction de l'affichage du deshumidificateur
2013-04-08 Correctifs installation sur Linux
    [my.ini]
2013-04-09 + Non rechargement de la page des programmes, passage a jquery 1.9, relooking css...
2013-04-09 Correctifs pour le non rechargement de la page des programmes
2013-04-10 + Mise en place de la personnalisation des boites de dialogues d'erreur, de confirmation et de validation grâce à JQUERY
2013-04-10 Mise en place du timezone en fonction de la langue sélectionnées + debug timezone pour l'historique
2013-04-10 Mise à jour de la carte SD
2013-04-10 + Changement de place de emetteur.hex qui se trouve maintenant dans le dossier cnf
2013-04-15 + Passage du WdCalendar à FullCalendar, un calendrier pour la gestion des évènements full Jquery-CSS
2013-04-15 Debug calendrier + ajout d'un colorpicker + ajout d'une fonction de reset du calendrier
2013-04-16 Ajout des langues DE,IT et ES pour le package mac os x + correction des scripts de démarrage
2013-04-17 Correction des textes pour le wizard + ajout du tooltip sur les valeurs pour le wizard
2013-04-17 Correction des updates mysql
2013-04-19 + Ajout de la possibilité d'utiliser des fichiers XML au format atom pour programmer des évènements dans le calendrier
2013-04-19 On empèche la manipulation des évènements dans les fichiers XML
2013-04-19 Passage par un bouton exterieur pour réinitialiser le zoom de highchart
2013-04-19 Petit correctif pour le zoom des logs
2013-04-19 décalage de la lune
2013-04-19 Petite erreur dans les dates...
2013-04-20 + Optimisation mémoire de la page des logs, division par 4 du temps de chargement et par 10 de la mémoire utilisée
2013-04-21 + Ajout d'un module de debug mémoire si l'option DEBUG est activée + Utilisation de PDO pour créer les connexions aux bases de données pour la partie calendrier + Optimisation des requettes de la par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
2013-04-22 + Passage au connecteur php PDO au lieu de JDatabase pour les requettes SQL
2013-04-22 + Ajout et debug de fichiers XML pour le calendrier lunaire
2013-04-22 Correction de l' ISSUE 502
2013-04-23 + Le menu selectionné dans la configuration apparait d'une couleur différente + Correctif pour l'export des bases avec msqldump sur windows et mac + Correction du calendrier lunaire
2013-04-23 Debug pour la detection des cartes SD sur mac dernière version
2013-04-25 Mise à jour des rapports
2013-04-25 ajout des logs_avril_09_au_14_et_14_au_23_1.25_4capteur
2013-04-25 ajout PTS nombre de log
2013-04-26 Passage du paramètre 127.0.0.1 à localhost dans la connexion PDO pour éviter les timeouts
2013-04-26 Suppression des fichiers
2013-04-26 Mise à jour de la doc
2013-04-26 Correction des cases avec plusieurs valeurs
2013-04-26 + Déplacement du boutton resetzoom des logs au centre en bas du graphe
2013-04-26 + Création des index sur le timestamp pour les tables des logs et power
2013-04-29 + Correction d'un bug d'affichage des radios boutons dans les logs + Modifications des scripts php du calendrier: les evènements sont directements écrits sur la carte sd et l'ont ne modifie plus que 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
2013-04-29 Ajout des fichiers de langue pour le datepicker
2013-04-29 + Modificaition de localhost en 127.0.0.1 dans le fichier configuration.php de joomla
2013-04-29 + Correction du calendrier pour windows: on ne regarde pas les repertoire . et .. pour la recherche de fichiers xml
2013-04-29 + Correction du calendrier: les evènements sur deux mois fonctionnent à nouveau
2013-04-29 + Les accents dans les fichiers calc sont maintenant bien pris en compte
2013-04-29 + ajout d'un champ color possible dans les fichiers xml pour choisir la couleur de ses evènements
2013-04-30 + Ajout d'un champ icon dans les entry du fichier xml pour ajouter une icone dans le titre (exemple calendrier lunaire)
2013-04-30 + Correctif pour l'affichage des accents dans highchart pour mac: passage par HTML
2013-05-01 -Ajout des scripts permettant de générer le calendrier lunaire
2013-05-02 Passage du nom du package windows7 en windows puisque le logiciel est compatible xp, vista et seven + ajout du script d'upload des packages sur un site distant
2013-05-06 Patch pour la langue espagnol
2013-05-06 Inversion des deux boutons 'fin' et 'configurer une autre prise' du wizard
2013-05-06 + La checkbox qui permet d'effacer un programme avant d'en ajouter un autre ne reste plus selectionnée + Ajout de tooltip pour la partie gestion des programmes + Debut du code pour l'affichage des ét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
2013-05-06 Nouveaux fichiers de langues pour les précédents modifications
2013-05-06 CHANGELOG pour les précédents commit
2013-05-06 + Ajout d'une option de configuration permettant d'activer ou non le selection du capteur pour la régulation + Correction d'un bug sur le zoom des puissances dans les logs
2013-05-06 + Suppression des input en readonly et remplacement par un label customisable par la classe readonly en css
2013-05-06 Vérification des valeurs des dates dans le datepicker
2013-05-07 + Correction d'un bug sur la régulation primaire qui ne marchait pas si la régulation secondaire n'était pas activée + Correction d'affichage des accents, de l'espacement titre-graphe [...] dans le g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
2013-05-07 + Le bouton de reset du zoom des programmes utilise le même format que le bouton des logs (bouton exterieur au graphe) + L'affichage des puissances dans les logs ou le calcul du cout prend en compte 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
2013-05-12 + Ajout de tooltip pour la partie cyclique + Ajout d'une pop up si deux programmes succéssifs ont les même heures
2013-05-12 + Passage a highchart 3.0.1 pour corriger des problèmes d'affichage
2013-05-12 + Passage des input disabled en label avec la classe readonly
2013-05-12 + Correction de l'affichage des logs par mois dans la fonction check_format_date + Ajout de la possibilité de créer un icône cultibox sur le bureau pour windows
2013-05-12 + Correction des zooms sur l'affichage des logs
2013-05-12 + Mise en place d'un temps d'attente après chaque action du calendrier si une carte SD est détectée grâce à la librairie blockUI
2013-05-13 Changement des couleurs pour le calendrier lunaire
2013-05-15 + Agrandissement de la taille du datepicker et du timepicker + Affichage du résumé de la régulation secondaire dans le tooltip des programmes + Suppréssion des accents pour la créationdes fichiers du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
2013-05-15 Apparition des faux logs à nouveau + on enlève maintenant les caractères ascii <32 et >122, remplacés par des espaces pour les fichiers du calendrier
2013-05-16 + Remplacement de la liste de sélection par des radios boutons pour le choix de l'action des programmes
2013-05-16 + Ajout de deux boutons: dans la partie plug qui enregistre les modifications et passe sur la page des programmes associés et dans la partie programme dans la partie programme qui passe sur la prise 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
2013-05-17 + Correction d'une fenêtre modale sur le calendrier qui empêchait de selectionner le color picker + Correction de l'affichage des faux logs + Ajout d'un bouton 'Fin de la journée' dans le timepicker
2013-05-18 + Déplacement des messages d'erreur et d'informations dans des fenêtres séparées
2013-05-18 -Mise à jour des noeuds luniares
2013-05-18 Réorganisation de la page des programmes
2013-05-19 Correction de la requette de selection des logs
2013-05-19 + Changement de la couleur de selection des jours dans le calendrier
2013-05-19 + SUppréssion des bandes de couleurs dans les programmes
2013-05-20 -Suppression des chemins en dur (Passage en relatif)
2013-05-20 + Un seul méssage pour l'affichage des logs concernant les températures et humidités vides
2013-05-21 -Ajout de debug dans le precompil pour linux
2013-05-21 Correction du bug sur la documentation (il faut compiler deux fois)
2013-05-21 Ajout de la suppression du svn up si c'est jenkins qui lance le script
2013-05-22 + Correction des accents dans le graphe de coût pour Mac OS X
2013-05-22 Correction du numéro de version dans les paquets Windows
2013-05-22 Changement du nom du tar de windows + correction accent mac os x
2013-05-22 Gestion des caractères spéciaux pour les requettes SQL du calendrier
2013-05-24 Ajout de fichiers manquants pour la compilation linux
2013-05-24 AJout des fichiers manquants pour Mac Os X
2013-05-25 -Ajout du jeu de test
2013-05-25 -Mise à kour du nom des fichiers
2013-06-05 + Téléchargement de la mise à jour dans la mise page que la page courante
2013-06-06 + Correction de l'affichage des graphes des programmes: l'affichage se s'enmèle plus les pinceaux quand certaines prises sont désactivées
2013-06-06 + Le bouton permettant de sauvegarder et configurer un programme dans l'onglet des prises est caché si la prise est désactivée
2013-06-06 + Correction de l'affichage du calendrier lunaire: doublons de certaines entrée due à une mauvaise gestion de la clef 'period'
2013-06-06 + Dans l'onglet programme, l'echèlle affichée correspond à celle de la prise selectionnée et non plus à celle de la première prise affichée
2013-06-06 + Ajout des unités dans les graphes des fake logs
2013-06-07 + Correction des echèlles des logs après zoom: l'echelle est calculée automatiquement avec des décimals pour empêcher que le graphe dbore sur le titre
2013-06-08 + Ajout d'une barre de progréssion pour le formatage de la carte SD afin d'éviter les timeout
2013-06-08 + L'affichage de l'humidité sur un mois fonctionne à nouveau
2013-06-09 + Modification de l'affichage de la légende pour les logs: 2 colonnes + on n'affiche plus les légendes des capteurs sans données
2013-06-09 + Découpage jour par jour par le calcul du cout pour éviter les timeout
2013-06-09 On evite les timeout quand on affiche le prix par prise
2013-06-10 + Regroupement des deux boites de messages avertissement et information en une seule
2013-06-11 Sauvegarde de la position de la boit de dialogue dans un cookie valide 30 jours
2013-06-12 + Limitation du nombre de changement d'état des prises à 250 dans les programmes + Correction affichage des informations dans la boite de message
2013-06-13 Correction affichage de la boite de message + correction passage au w3c
2013-06-13 CHangement des textes de traduction des tooltips des drapeaux
2013-06-13 Ajout d'une propriété zindex sur les tooltips pour qu'ils apparaissent toujours au dessus du reste
2013-06-14 Correction de la limitation du changement d'état après optimisation
2013-06-17 Ajout d'un script de désinstallation pour Mac OS X
2013-06-19 + Correction d'un problèe de nom de variable dans la gestion des programmes cycliques
2013-06-19 + Les résumés des actions des prises sont tronquées au bout de 40 actions
2013-06-19 Changement de couleur de la boite de message
2013-06-20 Mise à jour de l'image du calendrier pour le welcome
2013-06-28 + Sipmlification de l'alarme (on ne règle plus que la température)
2013-06-28 Mise a jour des bases
2013-06-29 Resize des images
2013-06-30 Ajout de la gestion de code Correction de quelques fautes
2013-07-01 + Les menus 'coût', 'Historique' et 'assistants' sont en options dans la configuration
2013-07-01 Changement de la couleur du titre de la boite de message
2013-07-01 Correction faute de typo
2013-07-01 Ajout de la taille de tête
2013-07-02 + Chaque onglet vérifie maintenant la cohérence entre la base de donnée (configuration des programmes, des prises, des firmware, des options...) et la carte SD
2013-07-02 suppression du gridcolor dans le graphe des couts
2013-07-02 Correction item des legendes des logs trop petits pour le texte des faux logs
2013-07-04 + Correction du script de postinstallation sur Mac os X, qui attend la fin du redémarrage de XAMPP avant de continuer
2013-07-05 + Divers corrections: problème lors de la création des programmes, mauvaises écriture du calendrier sur la carte...
2013-07-05 Encore des correctifs avant la 1.1.25
2013-07-06 Livraison des firmwares 1.27 et 1.4
2013-07-07 + Ajout d'une barre de progression pour le chargement des logs + correction des timeouts sur le chargement des logs + Correction de l'écriture de la configuration sur la carte SD
2013-07-07 Correctifs pour la barre de chargement des logs
2013-07-07 + Suppréssion du cache enregistré pour les pages
2013-07-07 Suppression de l'instruction de cleanage du cache pour winddows
2013-07-08 + Correction d'un bug sur la vérification de l'interval entre deux dates + CLeanage de variables
2013-07-08 + L'information dans la boite de message stipulant que l'on peut utiliser l'assistant ne s'affiche plus si on a désactivé l'onglet de l'assistant
2013-07-08 Correction calcul du cout et de la puissance des prises
2013-07-08 Application du fichier d'update sql après l'import de la base joomla pour éviter d'écraser les modifs
2013-07-08 Ajout des nouveaux fichiers pour mac osx
2013-07-09 + Correction de l'affichage du message de configuration des puissances: le message indique quelle prise il faut configurer et renvoie sur l'onglet 'Prises' adequat
2013-07-10 + Correction de l'affichage du message de détection de la carte SD dans les programmes qui s'affichait deux fois + Correction de la création des programmes, le nombre de prises configurée dans l'ongl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
2013-07-10 + On ne tente pas de charger les logs des 31 derniers jours sans carte SD branchée
2013-07-10 + Gestion des différentes langues pour les boutons JQUERY
2013-07-11 + Passage de la requette d'envoie d'information en AJAX pour gagner du temps au chargement du welcome
2013-07-11 Correction du formatag de la carte SD
2013-07-11 + Correction de l'affichage du nom des boutons pour les popups
2013-07-12 Passage du chargement d'un mois complet à un jour pour empecher les timeouts
2013-07-12 + Correction de l'import du jour en cours avec la nouvelle barre de progression
2013-07-12 ré-ajout de l'info du vidage du cache dans l'install windows
2013-07-16 + Ajout de la section Le saviez-vous? dans la page de welcome
2013-07-16 Ajout de la langue pour les notes pour les traductions + ajout des scripts sql de création de la table
2013-07-16 + Différenciation des messages de chargement des logs en mode auto ou lors de la soumission du formulaire + Correction passage W3C
2013-07-16 + Remise en fonction de la notification de logs plus anciens présent à être chargé + amélioration du système: on vérifie les logs power aussi et sur la semaine précédent le mois chargé et non plus un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
2013-07-16 Ajout de l'heure de reset du min max dans la conf
2013-07-16 Ajout dans la comparaison
2013-07-16 Ajout d'autres variables dans le fichier de conf
2013-07-16 Mie à jour de la carte SD
2013-07-18 Ajout du capteur pour la régul Ajout de la valeur de tolérance pour la régulation secondaire
2013-07-18 AJout des spec sur les fichiers plug_XX
2013-07-18 + Une fenêtre permet de selectionner une date de début et de fin pour la suppréssion des logs de la base ou encore de supprimer tous les logs existant
2013-07-18 Remise en place de la modif du fichier utilfunc.php
2013-07-18 Changement de hiérarchie des fichiers de conf sur la carte SD
2013-07-18 Déplacement de sht.hex et emeteur.hex dans le repertoire bin
2013-07-18 Changemnt des recettes de création des paquets mac et windows pour les firmwares
2013-07-18 Mise en place des CRLF
2013-07-18 MAJ de la carte SD
2013-07-19 Mise en place di fichier index dans les logs
2013-07-19 + Mise en place de la fonctionnalité de remise à zéro du min/max des capteurs
2013-07-19 Compatibilité descendante des cartes SD + correction de la gestion du minmax
2013-07-19 Ajout de la tolérance de la régulation secondaire dans le fichier plugXX
2013-07-19 ajout de la tolérance de la régulation secondaire dans l'interface
2013-07-19 Corrections des unités
2013-07-20 Livraison de la V1.29
2013-07-20 Ajout de deux shéma de culture pour tester
2013-07-20 Choix de plusieurs capteurs + ecriture sur la carte + correction affichage dans les plugs
2013-07-20 Ajout de la méthode de calcul de la régulation
2013-07-20 Hop le sql de la précédente rev
2013-07-23 Ajout des logs de température pour le capteur d'eau
2013-07-24 + Les catégories du menu s'affichent maintenant directement après modification de la configuration + Les erreurs dans le menu de configuraion sont gérées en AJAX sans rechargement de page
2013-07-24 Erreur dans la saisie d'une date pour l'affichage des logs géré par AJAX sans rechargement
2013-07-26 + Les erreurs dans le menu de configuraion et d'affichage des logs sont gérées en AJAX sans rechargement de page
2013-07-26 Gestion des erreurs du calcul du cout par AJAX + quelques correctifs
2013-07-30 + Debug de la gestion et création des programmes
2013-07-30 Desactivation de la limite du nombre d'état dans le fichier plugv
2013-07-30 suppréssion résidue de test
2013-07-30 Correction de liens pour les notes
2013-07-30 Modif pour la gestion du cache
2013-07-30 Remise en fonction du calcul de nombre de valeur de plugv, même si ca marche pas encore
2013-07-30 Correctifs issue des tests windows
2013-08-02 + Correction des accents sur Mac et concernant la partie Notes
2013-08-02 correctif sur les programmes
2013-08-03 + Ajout de la librairie scrollTo JQUERY pour gérer le déplacement des fenêtres après une action
2013-08-03 + Ajout d'un message d'erreur si aucun capteur n'est selectionné pour la régulation
2013-08-03 Verrue pour limiter le nombre de prises à 10
2013-08-04 + Ajout de la possibilité de configurer le type de puissance max d'une prise dans l'assistant + Divers correctifs
2013-08-04 + Ajout d'un bouton dans la partie prise qui permet de configurer la prise actuelle à l'aide de l'assistant
2013-08-05 Correction sur la seconde regulation
2013-08-05 Intégration de l'introduction d'installation pour mac directement dans le package pour corriger les problèmes d'accents
2013-08-06 Ajout des notes pour les autres langues
2013-08-06 Ajout des balises
2013-08-07 + Ajout des evènements dans le calendrier depuis les fichiers d'engrais XML
2013-08-07 Correction enregistrement sur la carte SD des infos du wizard
2013-08-08 Correction d'une erreur sur la génération des programmes
2013-08-08 Réimport des notes francaises pour les accents
2013-08-08 Ajout des dosages d'engrais dans le calendrier + correction de la taille maximale de la description, passage a 500 caractères
2013-08-09 changement des couleurs
2013-08-09 Correction d'un bug d'affichage sur les options avancées dans les prises
2013-08-09 -Ajout de l'image house gaarden
2013-08-09 + Ajout de deux fichiers XML de programme pour le calendrier créés par 'fastenspy'
2013-08-09 correction calendrier lunaire pour l'affichage + gestion des remarques
2013-08-21 Ajout du site web dans la base svn
2013-08-21 Ajout des liens pour paypal
2013-08-21 Ajout de l'image du pannier
2013-08-21 Ajout de la déclaration CE
2013-08-23 Ajoput de saut de ligne
2013-08-23 Passage ud site au w3c + ajout des liens facebooks + ajout du sketchfab + plein de trucs
2013-08-23 Ajout des conditions générales de ventes
2013-08-23 ajout du layout.css pour le menu, modifié à la mano
2013-08-23 mise à jour des css
2013-08-23 Ajout des liens
2013-08-23 Ajout des mots en gras
2013-08-23 passage au w3c de la page achat
2013-08-25 MAJ de la doc
2013-08-25 Mise à jour et correction pour la page index du site
2013-08-26 AJout du fichier de génération du quick_guide dans la base (en compréssé)
2013-08-27 + Correction de la configuration du type de prise dans le wizard
2013-08-27 mise à jour des liens achats
2013-09-02 Le soft passe maintenant les standards w3c concernant le css (3) et le html (5)
2013-09-02 + Modification du fichier telechargement.html pour le rendre utilisable par les scripts + Enlevage du message sur l'installateur windows qui préconise de vider le cache
2013-09-03 remise en forme de l'icône du logiciel
2013-09-03 ajout de fonction moyenne /min/max sur plusieurs capteurs dans CBX_1_13_0012_PTS_electronic_regulation_temperature_humidity_A.pdf
2013-09-04 Remise en place de la version 1.1.32
2013-09-06 Passage au w3c (css et html) du site + ajout de la commande des prises 1,2,3 et capteur 1
2013-09-06 Changement de l'adresse mail du changelog
2013-09-06 Mise en place du CHANGELOG dans la page de download
2013-09-06 Ajout dun cpateur de rep
2013-09-07 + Remise en forme de de l'affichage des différentes partie des logs pour que la page ne bouge plus quand on choisis un affichage par mois ou par jour
2013-09-07 + Ajout d'un texte annoncant la suppréssion en cours d'une base de logs dans la fênetre de suppréssion des logs
2013-09-07 Mise à jour du mailtype: css des liens, mise en page du titre, ajout d'une 'signature' à la fin du mail...
2013-09-10 + Modification de la gestion des mises à jour qui renvoie vers le site cultibox pour le téléchargement des fichiers
2013-09-10 + Utilisation du fichier index pour gérer les différents capteurs possible de la Cultibox
2013-09-11 Passage partiel des tests opquast
2013-09-12 Correction pour répondre au standard + correction d'un lien cassé + remise en fonction de l'onglet actif du menu + ajout des liens de retour pour la cgv et garantie + je sais plus mais plein de trucs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
2013-09-14 ajout de l'image de garantie
2013-09-21 mise à jour des liens et du sitemap.xml
2013-09-22 Ajout de la description et des mots clefs pour le site web et le résumé dans google
2013-09-22 Transformation des fichiers jpg en png + arrondi des bordes des images pour coller avc la bordure en css
2013-09-25 Ajout procédure envoie de mail avec du code HTML
2013-09-25 Ajout de la font dans le mail
2013-09-30 Correction génération des packages 32bits sur ubuntu + ajout du champ Installed-Size pour ne pas avoir la mention bad package quand on l'install + ajout du copyright (GPL-V3)
2013-10-01 CHangement du texte de remplacement
2013-10-01 + COrrection de l'affichage de la hauteur des legendes des programmes
2013-10-01 + La gestion des erreurs pour la partie 'prise' est gérée en AJAX sans rechargement
2013-10-04 + Ajout d'une barre de progréssion pour la suppréssion des logs
2013-10-08 Remise en forme de la page d'index
2013-10-12 Passage en vert la croissance
2013-10-12 Commit 1: + Passage en AJAX des actions du calendrier + Ajout de la possibilité de désactiver l'affichage des fichiers externe XML du calendrier + Ajout d'un datepicker pour choisir rapidement le moi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
2013-10-13 Amélioration de selecteur de date pour le calendrier
2013-10-14 COmmit 2/3: modification de l'AJAX du calcul du cout, restera un dernier commit et pauffinage et c'est bon
2013-10-14 Ajout du fichier pour générer les écrans
2013-10-16 + Si le fichier des contrastes existe sur la carte SD on ne le remplace pas lors du formatage
2013-10-16 Ajout des tests cases
2013-10-16 Mise à jour du test case
2013-10-16 Livraison des resultats du test 2
2013-10-16 Ajout de l'alarme dans le nettoyage
2013-10-20 + Ajout de vérification de tests d'écriture sur la carte SD + Nettoyage de fonctions inutiles + Passage W3C + Remise des valeurs par défaut si un mauvais format est rentré
2013-10-20 + La suppréssion de tous les évènements du calendrier ainsi que l'ajout d'un calendrier d'engrais met à jour la carte SD
2013-10-21 + Correction du calcul du coût: correction de la modification du prix des heures creuses
2013-10-21 Mise a jour de la recette du package mac
2013-10-23 Ajout des programmes de culture bio bizz
2013-10-23 Inversion description et engrais Suppression de l'*
2013-10-24 + Ajout de textes d'aide pour les boutons 'Gestion des fichierx XML' et 'Suppréssion des annotations' du calendrier
2013-10-24 + Ajout de textes d'aide pour les boutons 'Gestion des fichierx XML', 'Suppréssion des annotations' du calendrier et 'Création de programmes d'engrais' + Correction d'n filtre en fonction du substrat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
2013-10-26 + Ajout d'informations sur le calcul du coût réel et théorique dans l'onglet des coûts
2013-10-26 + Correction du filtre sur le champ substrat sans la carte SD breanchée
2013-10-26 Ajout d'un texte désactivé dans les listes si aucun fichier XML
2013-10-26 + Correction de l'ajout ou la modification d'un évènement du calendrier avec une remarque vide qui posait ne marchait pas
2013-10-26 Ajout du generateur de xml
2013-10-26 Mise à jour des House and garden
2013-10-26 Ajout de GHE
2013-10-26 MAJ des XMLs
2013-10-27 AJout de programme GHE
2013-10-27 Livraison de la fin des engrais GHE
2013-10-27 Livraison de tout les programmes GHE
2013-10-27 MAJ du script de génération
2013-10-28 Ajout de l'icone plagron
2013-10-28 Ajout de Plagron et correction de quelques fautes
2013-10-28 Ajout de plagron !!
2013-10-28 Livraison des engrais et des images
2013-10-29 Ajout des engrais Genesis et Canna
2013-11-01 + Correctifs + Ajout titre fenetre d'informations + Ajout d'un bouton dee réduction et d'agrandissement automatique pour la boite de message + Possibilité d'ajouter des titres qui ne sont pas dans la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
2013-11-01 Correction mise à jour des onglets costs et historic
2013-11-01 Correction de deux boulettes dans les xmls mais ça marche toujours pas très bien
2013-11-03 + Correction de l'affichage des titres dans le calendrier + La première colonne du mois en cours correspond à un lundi et non plus un dimanche
2013-11-03 Ajout de l'ec et du nom de l'événement
2013-11-03 Mise à jour des couleurs
2013-11-03 Ajout de la sélection de la période pour le programme d'engrais
2013-11-03 Simplification du chargement du time picker
2013-11-03 Un peu de traduction
2013-11-03 Fin de la traduction des timepickers
2013-11-05 MAJ des tests
2013-11-06 + Correction du passage en paramètre d'une variable Int dans un appel Ajax (formatage de la carte SD)
2013-11-06 + Modification du texte et de l'image du tooltip de calcul des coûts
2013-11-06 + Correction du passage en paramètre d'une variable Int dans un appel Ajax (formatage de la carte SD) + Modification du texte et de l'image du tooltip de calcul des coûts + Mise en place d'un script 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
2013-11-07 Mise à jour génération de paquet mac
2013-11-07 Passage des scripts debian32 en xampp 1.8.3
2013-11-07 Amélioration des scripts de backup/load + passage par un fichier des credentials mysql pour eviter une warning suite à la mise à jour xampp 1.8.3
2013-11-07 mise a jour des requette sql sous linux
2013-11-08 mise a jour script backup/load pour la base joomla
2013-11-08 Ajout d'un texte pour la non compatibilité mac pour le moment + maj page de téléchargement
2013-11-08 test upgrade des bases mysql
2013-11-08 test de test
2013-11-08 script de backup plus robuste
2013-11-08 Mise à jour des scripts d'installation sur linux 64
2013-11-09 Correction création utilisateur mysql pour linux et les services
2013-11-09 Activation de eaccelerator pour php sur linux ca marche en 1.8.3, ho yeah
2013-11-09 Ajout du script de récupération de la version pour l'upgrade sql et mieux gérer les upgrades en général
2013-11-10 Ajout du système d'upgrade de la base en fonction des versions
2013-11-10 Passage en mode découpage des updates des bases
2013-11-10 Mise a jour recette mac + fichiers de config xampp 1.8.3
2013-11-11 Mise à jour des scripts d'installation sous mac d'après le travail sur linux
2013-11-11 Mise a jour PATH des scripts
2013-11-11 Purge des modules apaches sous mac
2013-11-12 Nouvelle recette mac, presque la fin
2013-11-13 Ajout d'un test pour vérifier que mysql démarre bien sur mac
2013-11-13 Ajout de tests de chargement des bases et de démarrage de mysql pour que l'upgrade soit plus robuste
2013-11-13 Remise en forme des scripts mac + divers modifs
2013-11-13 Correction script de backup pour l'upgrade
2013-11-13 correction des droits pour load.sh de mac os x
2013-11-13 l'un des derniers commit mac on espère: on retrouve les nouveaux fihciers du pre script nécéssaire et on essaye de les copier pour les upgrades
2013-11-14 Mise à niveau des scripts linux et optimisation de l'archive + création à la volée des scripts nécéssaires au backup des bases
2013-11-14 mise à jour des scripts linux
2013-11-14 Mose a jour du découpage de l'upgrade des scripts sql pour joomla
2013-11-14 Changement du path des binaires
2013-11-14 Passage du chemin d'accès de lampp vers cultibox + suppréssion des process restant au début de l'installation
2013-11-14 on check encore les process pour les tuer s'il en reste en cas d'erreur lors des installations
2013-11-14 c'est que le début... d'accord d'accord
2013-11-14 Haha jolie celle la, très jolie: je ne scie plus la branche sur laquelle je suis assis comme on dit
2013-11-16 Correction du load des tables sous linux, faut forcer le load en detruisant les tables...mais y a bon
2013-11-16 Nouveau fichiers de conf pour xampp 1.8.3 windows
2013-11-19 Nouvelle recette pour windows intégrant un fichier de crédential pour mysql
2013-11-19 nouveau script de sauvegarde des données
2013-11-19 Ajout des scripts pour la version 1.8.3 de xampp: windows
2013-11-20 Ajout du script d'upgrade des bases pour windows
2013-11-20 Mise à jour de la recette windows + suppression du script de compile pour plateforme windows maintenant obsolette
2013-11-20 Fin de l'upgrade pour windows
2013-11-21 Ajout d'un diagramme de fonctionnement du logiciel
2013-11-21 Changement format de sortie
2013-11-21 Prise en compte du retour de la commande de backup dans le script d'installation windows
2013-11-21 Correction de la vérification des codes de retour en batch
2013-11-23 Ajout de la recette et du package tar.gz pour xindows xp
2013-11-24 Suppression du joomla
    [web.config.txt]
2013-11-24 Ajout du nouveau joomla épuré
    [web.config.txt]
2013-11-24 Mise à jour de la recette windows
2013-11-24 CHANGELOG pour les nouvelles version
2013-11-24 Mise à jour de la base pour joomla
2013-11-25 Ajout script création des tables mysql
2013-11-25 Mise à jour de la page d'aide (Ajout des notices)
2013-11-26 Mise à jour recette Mac avec nouveau joomla + nouvelle recette sans sauvegarde/chargement des infos
2013-11-27 Passage du chemin des fichiers de conf vers le chemin cultibox pour ajouter la suppréssion des process rémanent + correction du script de load des données. Fin de la mise à jour Mac os x
    [php.ini]
2013-11-27 Ajout d'une recete all architecture pour linux pour les version >= 13.10
2013-11-30 ajout du rapport de CEM
2013-12-01 Correction sur l'import des logs pour Windows XP
2013-12-01 Ajout des fichiers de changement d'heure comme fichier XML
2013-12-02 Ajout de la partie traduite en espagnol
2013-12-02 + Ajout d'un paramètre dépendant du dernier changement lors de l'appel des css et scripts js pour éviter de vider le cache à chaque mise à jour
2013-12-04 + Ajout d'une variable SESSION pour ne vérifier qu'une fois par session la présence de mise à jour et gagner en rapidité d'affichage des pages
2013-12-04 + Correction de la gestion de réduction/agrandissement de la boite de message quand on change la taille manuellement
2013-12-09 Ajout des scripts load/bat revisité pour windows
2013-12-09 Ajout des script load/backup pour mac + quelques correctifs sur l'installeur
2013-12-09 + Ajout du min/max des courbes sur la page des logs '
2013-12-09 + On ne prend plus les doublons dans les courbes s'ils existent
2013-12-09 Même chose pour les logs power
2013-12-11 + L'affichage des listes des marques, substrats et fichiers XML sont triées par ordre alphabétique + Un fichier XML avec une seule entrée ne pose pas de problèmes
2013-12-13 + Lors de l'ajout d'un nouveau champ titre dans le calendrier, les données sont encodées en JSON pour éviter les caractères parasites + Ajout d'un champ 'important' dans les évènements du calendrier 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
2013-12-13 Mise en forme des dialog box 1: suppression de la touche ESC pour fermer les dialogues
2013-12-13 + Mise en forme de certaines boîtes de messages + Correction de l'export des logs avec la nouvelle version de XAMPP
2013-12-13 Correction pour l'export des logs: on optimise la gestion du buffer pour eviter un overflow (apparait sous mac os x)
2013-12-14 Portage de l'export des logs sur windows + vidage buffer pour les overflow
2013-12-14 Correction de la gestion du champ important du calendrier + affichage en rouge du texte si un évènement est important + passage par JSON pour parser les données renvoyées en ajax
2013-12-14 Ajout d'un champ important: système d'affichage pour les +/- 7 jours par rapport au jour actuel + Ajout d'une variable SESSION pour nafficher le résumé qu'une fois par session
2013-12-18 + Passage de la période -1 jours/ + 7 jours pour l'affichage des messages importans du calendrier
2013-12-18 + Correction du choix du capteur lors de l'affichage des min/max dans les logs
2013-12-18 + Correction des requetes SQL lors de tris sur de multiples critères
2013-12-18 + Correction de l'affichage des min/max des logs pour ne pas afficher les capteurs qui n'ont pas de données significatives
2013-12-19 Robustesse des tests de connection mysql sous mac os x
2013-12-20 Modification scripts d'installation mac os x: test en fonction de l'upgrade
2013-12-21 Ajout Des scripts permettant de générer le calednrier lunaire
2013-12-21 MAJ du fichier avec toutes les dates 2014
2013-12-21 Ajout des images pleine lune et nouvelle lune
2013-12-21 Changement des images de pleine lune et nouvelle lune
2013-12-21 Ajout des couleurs et renomage
2013-12-22 Transparence image de fond mac os x + mise à l'echelle
2013-12-26 Remise en fonction du -1/+7 pour les jours importants qui a sauté durant une mise à jour
2013-12-28 Correction test de connection sur mac os x
2013-12-28 suppression de l'ancien calendrier lunaire
2013-12-28 + Suppression de l'ancien calendrier lunaire 2013 et ajout du calendrier 2014 + Correction d'une erreur dans les scripts d'installation Mac os x (bouclage si une commande ne renvoie pas le bon code d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
2013-12-28 + Affichage des fichierx xml à afficher par ordre alphabétique
2013-12-28 + Correction de la génération des titres du calendrier après la suppréssion d'un évènement
2013-12-28 Mise à jour des champs du calendrier pour compléter une journée
2013-12-29 Correction du nom de l'architecture sur un script d'installation mac os x
2013-12-29 + Optimisation de l'algorithme de création des évènements sur la carte SD
2013-12-30 mise à jour aide du script des paquets windows
2013-12-30 Correction pour l'upgrade de mac os x
2014-01-03 Correction de l'installation pour mac os x + correction du script load.sh de mac os x
2014-01-04 + Correction du code HTML pour respecter le standard W3C + Ajout de deux capteurs possibles pour la régulations (6 en tout - 4 utilisés pour les logs) + Correction de la mise en forme pour la langue 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
2014-01-04 + Ajout de la possibilité de configurer une pompe à eau (commit 1)
2014-01-04 + Ajout de la possibilité de configurer une pompe à eau (commit 2)
2014-01-06 + Modification de la programmation cyclique, simplification des textes affichés et du fonctionnement
2014-01-06 + Ajout de la configuration d'une prise variateur dans l'onglet prise
2014-01-07 Correction adresse des prises vario
2014-01-07 Possibilité de configurer une prise variateur avec l'assistant
2014-01-07 + Disparition des fenêtres MSDOS de l'installation windows
2014-01-08 Création d'un fichier de log d'installation pour windows
2014-01-08 MAJ de la page achat
2014-01-10 Livraison des firmwares 1.1 pour le capteur de niveau d'eau
2014-01-11 Unicité du canal de transmission choisis pour les variateurs dans l'onglet prise
2014-01-11 Mise à jour du tooltip de la conso des prises avec la nouvelle formule
2014-01-12 Correctif sur la possibilité de sélectionner une, plusieurs ou toutes les prises pour l'affichage des puissances
2014-01-12 Ajout des firmwares pour le capteur d'eau
2014-01-14 + Correction de l'affichage des puissances dans la partie logs (nom des prises)
2014-01-15 + Correction de l'affichage des puissances (bouton next et prev)
2014-01-15 Ajout des prises 5 et 6
2014-01-15 Maj de la section de la doc pour le capteur de niveau deau
2014-01-16 + un zoom par courbe disponible dans l'onglet log (puissance,humidité,témpérature) + Ajout des couleurs sur les grilles des échelles des logs
2014-01-16 + Sauvegarde des données des zooms lorsqu'on utilise la fonction jour suivant ou jour précédent des logs
2014-01-16 Changement de la valeur par défaut des cycles de programmation
2014-01-16 Correction de la pompe à eau dans le wizard
2014-01-16 Changement de texte
2014-01-18 + Plus de limites de caractères pour les fichiers cal_XX + Correction du calendrier (glissement des évènements qui supprimaient les annotations + problème de liste des titres en cas d'erreur)
2014-01-19 mise en forme pour les logs
2014-01-20 Mise en forme des nouveautés du site
2014-01-20 Livraison du firmware de l'émetteur 1.12
2014-01-26 Réorganisation des documents type + ajout d'une ébauche de présentation type
2014-01-26 Suppression du fichier version.txt (useless) Ajour du firwamre 2.11 de la CBx
2014-02-03 Création de la table des types de capteur
2014-02-03 Optimisation du chargement des logs: lecture d'un fichier en une seule fois + optimisation du fichier index qui n'est pas lu une fois par requette mais une fois pour toute
2014-02-04 Mise à jour de la table capteur avec le fichier index
2014-02-04 Correction numéro de version
2014-02-04 Ajout d'un test d'écriture sur la carte SD avant le formatage
2014-02-04 MAJ du calendrier lunaire pour prendre en compte la feature #751
2014-02-04 AJout des lunes montantes et descendantes
2014-02-05 Commit wifi + debug (1/2): + Ajout d'un menu de configuration wifi + Correction des caractères \n dans le calendrier et le fichier index
2014-02-09 Ajout des vidéos (a la rache)
2014-02-09 + Optimisation de la lecture/ecriture des fichiers + Ajout d'une biblothèque de débug + Correction de la création du fichier de configuration du wifi
2014-02-09 + Correction des sauts de lignes dans les fichiers calc_XX
2014-02-09 Correction des boulettes sur le calendrier lunaire : - Encodage en presque UTF8 - Suppression de la première ligne vide
2014-02-09 Mise en forme de la présentation des vidéos sur le site web
2014-02-10 MAJ des textes lorsque la carte est bloquée
2014-02-10 Ajout de quelques commentaires
2014-02-12 Ajout du menu wifi et des pages associées
2014-02-12 Mise à jour de l'ordre du menu joomla
2014-02-13 Upgrade de joomla pour le wifi
2014-02-14 Mise à jour de la partie configuration du wifi, il reste la gestion du mot de passe à faire
2014-02-15 Ajout du traitement des données XML pour le wifi (plug state) + passage W3C + correction locales
2014-02-15 + Ajout de la possibilité de créer des programmes définit avec une prise variateur
2014-02-16 ajout CBX_1_14_0001_PTS_electronic_range&precision_water_temperature_°C_-.pdf LE CBX_1_13_0024 est à supprimer car doublon. J'ai oublié de passer en 2014 pour le titre du document...
2014-02-16 + Ajout d'un champ IP permettant la configuration du module Wifi
2014-02-16 Suppression d'un fichier de trop
2014-02-16 correction comparatif de la configuration Wifi
2014-02-19 Mise à jour des champs pour le wifi
2014-02-23 Message d'erreur en cas de mauvaise connexion wifi + rappel recursif de la page pour mettre à jour les données
2014-02-24 MAJ de l'image du capteur
2014-02-24 Ajout de l'image avec le pack
2014-02-24 Ajout du champ date dans le xml + gestion des adresses des prises du xml pour le wifi
2014-02-26 Recupération des adresses ip du wifi + mise à jour de la procédure de création des fichiers de configuration
2014-02-26 mise a jour des ip pour le wifi
2014-02-28 Changement de l'image du capteur
2014-03-18 Remise en marche du fichier de changelog des firmwares
2014-03-20 Ajout de la traduction en espagnol
2014-03-22 Mise à jour de la documentation
2014-03-23 + Selection d'un ou plusieurs capteurs possible dans la visualisation des logs + Enregistrement des courbes déselectionnées sur le changement de jours des logs (bouton suivant et précédent)
2014-03-23 + Le zoom en X sur les logs ne modifie plus l'affichage en Y
2014-03-23 AJout de la PTS dans la doc
2014-03-31 Cleanage du dépôt svn pour le soft
    [main_assemblage.stp]
2014-04-02 Ajout d'une compat de mozilla
2014-04-02 Rechargement de la page de conf après un formatage de la carte SD + des commentaires + automatisation des ordonnées des capteurs pour le graphge des logs
2014-04-02 + Correction de l'affichage des coûts: on scroll après le calcul du coût ce qui permet d'éviter un problème d'affichage sur mac
2014-04-02 + Changement de l'affichage du menu de configuration des prises pour ressembler à celui du menu de configuration + Ajout de la définition des autres capteurs (ph, ec...)
2014-04-03 + Ajout de l'heure du min/max des valeurs affichées pour les logs
2014-04-03 + Possiilité de cacher la boîte de message pour le temps d'une session
2014-04-03 Mise en forme du cachage de la msg box
2014-04-14 Ajout des version 1.1 des firmwares de ph
2014-04-15 + Le bouton 'fermer' de l'importation des logs ne s'affiche maintenant à la fin du chargement des fichiers logs ET powers et non lorsque l'un des deux et terminé
2014-04-15 + Correction de l'enregistrement de la version du firmware
2014-04-19 + Ajout de la mise à jour de l'id dans le fichier de configuration de la Cultibox
2014-04-19 + Optimisation du chargement des logs power
2014-04-19 + Ajout de palliers pour le zoom des logs
2014-04-21 Ajout du calendrier pour les jours carottes
    [calendriers.xls]
2014-04-21 Livraison des firmwares
2014-04-22 + Correction de la position de l'image qui apparaît quand on cache la boîte de dialogue du logiciel
2014-04-22 Correction du bug de compilation Ajout des images pour les écrans capteurs
2014-04-22 MAJ du calendrier
    [calendriers.xls]
2014-04-22 + Correction de l'affichage de la selection des prises
2014-04-22 + Lorsqu'on choisit un seul capteur pour la régulation, les options de min/max/moyenne sont désactivées dans l'interface
2014-04-23 Ajout des engrais GHE General Organics
2014-04-23 Ajout des engrais général organics
2014-04-23 Mise a jour des GHE
2014-04-23 Mise en place des firmwares fonctionnels pour pH ORP et OD (Version 1.2)
2014-04-25 Mise en place des firmwares fonctionnels pour l'EC (V1.2)
2014-04-26 + Correction de l'affichage de l'oeil
2014-04-27 + Corection de l'affichage des erreurs de valeur des programmes + Ajout d'un champ permettant de définir le début et la fin d'un cycle + Ajout de la vérification à la saisie des valeurs pour les heur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
2014-04-27 + Ajout de deux capteurs supplémentaires dans la table sensors
2014-04-27 Fin de l'intégration du nouveau fichier index et des types de capteurs
2014-04-27 + Ajout des firmwares de nouveaux capteurs
2014-05-02 + Modification du chargement des logs en fonction des capteurs afin d'intégrer les nouveaux capteurs dans la Cultibox
2014-05-03 Commit 1/3: Affichage des logs des nouveaux capteurs
2014-05-03 Correction d'une boulette dans la doc
2014-05-04 Commit 2/3: affichage des nouveaux logs en fonctions des capteurs: affichage par mois, affichage des puissances et des programmes, selection-deselection des capteurs, corrections des bugs, gestion de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
2014-05-04 3/3: Fin du chargement des nouveaux logs: nettoyage et affichage des unité + debug de l'affichage des programmes
2014-05-05 Ajout des firmwares 1.3 qui limites les valeurs qui peuvent être transmises
2014-05-05 Correction du problème sur les erreurs RTC_OFFSET
2014-05-05 Correction de deux autres problèmes sur RTC_OFFSET : - Le calcul n'était pas bon - La valeur enregistrée lors qu clique sur "enregistrer" n'enregistrer pas la valeur calculé mais la valeur de la BDD
2014-05-06 Correction de la vérification des mots de passe du wifi
2014-05-06 Correction de l'intégration et du remplissage de la table sensors en fonction des logs présents
2014-05-14 Mise à jour du code du calendrier pour gérer plusieurs icones dans les événements
2014-05-14 Mise en forme du calendrier pour que les événements lunaires apparaissent sur une seule ligne
    [calendriers.xls]
2014-05-15 Commit de la versin 2.16 du firmware
2014-05-16 + Fractionnement des librairies + Ajout des traductions dans les langues manquantes + Possibilité d'utiliser plusieurs icônes pour les évènements du calendrier + Suppréssion de l'onget historique Com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
2014-05-16 Mise à jour des requettes SQL pour la suppression de l'onglet historique
2014-05-16 Cleanage de la base joomla sans les références à l'onglet historique
2014-05-16 Suppréssion des msgids non utilisés
2014-05-16 Nettoyage des msgid non utilisés
2014-05-16 - Verification de la présence d'une mise à jour logicielle en ajax - Factorisation du code
2014-05-16 Correction d'ou oublie dans check_update.php (l'info de version du soft n'était pas dispo) Suppression de la vérrue qui permet de vérifier à chaque fois la version
2014-05-17 Correction des locales manquantes ou erronées
2014-05-17 Ajout de la vérification de la carte SD en ajax (non mis en place, un dernier bug à résoudre) Passage en JSON du retour de la vérification du logiciel Boite de message : Toujours affichée. Gestion en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
2014-05-17 - Suppression du commentaire qui dans check_and_update_sd.php - Mise à jour des deux libs js pour que les messages restent affichés
2014-05-18 correction des dernières locales manquantes
2014-05-18 Correction des locales + correction des notes
2014-05-18 Correction des locales
2014-05-19 Correction des trois erreurs présentes dans le javascript
2014-05-19 Correction des dernières erreurs d'affichage des messages
2014-05-19 Suppression de la fermeture de la boite si rien n'est affiché
2014-05-19 Correction de l'affichage de l'oeil et de la création des messages avec une image dedans
2014-05-19 - Ajout de la possibilité de se connecter en root pour créer des bases - Correction d'un oubli d'initialisation de variable
2014-05-19 correction de l'affichage des données des logs pour le waiting
2014-05-19 * Gestion du programme au jour : Première partie * - config.php : Comme on est en dev, l'activation est réalisée dans le fichier - db_get_common.php : Ajout de la sélection du programme dans get_data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
2014-05-21 - L'oeuil est maintenant dans le template.php - Creation d'une page js pour la page calendrier - Plannification d'engrais en modal
2014-05-21 Mise en place avec des boutons
2014-05-22 AJout de la possibilité de mettre des événements du programme journalier dans le calendrier
2014-05-22 Vérification de la base sur chaque page
2014-05-22 Modif de la base et factorisation
2014-05-22 Mise en forme de la première ligne
2014-05-22 Séparation du code JS et HTML de la page program
2014-05-23 Programme journalier fonctionnel, reste encore deux trois trucs à gérer (pas deux programme le même jour, max 99 programmes ...) Corrdection du bug de RTC_OFFSET Correction du problème du calendrier 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
2014-05-23 Ajout de l'interdiction de mettre deux programme journalier le même jour
2014-05-24 FIn de la vérification de l'overlapping
2014-05-24 FIn de la suppression du check config
2014-05-24 Correction des couleurs par défaut des courbes du logiciel
2014-05-24 Ajout de l'option d'affichage des couts géré par ajax, rechargement de la page oblogatoire
2014-05-26 -Passage en ajax de l'écriture du calendrier au démarrage - Ecriture des événements XML fixe sur la carte SD - Passage en ajax de la sélection/déselection des XML - Changement de la gestion des XML e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
2014-05-26 AJout des symboles du calendrier lunaire
2014-05-26 Ajout de commentaire
2014-05-26 Ajout de l'envoi d'information pour toute les pages mais une seule fois par session
2014-05-26 Ajout d'un field comments à la table program_index
2014-05-26 Ajout de la création automatique des programmes dans la page alendrier
2014-05-26 Factorisation de la vérification des bases
2014-05-26 Correction de bugs
2014-05-27 Fin (?) du découpage des javascripts
2014-05-27 Correction du chargement du fichier index
2014-05-27 Suppression de debug restant
2014-05-27 - Ajout de la visualisation multiprogramme sur le mois
2014-05-28 Correction de bugs sur la page programme Premier jet pour l'ajout de programme dans la page logs en ajax. Attention ne fonction que pour l'affichage au jour.
2014-05-28 Avec un début de fonctionnement au mois
2014-06-02 Correction et amélioration de la page configuration
2014-06-04 Suppression de la doc présente par défaut
2014-06-04 -Correction de l'envoi d'information
2014-06-05 -Passage en ajax du chargement des courbes !
2014-06-05 Mise à jour du parser de calendrier lunare
2014-06-07 Correction du css jquery + passage w3c pages welcome et calendrier + réorganisation du calendrier + ajout fonction modal sur les options du calendrier
2014-06-07 Correction de l'ajout des programmes avec le wizard
2014-06-09 Correction du calendrier: mise en forme de l'affichage
2014-06-09 correctif pour l'import des programmes
2014-06-09 Passage w3c de la page plugs
2014-06-09 Decommit de Yann : L'ordre doit être respecté !!!
2014-06-09 Ajout d'une confirmation sur le changement de type de prise si un programme est définit
2014-06-09 Mise en page + correction bugs + début passage w3c des logs
2014-06-09 fin de la mise en page des logs
2014-06-09 AJout de la possibilitée de mettre des programmes journalier dans l'UI de modification des événements
2014-06-10 Correction de la detection des cartes pour le formatage + correction de la copie du fichier conf s'il n'existe pas
2014-06-10 Correction de la redirection après formatage de la carte SD + correction commit précédent
2014-06-10 COrrection de plein de petites erreurs
2014-06-10 Correction du problème de non création du calendrier d'engrais
2014-06-11 Ajout des courbes de couleurs différentes
2014-06-11 Ajout des engrais platinium
2014-06-11 Suppression de la page waiting + correction des accents dans highchart
2014-06-11 Remise en forme de l'onglet prise
2014-06-11 Correction de la date par défaut au chargement de la page + Affichage de l'image fake log en cas de fake log
2014-06-12 -Correction d'un problème overlapping dans le calendrier -Mise à jour de la vérification de version avec un numéro SVN
2014-06-16 Ajout de la vérification des fake logs ( ISSUE 878 )
2014-06-16 Correction du problème d'affichage des courbes programme (ISSUE 866)
2014-06-16 Correction ISSUE 867 : Le défilement au mois ne fonctionne pas Suppression de la verrue 7200 (changement timezone)
2014-06-16 Correction du wizard: remise en forme + mise en forme du dactepicker + modification du css + correction des valeurs pr défaut en cas d'erreur + remise en place de la fonction VerifValue pour les prog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
2014-06-16 Correction ISSUE 871 (couleur des programmes dans la page log)
2014-06-17 Correction d'une boulette sur les programmes au mois (l'affichage dans les logs oubliait quelques jours ...) Amélioration de l'affichage des programme au jour
2014-06-17 Decommit de Yann !
2014-06-17 Mise à jour du chargement des fake_logs
2014-06-17 Correction des derniers bugs
2014-06-17 Correction des differents bug
2014-06-19 AJout de la valeur par défaut du capteur 1
2014-06-19 Ajout d'un deuxième set de jeu de couleur pour la puissance
2014-06-19 Remise en forme du formulaire de management des logs + on ne peut pas définir le même id sur plusieurs boutons
2014-06-19 Correction du chargement des logs: il faut supprimer les caractères invisibles sinon cela pose problème
2014-06-20 Correction des deux trois boulettes trouvées par PP
2014-06-23 Changement de l'initialisaton de la table sensors
2014-07-01 Correction des packages Ubuntu
2014-07-06 Déplacement du site distant pour les mises à jour de cultibox.highproshop.fr vers cultibox.fr
2014-07-06 + L'option des programmes journaliés est toujours activée + Nettoyage du champ SHOW_HISTORIC qui n'est plus nécéssaire
2014-07-06 Correction de l'affichage de la régulation secondaire dans l'onglet des programmes
2014-07-06 Commit 1/XX: + Correction de la taille minimale de la fenêtre du logiciel + Passage en ajax pour l'enregistrement de la configuration + La carte SD n'est vérifiée qu'une seule fois par branchement et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
2014-07-06 Correction de la configuration: 2/XXX - Remise en place de la vérification de la carte par Ajax, nettoyage des pages welcome et configuration
2014-07-06 Correction de la configuration: 3/XXX - netoyage et ajout des messages de vérification pour la configuration
2014-07-06 Correction du chargement automatique des logs
2014-07-07 Correction page de configuration
2014-07-07 Rajout de la couleur de la courbe correspondante dans l'affichage des min/max
2014-07-07 + Sauvegarde de la configuration des capteurs selectionnés lors d'un changement de jour par les boutons suivant et précédent
2014-07-07 + Sauvegarde de la configuration des capteurs, des programmes et des prises selectionnés lors d'un changement de jour par les boutons suivant et précédent
2014-07-07 Correction de l'activation des programmes journaliers
2014-07-07 Suppression des fake logs après le premier chargement
2014-07-07 nettoyage des pages
2014-07-08 Vérification de la version avant installation sous windows + diffrenciation des recettes windows et windows xp
2014-07-09 Correction de l'affichage des logs ou le jour de la semaine est 7
2014-07-09 Correction d'un bug sur le wifi : si c'est activé la section ne s'affichait pas car le pointeur sur la base de donnée n'étai opas le bon
2014-07-09 Correction d'un check value qui empechait d'avoir la bonne adresse !
2014-07-09 On cache la section qui permet de définir l'adresse de la Cultibox
2014-07-10 + Correction de l'affichage et la gestion des programmes journaliers dans l'onglet programme
2014-07-10 + Correction de la déselection des courbes dans l'onglet logs + Affichage des informations de régulation secondaire dans le résumé de l'onglet programme
2014-07-10 correction logs, on est obligé de bloquer l'UI pendant les requettes d'ajout/suppression pour empecher que l'utilisateur relance une requette avant la fin de celle-ci, autre possibilité, mettre un sy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
2014-07-11 Correction sur la conf wifi
2014-07-12 Correction de l'affichage du programme sur un jour (ISSUE 898)
2014-07-13 -Correction du problème d'affichage de certains jours dans la base
2014-07-13 Correction de la recherche des courbes de programmes
2014-07-13 Patch de fullcalendar pour que les événements de la lune soit en dessus
2014-07-17 Correction de la création d'un évènement après la modification du full calendar
2014-07-17 Correction du drag and drop des evènements journaliers
2014-07-17 Correction des champs disabled lors de l'ajout d'un évènement journalier
2014-07-17 Correction affichage de la régulation secondaire + affichage régulation secondaire dans les graphes de programmes
2014-07-18 Correction de la gestion des valeurs par défaut lors du changement de type de prises
2014-07-18 Correction bugs sur la gestion des prises
2014-07-18 correction du boutton display des logs
2014-07-18 Correction de la page programme
2014-07-20 + Affichage du dernier jour possedant des logs après le chargement de logs + Correction d'un erreur jquery si le champ startdate est vide de l'affichage des logs
2014-07-20 + AJout des librairies jquery pour les pages welcome et cost + Ménage et réorganisation + Correction de la gestion des sessions + Rechargement des logs si l'utilisateur enlève et replace la carte SD
2014-07-20 + Correction de l'affichage des résumés des régulations secondaires
2014-07-20 + L'affichage de la fenêtre des programmes journaliers n'apparaît pas dans le calendrier si aucun programme journalier n'a été défini
2014-07-20 + Il est impossible de choisir la méthode de calcul des options avançées de régulation si un seul capteur est sélectionné
2014-07-21 Passage en async des ajax lors de la sauvegarde de la page conf
2014-07-21 Correction de l'enregistrement de la configuration
2014-07-21 Correction du chargement des fichiers de log
2014-07-21 Correction de l'affichage des fakes logs
2014-07-21 + Correction de la vérification des mots de passe de la partie WIFI
2014-07-21 Correction mot de passe wifi + blocage UI lors de la soumission de la conf
2014-07-21 Correction de la mise à jour des capteurs qui pouvait foirer si le fichier index était corrompu
2014-07-22 + La tolérance est prise en compte dans le calcul max et min de la régulation d'une prise dans le logiciel
2014-07-22 Correction de l'affichage des logs
2014-07-22 Le ratio appliqué aux records des capteurs dépend maintenant des capteurs
2014-07-22 + Les fichiers log et power sont sauvegardés dans un repertoire tmp en cas de problèmes
2014-07-22 COrrection de l'ISSUE 915
2014-07-24 Correction des appels Ajax
2014-07-24 + Vérification de la présence de Javascript dans le navigateur
2014-07-24 + Suppréssion de l'option SHOW_POPUP et réorganisation de l'affichage des messages + Nettoyage + simplification + passage w3c
2014-07-26 Correction sur les pages calendrier et programme
2014-07-26 correction de la gestion des erreurs des calendriers d'engrais
2014-07-28 Correction de l'ajout des fakes logs
2014-07-28 Nettoyage des locales
2014-07-28 Nettoyage des fonctions php non utilisées
2014-07-30 + Correction de l'affichage des mois dans la page logs + Correction du changement de couleur du graphe, tooltip, legend quand on change la couleur dynamiquement
2014-07-30 + Affichage des heures/minutes correspondant aux min/max dans le tooltip + Les programmes ne sont plus affichés dans le tooltip min/max
2014-08-03 + Les adresses IP pour le wifi sont maintenant écrite avec 3 digits par champ afin d'être lues par la Cultibox
2014-08-03 + Les sauvegardes des programmes journaliers ne peuvent pas avoir le même nom
2014-08-03 + Correction du rechargement de la page lors de la suppréssion des programmes jouanliers en cours de visualisation
2014-08-03 + Correction de la gestion des jeux de programme
2014-08-03 + Aucune régulation secondaire possible pour les effecteurs de type pompe à eau
2014-08-04 Correction du tooltip des valeurs des programmes
2014-08-04 Correction de l'affichage des valeurs min/max pour la régulation
2014-08-05 Suppression de l'option de vérification des mises à jours
2014-08-05 + Correction de l'enregistrement de la configuration
2014-08-05 Correction modification du seuil de la régulation
2014-08-05 Debu du chargement des logs si 0000 est présent dans le timestamp (jour 0 + heures < 10)
2014-08-05 Correction du calendrier: les jours commencent a 02:00:00
2014-08-05 même correction pour la suppréssion
2014-08-11 Correction de la vérification des updates
2014-08-24 + Correction de la mise à jour des prises au chargement de l'onglet
2014-09-10 [ISSUE 931] Changement du nombre de digit de l'index du fichier plugv à 5
2014-09-11 COrrection install de CBx
2014-09-11 Ajout de la possibilité de supprimer la limite de 1000 changement Ajout de la possibilité de supprimer la limite de 5 minutes (pour le cyclique) Mise en place du RTC OFFSET deuxieme mouture
2014-09-13 Ajout du calendrier lunaire 2015
    [calendriers.xls]
2014-09-30 MAJ des parses de calendrier
2014-10-01 Passage de l'ajout de programme en ajax
2014-10-01 Correction de la gestion du rtc_offset
2014-10-03 + Suppression des itérations de l'url localhost pour rendre le soft compatible avec le module wifi + Correction et vérification de l'écriture de la carte SD lors du changement de configuration (ajout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
2014-10-09 + Remise en fonction des ancres + Affichage des messages d'utilisation du wizard dans la boite de message
2014-10-09 remise sur 5 digit de la première ligne du fichier plugv
2014-10-10 Correction nbre digit pour le fichier plugv + correction d la checkbox de reset du programme dans l'onglet programme
2014-10-10 Correction de l'affichage des infos/erreurs dans la boite de dialogue + correction wifi
2014-10-10 Correction de la copie des fichiers templates sur la carte SD
2014-10-10 + Correction de la gestion des radios boutons des prises
2014-10-10 + Correction du chargement automatique des logs et de la fermeture de la fenêtre
2014-10-12 + Passage en AJAX de l'onglet Assistant
2014-10-13 Correction des installateurs mac et linux
2014-10-15 + Désactivation de la configuration de la fréquence d'enregistrement de l'état des prises
2014-10-15 Nombre de prise dans le fichier pluga sur 2 digits
2014-10-16 + Correction de la vérification de la configuration des puissances des prises
2014-10-16 + Correction de l'affichage des logs power lors des changements d'état
2014-10-16 Correction génération des logs power
2014-10-17 On n'affiche qu'une fois par prise le message de changement de type de prise si un programme est définit
2014-10-18 + Mise en forme de l'affichage des erreurs des programmes + Correction de la détection des erreurs des programmes
2014-10-18 + L'onglet wifi n'affiche que les prises configurée dans le logiciel
2014-10-19 Changement des valeurs par défaut des programmes cycliques + rechargement de la page si on modifie la limite des 1000 états pour vérifier la carte SD
2014-10-19 Ajout des blockUI pour la création et chargement d'un programme
2014-10-20 On avorte la requette de vérification de la carte SD au changement de page - une autre sera lançée
2014-10-20 Ajout de tooltip pour les limites des programmes
2014-10-20 Correction de la gestion des mots de passe du wifi
2014-10-24 + Ajout de messages lors du traitement des informations du calendrier + Correction de l'écriture du calendrier lors de la modification d'évènements
2014-10-24 Ajout du champ ipr pour la conf wifi
2014-10-28 + Valeur par défaut de l'alarme de 60°
2014-10-28 Correction titre dans la section programme
2014-10-28 Je vois bien que tu veux pas faire d'effort ! Alors je le livre le firmware 2.21 !!
2014-10-29 Remise en fonction de la vérification de la taille du disque à formatter
2014-10-29 Livraison de 2.22
2014-10-29 + Possibilité de choisir une période pour l'export des logs
2014-10-29 + Ajout de la signature du paquet pour Mac OS X afin d'éviter la désactivation de gatekeeper
2014-10-30 Correction export des logs
2014-10-30 + Correction de l'écriture du fichier plugv lors de la désactivation de la limite des 1000 changements
2014-10-30 Correction pour l'eport des logs
2014-10-31 Si on ne peut pas obtenir la version du soft on upgrade quand même
2014-10-31 + Correction des upgrades: si on ne peut pas obtenir la version du logiciel sur Mac, on tente tout de même l'upgrade
2014-10-31 Comm signatue des paquets
2014-11-03 + L'envoie d'informations se fait maintenant après la vérification de la carte SD + Une message par popup prévient l'utilisateur s'il dépasse le nombre maximal de changements pour le fichiers plugv
2014-11-03 Correction des min/max des capteurs
2014-11-04 Correction de la gestion de la table informations
2014-11-04 Correction de la suppréssion des courbes
2014-11-07 + Correction du chargement des données des logs si le capteur 1 est manquant + Affichage d'une gridline sur le graphe des logs pour remettre le zoom en autoscale
2014-11-07 Correction pour l'include des js
2014-11-07 Ajout d'une directive pour ne pas mettre en cache les fichiers du logiciel
2014-11-07 Script de backup/load permet de sauvegarder et restaurer indépendamenet de la version (compat ascendante, pas descendante)
2014-11-07 Script de backup/load permet de sauvegarder et restaurer indépendamenet de la version (compat ascendante, pas descendante) -> mac + correctif linux
2014-11-10 + Ajout d'un désinstallateur sous forme de paquet pour Mac Os X + Correction de l'installation pour Mac Os X + Ajout du champ DEFAULT_LANG en cas d'upgrade sur une version non fonctionelle
2014-11-10 Force l'execution du script d'update même s'il y a une erreur
2014-11-12 + Ajout des tables sensors, informations et program_index dans la gestion automatique du logiciel
2014-11-12 clean de fichiers d'upgrade sql
2014-11-13 Ajout table plugs dans la gestion auto de la base
2014-11-13 Ajout table programs dans la gestion auto de la base
2014-11-14 Amélioration de l'auto réparation du soft
2014-11-14 Vérification de la gestion de la base en live + possibilité de changer le type d'une colonne sans supprimer/ajouter
2014-11-14 On s'affranchit des update_sql.sql pour la version 2 du soft
2014-11-14 On créé les tables power et logs si elles n'existent pas, pas de vérif des champs
2014-11-14 plus de robustesse sur la table sensors
2014-11-14 Plus besoin de gérer les fichiers sql pour la sauvegarde/restauration des bases
2014-11-15 Ajout de la possibilité de changer le default value dans la base par gestion automatique du logiciel
2014-11-15 + Renforcement de l'installation/upgrade du logiciel capable de vérifier sa propre intégrité
2014-11-19 + La carte SD n'est pas vérifiée à chaque chargement de page
2014-11-19 BlockUI sur la page programme pour l'ajout de programme similaire
2014-11-20 + Correction de l'affichage des powers sous Windows
2014-11-20 Debut de la suppréssion du boutton afficher pour les logs par jour - on le garde pour les logs au mois
2014-11-20 Disparition du bouton afficher pour la partie log
2014-11-21 Nettoyage des dernières traces joomla
2014-11-26 SUppréssion de joomla
2014-11-26 + Suppréssion des restes de Joomla
2014-11-26 Commit pour Al: l'enregistrement d'un programme est optimisé, exemple d'un programme avec + de 1400 changements => créé en moins de 2s
2014-12-01 Ajout des modèles XML Ajout du module de pilotage
2014-12-03 Ajout du premier jet du logiciel de configuration du réseau de la Cultipi: cultinet
2014-12-03 Ajout doc de création de l'image de base sur raspberry: premier jet
2014-12-08 + Correction appel l'affichage des logs pour un mois
2014-12-08 Ajout des fichiers du demérrage comme service du logiciel cultipi
2014-12-08 + Suppréssion de la partie Wifi dans le logiciel cultibox + Ajout d'une variable pour déterminer le fonctionnement: cultibox ou cultipi
2014-12-09 Ajout de la création du package cultipi
2014-12-11 Correction de la génération du plugv avec les programmes journaliers
2014-12-11 MAJ de CultiPi
2014-12-13 La configuration et le démarrage du chip de l'émetteur est fonctionnelle Ajout d'une conf standard pour RPi
2014-12-14 Ajout de la nouvelle version de i2ctool : La lecture d'adresse 0x01 et 0x02 est maintenant possible
2014-12-14 Lecture des capteurs fonctionnels
2014-12-15 Mise a jour des paquets cultipi avec nouveau chemin
2014-12-15 Ajout du cron de mise à jour pour les packages géré par le service cultipi
2014-12-15 Corection cron des mises à jour
2014-12-15 Ajout des dépôt APT + correction création de paquet
2014-12-15 Amélioration de la gestion du wifi
2014-12-15 Chanegemnt de la conf par défaut
2014-12-15 Recherche des capteurs que toute les minutes
2014-12-18 Mise a jour des services et packages cultipi/cultinet/cultibox
2014-12-19 Ajout de la version du soft CultiPi
2014-12-19 Version 1.0.02 - Correction de l'algo de régulation (cette version est qualifiée) - Dans la conf histo par defaut, on enregistre toutes les 60 secondes - Mise à jour du simulateur
2014-12-20 renforcement des services cultipi + ajout du cron qui relance le service
2014-12-20 Version 1.0.03 - Correction du chargement du bon fichier plugv - Suppression entiere du log lorsqu'on attaque une nouvelle journée - Ajout du package piTime pour gérer les heures - Mise à jour dans l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
2014-12-20 Correction de l'export de l'image des logs + utilisation du changelog pour générér la version cultibox
2014-12-20 Ajout des couleurs pour les courbes des capteurs 5 et 6
2014-12-21 Ajout du verbose dans les fichiers de conf.xml Création du serveurMessage.tcl pour serverAcqSensor Mise en place du simulateur dans les fichiers de conf
2014-12-21 + Ajout d'une message par popup lorsqu'une courbe de puissance est sélectionnée sans puissance configurée
2014-12-21 + Correction de l'affichage des puissances pour le jour 07 de la semaine
2014-12-22 Changement des niveau de trace
2014-12-23 Premier jet du Wifi (Synoptique avec les capteur en place)
2014-12-24 Ajout d'un bouton d'affichage des réseau disponibles + bouton de rescan des réseaux + gesntion du essid du adHoc avec adresse mac
2014-12-24 Ajout du lien de la popup de configuration du réseau
2014-12-24 Ajout des prises
2014-12-24 Ajout des boutons
2014-12-26 Passage du nom wifi vers cultipi + ajout de l'administration du cultipi
2014-12-26 Ajout des droits pour la gestion du cultipi
2014-12-26 Ajout du repertoire temp de configuration
2014-12-26 Ajout du repertoire de conf cultipi
2014-12-27 Ajout de la gestion des configurations cultipi
2014-12-27 Ajout de l'image de fond par defaut du synoptique
2014-12-27 Création des fichiers de base lors de la première connexion
2014-12-27 Ajout de la gestion de la rotation
2014-12-28 Version 1.0.06 : Changement de nom pour le view repere Vérification de la date
2014-12-29 Version 1.0.07 - Correction de la lecture de plugv - Ajout de debug - Passage en critique l'erreur lorsque le module se quitte
2014-12-30 Mise à jour du get pour plein de parametre à la fois
2014-12-30 Ajout de la lecture en temps réel des information depuis le CultiPi
2015-01-04 AJout du drag and drop des elements "autres"
2015-01-05 + Correction des nombres à virgule dans la vérification des valeurs + Correction de la gestion des messages des puissances manquantes
2015-01-06 + Correction de l'affichage des logs Cultipi
2015-01-06 correction des droits logrotate
2015-01-06 Redémarrage du serveur cultipi après changement de conf
2015-01-08 Mise en place de l'onglet webcam
2015-01-08 Mise par défaut des fichiers de conf plg prg du paquet cultipi
2015-01-08 SUppression de l'accés au srveur de log pour get
2015-01-08 Ajout de la gestion du problème du DEFCOM sur la prise 1 et le capteur 1
2015-01-08 Changement des images par defaut (en fonction du type de prise et du type de capteur) Remise en place de l'image par défaut de la tente et de la CBx
2015-01-08 Ajout des unités pour les capteurs
2015-01-08 Ajout de l'heure de mise à jour des données
2015-01-08 Ajout du soft permettant de remettre à zéro la conf
2015-01-10 Version 1.0.08 : - Ajout de la commande set : ce script permet de forcer un repère - Changement de l'emplacement des logs sous Windows - Ajout de la possibilité de forcer l'état d'une prise
2015-01-15 + Mise en place du message de vérification de la configuration + Ajout du synoptique dans la page d'accueil
2015-01-15 Ajout des scripts loads/backup/get_version
2015-01-16 Ajout de l'import d'une configuration
2015-01-16 Correction réseau caché et vérification des passwords identiques cultinet
2015-01-16 correction de la sortie du service cultipi
2015-01-16 Vérification des sensors
2015-01-16 Mise en place reset mot de passe cultiraz
2015-01-16 Ajout de deux digits dans l'affichage de l'heure de la dernière mise a jour
2015-01-17 + Ajout de la gestion des mots de passe pour l'interface + nettoyage + correction scripts
2015-01-18 + Correction d'un bug de nettoyage du fichier index + Renforcemnt de la détection des capteurs
2015-01-19 + Correction de la programmation cyclique + Correction de l'iniialisation de variables pour la partie programme
2015-01-21 Ajout d'un bouton fermer pour la console
2015-01-21 + Ajout de l'heure de création de la capture de la webcam
2015-01-21 Mise en place des boucles pour effacer la conf RPi Extinction de la cultibox et des esclaves à l'arret
2015-01-22 Mise en forme de l'admin du cultipi
2015-01-22 Correction import de conf
2015-01-22 + Ajout des infos de régulation secondaire au chargement de la page programme
2015-01-22 Mise à jour de cultiRAZ Ajout de cultiTime Corrections mineurs dans Cultipi
2015-01-23 + Ajout de la durée d'un évènement dans le calendrier
2015-01-23 Ajout des softs cultiraz et cultitime dans l'affichage des versions
2015-01-23 ajout de cultitime dans la gestion des mises à jour
2015-01-23 Mise en place du changement de mot de passe (testé)
2015-01-23 Ajout d'un bouton de redémarrage du module
2015-01-24 + Ajout du temps écoulé et restant d'un évènement par rapport à la date courante dans le calendrier
2015-01-24 nettoyage des repertoires temporaires
2015-01-24 Correction des bugs vus par Yann
2015-01-27 Ajout de l'alarme
2015-01-29 + Suppréssion de la configuration de la couleur des puissances
2015-01-29 + Ajout d'un message à la fin de la synchronisation + Correction de la boite de dialgue + Correction de la synchronisation
2015-01-30 Ajout de cultinet dans cultibox + correction z-index de l'oeil
2015-01-30 Correction du décallage d'une heure sur les programmes
2015-01-30 Ajout des droits apt-get pour cultibox
2015-01-30 -AJout d'une ligne dans le fichier de CONF pour désactiver les LEDs
2015-01-30 - Ajout de la possibilité de désactiver le rétro éclairage (ISSUE 994)
2015-01-31 Version 1.0.10 : - AJout de l'inhibition de la régulation tant que les capteurs n'ont pas été lus
2015-01-31 Ajout du ENABLE_LED dans les fichiers sqls
2015-01-31 Ajout de culticonf
2015-01-31 Ajout des logs cultiraz et cultitime dans cultipi-service.log
2015-01-31 Ajout des logs cultipi-services
2015-01-31 Correction du path pour la librairie
2015-01-31 Ajout des traductions du syno et mise en place de la coquille html/js pour forcer les prises
2015-01-31 export de la conf
2015-01-31 Possibilité de modifier la date de début et fin du calendrier
2015-01-31 Ajout du pilotage des prises (non testé et c'est pas bien)
2015-02-01 Affichage de la section wifi si elle est activée
2015-02-02 Correction du bug de mise à jour de la régulation (ISSUE 1034)
2015-02-02 Correction de deux bugs sur le synotpic.
2015-02-02 On force le redémarrage de Cultipi si on pert la lecture d'un capteur
2015-02-02 Fenetre de chargement des pages
2015-02-02 changement de fonctionnement
2015-02-04 Ajout des commandes de conf d réseau
2015-02-04 Catch des commandes Version 1.0.4
2015-02-05 Suppression des deux die bloquant ISSUE 1047
2015-02-06 Cultitime : V1.0.2 : Correction pour sauvegarder l'heure lors de l'extinction du RPi CultiRAZ : V1.0.5 : On fait clignotter les LEDs lorsque toutes les commandes ont été éffectués
2015-02-08 AJout de la sélection des prises en pilotage direct
2015-02-08 Ajout de l'enregistrement des adressses en pilotage directe
2015-02-08 Suppression du dimmer dans la liste des choix
2015-02-09 Correction de deux erreurs
2015-02-10 Version 1.1.1 : Recherche d'un socket de dispo en dynamique
2015-02-10 - On ajoute les images pour les prises en route ainsi que le changement d'état
2015-02-10 - Ajout de la bonne initialisation des images - On change le texte et l'image lorsqu'on pilote une prise
2015-02-10 V1.1.2 : Les commandes I2C ont le chemin complet
2015-02-10 + Correction du décallage de l'heure de prise de l'image webcam + Correction de la valeur de la seconde tolérance + Masque par défaut à 255.255.255.0 si non définit + Correction de l'affichage de la 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
2015-02-12 + Ajout des clefs hexadécimal pour WEP + Ajout des clefs 64bits WEP + Correction du fichier de configuration WEP
2015-02-12 Correction blockui des logs
2015-02-14 + Ajout de la configuration de la résolution de la webcam + Correction de l'affichage de synoptique et de l'import de configuration + Utilisation du format zip pour l'export/import de configuration C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
2015-02-14 Correction configuration de la date et navigation possible en adHoc
2015-02-15 Mise en commentaire de l'effacement complet de la conf
    Version 1.1.0
2015-02-15 Mise à jour des adresses I2C
2015-02-15 Correction du problème de changement du zoom
2015-02-15 Mise en place du reset reseau de façon clean
2015-02-15 Ajout du revert en cas de non sauvegarde des parametres
2015-02-15 Vérification de la présence du cookie avant de regarder sa valeur (sinon ça me plante)
2015-02-15 on sort la doc du package cultibox pour cultipi
2015-02-15 Ajout de la gestion du Timeout
2015-02-15 AJout d'un deuxième bouton pour piloter les prises
2015-02-15 -Changement du CSS pour faciliter la lecture avec un smartphone -Simplificiation du menu
2015-02-15 Ajout de la tente et de la cultibox par défaut
2015-02-15 AJout d'une traduction pour l'état des prises ISSUE 1111
2015-02-15 V1.1.4 -Correction de l'arret du serveur log
2015-02-15 Correction pour la mise en place du type de module
2015-02-16 -Correction de la vérification pour savoir si le soft est arreté -Correction du stop
2015-02-16 -Agrandissement des boutons de pilotage -Suppresion de la possibilité de supprimer les prises et capteurs -Par défaut, la taille des éléments du synoptique est de 100
2015-02-16 Mise à jour de l'échelle (par défaut à 100)
2015-02-16 Ajout de la valeure lue brute dans les logs Ajout d'une trace dans la régulation quand on est entre les seuils d'hystérésis
2015-02-17 Utilisation de cultionf: gestion du système raspbian
2015-02-17 Utilisation de culticonf: gestion du système raspbian
2015-02-17 + Mise en place du culticonf + Ajout du redémarrage cultiraz et cultitime + Gestion des dépôt dans cultibox
2015-02-18 Mise à jour gestion des service + ajout dpkg-reconfigure
2015-02-21 + Correction de l'affichage des logs + Ajout d'un dépôt dev + Correction de l'export des logs + Correction de la gestion des mises à jours
2015-02-21 accélération de la vérif des mises à jours
2015-02-24 ajout des droits
2015-02-24 modification gestion des conf réseau
2015-02-24 Ajout d'une gestion de conf, mise en place d'un numéro de version pour les images
2015-03-01 Cultitime 1.0.3 : ajout du path complet pour I2C Cultipi 1.2.0 : - Pilotage : Ajout des modules MCP7940N DIMMER XMAX et network - Capteur : Ajout des modules de lecture directe et network
2015-03-06 V1.2.1 - MCP : Réalisation de l'initialisation du module_MCP230XX - Correctif pour philou
2015-03-06 -Ajout du réglage des différents actionneurs suivant : MCP, Direct, Dimmer, XMAX Ajout du premier jet pour la création des XML et de la structure de la configuration
2015-03-07 Ajustement du clignotement de la led + correction de la procédure de reset avec la nouvelle configuration
2015-03-07 correction du reset du réseau avec la nouvelle version
2015-03-07 mise à jour de la configuration de l'image
2015-03-07 mise en place d'un système de reboot si besoin pour les mises à jours
2015-03-08 + Correction du minimum des axes Y sur les logs + Correction d'ne requêtte sur les prises
2015-03-08 reboot tout les 7 jours a 4h du matin
2015-03-09 correction des liens des boutons
2015-03-10 + Remise en forme de l'icône de documentation et des textes de traduction + Centrage du menu
2015-03-11 Plus de stabilité sur le wifi
2015-03-11 Correction compare_conf + ajout de la version de l'image soft
2015-03-14 Ajout des images symboles pour le synoptic
2015-03-14 Suppréssion des stats pour le mode cultipi
2015-03-14 On garde cultipi_network et test de l'affichage de la moyenne
2015-03-14 suppréssion des leases existantes lors d'un RAZ
2015-03-14 suppression des leases
2015-03-15 Pour eviter le message d'erreur de la conf pas à jour en adHoc, on met la conf à jour sur la page cultipi si les fichiers pluga et plugv n'existent pas
2015-03-16 -Ajout de la gestion des cultipis esclaves
2015-03-16 correction valeur moyenne des logs
2015-03-18 Correction d'une adresse de logs temporaire
2015-03-18 Correction de l'affichage dans le synoptique Les prises peuvent avoir de nouvelles valeur (extracteur ...) COrrection d'un bug lors de la sauvegarde de la configuration Déplacement de deux fonctions
2015-03-18 Mise à jour des confs en warning
2015-03-18 Changement du niveau de trace
2015-03-18 Accélération de la lecture des infos Ajout du nom de la prise
2015-03-18 optimisation des images
2015-03-19 Mise à jour du code pour la XMAX
2015-03-19 -Ajout de la copie en une seule fois du dossier
2015-03-20 Ajout de la possibilitée de piloter dans le synoptique un dimmer ou une XMAX
2015-03-20 Correction d'un bug et ajout des images de XMAX
2015-03-20 Ajout de l'image pour le CO²
2015-03-20 Correction d'un bug critique sur la génération de la conf
2015-03-21 optimisation chargement page logs
2015-03-21 optimisation chargement onglet cultipi
2015-03-21 Correction gestion des axes des logs + export fichier conf
2015-03-23 Suppresion de NB_SELECTABLE_PLUG
2015-03-23 Correctif de l'ordre
2015-03-23 Création par défaut de 35 prises
2015-03-23 Ajout de 35 prises
2015-03-24 Changement de niveau de trace
2015-03-24 correction enregistrement des prises
2015-03-24 Mise à jour du model de conf
2015-03-25 Changement d'un niveau de trace
2015-03-25 ajout des fichiers de configuration webcam
2015-03-25 ajout de l'image webcam
2015-03-25 Ajout de la gestion de la conf
2015-03-26 log à la minute par défaut
2015-03-26 affichage des noms des prises dans l'onglet prise et correction du comparatif de la conf
2015-03-26 Reponse en réseau des éléments
2015-03-27 Diverse livraisons de mise en forme
2015-03-27 CHangement de mise en forme pour le XMAX
2015-03-28 Ajout de la fonction setDate pour mettre à jour l'heure du rpi
2015-03-28 Mise à jour de l'heure du RTC Correctif de mise en forme page cultipi
2015-03-28 Ajout de l'information di'initailisation Amélioration XMAX
2015-03-28 correction setDate.tcl + droit i2c www-data
2015-03-28 Ajout de traces
2015-03-28 Ajout d'une info sur l'état de la CUlti
2015-03-28 MAJ a jour des positions
2015-03-28 Correction de la dizaine d'heure
2015-03-29 AJout de cultiCam et de son service redémarrage des esclaves
2015-03-29 Ajout de la gestion du reboot
2015-03-29 Ajout de la conf de la webcam
2015-03-30 Ajout du logo HorticolLED COrrection des couleurs pour le XMAX
2015-03-30 Plein de toute petite modif qui n'impacte absolument pas le fonctionnement du soft.... V1.3.0 - Redémarrage du soft si on n'arrive pas à écrire à l'emetteur - Initialisation des modules que si des pr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
2015-03-30 Ajout de l'heure locale du Cultipi dans la page synoptique
2015-03-30 ajout de plusieurs webcams
2015-03-30 nom de la cam
2015-03-31 Ajout des parametres demandés
2015-04-02 Correction webcam + passage réseau ouvert pour la configuration
2015-04-03 Hellelouia, passage de la révision dans la version cultipi, on enlève l'architecture, on sera toujours en armhf
2015-04-07 Nettoyage des fichiers webcamX.png
2015-04-07 Passage des commandes svn vers git
2015-04-07 Test de commit
2015-04-09 Suppression des anciens pour fichier pour laisser la place au sous module
2015-04-09 Suppression des anciens fichiers
2015-04-11 Modifications des commandes git pour les sous modules + ajout revision YYMMDDHHMM
2015-04-11 Correction generation de la documentation
2015-04-12 Suppression des options de frequence
2015-04-20 Suppréssion des capteurs > 1 lors de la première installation
2015-04-21 Correction rc.local: on ne veut pas de portail captif si on ne branche pas de dongle
2015-04-21 Ajout de tests selenium
2015-04-28 Suppréssion des anciennes confs
2015-05-01 AJout de catch pour l'heure
2015-05-10 Mise à jour des fichiers de configuration
2015-05-12 Ajout de tests
2015-05-13 ajout de test pour visu logs temperature et humidité capteur n°1: jours et mois
2015-05-15 ajout des tests pour les 6 "checks boutons": 3 programmes & 3puissances, de la page logs
2015-05-19 Correction temps d'attente des tests
2015-05-22 Prise de photo uniquement si /dev/videoX existe
2015-06-11 Ajout de motion
2015-06-12 COrrection droits sur motion de Culticam
2015-06-12 Configuration de motion
2015-06-12 Corrections fichiers de conf
2015-06-12 Ajout fichiers thread
2015-06-23 Ajout des routes GW pour eth0
2015-06-23 Correction pour les routes
2015-06-27 Correction de la détection de l'adresse IP de la gateway
2015-06-27 Robustesse de Wlan0
2015-07-03 Correction adresse des tests
2015-07-08 Passage de la sortie des fichiers cron vers le logger
2015-07-08 Ajout del a gestion des aliases
2015-07-09 Ajout d'une boucle de trois essais pour la lecture de culticam
2015-07-09 Ajout d'une boucle pour la suppression du fichier
2015-07-10 Correction des droits pour culticam
2015-07-15 Définite du fichier de conf reverse_ssh.conf
2015-07-15 Aprés reflexion, il est important de garder les différents fichiers de conf pour voir les diff
2015-07-16 Mise à jour des cultipi sur une heure
2015-07-18 Ajout des options --manual et --now pour cron.daily
2015-07-19 MAJ des tables par defaut
2015-07-21 Correction nettoyage de cultibox dans cron.daily
2015-07-21 Mise a jour des alias
2015-07-22 Plus de verbosité pour cultipi
2015-07-22 Module rtc dans la conf
2015-07-23 Changement d'utilisation des dépôts
2015-07-27 Mise à jour du nombre de céimale pour les programmes
2015-07-29 ajout d'une vérification de 5mn d'un autre package manager lancé.
2015-07-31 Mise à jour des alias
2015-08-01 Ajout d'un alias pour avoir les numéros de version Factorisation du code de vérification des mises à jour
2015-08-01 Correction des alias
2015-08-02 Correction des droits sur les alias
2015-10-07 Correction du reémarrage de wlan0 en fonction du driver
2015-10-12 Vrai correction pour le retour de ifconfig
2015-10-13 Ajout des droits sur ntp
2015-10-30 Correction des droits
2015-11-01 Ajout de huc-ctrl et modification de la gestion des modules réseau
2015-11-28 Ajout du mode debug pour les packages cultipi
2016-01-17 Ajout du calendrier 2016
    [calendriers.xls]
